siimsek/PDU/simulation/bootstrap-detail.png

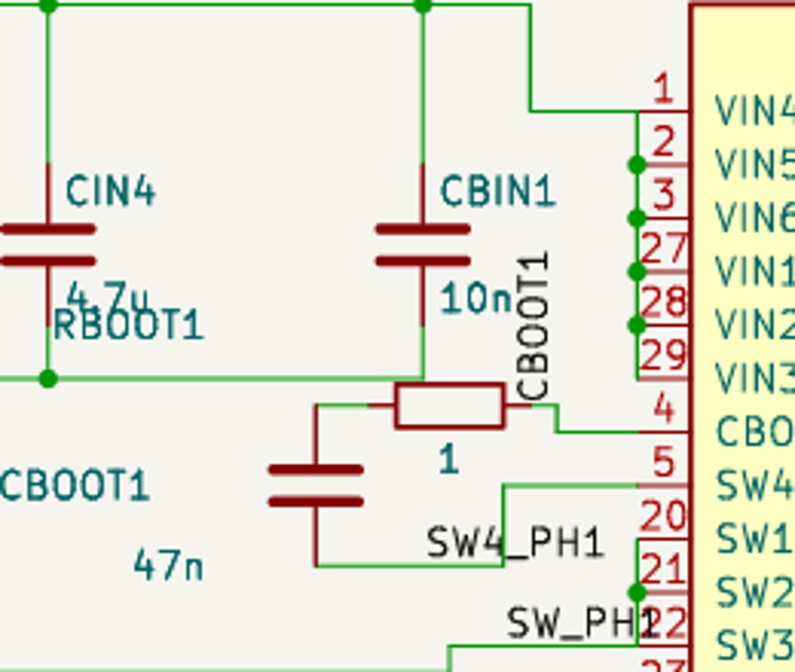
simulation/bootstrap-detail.png
