siimsek/PDU/reports/g2/KICAD-CHANGE-LIST-FINAL.md

# G2 — KiCad'e aktarılacak nihai değişiklik listesi

Bu G2 dalında `*.kicad_*` dosyası **değiştirilmedi**. Liste, mevcut şemaya (`simulation/pdu-current.net` export'u, 73 satırlık `hardware/pdu-current-bom.csv`) göre eklenen/değişen her referansı verir. Makine okunur özet: [`design/pdu_v2_spec.yaml`](../../design/pdu_v2_spec.yaml); BOM: [`design/bom-v2.csv`](../../design/bom-v2.csv). Ağ adları export'taki gibidir; `/VOUT` = ham buck barası (raporlarda VRAW). Yeni ağlar (G3 denetimiyle düzeltilmiş): `/VSAFE`, `/P5V_PROT`, `/OVP_SENSE`, `/OVP_REF`, `/REF_NR`, `/OVP_TRIP_N`, `/OVP_Q`, `/ISO_OV`, `/ISO_EN`, `/ISO_GATE`, `/ISO_VCAP`, `/CLR_N`, `/LDO_DELAY`, `/FB_INJ`, `/FB_TRIM`, `/OVP_BUS_N`, `/OC_SENSE1/2`, `/OC_TRIP1_N/2_N`, `/OC_REF`.

G1 [`KICAD-CHANGE-LIST.md`](../g1/KICAD-CHANGE-LIST.md) satırlarının yerini bu liste alır (G1 satırları geçmiş kaydı olarak orada kalır).

## G4 değişiklikleri (2026-11-07; bu bölüm aşağıdaki tablolarla çelişirse geçerlidir)

| Ref | Değişiklik | Ağlar / footprint | Gerekçe |
|---|---|---|---|
| U3, U4 | **TPS259824LNRGER** (aktif sınırlayıcı) | aynı RGE0024M | [AUDIT2](../g4/AUDIT2.md) §3, TPS25982 p.4/p.50 |
| U1, U2 | BIAS → AGND | pin 6 → /GND | LM70880 p.13 |
| U11, U12 (yeni) | INA296A2QDGKRQ1 | 8 IN+=/ISNS1|2, 1 IN−=/VOUT, 2/3/4/7=/GND, 5 OUT=/OC_SENSE1|2, 6 VS=/P5V_PROT; `Package_SO:VSSOP-8_3x3mm_P0.65mm` | N1 çözümü ([N1-DECISION](../g4/N1-DECISION.md)) |
| U13, U14 (yeni) | TLV3601DCKR | 1 OUT=/OC_TRIP1_N|2_N, 3 IN+=/OC_REF, 4 IN−=/OC_SENSE1|2, 5=/P5V_PROT; SC70-5 | OC eşiği 12.97–13.60 A |
| U15 (yeni) | SN74LVC1G11DBVR | A=/OVP_BUS_N (U7 çıkışı), B=/OC_TRIP1_N, C=/OC_TRIP2_N, Y=/OVP_TRIP_N (U9 PRE); SOT-23-6 | 3 tetik → tek mandal |
| R_OCT / R_OCB (yeni) | 255 Ω / 1.00 kΩ TNPW0603 0.1 % 15 ppm | /OVP_REF → /OC_REF → GND | OC eşik referansı |
| C_INA1/2, C_OCC1/2, C_AND (yeni) | 100 nF C1608X7R1H104K080AA | /P5V_PROT–GND | dekuplaj |
| U7 OUT | ağ adı `/OVP_TRIP_N` → `/OVP_BUS_N` | U15-A | AND girişi |
| RFB2 | 10.2k ERA3AEB1022V → **9.76k TNPW06039K76BXEA** | /FB → /FB_TRIM | B4 trim |
| R_TRIM (yeni) | 442 Ω TNPW0603442RBXEA (kart başı 280–604 Ω) | /FB_TRIM → GND | B4 trim |
| RCOMP | 33.2k CRCW060333K2FKEA | — | B4 |
| COUT17–COUT32 (yeni) | 16× C5750X7S2A226M280KB | /VOUT–GND | B4 |
| D1 | **SMCJ33A-E3/57T** (Vishay doc 88394) | D_SMC | datasheet doğrulandı (VC 53.3 V) |
| J2 | 430450200 → **460150206** Molex Mini-Fit Plus HCS, 2 devre çift sıra dikey, 4,20 mm (G5 D-003; G4'teki 430450400 SUPERSEDED) | 1=/O1_11V; 2=/GND; `Connector_Molex:Molex_Mini-Fit_Jr_5566-02A_2x01_P4.20mm_Vertical` (Molex 460150206_sd.pdf ile pad/delik karşılaştırması T-005b) | Tek kontak/kutup, 18 AWG sistem değeri 10,5 A ≥ ILIM_O1 maks 9,07 A (PS-45750-001 s.8–9); paralel kontak paylaşımı kredilenmez (R-001 bulgu 2) |
| J1, J3 | 430450200 | aynı | Molex sayfası 8.5 A |
| CEFOUT1/2 | 0805 → **1206 C3216X7R1E106K160AB** | `Capacitor_SMD:C_1206_3216Metric` | 25 V'ta %48 kullanım (≤%50) |
| MLCC'ler | TDK MPN'leri (bom-v2.csv) | footprint-map.csv | TDK sayfaları "Production" |
| SW1 | B3U-1000P | `Button_Switch_SMD:SW_SPST_B3U-1000P` | ARATAS sayfası |
| F1 | **şemadan ve PCB'den kaldırılır** (G5 T-004 / D-001): sigorta kart dışında, batarya + kablosunda — Eaton PV-10A10F (10×38 mm, 10 A, 1000 VDC, 50 kA) + CHPV1U DIN-ray yuvası (33 kA DC). G2/G4'teki `/VBAT`–`/ANODE` F1 satırı SUPERSEDED | J1 pin 1: `/VBAT` → **`/ANODE`**; `/VBAT` ağı karttan kalkar | DC kesme değeri doğrulanan tek set; sigorta bataryaya en yakın noktada kabloyu da korur |

U5 (LM74700-Q1) pin haritası düzeltmesi (G5 T-006): 1 VCAP, 2 GND, 3 EN, 4 CATHODE (/VIN), 5 GATE, 6 ANODE (TI Tablo 5-1); G2 spec'teki kayık harita SUPERSEDED, mevcut şema doğru. D1 katot ağı D-007 kararına bağlı.

G5 T-007 spec düzeltmeleri (şema zaten doğru): U2 FB → /GND (FPWM çift faz, LM70880 p.19); RBOOT CBOOT ile **seri** (CBOOT pini → RBOOT → /CBOOT_Rk → CBOOT → /SW4_PHk, p.4); SW4 ayrı ağ /SW4_PHk (p.3). R_INJ ve R_TRIM şemaya eklendi (scripts/sch_edit_b2.py).

G5 T-008: COUT9–COUT32 şemaya eklendi (scripts/sch_edit_b3.py; VOUT/GND etiketleri, sayfa üst ortası 3 × 8 ızgara).

G5 T-010/T-009: B5 (30 parça) ve B4 (12 parça) şemaya eklendi (scripts/sch_edit_b5.py, sch_edit_b4.py; etiket-pin yerleşimi). **Q2 footprint VSONP-8-1EP → `PDU:TI_CSD19531Q5A_Q5A`** (stok VSONP pad numaraları 1/2/3 = S/G/D sembolle uyumsuz; TDSON-8-1 pad 1–4 TI bandı dışında — R-009; özel footprint TI SLPS406B §7.2 p.10'dan, check_footprints PASS).

G5 T-011: B6 — U3/U4 IN ve CEFIN1/2, REN1 → /VSAFE; D_REV1/2 eklendi; RILIM 182/300 Ω; CEFOUT 1206; D2/D3 SMC; J2 46015-0206; PWR_FLAG /VSAFE (scripts/sch_edit_b6.py). Bu noktada şemadaki 142 PCB parçasının tamamı spec ile birebir (check_consistency --schematic B1–B6).

G5 T-012: B7 — D-008 test padleri (36), J_OVP_INJ_BUS, JP_EN_BUCK (in_bom no), notlar ve antet (scripts/sch_edit_b7.py). Şema 180 ref ile spec'e birebir.

G5 T-013: PCB kurulumu (iz/via/döküm yok; kanıt [`reports/g5/PCB-SETUP.md`](../g5/PCB-SETUP.md)): 120 × 85 mm, 4 katman; netlistten 180 ayak izi (parite 0); netclass adları O1_POWER → O1_PORT, S2E_POWER → S2E_PORT ve genişlikler `routing-g2.json` ile aynı; yerleşim grupları, sıcak döngü ve HV boşluğu [`PCB-HANDOFF.md`](PCB-HANDOFF.md) §3–§5'e göre.

Test noktası ekleri: TP_OC_SENSE1, TP_OC_SENSE2, TP_OC_REF, TP_OVP_BUS_N; faz şöntü akım enjeksiyonu için RS1/RS2 Kelvin padleri (BENCH T5g).

## 1. Değişen referanslar (G2)

| Ref | Eski → yeni | Ağ değişikliği | Gerekçe / hesap |
|---|---|---|---|
| U3, U4 | TPS259824ONRGET → **TPS259824LNRGER** (O = circuit breaker → L = aktif akım sınırlayıcı, 16.9 V OVLO; TPS25982 p.4; G3 denetim E1) | **IN: `/VOUT` → `/VSAFE`** | R01; U3/U4 IN 40.709 V FAIL (G1) → SİM F1 VSAFE ≤11.91 V; ILIM tablosu (p.9) L varyantının 'current limit' eşiği |
| U1, U2 (LM70880) pin 6 BIAS | aynı parça | **BIAS: `/VOUT` → AGND (`/GND`)** (G4; G3'teki `/VSAFE` SUPERSEDED) | BIAS abs 32 V (p.5) hata anında `/VOUT` 35.8 V'a çıkar; `/VSAFE` beslemesi p.13 "VIN her koşulda harici BIAS'tan büyük" koşulunu giriş çöküşünde bozar → p.13 "kullanılmıyorsa AGND" |
| CEFIN1, CEFIN2 | 100n aynı | `/VOUT` → `/VSAFE` | eFuse IN dekuplajı ayırıcı sonrası |
| REN1 | 64.9k aynı | üst uç `/VOUT` → `/VSAFE` | R19: ayırıcı açıkken eFuse'lar da kapanır |
| RILIM1 | 301 Ω → **182 Ω** (TNPW0603182RBXEA) | — | TPS25982 p.9 garantili nokta 7.23–9.07 A; [`POWER-STAGE.md` §5](POWER-STAGE.md) |
| RILIM2 | 604 Ω → **300 Ω** (TNPW0603300RBXEA) | — | garantili 4.36–5.66 A; toplam min 11.59 A ≥7.5 A |
| RUV1 | 180k → **174k** (TNPW0603174KBEEA, 0.1 %) | — | 20 V restart: 17.365–19.623 V ([`power-results.json`](power-results.json)) |
| RUV2 | 10.0k → 10.0k TNPW 0.1 % (TNPW060310K0BEEA) | — | tolerans 1 % → 0.1 % |
| RCOMP | 9.53k → **33.2k** (G4; G2'deki 16.9k SUPERSEDED) | — | 32× COUT ile PM min 63.1°, GM 11.5 dB ([`b4-results.json`](../g4/b4-results.json), `loop-results.json`) |
| CCOMP | 4.7n → **10n** | — | aynı |
| CHF | 47p → **22p** (C0G) | — | aynı |
| RFB1 | 130k ERA3AEB134V aynı | üst uç `/VOUT` → `/FB_INJ` | FRA enjeksiyonu için R_INJ düşük empedanslı `/VOUT` tarafında (G3 denetim E12) |
| D2, D3 | SS34 generic SMA → **SS34-E3/57T, SMC** | — | Vishay SS34 SMC paketlidir (doc 88751); **footprint D_SMA → D_SMC** |
| U5 | "LM74700" → **LM74700QDBVRQ1** | — | TI addendum orderable |
| RS1, RS2 | 7.5m → WSL25127L500FEA | — | 0.134 W / 1 W |
| L1, L2 | 6.8 µH → IHLP4040DZER6R8M01 | — | Vishay doc 34509 |
| COUT1–8 | aynı (C5750X7S2A226M280KB) | — | — |

## 2. Eklenen referanslar

| Ref | Değer / MPN | Ağlar (pin) | Gerekçe |
|---|---|---|---|
| COUT9–COUT32 | 24× C5750X7S2A226M280KB (G4: 16 → 32), PDU:TDK_C5750_2220_Recommended | `/VOUT`–`/GND` | Yığılmış tolerans köşeleri (yük adımı düşüşü ≈0.10 V gerekli, [`B2-B6.md`](../g4/B2-B6.md) §B4) + O1 bütçesi |
| RRAWBL | 10k CRCW1206 | `/VOUT`–`/GND` | ham bara boşaltma |
| Q2 | CSD19531Q5A (SON 5×6) | S(1–3)=`/VSAFE`, G(4)=`/ISO_GATE`, D(5–8)=`/VOUT` | ortak bara seri ayırıcı |
| U6 | LM74502HDDFR | 1 EN=`/ISO_EN`, 2 GND, 3 NC, 4 VCAP=`/ISO_VCAP`, 5 VS=`/VOUT`, 6 GATE=`/ISO_GATE`, 7 OV=`/ISO_OV`, 8 SRC=`/VSAFE` | sürücü (tOVP_OFF ≤1 µs koşullu) |
| C_ISO_VCAP, C_ISO_VS | 100n / 100n | VCAP–VS, VS–GND | LM74502H p.3–4 |
| R_GS | 100k | `/ISO_GATE`–`/VSAFE` | R13 |
| R_OVT, R_OVB | 8.25k / 2.32k TNPW1206 0.1 % 15 ppm (TNPW12068K25BXEA / TNPW12062K32BXEA) | `/VOUT`→`/OVP_SENSE`→GND | hassas eşik 11.259–11.537 V |
| U7 | TLV3601DCKR | 1 OUT=`/OVP_TRIP_N`, 2 VEE=GND, 3 IN+=`/OVP_REF`, 4 IN−=`/OVP_SENSE`, 5 VCC=`/P5V_PROT` | karşılaştırıcı |
| U8 | REF5025AQDRQ1 | 2 VIN=`/P5V_PROT`, 4 GND, 5 TRIM/NR=`/REF_NR`, 6 VOUT=`/OVP_REF`; 1/8 DNC, 3/7 NC | referans |
| U9 | SN74LVC1G74DCUR | 1 CLK=GND, 2 D=`/P5V_PROT`, 3 Q̄ NC, 4 GND, 5 Q=`/OVP_Q`, 6 CLR=`/CLR_N`, 7 PRE=`/OVP_TRIP_N`, 8 VCC=`/P5V_PROT` | mandal (set-dominant Q) |
| R_Q | 10k | `/OVP_Q`→`/ISO_OV` | mandal → OV pini |
| R_OV2T, R_OV2B | **60.4k / 19.6k** (CRCW060360K4FKEA / CRCW060319K6FKEA) | `/VOUT`→`/ISO_OV`→GND | kaba OV 11.58–13.74 V (bağımsız yol, hassas trip_max + ≥30 mV) |
| R_EN1, R_EN2 | 15k / 10k | `/P5V_PROT`→`/ISO_EN`→GND | 5 V ray geçerli değilse kapı kapalı (R08) |
| U10 | TPS7A1650QDGNRQ1 | 8 IN=`/VIN`, 5 EN=`/VIN`, 1 OUT=`/P5V_PROT`, 3 PG=`/CLR_N`, 4 GND, 7 DELAY=`/LDO_DELAY` | +5V_PROT (R21: VIN'den) |
| C_LDO_IN / C_LDO_OUT / C_LDO_DELAY (DNP) | 1u / 2.2u / 10n | — | TPS7A16 p.3 |
| C_CMP, C_LAT, C_REF_IN, C_REF_OUT, C_REF_NR (DNP) | 100n, 100n, 1u, 1u, 1u | — | dekuplaj |
| R_CLR, C_CLR | 100k / 1u | `/P5V_PROT`→`/CLR_N`→GND | POR ~120 ms |
| SW1 | reset butonu (MPN AÇIK) | `/CLR_N`–GND | R11 |
| R_BL5 | 1k CRCW1206 | `/P5V_PROT`–GND | R07 |
| R_BLS | 4.7k CRCW1206 | `/VSAFE`–GND | R16 |
| D_REV1, D_REV2 | SS34-E3/57T (SMC) | A=`/O1_11V`/`/S2E_11V`, K=`/VSAFE` | R16 OUT ≤ IN+0.3 V |
| R_INJ | 0 Ω CRCW06030000Z0EA (FRA'da 49.9 Ω) | `/VOUT`–`/FB_INJ` | tezgâh FRA (düşük Z tarafı) |

Silinen referans: **F1** (kart dışına taşındı, BOM'da kablo tarafı satırı F1/XF1). MPN'siz satır yok ([`BOM-OPEN.md`](BOM-OPEN.md)).

## 3. Test noktaları ve enjeksiyon padleri (BOM dışı, footprint)

| TP | Ağ | Kullanım |
|---|---|---|
| TP_VBAT, TP_ANODE, TP_VIN | girişler | UVLO / hot-plug |
| TP_VOUT (VRAW), TP_VSAFE, TP_O1, TP_S2E | baralar | F1/T5 enjeksiyon ölçümü |
| TP_ISO_GATE, TP_ISO_OV, TP_OVP_TRIP_N, TP_OVP_Q, TP_CLR_N, TP_OVP_SENSE, TP_OVP_REF, TP_P5V | koruma zinciri | gecikme ve eşik ölçümü |
| TP_FB_INJ_A (`/VOUT`), TP_FB_INJ_B (`/FB_INJ`) | FRA | R_INJ 49.9 Ω takılı iken |
| TP_COMP, TP_EN_BUCK, TP_SW1, TP_SW2, TP_ISNS1±, TP_ISNS2± (Kelvin) | buck | döngü/akım |
| TP_PG_O1, TP_PG_S2E, TP_IMON_O1, TP_IMON_S2E | eFuse | |
| TP_GND ×4 (prob dönüşü, her grup yanında) | GND | |
| **J_OVP_INJ_BUS** (2 pad + GND) | `/VOUT` | harici akım sınırlı OV enjeksiyon fixture'ı; buck devre dışı (EN_BUCK GND jumper) iken |
| JP_EN_BUCK (2 pin jumper, DNP) | `/EN_BUCK`–GND | enjeksiyon sırasında buck'ı kapatma |
| R_OVT DNP opsiyonu yok — artık risk testi için R_OVT sökülerek kaba yol denenir | | |

DNP/ayar seçenekleri: C_REF_NR, C_LDO_DELAY, JP_EN_BUCK; R_INJ (0 Ω ↔ 49.9 Ω); **R_TRIM** (kart başı 280–604 Ω tablosu); RCOMP 22–47k / CCOMP / CHF tezgâh aralıkları.
