siimsek/PDU/reports/g1/BENCH-ACCEPTANCE.md

> **SUPERSEDED (G3, 2026-11-07) → reports/g2/BENCH-ACCEPTANCE.md.** Bu belge geçmiş kaydıdır; içerik değiştirilmedi.

# Fiziksel test kabul kriterleri (T0–T6)

Bu kriterler ölçümle kapanır; SİM sonucu kabul yerine geçmez. O1 anlık tepe her aşamada ≤12.0 V; kararlı bara ≤11.1605 V şartları gevşetilmez.

| Test | Düzeneği ve ölçüm | Geçme kriteri | Model/hesap beklentisi (ayrı; fiziksel kanıt değildir) |
|---|---|---|---|
| T0 Görsel/soğuk | Mikroskop, DMM, 4-wire düşük-ohm ölçer; J1 girişinde akım sınırlı kaynak kapalı. | Yanlış polarite/short yok; F1, TVS, Q1, L1/L2, COUT, RS ve connector MPN/footprint/polarite kayıtları eşleşir. GND-VIN direnç kısa devre değildir; değer kart şemasıyla tutarlı kaydedilir. | SİM yok. BOM 57 boş MPN ile kart kabul edilemez. |
| T1 Açılış ve statik regülasyon | 0–30 V/≥10 A kaynak; T0 sonrası 20/22.2/26 V; önce 0.75 A sonra gerçek port split ile 7 A. 100 MHz scope, 10× kısa ground spring/diff probe. | 20 V'ta yeniden kalkış; settle sonrası bus 10.78–11.1605 V; O1 peak ≤12.0 V. 7.5 A kapasite testi ayrı, 7.5 A yük iki eFuse nominal limitlerini aşmadan dağıtılabilirse yapılır. | Mevcut behavioral baseline 20 V startup bus≈10.996 V; fiziksel davranış tahmini değildir. |
| T2 7 A sürekli/termal | 7 A toplam yük, 20/26 V giriş, en az 30 dakika veya sıcaklık dengesi; termokupl/IR kamera ve akım probları. | Bus 10.78–11.1605 V; bobin, IC, FET, eFuse, konektör sıcaklığı kendi datasheet limitinin ≥20°C altında; güç kaybı ve sıcaklık kaydı. 7.5 A ayrı kapasite testi yalnızca RILIM guaranteed-min range actual port split'i karşılayıp marj verirse; mevcut nominal ILIM sum 7.4877 A **FAIL**. | HESAP 80/90/95% verim için 20.63/9.17/4.34 W toplam kayıp hassasiyeti; kart termali bilinmiyor. |
| T3 Yük adımı | Elektronik yük iki portta; toplam 0.75→7.00→0.75 A, rise/fall ≤1 A/µs. O1 connector ve baraya eşzamanlı prob. FRA: 10 Hz–200 kHz, injection transformer/resistor. | O1 her an ≤12.0 V; bara transient 10.78–11.22 V içinde, ≤1 ms içinde settle edip 10.78–11.1605 V'a döner; ölçülen faz marjı ≥45°, gain marjı ≥6 dB. | Mevcut 0.45→4.5 A behavioral adım 10.804–10.996 V; 7 A / kompanzasyon köşesi için ölçüm beklentisi yok. |
| T4 O1 OVP fault injection | Kart O1 yükünden ayrık; ayarlı pulse kaynağı/seri güç direnci ve akım probu, dışarıdan 11.4→16.9 V pulse. Önce 1 A sınırlı, sonra 5 A ve en son 10 A fixture limiti; fiziksel kaynak/fixture sınırı doğrulanmadan yükseltme yok. | Uygulanan her pulse'da O1 konektör tepe ≤12.0 V; latch reset davranışı belirlenmiş; güç katı/port zarar görmez; 5 tekrar x3 köşe. Aşılırsa derhal durdur ve FAIL kaydet. | Aday ideal model 11.96 V @10 A/0.5µs varsayımı; gerçek comparator/gate/parazit yok. Mevcut eFuse yalnız 16.9 V nominal olduğundan başarısız beklenti. |
| T5 UVLO/batarya ramp | 0–26 V programlanabilir kaynak, 0.1 V/s ve 1 V/s ramp, 0.75 A yük; batarya simülatörü veya 6S hücre emülatörü. | 20.00 V'a yükselirken her seferde kalkış; kararlı bara aralıkta. Falling cutoff/histerezis yalnız pack üretici cutoff politikası belirlendikten sonra pass/fail olur; test öncesi batarya güvenlik cutoff'u bağımsızdır. Hıçkırık/tekrarlı aç-kapa yok. | 174k/10k hesap üst rising corner19.69 V (EN leakage/TCR hariç). |
| T6 eFuse kısa devre/hot-plug | O1 ve S2E ayrı test; kısa devre MOSFET/röle fixture, akım probu, 100 MHz scope; 10 µF+port kablosu, port hot-plug fixture. | O-variant data-sheet short test koşulunda (>3×ILIM) akım kesme ≤400 ns; normal operating current/short re-try ve latch davranışı ayrıca kaydedilir. Hot-plug bus/O1 ≤11.22 transient, O1 ≤12.0 mutlak; port akımı/tepe/termal hasar yok. | behavioral short model nominal 0.5 µs latch varsayımı ile TI≤400ns değerini kanıtlamaz. dV/dt data-sheet pin akımı 2–6.33 V/ms sensitivity; gerçek çıktı yükü ölçülmeli. |

## Ekipman ve güvenlik kapıları

- Osiloskop ≥100 MHz, ≥1 GS/s, iki eşzamanlı kanal; düşük endüktanslı ground spring veya ≥100 MHz diferansiyel prob; port tepe için prob ucu doğrudan konektörde. Akım probu ≥20 MHz. Ripple için bandwidth limit ayrıca raporlanır.
- Elektronik yük ≥10 A / ≥120 W, edge kontrolü 1 A/µs; iki bağımsız kanal ya da dağıtım fixture'ı. DC kaynağı 0–30 V, ≥10 A, programlanabilir current limit. FRA 10 Hz–200 kHz ve loop injection aksesuarı.
- T4/T6 ilk enerjilemede kaynak limiti ≤1 A, sigortalı fixture ve koruyucu gözlük; test yükü/gerçek bağlı cihaz OVP geçmeden bağlanmaz. Güçlü akım adımı ve short için uzaktan tetik/kapalı kutu kullan.
- Anında durdur: O1 >12.0 V, bara >11.22 V transient zarfı, giriş pininde 80 V'a yaklaşma, Q1 VDS 80 V, herhangi IC/inductor datasheet sıcaklık sınırı, akım >fixture/fuse rating, duman/koku, kontrolsüz osilasyon. Hasarlı/FAIL numuneyi tekrar enerjileme.
- T4 hata akımı artışı ancak batarya/kablo/fuse ve TVS/SOA koordinasyonu ayrıca kabul edilince; 10 A test fixture sınırıdır, donanımın akım garantisi değildir.
