siimsek/PDU/reports/g1/USER-DECISIONS.md

> **SUPERSEDED (G3, 2026-11-07) → reports/g3/USER-DECISIONS.md.** Bu belge geçmiş kaydıdır; içerik değiştirilmedi.

# G1 kapanışı — kullanıcıdan gereken kararlar ve girdiler

G1 yapay zekâ analizi bu dosyayla kapanır. Aşağıdaki girdiler gelmeden O1 OVP, eFuse akım sınırı ve ortak bara ayırıcı kabul edilemez. Geçerli mimari kararı [`OVP-UVLO-DECISION.md`](OVP-UVLO-DECISION.md) dosyasının "G1 kapanış kararı" bölümündedir; şematik değişiklikleri [`KICAD-CHANGE-LIST.md`](KICAD-CHANGE-LIST.md) dosyasındadır.

| # | Karar / girdi | Neden gerekli | Gelmezse ne olur |
|---|---|---|---|
| 1 | **O1 cihazının gerçek mutlak maksimum giriş gerilimi.** T3 Gemstone O1 üretici datasheet'i (PDF): abs-max, önerilen çalışma aralığı, geçici gerilim (süre/enerji) dayanımı, giriş kapasitansı ve kalkış akımı. | 12.0 V sınırı şu an kullanıcı şartıdır; datasheet sınırı bilinmiyor. Eşik penceresi (11.1605–12.0 V) ve ayırıcı hızı bu sayıya göre seçilir. Datasheet repo'da yok; okunamadı, değer **doğrulanamadı**. | 12.0 V varsayımı korunur. Eşik penceresi 0.84 V'ta kalır, eski 11.46 V hedefi 163.2 mV aşılmış durumda kalır. |
| 2 | **12.0 V şartı ölçüm payıyla birlikte kesin bir sınır mı?** Örneğin "osiloskopta okunan tepe + prob/bant genişliği belirsizliği ≤12.0 V" mi, yoksa "okunan tepe ≤12.0 V" mi? Bant genişliği ve prob tipini de belirtin. | Ölçüm belirsizliği düşülürse model tepesi 11.5606 V ile gerçek pay daralır; T-kabul testinin geçme kriteri buna bağlı. | Tezgâh kabulü tutucu yorumla yapılır: okunan tepe + belirsizlik ≤12.0 V. |
| 3 | **O1 hatasında S2E'nin de kapanması kabul edilir mi?** Önerilen ortak bara ayırıcı (a) ortak bara hatasında iki portu birlikte keser. | Kabul edilmezse yedek mimariye geçilir: her eFuse önüne ayrı ayırıcı (kontrol zinciri ×2, FET ×4). | Öneri (a) uygulanır; S2E fail-off davranışı tasarımın parçası olur. |
| 4 | **Arıza sonrası davranış:** latch-off + manuel reset mi, güç çevrimiyle reset mi, otomatik yeniden deneme mi? Reset kim/nasıl verir (buton, MCU pini, konektör)? | Latch/CLR/ARM devresi ve fail-safe güç kaybı davranışı bu karara göre çizilir; şu an AÇIK. | Latch-off + güç çevrimiyle reset varsayılır. Otomatik yeniden deneme yapılmaz. |
| 5 | **Ölçülmüş yük akımları:** O1 ve S2E sürekli/kalkış/tepe akım dalga şekilleri ve aynı anda çalışma profili. | ILIM toplamı 7.4877 A < 7.5 A (12.3 mA FAIL), ortak dal model tepesi 9.91 A, Ceff ekranı (6.48 / 8.56 µF) ve FET SOA bu akımlara bağlı. | RILIM değerleri ve VOUT_PROT Ceff seçilemez; mevcut nominal değerler AÇIK kalır. |
| 6 | **Batarya/kaynak verisi ve batarya kesim politikası:** pack iç direnci veya kısa devre akımı, kablo uzunluğu/kesiti, hücre üreticisinin düşük gerilim kesimi. | F1 (I²t, DC kesme), Q1 SOA ve RUV1=174 kΩ UVLO'nun batarya korumasıyla ilişkisi bunlara bağlı. | F1 "10 A" yer tutucu kalır; UVLO yalnız 20 V yeniden kalkış için kullanılır, batarya koruması sayılmaz. |

Sıra önceliği: 1 ve 2 OVP eşiğini, 3 ve 4 şematik topolojiyi, 5 ve 6 bileşen değerlerini kilitler.
