siimsek/PDU/reports/g4/B2-B6.md

# G4 B2–B6 — eFuse varyantı, BIAS, tolerans köşeleri, açık varsayımlar, tutarlılık

## B2 — eFuse TPS259824L (DOĞRULANDI)

| Konu | Bulgu (TI TPS25982 SLVSEI3D) | Etki |
|---|---|---|
| Varyant | p.4: L = Active Current Limiter, O = Circuit Breaker; "4" = 16.9 V OVLO (p.8: 16.32/16.9/17.31 V yükselen) | Model (aktif sınırlayıcı) L ile tutarlı; O varsayımlı ifadeler SUPERSEDED |
| ILIM | p.9 tablosu varyanttan bağımsız: 182 Ω 7.23–9.07 A, 300 Ω 4.36–5.66 A | Garantili-min toplam **11.59 A ≥7.5 A** değişmedi |
| Davranış | L: ILIM'de sınırlar, termal kapanmaya kadar sürer, sonra mandallanır (RETRY_DLY/NRETRY GND → yeniden deneme yok, p.30/p.32) | Kısa devrede kayıp ≤ (VSAFE−VOUT)·ILIM ≈ 11.9 V × 9.07 A (termal sınırla süre kısıtlı); temizleme EN veya güç döngüsü |
| Ortak ayırıcıyla etkileşim | VSAFE ≤11.37 V (SİM F1) < OVLO 16.32 V → eFuse OVLO hiç devreye girmez; S2E izolasyonu SİM F4: O1 kısa devresinde S2E ≥10.84 V | Uyumlu |
| Paket / MPN | RGE0024M aynı (p.55–57); **TPS259824LNRGER** Active/Production (p.50), 3000'lik makara | KICAD listesi güncel; footprint değişmez |

## B3 — LM70880 BIAS (DÜZELTİLDİ: AGND)

BIAS abs 32 V / önerilen ≤30 V (DATASHEET p.5); harici besleme 10–30 V izinli (p.3) ama **VIN her koşulda harici BIAS'tan büyük olmalı (p.13)**. VSAFE'ten besleme giriş çöküşünde bu koşulu bozabilir; VOUT'tan besleme ise hata anında ham bara 35.8 V'a çıktığı için abs-max'ı aşar. **Seçim: BIAS → AGND** (p.13: kullanılmıyorsa AGND); VCC iç LDO'dan VIN ile beslenir. Ek parça yok. Bedel: IC başına ek kayıp ≈ IVCC·(VIN−VCC) ≈ 10 mA × 17 V = 0.17 W (VARSAYIM; IVCC datasheet'te tablo değeri olarak okunmadı). VSAFE'in kendisi ayırıcı çıkışıdır (Q2 kaynağı); hata anında tepe ≤11.37 V (SİM), ayırıcı açıkken eFuse EN bölücüsü ve R_BLS ile boşalır, ters yol Q2 gövde diyodu (VSAFE→VOUT).

Fail-safe tablosu eki (PROTECTION-DECISION §4): "BIAS = AGND: VSAFE kaybı LM70880 beslemesini etkilemez"; "eFuse L: aktif sınırda termal kapanma → mandallı, EN/güç döngüsüyle temizlenir".

## B4 — Yığılmış statik tolerans + yük adımı (ÇÖZÜLDÜ: 32× COUT + RCOMP 33.2 kΩ + kart başı trim)

Tek tablo: [`b4-results.json`](b4-results.json) (üretici: `analysis/g2/b4.py`).

| Pencere | Statik | Adım min (SİM) | Bırakma maks (SİM) | 10.78 V | 11.22 V bant / trip_min 11.259 | 11.1605 V kararlı |
|---|---|---|---|---|---|---|
| Trimsiz (VFB ±0.75 %, R 0.1 %/25 ppm, IFB) | 10.833–11.160 V | 10.73 V | 11.26 V | **FAIL** | **FAIL** | geçer |
| **Kart başı trim** (DMM 0.05 % + ½ adım 0.125 % + VFB'nin sıcaklık payı (VARSAYIM yarısı) + R TCR) | **10.888–11.105 V** | **10.79 V** | **11.20 V** | geçer | geçer | geçer |
| Nominal (VIN 20/22.2/26, Ceff min/typ/max, gm min/max, L ±20 %) | 10.994 V | 10.89–10.93 V | 11.06–11.09 V | geçer | geçer | geçer |

- Döngü (32× COUT, RCOMP 33.2 kΩ / CCOMP 10 nF / CHF 22 pF): PM min 63.1° (−10° pay → 53.1°), GM 11.5 dB, fc 9.6–39.6 kHz; ngspice AC uyumu <0.001°.
- Trim tasarımı: RFB2 bacağı **9.76 kΩ + R_TRIM** (seri, TNPW 0.1 %); varsayılan 442 Ω → 10.994 V; tablo 280 Ω (+1.5 %) … 604 Ω (−1.5 %), 0.25 % adım, değer hatası ≤0.04 %. Paralel trim reddedildi (aşağı yönde 8–48 MΩ gerekirdi).
- Kabul: 25 °C, yüksüz, 6.5 haneli DMM ile VOUT ölç → tablodan R_TRIM seç → tekrar ölç (BENCH T1b).
- Bu varsayım değişirse: VFB toleransının tamamı sıcaklıktan gelirse trimli pencere 10.846–11.146 V olur → adım min ≈10.75 V (FAIL). Bu durumda daha fazla COUT veya daha yüksek RCOMP gerekir.

## B5 — Açık varsayımlar

| Konu | Sonuç | Durum |
|---|---|---|
| (i) eFuse sabitleri | `EF_UVLO_R_TYP`, `EF_UVLO_F_TYP`, `EF_OVLO_TYP`, `EF_RON_MAX_25C`, `EF_RON_HOT_FACTOR` `params.py`'de (DATASHEET p.4/8/9); sim_runner yalnız `v()` okur | ÇÖZÜLDÜ |
| (ii) EA gm maks | Yayımlanmamış. Tarama (tüm köşeler): PM ≥55° ve GM ≥6 dB **gm 0.5–1.8 mS** aralığında; 2.2 mS'de GM/PM düşer ([b5-results.json](b5-results.json)) | AÇIK → tezgâh FRA (typ 1.2 mS'nin +%50'sine kadar güvenli) |
| (iii) UVLO düşüş | VEN histerezisi yalnız tipik 0.1 V. 0.05–0.15 V taramasıyla düşüş **14.67–18.64 V** (2.44–3.11 V/hücre) | AÇIK → BENCH T2 ölçüm. 18 V (3.0 V/hücre) hücre kesimi bu UVLO ile garanti edilemez: batarya koruması BMS'te kalmalı (USER-DECISIONS) |
| (iv) R02 | OC tetiğiyle O1 ≤11.41 V HESAP (16 A üstü L tabanı %5'e kadar), SİM ≤11.37 V; koşul: INA296 gecikmesi tipik (4× tipikte 11.56 V) | **Sağlandı (tezgâh doğrulaması gerekli)** |
| (iv) R08 | 2.1 V POR yalnız tipik; EN kapama 2.57–3.16 V > 1.65 V mandal minimumu (garanti kısmı yeterli) | Sağlandı (POR kredi edilmeden) |
| (iv) R14 | LM74502H 4.7 nF test yükü eşdeğerliği (oran 0.97) değişmedi | Koşullu → BENCH T5b |
| (iv) R18 | Konnektör: Molex sayfaları (Active, 8.5 A/kontak); J2 4 devreli (2 kontak/kutup), J1/J3 2 devreli; 18 AWG terminal 430300038 | **Sağlandı** |

## B6 — Tutarlılık

G3'teki "Family 2 kapandı / Family 4 nominal köşede kapandı" ifadeleri G4 sonuçlarıyla yeniden yazıldı: Family 2 (üst anahtar kısası) **gerilim + faz aşırı akım tetiğiyle** kapandı (SİM F1/F5, HESAP N1); Family 4 (yük adımı) **nominal ve trimli köşelerde** kapandı, trimsiz yığılmış köşeler görünür FAIL olarak kalır. PCB-READY-v2 ve START-HERE bu ifadeleri kullanır.
