siimsek/PDU/docs/POWER-PCB-ENGINEERING-STANDARD.md

<!-- Bu başlık T-026 ile eklendi. Aşağıdaki "KAYNAK METİN" işaretinden sonrası kaynakla bayt bayt aynıdır. -->
# Güç PCB'si Mühendislik Standardı — kalıcı kopya

- **Kaynak:** [`decisions/R-020-engineering-standard-source.md`](../decisions/R-020-engineering-standard-source.md), SHA-256 `5c03f55e43b985e87191ea46efc52dc3321ad9b196f42ecd7bb8056901c9fcfe`, 32155 bayt.
- **Geçerli sürüm:** Standart 1.0 (2026-11-08). Değişiklik yalnız yeni kaynak, D-kararı ve ayrı kartla yapılır; bu kopya elle düzeltilmez.
- **Zorunluluk:** Bu andan sonraki bütün şematik ve PCB aşamaları bu standarda uyar. Kaynak metnin "İlk uygulama" ve §5 bölümleri R-020 anına ait anlık görüntüdür; açılışta repo durumuyla doğrulanır.
- **Çelişki kuralı:** Standart ile mevcut sert kriterler ayrışırsa **daha kısıtlayıcı olan** uygulanır; eşik gevşetilmez, fark D-kararına taşınır.

## T-026 çelişki taraması

| Konu | Standart | Repo | Karar |
|---|---|---|---|
| İnceleme kararının adı | `ONAY / KOŞULLU / RET` (§5, "RED kullanılıyorsa şablon esas") | `RED` (`reviews/TEMPLATE.md`, `docs/WORKFLOW.md`) | `RED` kullanılır; standardın kendi kuralı |
| Sinyal/gate sınıf adları | `ANALOG` 0,25, `GATE` ≥0,4 (§1) | Netclass adları `CONTROL_SENSE` 0,25 ve `AUX_LOCAL` 0,5; `PCB-HANDOFF` §2 `GATE` 0,4 | Çelişki yok, ad farkı; ölçü olarak daha kısıtlayıcı olan geçerli, netclass değişmez |
| Sert elektrik sınırları (E-01…E-06) | O1 ≤12,0 V; bara ≤11,1605 V; bara min ≥10,78 V; U3/U4 IN <30 V; HV 0,6 mm; gate ≤10 mm; Kelvin ≤15 mm | `CLAUDE.md`, `AGENTS.md`, `PDU.kicad_dru`, `tasks/T-023.md` ile aynı | Çelişki yok |
| Dış katman min/seçili genişlik (§1 tablo) | 2,94/3,3; 4,92/5,5; 2,35/2,6; 4,76/5,3; 2,97/3,3 | `reports/g2/routing-g2.json`, `PDU.kicad_dru` | Çelişki yok; standart yine de işe başlarken yeniden okumayı ister |
| Ara adımda açık uçlar (§4 G5) | Ara kartlarda izinli, nihai kartta 0 | `T-022` ve `T-023` devir listeleri, `T-024` kabulü | Çelişki yok |
| `via_dangling` uyarıları (§4) | UUID/net/koordinat/gerekçe ile tek tek | T-022 raporu tür ve sayı verir; UUID düzeyi yok | **Eksik:** T-023 kapanışı ve T-024'te tamamlanır, kural gevşetilmez |

---- KAYNAK METİN ----

# PDU — AI Destekli Şematik, Güç PCB'si ve Doğrulama Mühendisliği Standardı

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

## 0. ÇALIŞTIRMA SÖZLEŞMESİ — HER İKİ AJAN İÇİN ZORUNLU

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

## 1. MİMARİ VE DEĞİŞMEZ PROJE KISITLARI

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

### Sert elektriksel sınırlar

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

### Mevcut PCB tasarım kuralları — iş başında yeniden oku

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

## 2. ŞEMATİK: TÜM PARÇALARA UYGULANACAK TAM KAPSAMLI DENETİM

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

### 2.1 Eksiksizlik ve izlenebilirlik

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

### 2.2 Her parça için elektriksel kontroller

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

### 2.3 Topolojiye özgü ayrıntılı şematik kontrol listesi

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

### 2.4 Şematik onay kapısı (ayrı T-kartı)

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

## 3. PCB YERLEŞİM / YÖNLENDİRME KURALLARI — ELEKTRİKSEL RİSK ÖNCELİKLİ

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

### Mesafe kuralı: 'yakın' ne demek?

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

## 4. BÜTÜNSEL TEST / GEÇİŞ KAPILARI

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

### Bağımsız test disiplini

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

## 5. İLK ÇALIŞMA: R-020 / PR #70 (CLAUDE'DAN GELEN GÖREVİ KORU)

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

**T-023 adım 2 için ayrı ayrı karar ver:**

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

## 6. TESLİMAT VE OTOMATİK DEVİR ŞARTLARI

### Codex THINKER çıktısı

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

### Claude Code BUILDER çıktısı

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

## 7. BİRİNCİL TEKNİK KAYNAKLAR (BAĞLANTI + UYGULAMA)

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

## 8. BAŞARI ÖLÇÜTÜ VE SON RAPOR ŞABLONU

**Kesin başarı iddiası yalnız kanıtla:**

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
