siimsek/PDU/reviews/R-020.md

# R-020 — T-023 adım 2 bağımsız inceleme

- **Karar:** RED
- **Engelleyici:** 2
- **İncelenen:** PR #70, wp/T-023, cf9e820901847afe110998f4580340d1bfcf2113
- **Adım 3:** Engelleyiciler giderilip yeniden doğrulanana kadar başlamamalı.
- **Tur:** 1 / 2

## Başlangıç kanıtı

Ayrı ana klonda `git rev-parse HEAD`:
```
684357ccef4903c9726261f85f860102939c8d6f
```

`gh pr view 70 --json number,state,isDraft,baseRefName,baseRefOid,headRefName,headRefOid,url`:
```json
{"baseRefName":"main","baseRefOid":"684357ccef4903c9726261f85f860102939c8d6f","headRefName":"wp/T-023","headRefOid":"cf9e820901847afe110998f4580340d1bfcf2113","isDraft":true,"number":70,"state":"OPEN","url":"https://github.com/siimsek/PDU/pull/70"}
```
PR kartı ayrı çalışma ağacında bu başta incelendi. Ana depo ve GUI ile kayıt kullanılmadı.

## Bağımsız komutlar ve olgular

- `kicad-cli version`: `10.0.7`.
- PR kartında `kicad-cli pcb drc --format json --severity-all --refill-zones --schematic-parity`: çıkış 0; JSON'da 0 hata, 6 `via_dangling` uyarısı, 116 `unconnected_items`, 0 şematik parite ihlali. Çıkış 0, bağlantıların tamamlandığı anlamına gelmez.
- `python scripts/pcb_rules.py --check`: çıkış 0, `{"pass":true,"errors":[]}`.
- Altı uyarının koordinatları ve ağı, bağımsız DRC JSON'undan: /VOUT (119,0; 56,7), (107,0; 95,0); /O1_11V (136,645; 90,095), (138,045; 91,695), (142,0; 65,4); /VSAFE (126,0; 76,7) mm. Her birinin üretim etkisi ayrı ayrı doğrulanmadı.
- pcbnew ile kart yüklenip bölgeler doldurulduktan sonra bağlantı sorgusu: RS1.1–U11.8, RS1.2–U11.1, RS2.1–U12.8 ve RS2.2–U12.1 aynı ağda bağlı. Bu sorgu tek başına Kelvin dalının güç akımından yalıtılmış olduğunu kanıtlamaz; /VOUT bağlantı kümesinde başka güç padleri de vardır.
- `tasks/T-023.md:33` Kelvin çiftleri için paralellik ve en çok 15 mm ister; `reports/g2/PCB-HANDOFF.md:37` Q2, U6 ve R_GS'nin bitişik yerleşimini ister. Kriterler gevşetilmedi.

### HESAP — uzunluk ve geometri yöntemi

Karttaki `T023_KELVIN_0..3` bakır bölge çokgenleri ile `scripts/pcb_route_signals.py:343-350` ve `scripts/pcb_route_power.py:46-70` tarifinden yeniden kurulan şerit köşeleri karşılaştırıldı: en büyük köşe farkı 0,000001 mm. Merkez çizgisi, kart üzerindeki bu şeritlerin kontrol noktaları ve katman geçişine giden kısa koldan bağımsız toplandı. Sonuçlar sırasıyla RS1 IN+ F.Cu **4,113**, RS1 IN− B.Cu/F.Cu **13,384**, RS2 IN+ F.Cu **12,357**, RS2 IN− B.Cu/F.Cu **14,147 mm**. Nominal yol tanımında her biri 15 mm altında; en dar pay 0,853 mm. Via fıçısı ve pad içi uç noktaları dahil tekil fiziksel akım yolu, dolgu bölgesi ve /VOUT güç bakırı nedeniyle bu merkez çizgilerinden kesin olarak çıkarılamaz. Gerçek akım dağılımı ve bağımsız Kelvin dallanması **doğrulanamadı**. Bu nedenle bu sayılar tek başına nihai gerçek elektriksel yol uzunluğu kabulü değildir.

Kontrol çizgilerinin XY izdüşümleri faz 1 için (31,798; 64,966), faz 2 için (41,000; 23,700) mm'de kesişir; farklı katmanlarda olmaları elektriksel kısa devre demek değildir. Çizgilerin azami karşılıklı uzaklık ölçüsü sırasıyla 5,630 ve 5,287 mm'dir. Paralel eşleşme kanıtlanmamış, incelenen güzergâhlarda açıkça sağlanmamıştır. Kaynak: kart çokgenleri ve yukarıdaki kontrol noktaları; hesap: doğru parçalarının kesişimi ve Hausdorff uzaklığı.

Q2 gate pad merkezi (95,900; 51,4525), R_GS.1 (91,200; 36,645) mm: merkez arası 15,536 mm, pad sınırlayıcı kutuları arası 14,511 mm. Q2 source pad merkezi (92,090; 51,4525), R_GS.2 (92,850; 36,645): merkez arası 14,827 mm, kutu aralığı 13,958 mm. Bunlar pcbnew pad koordinatı ve kutularından Öklid hesabıdır; kutu aralığı pad geometrisine bağlı kesin kenar mesafesi değildir. `pcb_route_signals.py` içindeki gate bağlantı noktasından R_GS tarafına kontrol noktaları toplamı 16,015 mm'dir; bu, Q2 padinden başlayan eksiksiz rota uzunluğu değildir.

## Engelleyici bulgular

| No | Kanıt ve etki | Gerekli düzeltme |
|---|---|---|
| 1 | Kartta doğrulanan Kelvin şeritlerinin izdüşümleri kesişiyor ve paralel değil; T-023 paralellik kriteri sağlanmıyor. Doldurulmuş güç bakırı ve merkez çizgisi farkı yüzünden bağımsız Kelvin alma noktası ve gerçek rota uzunluğu da kesin kanıtlanmadı. | Her iki çift için şöntün doğru padinden ayrı alınan, mümkün olduğunca eşlenmiş paralel rota tasarla; karttan pad, segment, via ve bölge bazında uzunluk ve bağlantıyı kanıtla, her yolu ≤15 mm tut. Yerleşim değişikliği gerekiyorsa ölçüp açıkla; mevcut boşluk ve DRC kurallarını koru. |
| 2 | R_GS ile Q2 gate pad merkezleri 15,536 mm, pad kutuları arası 14,511 mm; 16,015 mm'lik dal da kartın bitişik yerleşim beklentisini karşılamıyor. | R_GS'yi Q2 gate/source yakınına taşı ve iki ucunu yeniden yönlendir; U6–Q2 gate ≤10 mm ve mevcut HV açıklığını yeniden doğrula. |

## Altı ayrı karar

1. **IN+ F.Cu / IN− B.Cu:** RED. Nominal dört çizgi uzunluğu sınır içinde olsa da paralellik ve gerçek ayrı Kelvin yolu kanıtı yeterli değil. Farklı katman kullanımı tek başına yasak sayılmadı; sorun kanıtlanan geometri ve kriterdir.
2. **R_GS:** RED. Yukarıdaki ölçüm bitişik yerleşimi desteklemiyor. BUILDER'ın `reports/g5/T-023/step2-report.md` içindeki yaklaşık 11 mm ifadesinin ölçüm uçları belirtilmediğinden bizim farklı uçlarla yaptığımız ölçümle eşdeğerliği doğrulanamadı.
3. **TP_ISO_GATE:** KOŞULLU. Karttaki merkez (97,4; 44,6) mm; gate dalındaki (96,2; 44,6) noktasına merkezler arası 1,2 mm. DRC hatası yok. F.Cu diğer ağ pad kutularına en yakın iki mesafe 1,506 ve 1,525 mm; bu tüm bakır ve prob erişimi kontrolü değildir. R_GS düzeltmesinden sonra prob, komşu bakır ve gate yüklemesi yeniden doğrulanmalı.
4. **Dört TP_ISNS:** Yeniden yerleştirilmeli; kartta mevcut merkezler TP_ISNS1P (3,8133; 14,2261), 1N (19,4333; 18,1686), 2P (17,9613; 14,2261), 2N (10,8873; 14,2261) mm. İlgili INA giriş padlerine doğrusal merkez mesafeleri sırasıyla 55,502, 45,306, 26,747 ve 29,386 mm. Bunlar rota uzunluğu değildir ve uzun test kolu tasarımı için gerekçe oluşturmaz. Başlangıç arama noktaları, sırasıyla (31,6; 65,4), (25,1; 64,0), (40,0; 20,5), (39,5; 26,2) mm: yalnız pad kutusu taraması yapıldı; iz, dolgu, avlu ve prob erişimi **doğrulanmadı**. Bunlar onaylanmış yerleşim değildir; Kelvin yeniden tasarımından sonra kısa dallar ve DRC ile test edilmeli.
5. **U12.7–U14.2 ortak GND via:** KOŞULLU. pcbnew bağlantı sorgusu iki padin bağlı olduğunu gösteriyor; `step2-gnd-applied.json` ortak via merkezini (43,77; 24,2) mm olarak veriyor. Ayrı önerilen (41,22; 24,13) via için mevcut 0,8 mm B.Cu /VOUT şeridi ile hesaplanan izdüşüm bindirmesi 0,240 mm; bu yalnız o alternatifin sığmadığını gösterir. INA referans ve karşılaştırıcı dönüşünde ortak empedans etkisi doğrulanmadı; son dönüş yolu incelenmeli.
6. **Adım 3 ve B.Cu koridoru:** HAYIR. İki engelleyici kapanana kadar geçilmemeli. 116 açık çift ara aşamada kayıtlıdır, bitmiş bağlantı kabulü değildir. Tüm B.Cu sinyal koridoru ve dönüş düzlemi sürekliliği ölçülmedi; adım 3 öncesi yerel güzergâh ve DRC ile kanıtlanmalı.

## Karşılaştırma ve açıklar

Bağımsız merkez çizgisi değerleri `reports/g5/T-023/step2-report.md` değerleriyle üç ondalıkta aynıdır; bu karşılaştırma akım yolu yalıtımını kanıtlamaz. Bağımsız DRC açık çift sayısı 116 ile PR raporuyla aynı; ağ bazında artış görülmemesi her açık çiftin kimliğinin değişmediği anlamına gelmez. Ölçülemeyen prob erişimi, gerçek akım dağılımı ve ortak GND dinamik etkisi AÇIK'tır. İkinci turda engelleyici kalırsa BLOCKED-ON-USER önerilir.

## Kalıcı standart

Kullanıcı kaynağı eksiksiz olarak `decisions/R-020-engineering-standard-source.md` altında taşınmıştır: 32155 bayt, SHA-256 `5c03f55e43b985e87191ea46efc52dc3321ad9b196f42ecd7bb8056901c9fcfe`. T-026, yetkili BUILDER tarafından kalıcı belge ve ajan bağlantılarını oluşturma görevidir; bu PR'ın açılması standardın o belgelere **entegre edildiği** anlamına gelmez. T-027–T-031 kapsam ve kapanış işlerini böler; T-024'ün mevcut analizi yeniden oluşturulmaz.
## İş akışı denetimi

Bu dalda `python scripts/check_workflow.py` çıkış 1: yalnız R-020 ve T-026–T-031 kartlarının queue.md'de bulunmamasına ilişkin 7 hata, 0 uyarı. Kullanıcı talimatı uyarınca queue.md değiştirilmedi; BUILDER bütünleştirme sırasında kuyruk eşitlemesini yapmalıdır.

`git diff --cached --check` kaynak standart kopyasındaki Markdown satır sonu boşluklarını bildirir; bunlar kaynak baytlarını değiştirmemek için korunmuştur. Diğer eklenen dosyalarda bu kontrol temizdir.

# R-020 — Tur 2 (son tur)

- **T-023 adım 2 kararı: RED; 1 engelleyici. Adım 3: HAYIR.**
- **T-026 / PR #73 kararı: KOŞULLU; birleştirmeden önce aşağıdaki denetim açığı kapatılmalı.**

## Açılış: komut çıktısı

Ayrı inceleme klonunda `git rev-parse HEAD`: `f395756ffc65580fefa55feba0691d51cac8ff2c` (R-020 ilk turu; ana dal değil). `git status -sb`: `## wp/R-020`, temiz. `gh pr view 70 --json number,state,isDraft,baseRefName,baseRefOid,headRefName,headRefOid,url`:

```json
{"baseRefName":"main","baseRefOid":"684357ccef4903c9726261f85f860102939c8d6f","headRefName":"wp/T-023","headRefOid":"50d7902acce78fb01c8664bdcbf9bf6843e51a96","isDraft":true,"number":70,"state":"OPEN","url":"https://github.com/siimsek/PDU/pull/70"}
```

`gh pr view 73 --json number,state,isDraft,baseRefName,baseRefOid,headRefName,headRefOid,url`:

```json
{"baseRefName":"main","baseRefOid":"684357ccef4903c9726261f85f860102939c8d6f","headRefName":"wp/T-026","headRefOid":"db57f4a1c472f1828a095c8b8f774641dc0fd843","isDraft":true,"number":73,"state":"OPEN","url":"https://github.com/siimsek/PDU/pull/73"}
```

`gh pr view 72 --json number,state,isDraft,headRefName,headRefOid,url`: `{"headRefName":"wp/R-020","headRefOid":"f395756ffc65580fefa55feba0691d51cac8ff2c","isDraft":true,"number":72,"state":"OPEN","url":"https://github.com/siimsek/PDU/pull/72"}`. İki girdi ayrı, sabit commit çalışma ağaçlarında incelendi; ana çalışma dizinine ve GUI'ye yazılmadı.

## Bağımsız olgular ve hesaplar

**OLGU — DRC.** `kicad-cli version` → 10.0.7. PR #70 kartında `kicad-cli pcb drc --format json --severity-all --refill-zones --schematic-parity --output <geçici-json> PDU.kicad_pcb` → çıkış 0; JSON: 0 hata, 6 `warning:via_dangling`, 112 açık çift, 0 parite. Aynı komut refill olmadan: 0 hata, 6 uyarı, 112 çift, 0 parite; sayısal fark 0. `python scripts/pcb_rules.py --check` → `{"pass":true,"errors":[]}`, çıkış 0. Sayı eşitliği açık çiftlerin kimliklerinin aynı olduğunu kanıtlamaz.

**OLGU — uyarılar.** DRC JSON F.Cu–B.Cu via: /VOUT `063c76ab-7b3b-4463-8fa1-fdf9fad55afe` (119; 56,7), `3652879d-2df1-4246-8f94-e35bf7f93fd3` (107; 95); /O1_11V `4649bd0a-712d-4a83-83e9-91a58ef8afc6` (136,645; 90,095), `8c056235-4049-4644-ab35-a513c2cefb5f` (138,045; 91,695), `f58fd724-b9db-46fc-a630-ec90256bd953` (142; 65,4); /VSAFE `728e9596-fa0e-466c-8b92-8118029a2455` (126; 76,7) mm. Bunlar DRC'nin kart koordinatlarıdır; her uyarının tüm katmanlarda bağlı bakırı ve elektriksel/üretim etkisi bağımsız doğrulanmadı. Bu altı UUID Tur 1'deki uyarılarla aynıdır; nihai T-024 disposition hâlâ gerekli.

**OLGU — bağlantılar.** KiCad pcbnew 10.0.7 ile kart yüklendi, zone fill ve `BuildConnectivity()` çalıştırıldı; RS1.1–U11.8, RS1.2–U11.1, RS2.1–U12.8, RS2.2–U12.1 bağlantı sorguları True. Dört TP_ISNS kendi şönt ağına; TP_ISO_GATE Q2.4'e; R_GS.1 Q2.4'e, R_GS.2 U6.8'e ve U6.8 Q2 source'a bağlı. Aynı ağda bağlı olmak tek başına Kelvin tapinin güç akımından bağımsızlığını veya dinamik dönüş akımını ispatlamaz.

**HESAP — dört kol.** `PDU.kicad_pcb` içindeki `T023_KELVIN_*` F.Cu/B.Cu bölge poligonları, padler, via ve neck geometrisi; `scripts/pcb_route_signals.py:350-358` waypoint'leriyle karşılaştırıldı. PCB koordinatları ile D-006 koordinatlarının dönüşümü x_D = x_PCB − 30, y_D = 115 − y_PCB mm; aşağıdaki yol hesabı D-006 kullanır. Komşu merkez noktaları arasındaki Öklid uzunlukları toplamı:

| Kol | Katman / yol | Hesaplanan çizgi (mm) |
|---|---|---:|
| RS1.1–U11.8 | F.Cu | 4,016191 |
| RS1.2–U11.1 | F.Cu + B.Cu + F.Cu neck; iki via | 14,006422 |
| RS2.1–U12.8 | F.Cu | 10,017290 |
| RS2.2–U12.1 | F.Cu | 10,522264 |

Her çizgi `tasks/T-023.md:33` 15 mm sınırının altında. Yol tanımı via fıçısı ve pad içindeki akım yolunu içermez; bunlar track yerine kısmen dolgu şeritleridir. Tam akım dağılımı, şönt padinde gerçek akımın sense alma noktasına etkisi ve özgün bir fiziksel elektriksel uzunluk **doğrulanamadı**. Bu sınır nominal çizgi ölçümünü geçersiz kılmaz ama akım çözümü diye sunulamaz.

**HESAP — paralellik.** Faz 1'de yakın eşlenmiş ana parça uzunlukları 1,985 ve 2,126 mm, toplam kol uzunlukları farkı 9,990 mm. B.Cu'daki 6,4 mm parça ve uzun F.Cu yaklaşımı boyunca IN+ eşlenik bir kol değildir. Faz 2'de U12 kart yönü 180°; (44,0; 18,4)→(38,8; 22,4) ile (48,8; 18,4)→(43,6; 22,4) ana parçaları aynı vektör (−5,2; 4,0), uzunlukları 6,560488 mm; doğrular arası dik uzaklık |4,8 × 4,0| / 6,560488 = **2,927 mm**. Ana bölümler paralel, fakat padlere yaklaşımın bütünü eşlenik değildir; ortak mod toplama ve L2 referans bütünlüğü bu geometriyle nicel doğrulanmadı.

**HESAP — gate ve TP.** Q2.4 (95,9; 51,4525) ve R_GS.1 (96,675; 49,3) D-006 mm: merkez uzaklığı 2,288 mm. Q2.4'ten F.Cu üzerinden R_GS.1'e kontrol çizgisi 2,9275 mm; U6.6–Q2.4 F.Cu parçalarının toplamı 5,469 mm. R_GS.2 (98,325; 49,3) via ile B.Cu /VSAFE barasına ve Q2 source vialarına bağlanıyor; aynı ağ bağlantısı kanıtlandı, dönüşün RF akım dağılımı veya endüktansı kanıtlanmadı. Kaynak: pcbnew pad, `PCB_TRACK`/via ve zone sorgusu; F.Cu gate parçaları (93,7325;47,49)–(94,2;47,49)–(94,8;47,49)–(95,9;48,65)–(95,9;51,4525).

D-006 test pad merkezleri karttan: TP_ISNS1P (29,4;65,6), 1N (24,7;65,1), 2P (38,8;20,0), 2N (45,6;19,6), TP_ISO_GATE (97,4;44,6) mm. Test bağlantıları PCB zone poligonları ve pcbnew bağlantı sorgusuyla görüldü. ISO_GATE reference nesnesi F.Silkscreen katmanında `IsVisible=False`; diğer dört TP refdes görünür. Gate test dalı kontrol çizgisi (94,8;47,49)–(96,2;46,5)–(96,2;44,6)–(97,4;44,6), toplam 4,815 mm; son 1,2 mm toplam dal uzunluğu değildir. Fiziksel prob yaklaşımı, gate probunun kapasitansı/yüklenmesi ve test noktalarının gerçek montaj görünürlüğü AÇIK.

## Kararlar ve engelleyici

| No | Bulgular / karar | Gerekli işlem |
|---|---|---|
| 1 | **Faz 1 RED.** `tasks/T-023.md:33` ve standart §3, §4 iki kolun paralelliğini ister; yalnız yaklaşık 2 mm yakın parça, 14,006 mm IN− yolunun kalanını eşlemez. Eşitlik tek başına kriter değildir; burada sorun eşlenmemiş uzun güzergahtır. | Önce RS1/U11 konumu sabitken alternatif çift, katman ve waypoint için gerçek açıklık, referans ve iki rota uzunluğu ile aday üretip DRC çalıştır. Kanıtlı çözüm yoksa RS1/U11 yerleşimini ve etkilenen T-022 güç yolunu birlikte yeniden tasarla, eski güç kriterlerini ve ≤15 mm sınırını koru. Ölçülmemiş alternatifin sığdığını veya yer değişikliğinin matematiksel zorunluluk olduğunu iddia etmiyorum. |

**Faz 2:** KOŞULLU. U12 dönüşü ve ana hatların 2,927 mm paralel aralığı geometrik olarak doğrulandı; bu sayıyı otomatik EMI/SI garantisi sayma. Ayrı Kelvin alma ve L2 referansının nihai rotada korunması, fiziksel prob ve SI açıkları T-023/T-024 kapsamında kapanmalı.

**R_GS:** İlk tur engelleyicisi kapandı. Q2 gate yakınlığı ve kısa F.Cu dal ölçüldü; source tarafı B.Cu /VSAFE üzerinden bağlı. B.Cu güç barası üzerinden ortak empedans ve hızlı gate discharge davranışı hesap/ölçümle doğrulanmadığından nihai elektriksel performans AÇIK; mevcut verilerle ikinci bir geometrik engelleyici ilan edilmiyor.

**TP'ler:** Yeni ISNS konumları ve ağ bağlantıları ara aşama için KOŞULLU; revize Kelvin güzergâhında kısa kollar ve açıklık tekrar kontrol edilmeli. ISO_GATE'in gizli silk etiketi için montaj/test dokümanında erişilebilir ve tekil eşleme doğrulanmalı; henüz kanıt yok. Prob erişimi ve kapasitif yük tezgâhta/uygun modelle doğrulanmalı.

**Adım 3:** HAYIR. Faz 1 engelleyicisi kapanmadan FB/COMP/OVP/OC yönlendirmesine geçme. B.Cu koridorunun tamamı ve kritik dönüşlerin sürekliliği bağımsız ölçülmedi; bir sonraki adayda DRC, 0 yeni açık, parite ve L2 referansını yeniden değerlendir. 112 açık çift ara aşama sayısıdır, final kabulü değildir. İkinci tur sonunda engelleyici kaldığından iş akışı gereği **BLOCKED-ON-USER maddesi önerilir**; kullanıcıya teknik karar sorulmaz, yukarıdaki ölçülü teknik yol önerilir.

### BUILDER karşılaştırması — bağımsız hesaptan sonra

`reports/g5/T-023/step2-report.md` ve `step2-audit.json` çizgi değerleri 4,016 / 14,006 / 10,017 / 10,522 mm; bağımsız değerlerle üç ondalıkta aynı (fark her biri %0,005'ten küçük, yuvarlama). 112/6/0 parite sayıları bağımsız DRC ile aynı. Faz 2 2,927 mm aynı; faz 1'in kısmen paralel oluşu raporda da açık. R_GS pad merkez değeri 2,288 mm aynı. Bu karşılaştırma fiziksel SI/akım çözümü veya test probu erişimi kanıtı değildir.

## PR #73 — kalıcı standardın ayrı incelemesi

**OLGU.** Kaynak `decisions/R-020-engineering-standard-source.md` yerel ekle bayt eşit: 32155 bayt, SHA-256 `5c03f55e43b985e87191ea46efc52dc3321ad9b196f42ecd7bb8056901c9fcfe`. `docs/POWER-PCB-ENGINEERING-STANDARD.md` sonu kaynak baytlarını aynen içerir; önüne 2312 bayt açıklama/çelişki taraması eklenmiş. `AGENTS.md:37`, `CLAUDE.md:23`, `docs/WORKFLOW.md:52` bağlantıları mevcut dosyaya gider; roller korunur. Standart belgenin 13–18. satırları kriter, netclass adları, ara açık uçlar ve via uyarılarını karşılaştırır; bu taramada sert kriter gevşetme saptanmadı. Bu, tüm elektronik tasarımın bağımsız onayı değildir.

**Komutlar:** PR #73'te `python -m pytest -q -p no:cacheprovider scripts/test_workflow.py` → 21 passed; `python scripts/check_workflow.py` → 0 hata, 1 uyarı (altı BUILDER yetkili yol THINKER matrisi dışında); `python scripts/pre_merge.py` → PASS, pytest 143 passed, consistency 0 hata. Sayılar bu oturumdaki komut çıktılarıdır.

**KOŞULLU / birleştirme öncesi düzeltme:** `scripts/check_workflow.py:202-203` kaynak ve standart dosyalarının *ikisi de yoksa* `[]` döndürür. Bağımsız geçici dizin deneyinde, üç yönergede standart adı yazılı olsa bile her iki dosya yokken `check_standard(root) -> []`. Böylece gerçek repoda iki dosyanın birlikte silinmesi standart denetimini sessizce atlatır. BUILDER tam repo ile minimal test fixture'ını ayırsın; gerçek repo için iki dosyanın birlikte yokluğunu FAIL yapan ve normal repo PASS sonucunu koruyan test eklesin. İlaveten denetim `scripts/check_workflow.py:211-213` yalnız ad metnini arar; bugün üç mevcut link doğru olsa da bozuk hedef/yalın metin otomatik yakalanmaz. Link hedefini de sınayan test önerilir. Düzeltme ve `check_workflow`/`pre_merge` geçmeden #73 birleştirilmesin.

**Queue yetkisi:** `tasks/done/T-026.md` açıkça queue yazımını yasaklıyor; #73 diff'i T-026–T-031 satırlarını ekliyor. Bu, kartın lafzına aykırı olmasına rağmen R-020'nin BUILDER'a verdiği eşitleme notunun uygulanmasından kaynaklanıyor; içerik doğru ve kullanıcı bu uyuşmazlığın değerlendirilmesini istediğinden tek seferlik bütünleştirme düzeltmesi olarak **kabul**. Bu karar THINKER'ın queue yasağını veya sonraki kartların açık yasaklarını genel olarak kaldırmaz.

**Birleşme planı:** #72 ve #73'teki T-027–T-031 dosyaları `git show` bayt karşılaştırmasında beşi de aynı; ortak standart kaynak da aynı. #72 önce alınacaksa BUILDER inceleme kartı ve taslakları için queue eşitlemesini yetkili bütünleştirme işleminde yapıp kontrolleri çalıştırır; sonra #73'e güncel main merge edilir (rebase/force yok). #72'de `tasks/T-026.md`, #73'te `tasks/done/T-026.md` bulunduğundan merge sonrası iki kopyayı bırakma: `tasks/done/T-026.md` Done kalır, aktif `tasks/T-026.md` kaldırılır; T-027–T-031 tek kopya Draft, R-020 ve T-026 dahil queue durumları kartlara eşitlenir. #73'ün gerekli denetim düzeltmesi ardından tüm testler yeniden koşulur. Ters birleşme sırasında da aynı çift T-026 yolu ve queue uzlaştırması zorunludur. Bu THINKER dalında queue değiştirilmedi.

**İş sırası:** T-026 entegrasyonu → T-027 tüm referans/pin envanteri → T-028 üretici/pin/footprint grupları ve T-029 çalışma koşulu grupları; T-030 giriş/koruma sistem incelemesi T-026/T-027 sonrası paralel olabilir; T-031 kapsam matrisi ancak tüm takip gruplarını hesaba katar. İlk T-028/T-029 grubu tamamlandı diye tüm referanslar tamamlandı sayılmaz. `tasks/T-030.md` ve `T-031.md`, `tasks/T-024.md` son ERC/DRC, sıcak döngü akım çözümü ve CEFOUT çalışmasını tekrar etmeyip referanslamayı açıkça ister; kapsam tekrarı saptanmadı.
