siimsek/PDU/tasks/T-027.md

# T-027 — Şematik referans ve pin kapsam envanteri

- **ID:** T-027
- **Rol:** BUILDER
- **Boyut:** M
- **Model önerisi:** Sonnet
- **Durum:** Draft
- **Dal adı:** wp/T-027
- **Bağımlılık:** T-026

## Hedef
Kalıcı mühendislik standardının uygulanabilir ve izlenebilir bir bölümünü tamamla.

## Girdiler
- `decisions/R-020-engineering-standard-source.md`, `reviews/R-020.md`, ilgili bağımlılık çıktıları ve mevcut proje yönergeleri.

## İzinli yazma yolları
- Görev açıklamasında belirtilen yollar ve bu kartın durumu.

## Kabul kriterleri
- Hiyerarşik şemadan tüm gerçek sembolleri UUID, referans, değer, MPN, footprint, tüm pin numarası/işlevi/ağı ile çıkar; BOM, kart padleri ve ilgili simülasyon modelini eşle. DNP, mekanik ve kasıtlı NC durumlarını açık sınıflandır.
- İzinli: `scripts/` içinde envanter aracı ve testleri, `reports/g5/T-027/` içinde kanıt. Tasarım dosyalarını değiştirme.
- Kabul: tekrar üretilebilir komut, toplam gerçek referans ve pin sayıları, UUID düzeyinde kapsama defteri, eksik/uyuşmayan her eşleşme için neden veya doğrulanamadı durumu; kayıtsız referans/pin sayısı 0. Çıktı sayılarının kaynak dosya ve yöntemini göster.
- Çözümsüz değerleri başarı sayma; yanlışlıkla çok birimli sembolleri çift sayma.

## Yasak
- `tasks/queue.md` dosyasına yazma. KiCad tasarım dosyalarını değiştirme; sert kriterleri gevşetme. Kullanılamayan veriyi uydurma.

## Durdurma koşulu
- Aynı hata iki denemede çözülmezse dur ve Blocked kaydet; belirsizliği kaynakla açıkla.

## Çıktı dosyaları
- Yukarıda belirtilen rapor, belge veya araçlar ve bu kartın durum güncellemesi.
