siimsek/PDU/tasks/T-028.md

# T-028 — Referans başına üretici pin ve footprint denetimi

- **ID:** T-028
- **Rol:** BUILDER
- **Boyut:** M
- **Model önerisi:** Sonnet
- **Durum:** Draft
- **Dal adı:** wp/T-028
- **Bağımlılık:** T-027

## Hedef
Kalıcı mühendislik standardının uygulanabilir ve izlenebilir bir bölümünü tamamla.

## Girdiler
- `decisions/R-020-engineering-standard-source.md`, `reviews/R-020.md`, ilgili bağımlılık çıktıları ve mevcut proje yönergeleri.

## İzinli yazma yolları
- Görev açıklamasında belirtilen yollar ve bu kartın durumu.

## Kabul kriterleri
- T-027 defterindeki bütün gerçek referansları kapsayan, tur başına en çok 20 referanslık ayrık gruplar planla; bu kart yalnız ilk grubu uygular. Kalan grupları kapsama defterinde açık bırak ve küçük takip kartları öner.
- Her referansta resmi üretici MPN, belge sürümü/sayfa/URL, bütün pin işlevleri ve footprint pad eşleşmesi, paket ve land pattern kontrolünü kaydet. Eşdeğer parçalarda kanıtı paylaş ama her referans ve pini ayrı işaretle.
- İzinli: `reports/g5/T-028/`; tasarımı değiştirme.
- Kabul: seçilen grupta gerçek referans ve pinlerin %100'ü PASS/FAIL/AÇIK durumlu, hiçbir kayıtsız pin yok; eksik belge AÇIK, başarı değil. Kalan grupların sayısı envanterden hesaplanır, varsayılmaz.

## Yasak
- `tasks/queue.md` dosyasına yazma. KiCad tasarım dosyalarını değiştirme; sert kriterleri gevşetme. Kullanılamayan veriyi uydurma.

## Durdurma koşulu
- Aynı hata iki denemede çözülmezse dur ve Blocked kaydet; belirsizliği kaynakla açıkla.

## Çıktı dosyaları
- Yukarıda belirtilen rapor, belge veya araçlar ve bu kartın durum güncellemesi.
