siimsek/PDU/reviews/R-019.md

# R-019 — T-023 adım 1 GND envanteri ve via adayları

- **Kart:** tasks/R-019.md
- **Tur:** 1
- **İncelenen commit:** 7945b15a13c2313302a56444aada3791cdebd76c
- **İnceleyen:** Codex (THINKER)
- **Karar:** KOŞULLU

## Başlangıç komutları

git status -sb → ## main...origin/main.
git rev-parse HEAD → 0d89697d25666ed024d36ae8f645761d0096a388.
gh pr view 70 --json number,url,state,isDraft,baseRefName,headRefName,headRefOid,baseRefOid →
{"baseRefName":"main","baseRefOid":"0d89697d25666ed024d36ae8f645761d0096a388","headRefName":"wp/T-023","headRefOid":"7945b15a13c2313302a56444aada3791cdebd76c","isDraft":true,"number":70,"state":"OPEN","url":"https://github.com/siimsek/PDU/pull/70"}.

## Engelleyici bulgular

| No | Bulgu | Kanıt | Kriter | Öneri |
|---|---|---|---|---|
| — | Adım 1 kapsamına ait kanıtlı engelleyici yok. | Aşağıdaki tekrar koşusu ve hesaplar. | D-012 adım 1. | Adım 2 koşullarını uygula. |

## Bağımsız komut ve hesap özeti

KiCad CLI version → 10.0.7. PR kartında pcb drc --format json --severity-all --refill-zones --schematic-parity → exit 0; JSON: **0 hata, 0 parite, 199 açık çift, 6 via_dangling uyarısı**. PDU.kicad_pcb, PDU.kicad_pro ve PDU.kicad_dru için main...PR diff boş; kaynak 7945b15.

KiCad bundled Python ile scripts/pcb_route_signals.py step1 yordamı, çıktı yolu geçici dizine yönlendirilerek tekrar çalıştırıldı → exit 0. Yordam adayları geçici board kopyasına uygular, refill ve CLI DRC yapar (scripts/pcb_route_signals.py:231-333). Yeniden koşulan aday listesi BUILDER JSON’uyla birebir aynıydı: **72 yeni via**, yer bulunamayan grup 0; /GND açık çift **77→0**, toplam açık çift **199→122**, hata 0, parite 0. L2 öncesi/sonrası **1/1** ada ve **9287,11/9287,11 mm²**. Bu, aynı aday üretim kodunun tekrar koşusudur; farklı bir yerleştirme algoritmasıyla bağımsız optimizasyon değildir.

Deneme çıktısında **6 via_dangling ve 38 lib_footprint_issues uyarısı** vardı. Geçici kopyadaki kütüphane ortamı BUILDER raporunda neden olarak belirtilmiş; her uyarının nedeni bu incelemede ayrı doğrulanmadı. Parite 0 ve GND açık çiftinin 0 olması, Kelvin/gate rotasının da tamamlandığı anlamına gelmez.

### 78 / 79 pad farkı

Bağımsız DRC JSON’un /GND uç UUID’leri step1-inventory.json GND pad UUID listesiyle eşleştirildi: **79 farklı pad UUID’si**. D-012’nin 78 sayımı, açıklamada yalnız “ayak” veya “Pad” arayan metin filtresiydi; **J1.2** “Delik İçi Kaplamalı Geçit pedi” olarak yazıldığından filtreye girmedi. Böylece fark **1 pad** olup D-012’nin eksik sayımıdır.

Açık çift uçlarında 83 farklı açıklama var: 79 pad açıklaması ve 4 farklı pad dışı açıklama. Aynı açıklama birden çok via UUID’sini temsil edebildiği için pad dışı fiziksel UUID sayısı **12**, tüm farklı uç UUID’si **91**’dir; 83 açıklamayı 83 fiziksel öğe sayma. 77 çift, 79 pad veya 72 via farklı ölçülerdir. Kaynak: bu turun DRC JSON’u ve tekrar üretilen inventory UUID eşleştirmesi.

### Paylaşılan gruplar ve kollar

Tekrar üretilen adaylar: U11.2/3/4 için bir via (27,42; 62,33), U12.2/3/4 için bir via (39,62; 24,13), U2.16/17 için bir via (36,82; 5,60), koordinatlar D-006 mm. Üç grubun düz bağlantıları gerçek KiCad denemesinde hata vermedi. U11/U12 için GND, REF2 ve reserved pinlerinin aynı GND netindeki yerel bağlantısı, şema amacına ve üretici pin işlevlerine uygundur: TI INA296 Rev D §5 s.2–3, https://www.ti.com/lit/ds/symlink/ina296a.pdf . U2 FB–AGND yerel bağlantısı sekonder FPWM yapılandırmasıyla tutarlıdır: TI LM70880 §6.3.15 s.20, https://www.ti.com/lit/ds/symlink/lm70880.pdf . Ortak net adı tek başına gürültüsüz dönüş garantisi değildir.

En büyük raporlanan **2,66 mm**, U6.2 pad merkezi–via mesafesidir; aday JSON start→via gerçek segmenti koordinatlardan **2,578 mm**. U7.2 merkez–via 2,41 mm, gerçek start→via 2,335 mm; TP_GND_OC.1 sırasıyla 2,30 ve 2,215 mm. Yordam pad merkezinden 0,08 mm iç anchor kullanır ve stub_mm’yi merkezden ölçer (scripts/pcb_route_signals.py:200-217); BUILDER’ın “kol” değerini gerçek çizilmiş iz uzunluğuyla eşitleme. Bu sayılar güç dönüş/EMI performansını tek başına kanıtlamaz.

### Analog ve dijital GND kararı

L2 tek sürekli GND olarak kalmalı; ayrı analog/dijital net veya düzlem yarığı önermiyorum. INA296 referans ve bypass dönüşlerini yerel, kısa tut; anahtarlamalı güç dönüşüyle aynı dar boyundan geçirme ve yerel yıldızlaşmayı gerektiği yerde bakır/via konumuyla sağla. U11/U12’nin aynı cihaz içindeki GND ve REF padlerinin ortak via’sı, yüksek akımlı PGND yolunu bu küçük kola bindirmemek koşuluyla kabul. GND akım yoğunluğu/SI ve fab via onayı **doğrulanamadı**.

### Kelvin ve adım 2

IPC-2581 export, KiCad 10.0.7 → exit 0; RS2.2 merkez (49,4625; 16,6000), U12.1 merkez (38,3125; 24,7800) mm D-006. Öklid mesafesi **13,82877 mm**, 15 mm’ye aritmetik fark **1,17123 mm**. D-012’nin 13,83 mm değeriyle yuvarlama farkı yaklaşık %0,0089. Pad iç kenarı ile gerçek iz merkezi farklıdır; bu bir rota PASS sonucu değildir.

İlk aday F.Cu üzerinde RS2.2 iç kenarından U12.1’e Kelvin kolu; merkezlerden varsayımsal 45°+yatay waypoint (41,2825; 24,7800) ile uzunluk **14,53827 mm**, sınıra **0,46173 mm** kalır. Bu yalnız geometri alt denemesidir: yakın U12.7 GND via adayı (41,22; 24,13) ile ilk segment merkez uzaklığı **0,5038 mm**. Varsayımsal 0,25 mm iz ve 0,6 mm land için kenar aralığı **0,0788 mm**, aday üreticinin kullandığı 0,2 mm GND açıklığından küçüktür (scripts/pcb_route_signals.py:32-34). Ayrıca /VOUT BUS_POWER genişlik/neck kuralları PDU.kicad_dru:7-9,24-26 bu ince varsayımsal çizgiyi avlu dışında otomatik olarak izinli kılmaz. Bu waypoint’i uygulanmış veya DRC temiz yol olarak kabul etme.

Öneri: önce F.Cu üzerinde iki Kelvin kolunu RS pad iç kenarlarından ayrı ve yakın paralel çıkar; U12.7 via adayını veya yolu yeniden seçerek SW bakırından ve diğer netlerden kaçın. F.Cu sığmazsa B.Cu alternatifini mevcut güç baraları ve 0,6 mm HV kuralıyla ölç. Her iki fazın IN+ ve IN− gerçek izlerini ayrı ayrı ≤15 mm olarak kanıtla. Sığma bulunamazsa RS2/U12 yerleşim düzeltmesi gerekir; sınır veya netclass gevşetilmez. Q2/U6 mevcut gate çizgisini koru, R_GS/TP uçlarını ve dönüş çevrimini ayrıca tamamla.

**Adım 2 başlayabilir.** 72 via adayının geçici GND/DRC sonucu kabul edilir; mevcut hali Kelvin sığması bakımından dondurulamaz. Özellikle U12.7 dahil yerel via koordinatları kritik çiftlerle birlikte tekrar optimize edilmeli, gerçek board üzerinde refill/DRC/parite ve L2 bağlantısı yeniden kontrol edilmelidir. Aday betiğinde apply_candidates işlevi var, ancak komut satırında yalnız --step1 geçici denemesi tanımlıdır (scripts/pcb_route_signals.py:231,271,337-340); karta kalıcı uygulama için BUILDER kontrollü uygulama adımı eklemelidir.

## Karşılaştırma

BUILDER reports/g5/T-023/step1-report.md, step1-baseline.json ve gnd-via-candidates.json ile yeniden koşum: taban 199/6/0/0; deneme 72 via, GND 77→0, toplam 122, L2 1 ada, en büyük merkez–via 2,66 mm. Sayısal fark 0; sıfır paydalı yüzde tanımsızdır. Adayların koordinat listesi tekrar koşusunda birebir eşleşti.

## Olgu, hesap, varsayım ve doğrulanamayanlar

**OLGU:** DRC sayıları ve 79 pad UUID’si komut çıktısıdır; repo board adım 1’de değişmedi.
**HESAP:** 13,82877 mm, 14,53827 mm, 0,0788 mm ve gerçek 2,578 mm kol yukarıda belirtilen merkez/start koordinatlarından hesaplandı.
**VARSAYIM:** 0,6/0,3 mm via ve üretici stackup/filled-capped via-in-pad kabulü (PCB-HANDOFF §7).
**AÇIK:** Kelvin gerçek centerline/paralellik/clearance, dönüş akımı ve SI, gerçek üretici via onayı, 38 kütüphane uyarısının tek tek nedeni. Adım 1 tek başına tamamlanmış T-023 veya üretime hazır kart değildir.
