siimsek/PDU/reviews/R-018.md

# R-018 — T-022 güç yolları

- **Kart:** tasks/R-018.md
- **Tur:** 1
- **İncelenen commit:** 62f114c3a3a08559e7ce2b55fdb9cce041a9abf9
- **İnceleyen:** Codex (THINKER)
- **Karar:** KOŞULLU (Tur 2; Tur 1: RET)

## Başlangıç komutları ve kapsam

git rev-parse HEAD → edc7d5a7f8068dc6c3696e919e2800239dcb35b1.

gh pr view 66 --json number,url,state,isDraft,baseRefName,headRefName,headRefOid,baseRefOid →

{"baseRefName":"main","baseRefOid":"edc7d5a7f8068dc6c3696e919e2800239dcb35b1","headRefName":"wp/T-022","headRefOid":"62f114c3a3a08559e7ce2b55fdb9cce041a9abf9","isDraft":true,"number":66,"state":"OPEN","url":"https://github.com/siimsek/PDU/pull/66"}

## Engelleyici bulgular

| No | Bulgu | Kanıt | Etkilenen kriter | Öneri |
|---|---|---|---|---|
| 1 | TP_SW1 ve TP_SW2 açık. | Bağımsız KiCad DRC: L1.1–TP_SW1 ve U2.22–TP_SW2 unconnected; tasks/T-022.md:13,37,42. | Faz yolları ve açık uçların kapanması. | Her TP’yi ilgili SW padine yakın, erişilebilir bir konuma taşı; kısa, DRC uyumlu bağlantıyı gerçek kartta doğrula. 40 mm SW izi çekme. |
| 2 | ISNS açıkları tümüyle Kelvin uçları değil: güç yolu da açık. | Bağımsız DRC: U1.11–L1.2 ve U2.11–ISNS2 iz segmenti unconnected. Kaynak: geçici DRC JSON unconnected_items. | tasks/T-022.md:37-38 güç kaynağından hedefe izlenebilir yol. | Her iki fazın güç bağlantısını T-022’de kapat, net bazında uçtan uca KiCad bağlantı kanıtı ver. Yalnız gerçekten yüksek empedanslı Kelvin uçları T-023’e devredilebilir. |
| 3 | CEFIN2’nin via üzerinden IN–GND döngüsünün yeterliliği kanıtlanmadı. | reports/g5/T-022/route-review.md:83; scripts/pcb_route_power.py:281-287,344-346; TI TPS25982 Rev C §11.1 s.44. | tasks/T-022.md:38 kısa eFuse hata dönüş döngüsü. | Mevcut via yolunun katman/iz/via ve GND dönüş geometrisini ölç, CEFIN1 ile karşılaştır; kısa yerel bağlantı için konumu yeniden düzenle ve DRC ile göster. Yalnız elektriksel bağlılık yeterli döngü kanıtı değildir. |

## Bağımsız hesap özeti

KiCad CLI version → 10.0.7. Ayrı PR çalışma ağacında pcb drc --format json --severity-all --refill-zones --schematic-parity çalıştırıldı; çıkış 0. JSON: 0 error, 6 warning:via_dangling, 205 unconnected_items, 0 schematic_parity. Komut, geçici JSON çıktısı ve PDU.kicad_pcb @ 62f114c kaynaklıdır. Açık öğeler arasında /VOUT 8, /ISNS1 3, /ISNS2 3, /SW_PH1 1, /SW_PH2 1, /ISO_GATE 2 vardır; sayılar DRC JSON öğeleri sayılarak elde edildi. Bu sayılar net başına bağlantısız çift sayısıdır, bağımsız pad sayısı değildir.

## Karşılaştırma (hesaptan sonra)

| Büyüklük | Bağımsız | BUILDER | Fark |
|---|---:|---:|---:|
| DRC error | 0 | 0 | 0 |
| via_dangling warning | 6 | 6 | 0% |
| unconnected_items | 205 | 205 | 0% |
| schematic parity | 0 | 0 | 0 |

BUILDER kaynakları: reports/g5/T-022/drc.json ve route-review.md:3-7,80-85. Sıfıra bölünen yüzde tanımsızdır; sıfır fark sayım farkıdır. Boş kart için BUILDER drc-empty.json 0 hata gösteriyor; bağımsız boş kart DRC **doğrulanamadı**.

## Kararlar ve sınırlar

- **TP_SW:** Yer değiştirme ve kısa yerel bağlantı seçildi. Yeni koordinat ve üretim erişimi bu turda ölçülmedi; BUILDER aday yerleşim ve DRC kanıtı üretmeli.
- **CEFIN2:** Via kullanımı tek başına yasak değil; mevcut bağlantının döngü endüktansı/alanı doğrulanmadığından koşulsuz kabul edilmez. TI TPS25982 Rev C §11.1, basılı s.44, giriş bypass kapasitörünün IN/GND yakınında olmasını ve döngü alanının küçültülmesini ister: https://www.ti.com/lit/ds/symlink/tps25982.pdf?ts=1729436346408 . Via yöntemi ve yerleşim ölçülerek karşılaştırılmalı; yeterince kısa çözüm bulunamazsa CEFIN2/U4 yerleşimi değiştirilmelidir.
- **U3.16/U4.16 neck:** Bu DRC koşusunda clearance hatası yok; mevcut kural için koşullu kabul. Gerçek minimum açıklık ve fab toleransı bağımsız ölçülmedi; 0,6 mm HV kuralı veya netclass gevşetilmez. Kaynak: PDU.kicad_dru:41-44, scripts/pcb_route_power.py:281-282.
- **Zone tap:** tasks/T-022.md:40 zone tap’i önceliklendirir; exceptions.md:3-30 ağ ve katman listesini verir. Dar zone bakırının track_width tarafından kontrol edilmemesi, tek başına kural muafiyeti kanıtı değildir. TP/bölücü ve yüksek empedanslı kontrol uçları için kabul; D_REV/CEFOUT dahil kapasitif veya geçici akım taşıyan kollar için gerçek akım yolu ve dar kesit ayrıca doğrulanmalı. Genel DRC/netclass muafiyeti önerilmez.
- **T-022 Done:** Yukarıdaki güç yolları, SW TP’ler ve CEFIN2 yerel döngüsü kapanmalı; zone tap kapsamı, DRC/parite ve net başına bağlantılar kanıtlanmalı. tasks/T-022.md:13 “bağlantısız uç bırakılırsa” tamamlanmaz der. Kelvin/FB uçlarının T-023’e devri teknik olarak uygundur, fakat kart metni açık devri ve kontrol edilen uç listesini belirtmeden mevcut tamamlama şartıyla çelişir. Güç yolu açıkları devredilemez.
- **VIN–CIN–PGND:** D-010 gerçek akım merkez çizgisi/solver ister; izler ve via geometrisi ile geometrik yaklaşık alan T-022’de ayrı raporlanabilir, gerçek akım dağılımı ve doğrulanmış alan T-024’te açık görev ve kabul kriteriyle çözülebilir. Kart değişikliği yapılmadan T-022 kriterini sessizce devretme.

## Olgu, hesap ve varsayım

**Olgu:** Yukarıdaki DRC sayıları yerel komut çıktısıdır. İki ISNS açık çifti güç yoluna ait uçları içerir.

**HESAP:** 205 ile 205 arasındaki fark 0 (%0). Sıfır olan sayılar için yüzdelik fark tanımsızdır.

**VARSAYIM:** Üretici via-in-pad dolgu/kaplamayı ve bakır stackup’ını kabul edecektir; bu varsayım DRC’den çıkmaz.

## Doğrulanamayanlar

- Bağımsız boş kart DRC; yalnız BUILDER raporu okundu.
- U3/U4 neck gerçek minimum kenar açıklığı ve üretim toleransı.
- CEFIN2’nin gerçek akım dönüşü, endüktansı ve T-021 geometrisine göre nicel farkı.
- Zone tap’lerin kapasitif uçlardaki geçici akım kapasitesi ve T-024’te solver kullanılabilirliği.
- Fiziksel kart, üretici via-in-pad onayı ve nihai termal performans.

## Tur 2 — f0de0ab

- **Karar:** KOŞULLU; Tur 1’deki üç engelleyiciye ilişkin düzeltmeler kabul edildi. T-022’nin birleşme koşulları aşağıdadır.
- **Başlangıç git rev-parse HEAD:** 122bf296391895ec939c38137574b8a8910cb66c (wp/R-018).
- **Başlangıç gh pr view 66 --json number,url,state,isDraft,baseRefName,headRefName,headRefOid,baseRefOid:**
  {"baseRefName":"main","baseRefOid":"edc7d5a7f8068dc6c3696e919e2800239dcb35b1","headRefName":"wp/T-022","headRefOid":"f0de0ab9083f20513488d9ba36d329cb1cae0aca","isDraft":true,"number":66,"state":"OPEN","url":"https://github.com/siimsek/PDU/pull/66"}.
- İnceleme girdisi f0de0ab; ana taban edc7d5a. İstenen iki kimlik komut çıktısıyla doğrulandı.

### Bağımsız komutlar ve karşılaştırma

KiCad CLI version → 10.0.7. Ayrı checkout’ta pcb drc --format json --severity-all --refill-zones --schematic-parity → exit 0; JSON’da 0 error, 6 via_dangling warning, 199 unconnected_items, 0 schematic_parity. Tur 1’de aynı yöntem 205 açık çift üretmişti; fark 199−205 = −6 çift (%−2,93). Açık uçlar tekil pad sayısı değil KiCad bağlantısız çift sayısıdır.

Bundled KiCad python.exe ile izole geçici klonda scripts/pcb_route_power.py --audit --empty-board <dosya> → exit 0. Oluşturulan boş kart, PDU.kicad_pro ve PDU.kicad_dru ile aynı dizinde kicad-cli pcb drc --format json --severity-all --refill-zones ile ayrıca incelendi → exit 0, 0 ihlal ve 0 açık çift. Kart ve boş kart komutlarının çıktıları BUILDER reports/g5/T-022/drc.json ve drc-empty.json ile sayısal olarak eşleşti. Sıfır değerler için yüzde fark tanımsızdır; 199 ve 6 sayılarında fark %0’dır.

Bağımsız kart DRC’de /SW_PH1 ve /SW_PH2 açık çifti yok. /ISNS1 ve /ISNS2 için ikişer açık çift ve /VOUT için altı açık çift kaldı; listelenen uçlar tasks/T-022.md:19’daki Kelvin/FB devriyle tutarlıdır. /ISO_GATE için iki açık çift R_GS ve TP_ISO_GATE devridir. Diğer sinyal ağlarının tamamı bu turda tek tek denetlenmedi.

### Bağımsız geometri ve Tur 1 bulguları

**HESAP — KiCad IPC-2581 export:** PDU.kicad_pcb @ f0de0ab dışa aktarımı exit 0. TP_SW1 komponent merkezi D-006 (45,4; 71,6), TP_SW2 (38,1; 12,4) mm. scripts/pcb_route_power.py:177-178 ve 381-384 aynı yerleşim ve kısa F.Cu zone kollarını gösterir. DRC’de iki TP açık değil. Kolun doğrudan probla erişimi yalnız üst yüzey yerleşiminden kesinleşmez; bobin yüksekliği ve prob ucu ile fiziksel erişim doğrulanamadı. Tur 1 bulgusu 1 kapandı.

U1.11/U2.11 ve U1.12/U2.12 için yeni ayrı bağlantılar scripts/pcb_route_power.py:429-442’de; bağımsız DRC’de Tur 1’in U1.11–L1.2 ve U2.11–ISNS2 güç yolu açık çiftleri artık yok. Kalan INA/TP çiftleri T-023 devir listesinde. Tur 1 bulgusu 2 kapandı.

U4 komponent merkezi IPC exportunda ana tabana göre (+1,15; 0) mm; CEFIN2 merkezi yeni (104,99; 41,20) mm D-006, eski (110,60; 40,67) mm. U4 IN 1–3 ortalaması, CEFIN2.1, CEFIN2.2 ve U4 GND 4–5 ortalamasından kapalı poligonun shoelace alanı **2,0755 mm²**, yuvarlanınca 2,08 mm². U3/CEFIN1 için aynı yöntem 2,0755 mm². IN–C ve C–GND merkez uzaklıkları yaklaşık 1,513 ve 1,483 mm. BUILDER reports/g5/T-022/route-review.md R-018 yanıtında sırasıyla 2,08, 1,51 ve 1,48 verir; alan farkı yuvarlamadan yaklaşık %0,22’dir. scripts/pcb_route_power.py:300-304 ve 358-368 F.Cu IN dolgusu ve GND kolunu gösterir; bu bir akım çözümlü alan veya endüktans değildir. DRC hata/parite sonucu yerleşim değişikliğinde geçerli; fiziksel tolerans ve termal performans doğrulanamadı. Tur 1 bulgusu 3 geometrik yerel dönüş bakımından kapandı.

### Neck, zone tap ve açık varsayımlar

**HESAP:** U3 neck/stub uçları (103,225; 41,120) ve (103,770; 41,775), U4 için (110,015; 41,120) ve (110,560; 41,775) mm D-006; her iki iz 0,25 mm (scripts/pcb_route_power.py:303-304,329,348). Her çift için uç merkez mesafesi √(0,545²+0,655²), iki yarım genişlik toplamı 0,25 çıkarılınca **0,60209 mm**; BUILDER 0,602 mm, yuvarlama farkı %0,014. PDU.kicad_dru:41-44 HV sınırı 0,6 mm; hesaplanan pay yaklaşık 0,00209 mm. Mevcut kural/DRC açısından kabul; üretici toleransı doğrulanamadı. Kural gevşetilmez.

D_REV/CEFOUT kolları için scripts/pcb_route_power.py:28,332-335,349-350 nominal 1,5 mm zone tap genişliğini kurar; BUILDER kesiti 1,52 mm (route-review.md). Geçerli DRC’de hata yok, zone tap yaklaşımı kartın ölçüm ucu kriteriyle uyumludur. D_REV için 3 A ve 40 mm ile 1 oz dış bakır varsayımındaki tarama bir hesap örneğidir; CEFOUT’un geçici tepe akımı doğrulanmadı. CEFOUT kollarının geçici akım/yol kapasitesini üretim öncesi izlenebilir takip maddesi olarak tut; 1,5 mm değeri dinamik akım kanıtı sayılmaz.

### Devir ve T-024 için önerilen kart metni

tasks/T-022.md:19, güç ağlarında açık kalan Kelvin, FB ve gate uçlarını isimleriyle T-023’e devreder ve güç yolu açık uçlarının devredilemeyeceğini belirtir. Bu liste, yukarıdaki bağımsız güç ağı açık çiftleri için yeterlidir. Ancak önceki D-011 kapsam ekindeki “bir bağlantısız uç bırakılırsa rota tamamlandı sayılmaz” cümlesiyle açık çelişki vardır. Birleşmeden önce BUILDER, o cümleye yalnız R-018’de tek tek listelenen T-023 uçları ve diğer T-023 sinyal ağları için açık istisna eklemeli; yeni açık güç ucu istisnası eklememelidir.

tasks/backlog.md:25 için T-024 kartına öneri:
“U1/CIN1–4 ve U2/CIN5–8 VIN–CIN–PGND sıcak döngülerinin rota ve katman geçişlerini son karttan çıkar. F.Cu gidiş ve L2 dönüş akım yoğunluğunu çözen belgelenmiş yöntemle her döngünün akım merkez çizgisini ve izdüşüm alanını mm² raporla; pad-merkez shoelace yaklaşıklarını ayrı karşılaştır. Solver/girdi yoksa doğrulanamadı ve nedenini yaz. Bu hesap ve CEFOUT geçici akım/yol kapasitesi değerlendirmesi, üretim öncesi kapıda sonuçlandırılır.”

### Olgu, hesap, varsayım ve karar sınırı

**OLGU:** Yerel kart DRC: 0 hata, 6 uyarı, 199 açık çift, parite 0; boş kart DRC: 0 ihlal. **HESAP:** 2,0755 mm² CEFIN geometrik alanı ve 0,60209 mm neck kenar açıklığı yukarıdaki koordinatlardan türetildi. **VARSAYIM:** 1 oz bakır ve dolgulu/capped via-in-pad fab tarafından onaylanır.

**KOŞULLU:** PR #66, T-022 kapsam eki içindeki açık uç çelişkisi düzeltilip T-024 devir metni ve CEFOUT geçici akım takibi kayda geçirildikten sonra birleşebilir. 199 açık bağlantı ve 6 via uyarısı korunarak raporlanmalıdır; T-023 bu devredilen sinyal uçlarını kapatır. T-022 route kararı üretim/termal onay değildir. Doğrulanamayanlar: fiziksel prob erişimi; üretici neck toleransı ve via-in-pad kabulü; CEFOUT geçici tepe akımı; akım çözümlü VIN–CIN–PGND alanı. Son turda kanıtlı kapanmamış üç Tur 1 engelleyicisi yoktur.
