siimsek/PDU/tasks/T-023.md

# T-023 — Koruma, kontrol ve analog sinyal yönlendirmesi

- **ID:** T-023
- **Rol:** BUILDER
- **Boyut:** M
- **Model önerisi:** Sonnet
- **Durum:** Ready
- **Dal adı:** wp/T-023
- **Bağımlılık:** T-022

## Hedef
OC/OVP, gate, feedback, compensation, UVLO ve enable sinyallerini güç dönüşlerinden ayırarak yönlendir.
RS-Kelvin/INA296 hassas çiftlerini ve gate loop uzunluklarını ölçüp kanıtla.

## Girdiler
- `reports/g2/PCB-HANDOFF.md` §3–§5
- `reports/g2/routing-g2.json`, `design/pdu_v2_spec.yaml`
- `decisions/D-009-routing-tool.md`, `PDU.kicad_pcb`, `PDU.kicad_dru`
- `reports/g5/T-022/power-route-audit.json`, `exceptions.md`

## İzinli yazma yolları
- `PDU.kicad_pcb`
- `scripts/pcb_route_signals.py`
- `reports/g5/T-023/`
- `HANDOFF.md`, `tasks/queue.md`, bu kartın Durum'u

## Yasak
- Şema ağı/net adını/değer/MPN veya DRC HV-clearance sınırını değiştirme.
- /ANODE, /VIN, /VOUT, /VSAFE ile mantık/analog arasında 0.6 mm açıklığı azaltma.
- KiCad GUI'den kaydetme veya izometriyi kanıtsız PASS diye yazma.

## Kabul kriterleri
- U11/U12 INA296 IN± Kelvin izleri RS1/RS2 pad iç kenarından, paralel ve SW bakırının altından geçmeden çıkar; RS-to-INA296 route centerline uzunluğu her fazda ≤15 mm.
- U6–Q2 gate izi route centerline uzunluğu ≤10 mm; gate dönüşü ve seri elemanlar PCB-HANDOFF §3 topolojisine göre raporlanır.
- U13/U14/U15 OC, OVP bölücüler/REF/latch, COMP/FB/RT/EN/UVLO sinyalleri belirtilen ağlara gider; SW ve güç switch düğümlerinden uzak, L2 GND referanslıdır.
- Diğer sinyaller için routing-g2/PCB-HANDOFF'ın netclass ve üretici minimumları korunur; via/net listesi ve kritik loop uzunlukları JSON raporda.
- KiCad 10.0.7 DRC'de yeni short, unconnected endpoint veya izinsiz clearance ihlali yok; tüm uçlar ERC/netlist pin haritasıyla tutarlı.

## Durdurma koşulu
Route kısıtları çakışıyorsa hassas/clearance sınırlarını gevşetme; alternatif layer/path ve ölçümleri kaydet.

## Çıktı dosyaları
- `PDU.kicad_pcb`
- `scripts/pcb_route_signals.py`
- `reports/g5/T-023/signal-route-audit.json`, `critical-lengths.json`, DRC kanıtı
