siimsek/PDU/tasks/T-024.md

# T-024 — Yönlendirilmiş PCB DRC/parite kapanış kapısı

- **ID:** T-024
- **Rol:** BUILDER
- **Boyut:** M
- **Model önerisi:** Sonnet
- **Durum:** Draft
- **Dal adı:** wp/T-024
- **Bağımlılık:** T-023

## Hedef
Tam yönlendirilmiş kart için üretim öncesi tasarım doğrulama kapısını çalıştır ve kanıtları raporla.
Elektriksel kuralları gevşetmeden net bağlantısı, şema paritesi, zone fill ve DRC'yi kapat.

## Girdiler
- `PDU.kicad_pcb`, `PDU.kicad_pro`, `PDU.kicad_dru`
- `reports/g2/PCB-HANDOFF.md` §1–§8, `reports/g2/routing-g2.json`
- `reports/g5/KICAD-READY.md`, `reports/g5/T-020/`–`T-023/`
- `design/pdu_v2_spec.yaml`, `design/footprint-map.csv`
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
