siimsek/PDU/hardware/PDU_blocks_placed.png

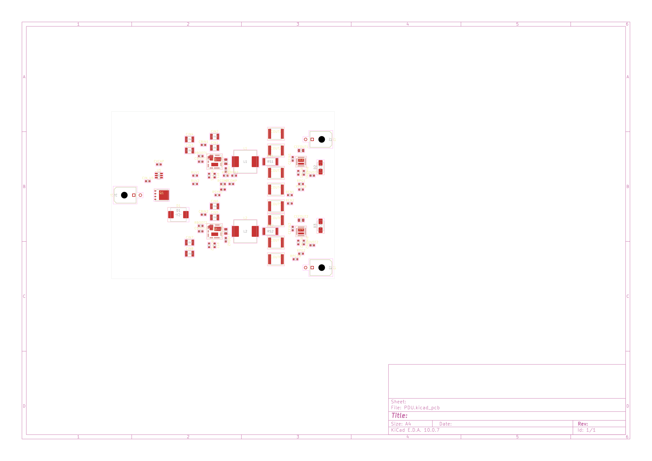
hardware/PDU_blocks_placed.png
