siimsek/PDU/hardware/PDU_initial_transfer-staging.png

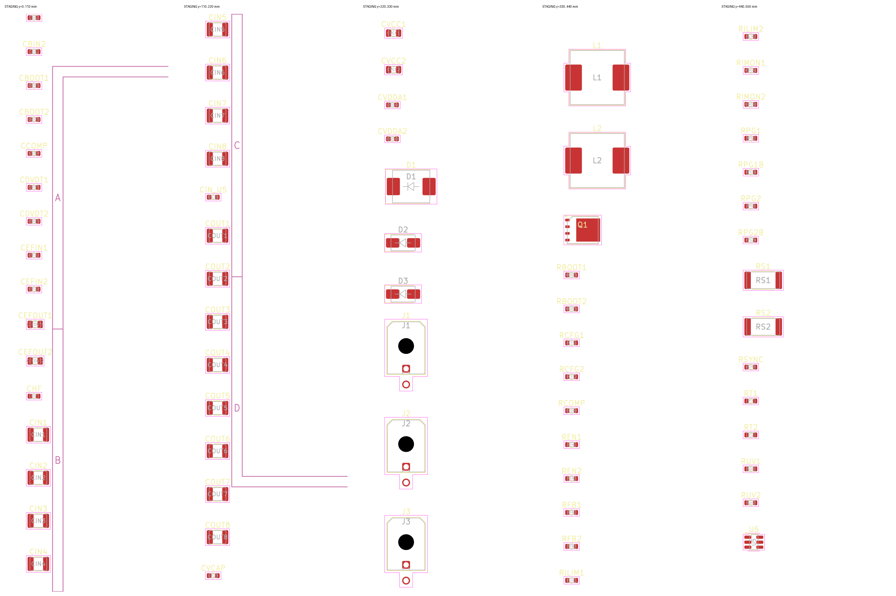
hardware/PDU_initial_transfer-staging.png
