siimsek/PDU/hardware/schematic-before-finish.png

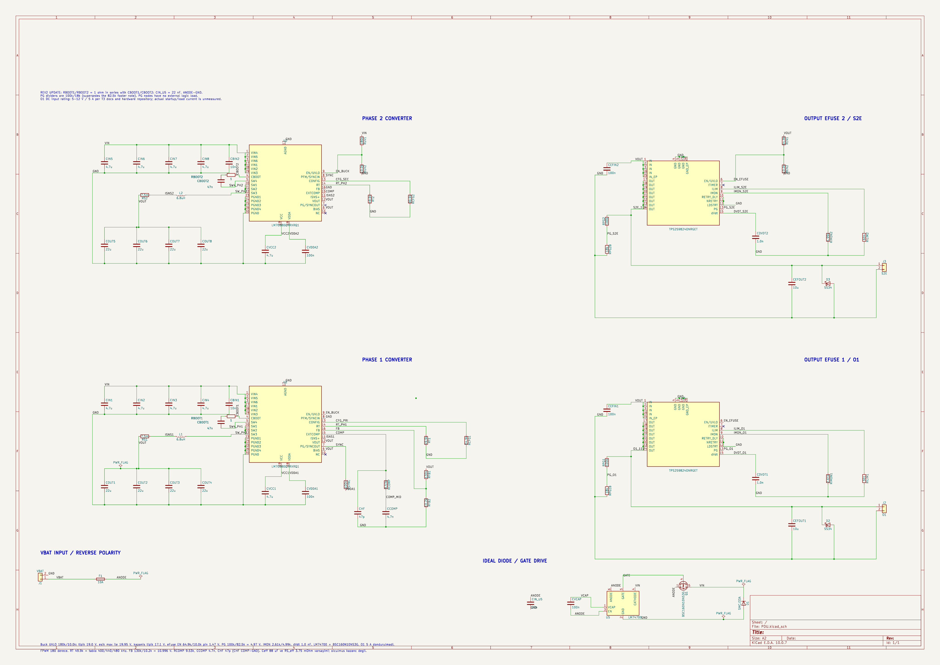
hardware/schematic-before-finish.png
