siimsek/PDU/hardware/schematic-control-crop-after.png

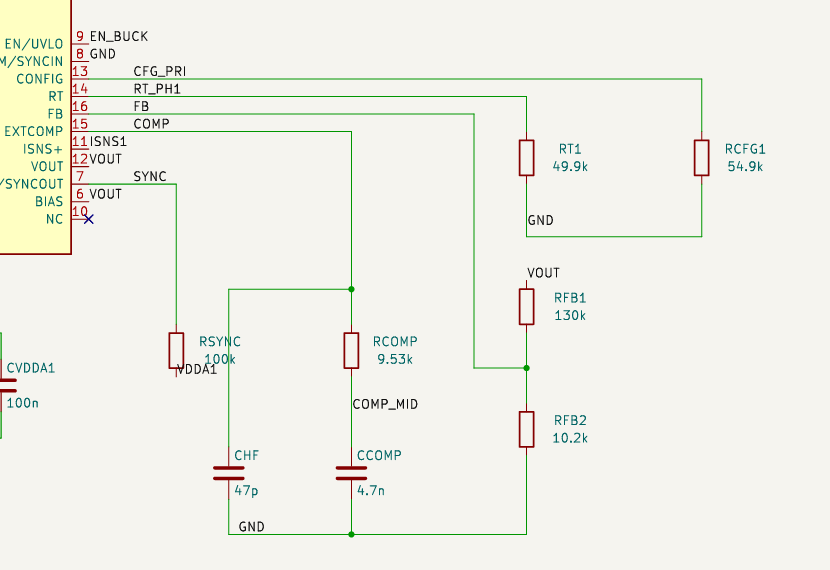
hardware/schematic-control-crop-after.png
