siimsek/PDU/hardware/schematic-control-crop-before.png

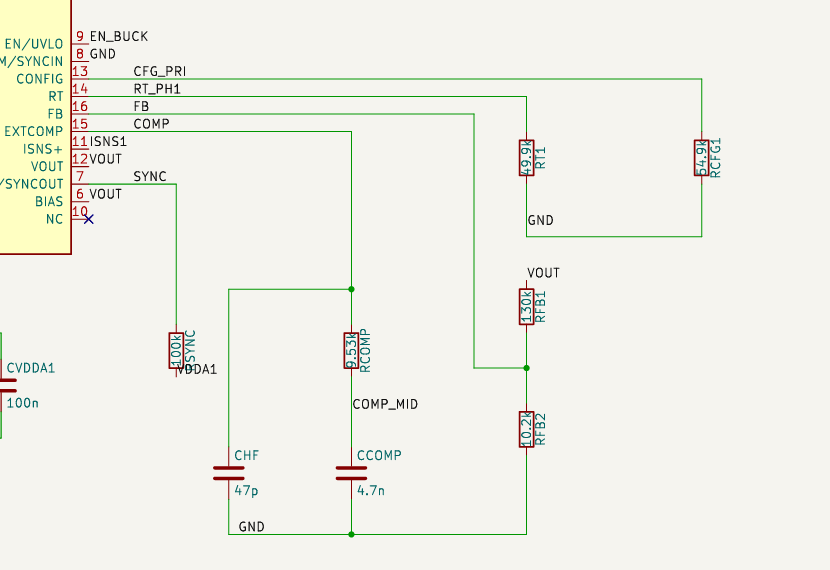
hardware/schematic-control-crop-before.png
