siimsek/PDU/hardware/schematic-input-crop-after.png

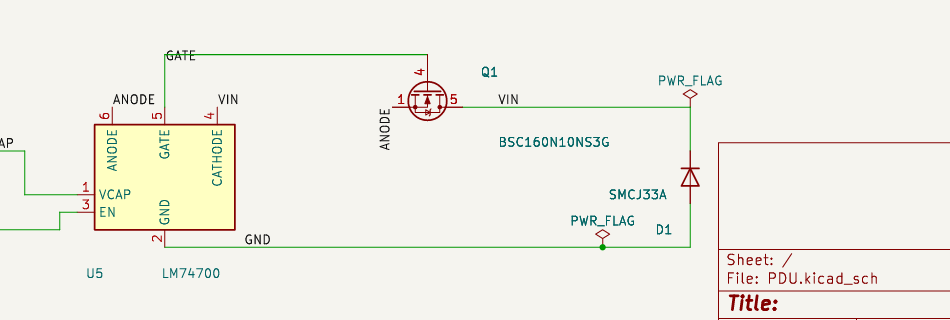
hardware/schematic-input-crop-after.png
