siimsek/PDU/hardware/schematic-input-crop-before.png

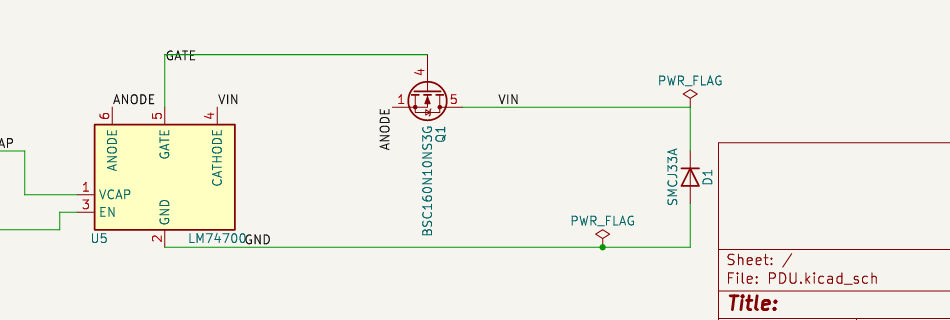
hardware/schematic-input-crop-before.png
