siimsek/PDU/PDU_schematic_finished.png

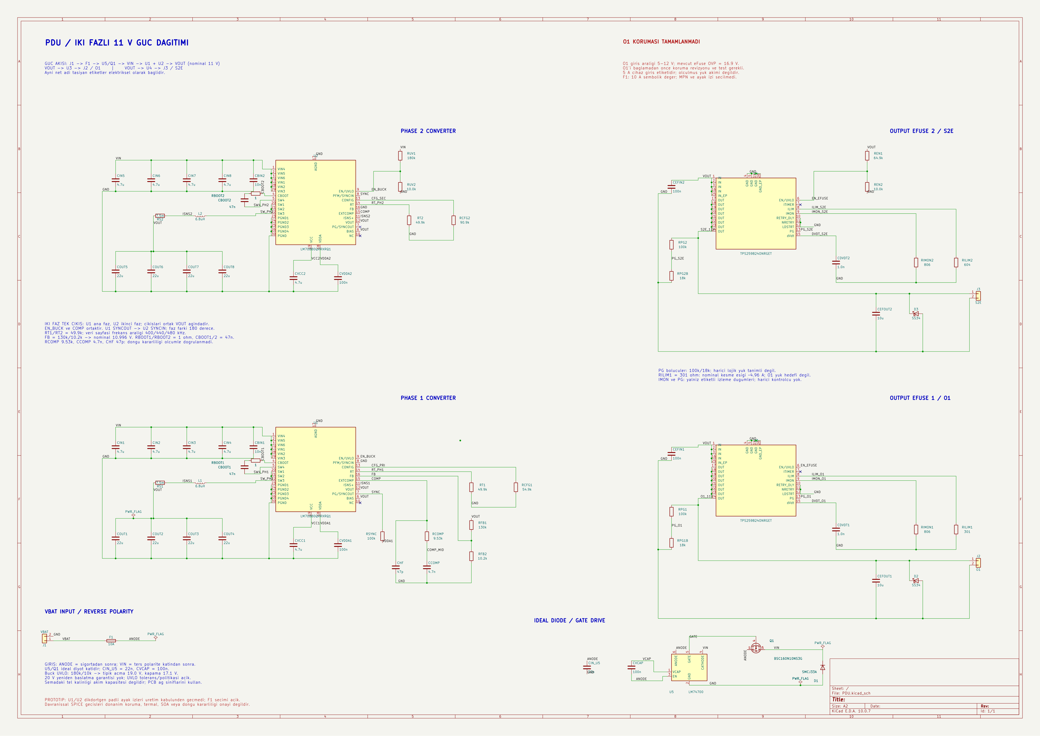
PDU_schematic_finished.png
