siimsek/PDU/reports/g5/T-020/placement.png

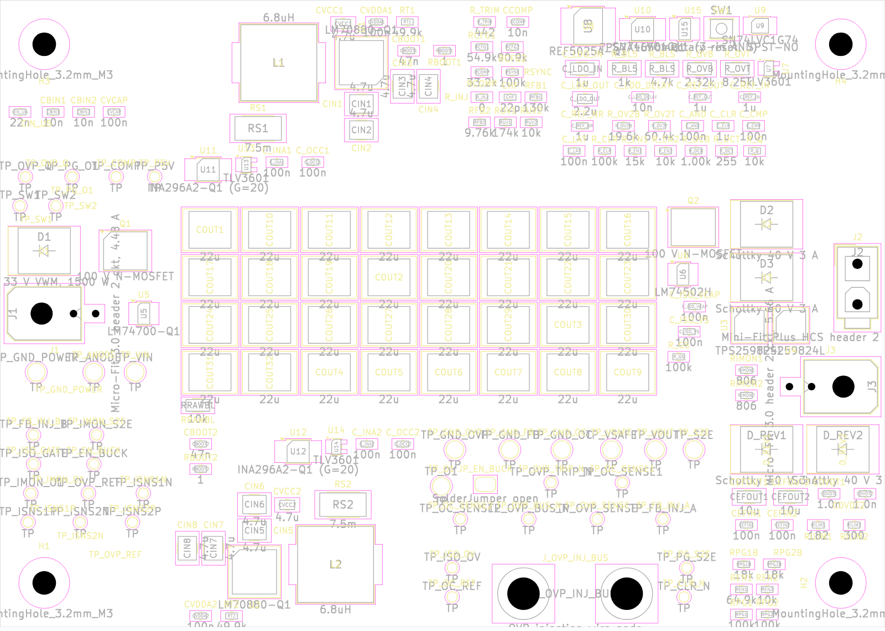
reports/g5/T-020/placement.png
