siimsek/PDU/reports/g5/T-021/L3.png

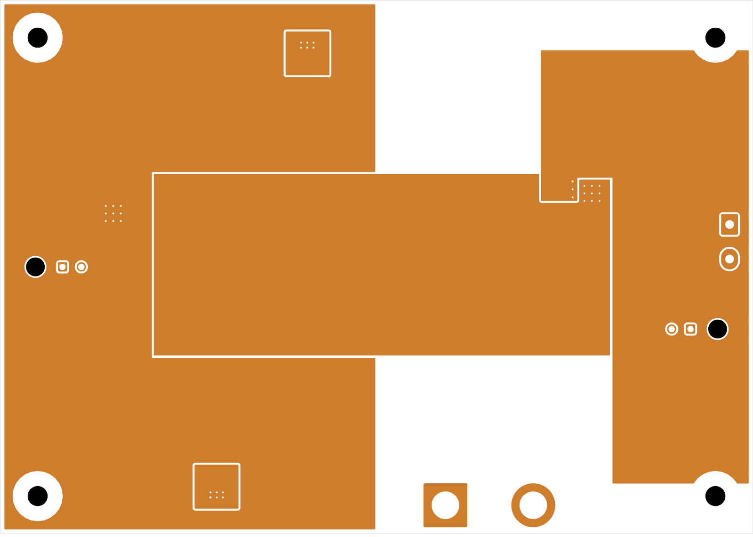
reports/g5/T-021/L3.png
