siimsek/PDU/design/bom-v2.csv

ref | kind | value | mpn | manufacturer | datasheet | tolerance | tcr | package | footprint | footprint_source | custom_footprint | v_applied | v_rating | p_applied_W | p_rating_W | derating | derating_ok | lifecycle | dnp | note
D1 | D | TVS 33 V VWM, 1500 W | SMCJ33A-E3/57T | Vishay General Semiconductor | Vishay SMCJ5.0A thru SMCJ188CA doc 88394 Rev 09-Jan-2024 p.2 (table), p.3 (ordering pattern -E3/57T) |  |  | SMC | Diode_SMD:D_SMC | KiCad standard library footprint (IPC-7351 nominal) | False | 26 | 33 |  |  | 0.7879 | 79% of abs max | doğrulanamadı | False | VBR 36.7-40.6 V, VC 53.3 V @ IPPM 28.1 A (doc 88394 p.2); VWM 33 V > VIN max 26 V; G5 D-007: cathode on /VIN (after Q1) so reverse battery does not forward-bias the TVS
U5 | U | LM74700-Q1 | LM74700QDBVRQ1 | Texas Instruments | TI LM74700-Q1 datasheet p.5; addendum LM74700QDBVRQ1 Active/Production |  |  | SOT-23-6 (DBV) | Package_TO_SOT_SMD:SOT-23-6 | KiCad standard library footprint (IPC-7351 nominal) | False | 53.3 | 65 |  |  | 0.82 | 82% of abs max | ACTIVE/Production (TI datasheet package addendum) | False | pin map per TI LM74700-Q1 Table 5-1 (DBV): 1 VCAP, 2 GND, 3 EN, 4 CATHODE, 5 GATE, 6 ANODE (G5 T-006 fix; G2 map had 4/5/6 shifted)
Q1 | Q | 100 V N-MOSFET | BSC160N10NS3G | Infineon | Infineon BSC160N10NS3 G datasheet (repo hardware/_datasheets/bsc160n10ns3g.pdf) p.1 |  |  | PG-TDSON-8 | PDU:TDSON-8-1_Konnect | repo custom land (G1: adapted, final land/paste acceptance open) | True | 53.3 | 100 |  |  | 0.533 | 53% of abs max | doğrulanamadı | False
CIN_U5 | C | 22n | C1608X7R2A223K080AA | TDK | TDK Product Center part page (official), status Production, checked 2026-11-07 (G4) |  | X7R | 0603 | Capacitor_SMD:C_0603_1608Metric | KiCad standard library footprint (IPC-7351 nominal) | False | 26 | 100 |  |  | 0.26 | yes | Production (TDK page, 2026-11-07) | False | rating >=53.3 V required
CIN1 | C | 4.7u | C3225X7S2A475K200AB | TDK | TDK Product Center part page (official), status Production, checked 2026-11-07 (G4) |  | X7S | 1210 | Capacitor_SMD:C_1210_3225Metric | KiCad standard library footprint (IPC-7351 nominal) | False | 26 | 100 |  |  | 0.26 | yes | Production (TDK page, 2026-11-07) | False | 100 V X7R/X7S 1210; DC-bias Ceff >=50 % at 26 V required (power.py assumption)
CIN2 | C | 4.7u | C3225X7S2A475K200AB | TDK | TDK Product Center part page (official), status Production, checked 2026-11-07 (G4) |  | X7S | 1210 | Capacitor_SMD:C_1210_3225Metric | KiCad standard library footprint (IPC-7351 nominal) | False | 26 | 100 |  |  | 0.26 | yes | Production (TDK page, 2026-11-07) | False | 100 V X7R/X7S 1210; DC-bias Ceff >=50 % at 26 V required (power.py assumption)
CIN3 | C | 4.7u | C3225X7S2A475K200AB | TDK | TDK Product Center part page (official), status Production, checked 2026-11-07 (G4) |  | X7S | 1210 | Capacitor_SMD:C_1210_3225Metric | KiCad standard library footprint (IPC-7351 nominal) | False | 26 | 100 |  |  | 0.26 | yes | Production (TDK page, 2026-11-07) | False | 100 V X7R/X7S 1210; DC-bias Ceff >=50 % at 26 V required (power.py assumption)
CIN4 | C | 4.7u | C3225X7S2A475K200AB | TDK | TDK Product Center part page (official), status Production, checked 2026-11-07 (G4) |  | X7S | 1210 | Capacitor_SMD:C_1210_3225Metric | KiCad standard library footprint (IPC-7351 nominal) | False | 26 | 100 |  |  | 0.26 | yes | Production (TDK page, 2026-11-07) | False | 100 V X7R/X7S 1210; DC-bias Ceff >=50 % at 26 V required (power.py assumption)
CIN5 | C | 4.7u | C3225X7S2A475K200AB | TDK | TDK Product Center part page (official), status Production, checked 2026-11-07 (G4) |  | X7S | 1210 | Capacitor_SMD:C_1210_3225Metric | KiCad standard library footprint (IPC-7351 nominal) | False | 26 | 100 |  |  | 0.26 | yes | Production (TDK page, 2026-11-07) | False | 100 V X7R/X7S 1210; DC-bias Ceff >=50 % at 26 V required (power.py assumption)
CIN6 | C | 4.7u | C3225X7S2A475K200AB | TDK | TDK Product Center part page (official), status Production, checked 2026-11-07 (G4) |  | X7S | 1210 | Capacitor_SMD:C_1210_3225Metric | KiCad standard library footprint (IPC-7351 nominal) | False | 26 | 100 |  |  | 0.26 | yes | Production (TDK page, 2026-11-07) | False | 100 V X7R/X7S 1210; DC-bias Ceff >=50 % at 26 V required (power.py assumption)
CIN7 | C | 4.7u | C3225X7S2A475K200AB | TDK | TDK Product Center part page (official), status Production, checked 2026-11-07 (G4) |  | X7S | 1210 | Capacitor_SMD:C_1210_3225Metric | KiCad standard library footprint (IPC-7351 nominal) | False | 26 | 100 |  |  | 0.26 | yes | Production (TDK page, 2026-11-07) | False | 100 V X7R/X7S 1210; DC-bias Ceff >=50 % at 26 V required (power.py assumption)
CIN8 | C | 4.7u | C3225X7S2A475K200AB | TDK | TDK Product Center part page (official), status Production, checked 2026-11-07 (G4) |  | X7S | 1210 | Capacitor_SMD:C_1210_3225Metric | KiCad standard library footprint (IPC-7351 nominal) | False | 26 | 100 |  |  | 0.26 | yes | Production (TDK page, 2026-11-07) | False | 100 V X7R/X7S 1210; DC-bias Ceff >=50 % at 26 V required (power.py assumption)
CBIN1 | C | 10n | C1608X7R2A103K080AA | TDK | TDK Product Center part page (official), status Production, checked 2026-11-07 (G4) |  | X7R | 0603 | Capacitor_SMD:C_0603_1608Metric | KiCad standard library footprint (IPC-7351 nominal) | False | 26 | 100 |  |  | 0.26 | yes | Production (TDK page, 2026-11-07) | False
CBIN2 | C | 10n | C1608X7R2A103K080AA | TDK | TDK Product Center part page (official), status Production, checked 2026-11-07 (G4) |  | X7R | 0603 | Capacitor_SMD:C_0603_1608Metric | KiCad standard library footprint (IPC-7351 nominal) | False | 26 | 100 |  |  | 0.26 | yes | Production (TDK page, 2026-11-07) | False
CVCAP | C | 100n | C1608X7R1H104K080AA | TDK | TDK Product Center part page (official), status Production, checked 2026-11-07 (G4) |  | X7R | 0603 | Capacitor_SMD:C_0603_1608Metric | KiCad standard library footprint (IPC-7351 nominal) | False | 15 | 50 |  |  | 0.3 | yes | Production (TDK page, 2026-11-07) | False
U1 | U | LM70880-Q1 | LM70880QRRXRQ1 | Texas Instruments | TI LM70880-Q1 SNVSBX7A p.1,4,6-8,16; addendum ACTIVE |  |  | VQFN-29 (RRX) | PDU:LM70880_RRX0029B_RectLands | repo custom land (G1: copper approach/paste acceptance open) | True | 53.3 | 87.5 |  |  | 0.6091 | 61% of abs max | ACTIVE/Production (TI datasheet package addendum) | False
L1 | L | 6.8uH | IHLP4040DZER6R8M01 | Vishay Dale | Vishay doc 34509 p.1 (IHLP4040DZER6R8M01) + doc 34207 | 20% |  | IHLP-4040DZ | Inductor_SMD:L_Vishay_IHLP-4040 | KiCad lib vs Vishay doc 34207 typical pad layout p.1 (compare; G1 open) | False | 26 | 75 | 0.47 |  | 0.3467 | yes | doğrulanamadı | False | Irms 4.21 A vs Iheat 8 A typ; Ilim peak 8.97 A vs Isat 13.5 A typ
RS1 | R | 7.5m | WSL25127L500FEA | Vishay | Vishay WSL doc 30100 p.1-2 (part numbering, 2512 1 W, TCR) | 1% | 75ppm/K | 2512 | Resistor_SMD:R_2512_6332Metric | KiCad standard library footprint (IPC-7351 nominal); Kelvin escape per LM70880 p.16 | False |  |  | 0.134 | 1 | 0.134 | yes | doğrulanamadı (Vishay/Panasonic web stok sorgusu yapılmadı) | False
CBOOT1 | C | 47n | C1608X7R1H473K080AA | TDK | TDK Product Center part page (official), status Production, checked 2026-11-07 (G4) |  | X7R | 0603 | Capacitor_SMD:C_0603_1608Metric | KiCad standard library footprint (IPC-7351 nominal) | False | 8.5 | 50 |  |  | 0.17 | yes | Production (TDK page, 2026-11-07) | False | LM70880 p.4 recommends 47 nF
RBOOT1 | R | 1 | CRCW06031R00FKEA | Vishay | Vishay CRCW e3 doc 20035 p.1-2 (1 % F, 100 ppm K; E24/E96) | 1% | 100ppm/K | 0603 | Resistor_SMD:R_0603_1608Metric | KiCad standard library footprint (IPC-7351 nominal) | False |  |  | 0.01 | 0.08235 | 0.1214 | yes | doğrulanamadı (Vishay/Panasonic web stok sorgusu yapılmadı) | False | 1 ohm in SERIES with CBOOT (LM70880 p.4): CBOOT pin -> RBOOT -> /CBOOT_Rk -> CBOOT cap -> SW4 (G5 T-007 fix; G2 spec had them in parallel)
RT1 | R | 49.9k | CRCW060349K9FKEA | Vishay | Vishay CRCW e3 doc 20035 p.1-2 (1 % F, 100 ppm K; E24/E96) | 1% | 100ppm/K | 0603 | Resistor_SMD:R_0603_1608Metric | KiCad standard library footprint (IPC-7351 nominal) | False |  |  | 0.0001 | 0.08235 | 0.001214 | yes | doğrulanamadı (Vishay/Panasonic web stok sorgusu yapılmadı) | False
CVCC1 | C | 4.7u | C2012X7R1E475K125AB | TDK | TDK Product Center part page (official), status Production, checked 2026-11-07 (G4) |  | X7R | 0805 | Capacitor_SMD:C_0805_2012Metric | KiCad standard library footprint (IPC-7351 nominal) | False | 8.5 | 25 |  |  | 0.34 | yes | Production (TDK page, 2026-11-07) | False
CVDDA1 | C | 100n | C1608X7R1H104K080AA | TDK | TDK Product Center part page (official), status Production, checked 2026-11-07 (G4) |  | X7R | 0603 | Capacitor_SMD:C_0603_1608Metric | KiCad standard library footprint (IPC-7351 nominal) | False | 5.25 | 50 |  |  | 0.105 | yes | Production (TDK page, 2026-11-07) | False
U2 | U | LM70880-Q1 | LM70880QRRXRQ1 | Texas Instruments | TI LM70880-Q1 SNVSBX7A p.1,4,6-8,16; addendum ACTIVE |  |  | VQFN-29 (RRX) | PDU:LM70880_RRX0029B_RectLands | repo custom land (G1: copper approach/paste acceptance open) | True | 53.3 | 87.5 |  |  | 0.6091 | 61% of abs max | ACTIVE/Production (TI datasheet package addendum) | False
L2 | L | 6.8uH | IHLP4040DZER6R8M01 | Vishay Dale | Vishay doc 34509 p.1 (IHLP4040DZER6R8M01) + doc 34207 | 20% |  | IHLP-4040DZ | Inductor_SMD:L_Vishay_IHLP-4040 | KiCad lib vs Vishay doc 34207 typical pad layout p.1 (compare; G1 open) | False | 26 | 75 | 0.47 |  | 0.3467 | yes | doğrulanamadı | False | Irms 4.21 A vs Iheat 8 A typ; Ilim peak 8.97 A vs Isat 13.5 A typ
RS2 | R | 7.5m | WSL25127L500FEA | Vishay | Vishay WSL doc 30100 p.1-2 (part numbering, 2512 1 W, TCR) | 1% | 75ppm/K | 2512 | Resistor_SMD:R_2512_6332Metric | KiCad standard library footprint (IPC-7351 nominal); Kelvin escape per LM70880 p.16 | False |  |  | 0.134 | 1 | 0.134 | yes | doğrulanamadı (Vishay/Panasonic web stok sorgusu yapılmadı) | False
CBOOT2 | C | 47n | C1608X7R1H473K080AA | TDK | TDK Product Center part page (official), status Production, checked 2026-11-07 (G4) |  | X7R | 0603 | Capacitor_SMD:C_0603_1608Metric | KiCad standard library footprint (IPC-7351 nominal) | False | 8.5 | 50 |  |  | 0.17 | yes | Production (TDK page, 2026-11-07) | False | LM70880 p.4 recommends 47 nF
RBOOT2 | R | 1 | CRCW06031R00FKEA | Vishay | Vishay CRCW e3 doc 20035 p.1-2 (1 % F, 100 ppm K; E24/E96) | 1% | 100ppm/K | 0603 | Resistor_SMD:R_0603_1608Metric | KiCad standard library footprint (IPC-7351 nominal) | False |  |  | 0.01 | 0.08235 | 0.1214 | yes | doğrulanamadı (Vishay/Panasonic web stok sorgusu yapılmadı) | False | 1 ohm in SERIES with CBOOT (LM70880 p.4): CBOOT pin -> RBOOT -> /CBOOT_Rk -> CBOOT cap -> SW4 (G5 T-007 fix; G2 spec had them in parallel)
RT2 | R | 49.9k | CRCW060349K9FKEA | Vishay | Vishay CRCW e3 doc 20035 p.1-2 (1 % F, 100 ppm K; E24/E96) | 1% | 100ppm/K | 0603 | Resistor_SMD:R_0603_1608Metric | KiCad standard library footprint (IPC-7351 nominal) | False |  |  | 0.0001 | 0.08235 | 0.001214 | yes | doğrulanamadı (Vishay/Panasonic web stok sorgusu yapılmadı) | False
CVCC2 | C | 4.7u | C2012X7R1E475K125AB | TDK | TDK Product Center part page (official), status Production, checked 2026-11-07 (G4) |  | X7R | 0805 | Capacitor_SMD:C_0805_2012Metric | KiCad standard library footprint (IPC-7351 nominal) | False | 8.5 | 25 |  |  | 0.34 | yes | Production (TDK page, 2026-11-07) | False
CVDDA2 | C | 100n | C1608X7R1H104K080AA | TDK | TDK Product Center part page (official), status Production, checked 2026-11-07 (G4) |  | X7R | 0603 | Capacitor_SMD:C_0603_1608Metric | KiCad standard library footprint (IPC-7351 nominal) | False | 5.25 | 50 |  |  | 0.105 | yes | Production (TDK page, 2026-11-07) | False
RCFG1 | R | 54.9k | CRCW060354K9FKEA | Vishay | Vishay CRCW e3 doc 20035 p.1-2 (1 % F, 100 ppm K; E24/E96) | 1% | 100ppm/K | 0603 | Resistor_SMD:R_0603_1608Metric | KiCad standard library footprint (IPC-7351 nominal) | False |  |  | 0.0001 | 0.08235 | 0.001214 | yes | doğrulanamadı (Vishay/Panasonic web stok sorgusu yapılmadı) | False
RCFG2 | R | 90.9k | CRCW060390K9FKEA | Vishay | Vishay CRCW e3 doc 20035 p.1-2 (1 % F, 100 ppm K; E24/E96) | 1% | 100ppm/K | 0603 | Resistor_SMD:R_0603_1608Metric | KiCad standard library footprint (IPC-7351 nominal) | False |  |  | 0.0001 | 0.08235 | 0.001214 | yes | doğrulanamadı (Vishay/Panasonic web stok sorgusu yapılmadı) | False
RSYNC | R | 100k | CRCW0603100KFKEA | Vishay | Vishay CRCW e3 doc 20035 p.1-2 (1 % F, 100 ppm K; E24/E96) | 1% | 100ppm/K | 0603 | Resistor_SMD:R_0603_1608Metric | KiCad standard library footprint (IPC-7351 nominal) | False |  |  | 0.0001 | 0.08235 | 0.001214 | yes | doğrulanamadı (Vishay/Panasonic web stok sorgusu yapılmadı) | False
RFB1 | R | 130k | ERA3AEB134V | Panasonic | Panasonic ERA-3AEB (repo BOM 'manufacturer verified'; not re-read in G2) | 0.1% | 25ppm/K | 0603 | Resistor_SMD:R_0603_1608Metric | KiCad standard library footprint (IPC-7351 nominal) | False |  |  | 0.001 | 0.1 | 0.01 | yes | doğrulanamadı (Vishay/Panasonic web stok sorgusu yapılmadı) | False
R_INJ | R | 0 | CRCW06030000Z0EA | Vishay | Vishay CRCW e3 doc 20035 p.1-2 (1 % F, 100 ppm K; E24/E96) | jumper |  | 0603 | Resistor_SMD:R_0603_1608Metric | KiCad standard library footprint (IPC-7351 nominal) | False |  |  | 0 | 0.08235 | 0 | yes | doğrulanamadı (Vishay/Panasonic web stok sorgusu yapılmadı) | False | jumper (0 ohm) per CRCW doc 20035 p.2 example; replace with 49.9 ohm for FRA
RFB2 | R | 9.76k | TNPW06039K76BXEA | Vishay | Vishay TNPW e3 doc 28758 p.1-4 (0.1 % B, 15 ppm X / 25 ppm E; E96) | 0.1% | 15ppm/K | 0603 | Resistor_SMD:R_0603_1608Metric | KiCad standard library footprint (IPC-7351 nominal) | False |  |  | 0.0001 | 0.08235 | 0.001214 | yes | doğrulanamadı (Vishay/Panasonic web stok sorgusu yapılmadı) | False | G4 B4: RFB2 leg = 9.76k + R_TRIM
R_TRIM | R | 442 | TNPW0603442RBXEA | Vishay | Vishay TNPW e3 doc 28758 p.1-4 (0.1 % B, 15 ppm X / 25 ppm E; E96) | 0.1% | 15ppm/K | 0603 | Resistor_SMD:R_0603_1608Metric | KiCad standard library footprint (IPC-7351 nominal) | False |  |  | 1e-05 | 0.08235 | 0.0001214 | yes | doğrulanamadı (Vishay/Panasonic web stok sorgusu yapılmadı) | False | per-board trim, default 442 ohm (10.994 V); table 280-604 ohm in reports/g4/b4-results.json
RCOMP | R | 33.2k | CRCW060333K2FKEA | Vishay | Vishay CRCW e3 doc 20035 p.1-2 (1 % F, 100 ppm K; E24/E96) | 1% | 100ppm/K | 0603 | Resistor_SMD:R_0603_1608Metric | KiCad standard library footprint (IPC-7351 nominal) | False |  |  | 1e-05 | 0.08235 | 0.0001214 | yes | doğrulanamadı (Vishay/Panasonic web stok sorgusu yapılmadı) | False | G4 B4 (32x COUT); bench range 22-47k
CCOMP | C | 10n | C1608C0G1H103J080AA | TDK | TDK Product Center part page (official), status Production, checked 2026-11-07 (G4) |  | C0G | 0603 | Capacitor_SMD:C_0603_1608Metric | KiCad standard library footprint (IPC-7351 nominal) | False | 2.1 | 50 |  |  | 0.042 | yes | Production (TDK page, 2026-11-07) | False | G2 Stage 4; C0G/X7R; bench 2.2-10 nF
CHF | C | 22p | C1608C0G1H220J080AA | TDK | TDK Product Center part page (official), status Production, checked 2026-11-07 (G4) |  | C0G | 0603 | Capacitor_SMD:C_0603_1608Metric | KiCad standard library footprint (IPC-7351 nominal) | False | 2.1 | 50 |  |  | 0.042 | yes | Production (TDK page, 2026-11-07) | False | G2 Stage 4; bench 22-100 pF
RUV1 | R | 174k | TNPW0603174KBEEA | Vishay | Vishay TNPW e3 doc 28758 p.1-4 (0.1 % B, 15 ppm X / 25 ppm E; E96) | 0.1% | 25ppm/K | 0603 | Resistor_SMD:R_0603_1608Metric | KiCad standard library footprint (IPC-7351 nominal) | False |  |  | 0.003674 | 0.08235 | 0.04461 | yes | doğrulanamadı (Vishay/Panasonic web stok sorgusu yapılmadı) | False | 20 V restart: 17.365-19.623 V (power.py)
RUV2 | R | 10k | TNPW060310K0BEEA | Vishay | Vishay TNPW e3 doc 28758 p.1-4 (0.1 % B, 15 ppm X / 25 ppm E; E96) | 0.1% | 25ppm/K | 0603 | Resistor_SMD:R_0603_1608Metric | KiCad standard library footprint (IPC-7351 nominal) | False |  |  | 0.0002 | 0.08235 | 0.002429 | yes | doğrulanamadı (Vishay/Panasonic web stok sorgusu yapılmadı) | False
COUT1 | C | 22u | C5750X7S2A226M280KB | TDK | TDK C5750X7S2A226M280KB characterization sheet (repo) + G1 Ceff model |  | X7S | 2220 | PDU:TDK_C5750_2220_Recommended | repo custom land (TDK recommended; prototype-accepted per docs/design.md) | True | 11.16 | 100 |  |  | 0.1116 | yes | doğrulanamadı (stok sorgusu yok) | False | existing
COUT2 | C | 22u | C5750X7S2A226M280KB | TDK | TDK C5750X7S2A226M280KB characterization sheet (repo) + G1 Ceff model |  | X7S | 2220 | PDU:TDK_C5750_2220_Recommended | repo custom land (TDK recommended; prototype-accepted per docs/design.md) | True | 11.16 | 100 |  |  | 0.1116 | yes | doğrulanamadı (stok sorgusu yok) | False | existing
COUT3 | C | 22u | C5750X7S2A226M280KB | TDK | TDK C5750X7S2A226M280KB characterization sheet (repo) + G1 Ceff model |  | X7S | 2220 | PDU:TDK_C5750_2220_Recommended | repo custom land (TDK recommended; prototype-accepted per docs/design.md) | True | 11.16 | 100 |  |  | 0.1116 | yes | doğrulanamadı (stok sorgusu yok) | False | existing
COUT4 | C | 22u | C5750X7S2A226M280KB | TDK | TDK C5750X7S2A226M280KB characterization sheet (repo) + G1 Ceff model |  | X7S | 2220 | PDU:TDK_C5750_2220_Recommended | repo custom land (TDK recommended; prototype-accepted per docs/design.md) | True | 11.16 | 100 |  |  | 0.1116 | yes | doğrulanamadı (stok sorgusu yok) | False | existing
COUT5 | C | 22u | C5750X7S2A226M280KB | TDK | TDK C5750X7S2A226M280KB characterization sheet (repo) + G1 Ceff model |  | X7S | 2220 | PDU:TDK_C5750_2220_Recommended | repo custom land (TDK recommended; prototype-accepted per docs/design.md) | True | 11.16 | 100 |  |  | 0.1116 | yes | doğrulanamadı (stok sorgusu yok) | False | existing
COUT6 | C | 22u | C5750X7S2A226M280KB | TDK | TDK C5750X7S2A226M280KB characterization sheet (repo) + G1 Ceff model |  | X7S | 2220 | PDU:TDK_C5750_2220_Recommended | repo custom land (TDK recommended; prototype-accepted per docs/design.md) | True | 11.16 | 100 |  |  | 0.1116 | yes | doğrulanamadı (stok sorgusu yok) | False | existing
COUT7 | C | 22u | C5750X7S2A226M280KB | TDK | TDK C5750X7S2A226M280KB characterization sheet (repo) + G1 Ceff model |  | X7S | 2220 | PDU:TDK_C5750_2220_Recommended | repo custom land (TDK recommended; prototype-accepted per docs/design.md) | True | 11.16 | 100 |  |  | 0.1116 | yes | doğrulanamadı (stok sorgusu yok) | False | existing
COUT8 | C | 22u | C5750X7S2A226M280KB | TDK | TDK C5750X7S2A226M280KB characterization sheet (repo) + G1 Ceff model |  | X7S | 2220 | PDU:TDK_C5750_2220_Recommended | repo custom land (TDK recommended; prototype-accepted per docs/design.md) | True | 11.16 | 100 |  |  | 0.1116 | yes | doğrulanamadı (stok sorgusu yok) | False | existing
COUT9 | C | 22u | C5750X7S2A226M280KB | TDK | TDK C5750X7S2A226M280KB characterization sheet (repo) + G1 Ceff model |  | X7S | 2220 | PDU:TDK_C5750_2220_Recommended | repo custom land (TDK recommended; prototype-accepted per docs/design.md) | True | 11.16 | 100 |  |  | 0.1116 | yes | doğrulanamadı (stok sorgusu yok) | False | new (G2: COUT9-16, G4: COUT17-32)
COUT10 | C | 22u | C5750X7S2A226M280KB | TDK | TDK C5750X7S2A226M280KB characterization sheet (repo) + G1 Ceff model |  | X7S | 2220 | PDU:TDK_C5750_2220_Recommended | repo custom land (TDK recommended; prototype-accepted per docs/design.md) | True | 11.16 | 100 |  |  | 0.1116 | yes | doğrulanamadı (stok sorgusu yok) | False | new (G2: COUT9-16, G4: COUT17-32)
COUT11 | C | 22u | C5750X7S2A226M280KB | TDK | TDK C5750X7S2A226M280KB characterization sheet (repo) + G1 Ceff model |  | X7S | 2220 | PDU:TDK_C5750_2220_Recommended | repo custom land (TDK recommended; prototype-accepted per docs/design.md) | True | 11.16 | 100 |  |  | 0.1116 | yes | doğrulanamadı (stok sorgusu yok) | False | new (G2: COUT9-16, G4: COUT17-32)
COUT12 | C | 22u | C5750X7S2A226M280KB | TDK | TDK C5750X7S2A226M280KB characterization sheet (repo) + G1 Ceff model |  | X7S | 2220 | PDU:TDK_C5750_2220_Recommended | repo custom land (TDK recommended; prototype-accepted per docs/design.md) | True | 11.16 | 100 |  |  | 0.1116 | yes | doğrulanamadı (stok sorgusu yok) | False | new (G2: COUT9-16, G4: COUT17-32)
COUT13 | C | 22u | C5750X7S2A226M280KB | TDK | TDK C5750X7S2A226M280KB characterization sheet (repo) + G1 Ceff model |  | X7S | 2220 | PDU:TDK_C5750_2220_Recommended | repo custom land (TDK recommended; prototype-accepted per docs/design.md) | True | 11.16 | 100 |  |  | 0.1116 | yes | doğrulanamadı (stok sorgusu yok) | False | new (G2: COUT9-16, G4: COUT17-32)
COUT14 | C | 22u | C5750X7S2A226M280KB | TDK | TDK C5750X7S2A226M280KB characterization sheet (repo) + G1 Ceff model |  | X7S | 2220 | PDU:TDK_C5750_2220_Recommended | repo custom land (TDK recommended; prototype-accepted per docs/design.md) | True | 11.16 | 100 |  |  | 0.1116 | yes | doğrulanamadı (stok sorgusu yok) | False | new (G2: COUT9-16, G4: COUT17-32)
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
COUT27 | C | 22u | C5750X7S2A226M280KB | TDK | TDK C5750X7S2A226M280KB characterization sheet (repo) + G1 Ceff model |  | X7S | 2220 | PDU:TDK_C5750_2220_Recommended | repo custom land (TDK recommended; prototype-accepted per docs/design.md) | True | 11.16 | 100 |  |  | 0.1116 | yes | doğrulanamadı (stok sorgusu yok) | False | new (G2: COUT9-16, G4: COUT17-32)
COUT28 | C | 22u | C5750X7S2A226M280KB | TDK | TDK C5750X7S2A226M280KB characterization sheet (repo) + G1 Ceff model |  | X7S | 2220 | PDU:TDK_C5750_2220_Recommended | repo custom land (TDK recommended; prototype-accepted per docs/design.md) | True | 11.16 | 100 |  |  | 0.1116 | yes | doğrulanamadı (stok sorgusu yok) | False | new (G2: COUT9-16, G4: COUT17-32)
COUT29 | C | 22u | C5750X7S2A226M280KB | TDK | TDK C5750X7S2A226M280KB characterization sheet (repo) + G1 Ceff model |  | X7S | 2220 | PDU:TDK_C5750_2220_Recommended | repo custom land (TDK recommended; prototype-accepted per docs/design.md) | True | 11.16 | 100 |  |  | 0.1116 | yes | doğrulanamadı (stok sorgusu yok) | False | new (G2: COUT9-16, G4: COUT17-32)
COUT30 | C | 22u | C5750X7S2A226M280KB | TDK | TDK C5750X7S2A226M280KB characterization sheet (repo) + G1 Ceff model |  | X7S | 2220 | PDU:TDK_C5750_2220_Recommended | repo custom land (TDK recommended; prototype-accepted per docs/design.md) | True | 11.16 | 100 |  |  | 0.1116 | yes | doğrulanamadı (stok sorgusu yok) | False | new (G2: COUT9-16, G4: COUT17-32)
COUT31 | C | 22u | C5750X7S2A226M280KB | TDK | TDK C5750X7S2A226M280KB characterization sheet (repo) + G1 Ceff model |  | X7S | 2220 | PDU:TDK_C5750_2220_Recommended | repo custom land (TDK recommended; prototype-accepted per docs/design.md) | True | 11.16 | 100 |  |  | 0.1116 | yes | doğrulanamadı (stok sorgusu yok) | False | new (G2: COUT9-16, G4: COUT17-32)
COUT32 | C | 22u | C5750X7S2A226M280KB | TDK | TDK C5750X7S2A226M280KB characterization sheet (repo) + G1 Ceff model |  | X7S | 2220 | PDU:TDK_C5750_2220_Recommended | repo custom land (TDK recommended; prototype-accepted per docs/design.md) | True | 11.16 | 100 |  |  | 0.1116 | yes | doğrulanamadı (stok sorgusu yok) | False | new (G2: COUT9-16, G4: COUT17-32)
RRAWBL | R | 10k | CRCW120610K0FKEA | Vishay | Vishay CRCW e3 doc 20035 p.1-2 (1 % F, 100 ppm K; E24/E96) | 1% | 100ppm/K | 1206 | Resistor_SMD:R_1206_3216Metric | KiCad standard library footprint (IPC-7351 nominal) | False |  |  | 0.0676 | 0.25 | 0.2704 | yes | doğrulanamadı (Vishay/Panasonic web stok sorgusu yapılmadı) | False | raw bus bleeder; 26 V fault 68 mW -> 27 %
U6 | U | LM74502H | LM74502HDDFR | Texas Instruments | TI LM74502/H SNOSDE5A p.3-6; addendum LM74502HDDFR Active/Production |  |  | SOT-23-THIN-8 (DDF) | Package_TO_SOT_SMD:TSOT-23-8 | KiCad standard library footprint (IPC-7351 nominal) (DDF 2.9x1.6 thin; verify vs TI land) | False | 53.3 | 65 |  |  | 0.82 | 82% of abs max | ACTIVE/Production (TI datasheet package addendum) | False
Q2 | Q | 100 V N-MOSFET | CSD19531Q5A | Texas Instruments | TI CSD19531Q5A SLPS406B p.1,3 (orderable CSD19531Q5A / CSD19531Q5AT) |  |  | SON 5x6 (Q5A) | PDU:TI_CSD19531Q5A_Q5A | repo custom land from TI SLPS406B 7.2 p.10 (R-009; check_footprints TI F1..F11 bands) | False | 53.3 | 100 |  |  | 0.533 | 53% of abs max | ACTIVE/Production (TI datasheet package addendum) | False
R_GS | R | 100k | CRCW0603100KFKEA | Vishay | Vishay CRCW e3 doc 20035 p.1-2 (1 % F, 100 ppm K; E24/E96) | 1% | 100ppm/K | 0603 | Resistor_SMD:R_0603_1608Metric | KiCad standard library footprint (IPC-7351 nominal) | False |  |  | 0.002 | 0.08235 | 0.02429 | yes | doğrulanamadı (Vishay/Panasonic web stok sorgusu yapılmadı) | False
C_ISO_VCAP | C | 100n | C1608X7R1H104K080AA | TDK | TDK Product Center part page (official), status Production, checked 2026-11-07 (G4) |  | X7R | 0603 | Capacitor_SMD:C_0603_1608Metric | KiCad standard library footprint (IPC-7351 nominal) | False | 14 | 50 |  |  | 0.28 | yes | Production (TDK page, 2026-11-07) | False | LM74502H VCAP-VS >=0.1 uF (p.4)
C_ISO_VS | C | 100n | C1608X7S2A104K080AB | TDK | TDK Product Center part page (official), status Production, checked 2026-11-07 (G4) |  | X7S | 0603 | Capacitor_SMD:C_0603_1608Metric | KiCad standard library footprint (IPC-7351 nominal) | False | 11.16 | 100 |  |  | 0.1116 | yes | Production (TDK page, 2026-11-07) | False | LM74502H VS 100 nF (p.3); derating vs continuous bus, fault peak (SIM) < 100 V rating
R_OVT | R | 8.25k | TNPW12068K25BXEA | Vishay | Vishay TNPW e3 doc 28758 p.1-4 (0.1 % B, 15 ppm X / 25 ppm E; E96) | 0.1% | 15ppm/K | 1206 | Resistor_SMD:R_1206_3216Metric | KiCad standard library footprint (IPC-7351 nominal) | False |  |  | 0.05 | 0.2059 | 0.2429 | yes | doğrulanamadı (Vishay/Panasonic web stok sorgusu yapılmadı) | False | 26 V continuous 0.050 W; 53.3 V transient 0.21 W
R_OVB | R | 2.32k | TNPW12062K32BXEA | Vishay | Vishay TNPW e3 doc 28758 p.1-4 (0.1 % B, 15 ppm X / 25 ppm E; E96) | 0.1% | 15ppm/K | 1206 | Resistor_SMD:R_1206_3216Metric | KiCad standard library footprint (IPC-7351 nominal) | False |  |  | 0.014 | 0.2059 | 0.068 | yes | doğrulanamadı (Vishay/Panasonic web stok sorgusu yapılmadı) | False
U7 | U | TLV3601 | TLV3601DCKR | Texas Instruments | TI TLV360x SNOSDB1E p.3,5,7; addendum TLV3601DCKR Active/Production |  |  | SC70-5 (DCK) | Package_TO_SOT_SMD:SOT-353_SC-70-5 | KiCad standard library footprint (IPC-7351 nominal) | False |  |  |  |  |  |  | ACTIVE/Production (TI datasheet package addendum) | False
U11 | U | INA296A2-Q1 (G=20) | INA296A2QDGKRQ1 | Texas Instruments | TI INA296A-Q1/B-Q1 SBOSA32D p.2 (pins), p.4-6; addendum INA296A2QDGKRQ1 Active/Production |  |  | VSSOP-8 (DGK) | Package_SO:VSSOP-8_3x3mm_P0.65mm | KiCad standard library footprint (IPC-7351 nominal) | False | 51.5 | 110 |  |  | 0.4682 | yes | ACTIVE/Production (TI datasheet package addendum) | False | CM -5..110 V; settling 1 us TYPICAL (OC timing conditional)
U13 | U | TLV3601 | TLV3601DCKR | Texas Instruments | TI TLV360x SNOSDB1E p.3,5,7; addendum TLV3601DCKR Active/Production |  |  | SC70-5 (DCK) | Package_TO_SOT_SMD:SOT-353_SC-70-5 | KiCad standard library footprint (IPC-7351 nominal) | False |  |  |  |  |  |  | ACTIVE/Production (TI datasheet package addendum) | False
C_INA1 | C | 100n | C1608X7R1H104K080AA | TDK | TDK Product Center part page (official), status Production, checked 2026-11-07 (G4) |  | X7R | 0603 | Capacitor_SMD:C_0603_1608Metric | KiCad standard library footprint (IPC-7351 nominal) | False | 5.1 | 50 |  |  | 0.102 | yes | Production (TDK page, 2026-11-07) | False
C_OCC1 | C | 100n | C1608X7R1H104K080AA | TDK | TDK Product Center part page (official), status Production, checked 2026-11-07 (G4) |  | X7R | 0603 | Capacitor_SMD:C_0603_1608Metric | KiCad standard library footprint (IPC-7351 nominal) | False | 5.1 | 50 |  |  | 0.102 | yes | Production (TDK page, 2026-11-07) | False
U12 | U | INA296A2-Q1 (G=20) | INA296A2QDGKRQ1 | Texas Instruments | TI INA296A-Q1/B-Q1 SBOSA32D p.2 (pins), p.4-6; addendum INA296A2QDGKRQ1 Active/Production |  |  | VSSOP-8 (DGK) | Package_SO:VSSOP-8_3x3mm_P0.65mm | KiCad standard library footprint (IPC-7351 nominal) | False | 51.5 | 110 |  |  | 0.4682 | yes | ACTIVE/Production (TI datasheet package addendum) | False | CM -5..110 V; settling 1 us TYPICAL (OC timing conditional)
U14 | U | TLV3601 | TLV3601DCKR | Texas Instruments | TI TLV360x SNOSDB1E p.3,5,7; addendum TLV3601DCKR Active/Production |  |  | SC70-5 (DCK) | Package_TO_SOT_SMD:SOT-353_SC-70-5 | KiCad standard library footprint (IPC-7351 nominal) | False |  |  |  |  |  |  | ACTIVE/Production (TI datasheet package addendum) | False
C_INA2 | C | 100n | C1608X7R1H104K080AA | TDK | TDK Product Center part page (official), status Production, checked 2026-11-07 (G4) |  | X7R | 0603 | Capacitor_SMD:C_0603_1608Metric | KiCad standard library footprint (IPC-7351 nominal) | False | 5.1 | 50 |  |  | 0.102 | yes | Production (TDK page, 2026-11-07) | False
C_OCC2 | C | 100n | C1608X7R1H104K080AA | TDK | TDK Product Center part page (official), status Production, checked 2026-11-07 (G4) |  | X7R | 0603 | Capacitor_SMD:C_0603_1608Metric | KiCad standard library footprint (IPC-7351 nominal) | False | 5.1 | 50 |  |  | 0.102 | yes | Production (TDK page, 2026-11-07) | False
U15 | U | SN74LVC1G11 (3-in AND) | SN74LVC1G11DBVR | Texas Instruments | TI SN74LVC1G11 datasheet tpd table; addendum SN74LVC1G11DBVR Active/Production |  |  | SOT-23-6 (DBV) | Package_TO_SOT_SMD:SOT-23-6 | KiCad standard library footprint (IPC-7351 nominal) | False |  |  |  |  |  |  | ACTIVE/Production (TI datasheet package addendum) | False | pin map per TI DBV table: verify against symbol
C_AND | C | 100n | C1608X7R1H104K080AA | TDK | TDK Product Center part page (official), status Production, checked 2026-11-07 (G4) |  | X7R | 0603 | Capacitor_SMD:C_0603_1608Metric | KiCad standard library footprint (IPC-7351 nominal) | False | 5.1 | 50 |  |  | 0.102 | yes | Production (TDK page, 2026-11-07) | False
R_OCT | R | 255 | TNPW0603255RBXEA | Vishay | Vishay TNPW e3 doc 28758 p.1-4 (0.1 % B, 15 ppm X / 25 ppm E; E96) | 0.1% | 15ppm/K | 0603 | Resistor_SMD:R_0603_1608Metric | KiCad standard library footprint (IPC-7351 nominal) | False |  |  | 0.002 | 0.08235 | 0.02429 | yes | doğrulanamadı (Vishay/Panasonic web stok sorgusu yapılmadı) | False | OC threshold 12.97-13.60 A (n1-results.json)
R_OCB | R | 1.00k | TNPW06031K00BXEA | Vishay | Vishay TNPW e3 doc 28758 p.1-4 (0.1 % B, 15 ppm X / 25 ppm E; E96) | 0.1% | 15ppm/K | 0603 | Resistor_SMD:R_0603_1608Metric | KiCad standard library footprint (IPC-7351 nominal) | False |  |  | 0.004 | 0.08235 | 0.04857 | yes | doğrulanamadı (Vishay/Panasonic web stok sorgusu yapılmadı) | False
C_CMP | C | 100n | C1608X7R1H104K080AA | TDK | TDK Product Center part page (official), status Production, checked 2026-11-07 (G4) |  | X7R | 0603 | Capacitor_SMD:C_0603_1608Metric | KiCad standard library footprint (IPC-7351 nominal) | False | 5.1 | 50 |  |  | 0.102 | yes | Production (TDK page, 2026-11-07) | False
U8 | U | REF5025A-Q1 | REF5025AQDRQ1 | Texas Instruments | TI REF50xxA-Q1 SBOS456H p.5; addendum REF5025AQDRQ1 Active/Production |  |  | SOIC-8 (D) | Package_SO:SOIC-8_3.9x4.9mm_P1.27mm | KiCad standard library footprint (IPC-7351 nominal) | False |  |  |  |  |  |  | ACTIVE/Production (TI datasheet package addendum) | False
C_REF_IN | C | 1u | C1608X7R1E105K080AB | TDK | TDK Product Center part page (official), status Production, checked 2026-11-07 (G4) |  | X7R | 0603 | Capacitor_SMD:C_0603_1608Metric | KiCad standard library footprint (IPC-7351 nominal) | False | 5.1 | 25 |  |  | 0.204 | yes | Production (TDK page, 2026-11-07) | False
C_REF_OUT | C | 1u | C1608X7R1E105K080AB | TDK | TDK Product Center part page (official), status Production, checked 2026-11-07 (G4) |  | X7R | 0603 | Capacitor_SMD:C_0603_1608Metric | KiCad standard library footprint (IPC-7351 nominal) | False | 2.5 | 25 |  |  | 0.1 | yes | Production (TDK page, 2026-11-07) | False | datasheet test CL=1 uF (p.4)
C_REF_NR | C | 1u | C1608X7R1E105K080AB | TDK | TDK Product Center part page (official), status Production, checked 2026-11-07 (G4) |  | X7R | 0603 | Capacitor_SMD:C_0603_1608Metric | KiCad standard library footprint (IPC-7351 nominal) | False | 2.5 | 25 |  |  | 0.1 | yes | Production (TDK page, 2026-11-07) | True | TRIM/NR optional
U9 | U | SN74LVC1G74 | SN74LVC1G74DCUR | Texas Instruments | TI SN74LVC1G74 SCES794G p.4,7; addendum SN74LVC1G74DCUR Active/Production |  |  | VSSOP-8 (DCU) | Package_SO:VSSOP-8_2.3x2mm_P0.5mm | KiCad standard library footprint (IPC-7351 nominal) | False |  |  |  |  |  |  | ACTIVE/Production (TI datasheet package addendum) | False
C_LAT | C | 100n | C1608X7R1H104K080AA | TDK | TDK Product Center part page (official), status Production, checked 2026-11-07 (G4) |  | X7R | 0603 | Capacitor_SMD:C_0603_1608Metric | KiCad standard library footprint (IPC-7351 nominal) | False | 5.1 | 50 |  |  | 0.102 | yes | Production (TDK page, 2026-11-07) | False
R_CLR | R | 100k | CRCW0603100KFKEA | Vishay | Vishay CRCW e3 doc 20035 p.1-2 (1 % F, 100 ppm K; E24/E96) | 1% | 100ppm/K | 0603 | Resistor_SMD:R_0603_1608Metric | KiCad standard library footprint (IPC-7351 nominal) | False |  |  | 0.0003 | 0.08235 | 0.003643 | yes | doğrulanamadı (Vishay/Panasonic web stok sorgusu yapılmadı) | False
C_CLR | C | 1u | C1608X7R1E105K080AB | TDK | TDK Product Center part page (official), status Production, checked 2026-11-07 (G4) |  | X7R | 0603 | Capacitor_SMD:C_0603_1608Metric | KiCad standard library footprint (IPC-7351 nominal) | False | 5.1 | 25 |  |  | 0.204 | yes | Production (TDK page, 2026-11-07) | False | POR ~120 ms
SW1 | SW | momentary reset, SPST-NO | B3U-1000P | ARATAS (Omron Components) | ARATAS (formerly Omron Components) B3U official page: B3U-1000P 'In production', checked 2026-11-07 |  |  | B3U SMT | Button_Switch_SMD:SW_SPST_B3U-1000P | KiCad standard library footprint (IPC-7351 nominal) | False | 5 |  |  |  |  |  | doğrulanamadı | False | contact rating not in page text (doğrulanamadı); use 5 V / ~50 uA (CLR pull-up)
R_Q | R | 10k | CRCW060310K0FKEA | Vishay | Vishay CRCW e3 doc 20035 p.1-2 (1 % F, 100 ppm K; E24/E96) | 1% | 100ppm/K | 0603 | Resistor_SMD:R_0603_1608Metric | KiCad standard library footprint (IPC-7351 nominal) | False |  |  | 0.001 | 0.08235 | 0.01214 | yes | doğrulanamadı (Vishay/Panasonic web stok sorgusu yapılmadı) | False
R_OV2T | R | 60.4k | CRCW060360K4FKEA | Vishay | Vishay CRCW e3 doc 20035 p.1-2 (1 % F, 100 ppm K; E24/E96) | 1% | 100ppm/K | 0603 | Resistor_SMD:R_0603_1608Metric | KiCad standard library footprint (IPC-7351 nominal) | False |  |  | 0.009536 | 0.08235 | 0.1158 | yes | doğrulanamadı (Vishay/Panasonic web stok sorgusu yapılmadı) | False | coarse OV 11.58-13.74 V (>= precision trip_max + 30 mV)
R_OV2B | R | 19.6k | CRCW060319K6FKEA | Vishay | Vishay CRCW e3 doc 20035 p.1-2 (1 % F, 100 ppm K; E24/E96) | 1% | 100ppm/K | 0603 | Resistor_SMD:R_0603_1608Metric | KiCad standard library footprint (IPC-7351 nominal) | False |  |  | 0.0003 | 0.08235 | 0.003643 | yes | doğrulanamadı (Vishay/Panasonic web stok sorgusu yapılmadı) | False
R_EN1 | R | 15k | CRCW060315K0FKEA | Vishay | Vishay CRCW e3 doc 20035 p.1-2 (1 % F, 100 ppm K; E24/E96) | 1% | 100ppm/K | 0603 | Resistor_SMD:R_0603_1608Metric | KiCad standard library footprint (IPC-7351 nominal) | False |  |  | 0.001 | 0.08235 | 0.01214 | yes | doğrulanamadı (Vishay/Panasonic web stok sorgusu yapılmadı) | False
R_EN2 | R | 10k | CRCW060310K0FKEA | Vishay | Vishay CRCW e3 doc 20035 p.1-2 (1 % F, 100 ppm K; E24/E96) | 1% | 100ppm/K | 0603 | Resistor_SMD:R_0603_1608Metric | KiCad standard library footprint (IPC-7351 nominal) | False |  |  | 0.0004 | 0.08235 | 0.004857 | yes | doğrulanamadı (Vishay/Panasonic web stok sorgusu yapılmadı) | False
U10 | U | TPS7A1650-Q1 | TPS7A1650QDGNRQ1 | Texas Instruments | TI TPS7A16-Q1 SBVS188E p.3-6; addendum TPS7A1650QDGNRQ1 Active/Production |  |  | HVSSOP-8 (DGN) | Package_SO:HVSSOP-8-1EP_3x3mm_P0.65mm_EP1.57x1.89mm | KiCad standard library footprint (IPC-7351 nominal) (DGN) | False | 53.3 | 60 |  |  | 0.8883 | 89% of abs max | ACTIVE/Production (TI datasheet package addendum) | False
C_LDO_IN | C | 1u | C3216X7R2A105K160AA | TDK | TDK Product Center part page (official), status Production, checked 2026-11-07 (G4) |  | X7R | 1206 | Capacitor_SMD:C_1206_3216Metric | KiCad standard library footprint (IPC-7351 nominal) | False | 26 | 100 |  |  | 0.26 | yes | Production (TDK page, 2026-11-07) | False | TI recommends 10 uF at IN (p.3); 1 uF local + CIN bank
C_LDO_OUT | C | 2.2u | C2012X7R1E225K125AB | TDK | TDK Product Center part page (official), status Production, checked 2026-11-07 (G4) |  | X7R | 0805 | Capacitor_SMD:C_0805_2012Metric | KiCad standard library footprint (IPC-7351 nominal) | False | 5.1 | 25 |  |  | 0.204 | yes | Production (TDK page, 2026-11-07) | False | datasheet test COUT=2.2 uF
C_LDO_DELAY | C | 10n | C1608C0G1H103J080AA | TDK | TDK Product Center part page (official), status Production, checked 2026-11-07 (G4) |  | C0G | 0603 | Capacitor_SMD:C_0603_1608Metric | KiCad standard library footprint (IPC-7351 nominal) | False | 5 | 50 |  |  | 0.1 | yes | Production (TDK page, 2026-11-07) | True
R_BL5 | R | 1k | CRCW12061K00FKEA | Vishay | Vishay CRCW e3 doc 20035 p.1-2 (1 % F, 100 ppm K; E24/E96) | 1% | 100ppm/K | 1206 | Resistor_SMD:R_1206_3216Metric | KiCad standard library footprint (IPC-7351 nominal) | False |  |  | 0.02601 | 0.2059 | 0.1263 | yes | doğrulanamadı (Vishay/Panasonic web stok sorgusu yapılmadı) | False | bleeder for clamp back-power (R07)
R_BLS | R | 4.7k | CRCW12064K70FKEA | Vishay | Vishay CRCW e3 doc 20035 p.1-2 (1 % F, 100 ppm K; E24/E96) | 1% | 100ppm/K | 1206 | Resistor_SMD:R_1206_3216Metric | KiCad standard library footprint (IPC-7351 nominal) | False |  |  | 0.02863 | 0.2059 | 0.1391 | yes | doğrulanamadı (Vishay/Panasonic web stok sorgusu yapılmadı) | False | VSAFE bleeder (R16)
U3 | U | TPS259824L | TPS259824LNRGER | Texas Instruments | TI TPS25982 SLVSEI3D p.7-9,22; addendum ACTIVE |  |  | VQFN-24 (RGE) | PDU:TPS25982_RGE0024M | repo custom land | True | 11.6 | 30 |  |  | 0.3867 | yes | ACTIVE/Production (TI datasheet package addendum) | False | IN moved /VOUT->/VSAFE; variant O (circuit breaker) -> L (active current limiter, 16.9 V OVLO; TPS25982 p.4) per G3 audit
RILIM1 | R | 182 | TNPW0603182RBXEA | Vishay | Vishay TNPW e3 doc 28758 p.1-4 (0.1 % B, 15 ppm X / 25 ppm E; E96) | 0.1% | 15ppm/K | 0603 | Resistor_SMD:R_0603_1608Metric | KiCad standard library footprint (IPC-7351 nominal) | False |  |  | 0.0001 | 0.08235 | 0.001214 | yes | doğrulanamadı (Vishay/Panasonic web stok sorgusu yapılmadı) | False | TPS25982 p.9 guaranteed table point
RIMON1 | R | 806 | ERA3AEB8060V | Panasonic | Panasonic ERA-3AEB (repo BOM 'manufacturer verified'; not re-read in G2) | 0.1% | 25ppm/K | 0603 | Resistor_SMD:R_0603_1608Metric | KiCad standard library footprint (IPC-7351 nominal) | False |  |  | 0.001 | 0.1 | 0.01 | yes | doğrulanamadı (Vishay/Panasonic web stok sorgusu yapılmadı) | False
CDVDT1 | C | 1.0n | C1608C0G1H102J080AA | TDK | TDK Product Center part page (official), status Production, checked 2026-11-07 (G4) |  | C0G | 0603 | Capacitor_SMD:C_0603_1608Metric | KiCad standard library footprint (IPC-7351 nominal) | False | 15.6 | 50 |  |  | 0.312 | yes | Production (TDK page, 2026-11-07) | False | sees VIN+4 V (TPS25982 p.37 design example)
CEFIN1 | C | 100n | C1608X7R1H104K080AA | TDK | TDK Product Center part page (official), status Production, checked 2026-11-07 (G4) |  | X7R | 0603 | Capacitor_SMD:C_0603_1608Metric | KiCad standard library footprint (IPC-7351 nominal) | False | 11.6 | 50 |  |  | 0.232 | yes | Production (TDK page, 2026-11-07) | False
CEFOUT1 | C | 10u | C3216X7R1E106K160AB | TDK | TDK Product Center part page (official), status Production, checked 2026-11-07 (G4) |  | X7R | 1206 | Capacitor_SMD:C_1206_3216Metric | KiCad standard library footprint (IPC-7351 nominal) | False | 11.94 | 25 |  |  | 0.4776 | yes | Production (TDK page, 2026-11-07) | False | 25 V 0805: 46 % of rating; Ceff assumed 40 % (DC-bias datasheet not available)
RPG1 | R | 100k | CRCW0603100KFKEA | Vishay | Vishay CRCW e3 doc 20035 p.1-2 (1 % F, 100 ppm K; E24/E96) | 1% | 100ppm/K | 0603 | Resistor_SMD:R_0603_1608Metric | KiCad standard library footprint (IPC-7351 nominal) | False |  |  | 0.001 | 0.08235 | 0.01214 | yes | doğrulanamadı (Vishay/Panasonic web stok sorgusu yapılmadı) | False
RPG1B | R | 18k | CRCW060318K0FKEA | Vishay | Vishay CRCW e3 doc 20035 p.1-2 (1 % F, 100 ppm K; E24/E96) | 1% | 100ppm/K | 0603 | Resistor_SMD:R_0603_1608Metric | KiCad standard library footprint (IPC-7351 nominal) | False |  |  | 0.0002 | 0.08235 | 0.002429 | yes | doğrulanamadı (Vishay/Panasonic web stok sorgusu yapılmadı) | False
D_REV1 | D | Schottky 40 V 3 A | SS34-E3/57T | Vishay General Semiconductor | Vishay SS32-SS36 doc 88751 p.1-2 (SMC; ordering pattern SS3x-E3/57T) |  |  | SMC (DO-214AB) | Diode_SMD:D_SMC | KiCad standard library footprint (IPC-7351 nominal) | False | 11.94 | 40 |  |  | 0.2985 | yes | doğrulanamadı | False | OUT->IN clamp (R16); reverse-biased up to VSAFE when port shorted; Vf/leakage typical only (hot leakage back-feed AÇIK)
D2 | D | Schottky 40 V 3 A | SS34-E3/57T | Vishay General Semiconductor | Vishay SS32-SS36 doc 88751 p.1-2 (SMC; ordering pattern SS3x-E3/57T) |  |  | SMC (DO-214AB) | Diode_SMD:D_SMC | KiCad standard library footprint (IPC-7351 nominal) | False | 11.6 | 40 |  |  | 0.29 | yes | doğrulanamadı | False | footprint changes SMA -> SMC (Vishay SS34 is SMC)
U4 | U | TPS259824L | TPS259824LNRGER | Texas Instruments | TI TPS25982 SLVSEI3D p.7-9,22; addendum ACTIVE |  |  | VQFN-24 (RGE) | PDU:TPS25982_RGE0024M | repo custom land | True | 11.6 | 30 |  |  | 0.3867 | yes | ACTIVE/Production (TI datasheet package addendum) | False | IN moved /VOUT->/VSAFE; variant O (circuit breaker) -> L (active current limiter, 16.9 V OVLO; TPS25982 p.4) per G3 audit
RILIM2 | R | 300 | TNPW0603300RBXEA | Vishay | Vishay TNPW e3 doc 28758 p.1-4 (0.1 % B, 15 ppm X / 25 ppm E; E96) | 0.1% | 15ppm/K | 0603 | Resistor_SMD:R_0603_1608Metric | KiCad standard library footprint (IPC-7351 nominal) | False |  |  | 0.0001 | 0.08235 | 0.001214 | yes | doğrulanamadı (Vishay/Panasonic web stok sorgusu yapılmadı) | False | TPS25982 p.9 guaranteed table point
RIMON2 | R | 806 | ERA3AEB8060V | Panasonic | Panasonic ERA-3AEB (repo BOM 'manufacturer verified'; not re-read in G2) | 0.1% | 25ppm/K | 0603 | Resistor_SMD:R_0603_1608Metric | KiCad standard library footprint (IPC-7351 nominal) | False |  |  | 0.001 | 0.1 | 0.01 | yes | doğrulanamadı (Vishay/Panasonic web stok sorgusu yapılmadı) | False
CDVDT2 | C | 1.0n | C1608C0G1H102J080AA | TDK | TDK Product Center part page (official), status Production, checked 2026-11-07 (G4) |  | C0G | 0603 | Capacitor_SMD:C_0603_1608Metric | KiCad standard library footprint (IPC-7351 nominal) | False | 15.6 | 50 |  |  | 0.312 | yes | Production (TDK page, 2026-11-07) | False | sees VIN+4 V (TPS25982 p.37 design example)
CEFIN2 | C | 100n | C1608X7R1H104K080AA | TDK | TDK Product Center part page (official), status Production, checked 2026-11-07 (G4) |  | X7R | 0603 | Capacitor_SMD:C_0603_1608Metric | KiCad standard library footprint (IPC-7351 nominal) | False | 11.6 | 50 |  |  | 0.232 | yes | Production (TDK page, 2026-11-07) | False
CEFOUT2 | C | 10u | C3216X7R1E106K160AB | TDK | TDK Product Center part page (official), status Production, checked 2026-11-07 (G4) |  | X7R | 1206 | Capacitor_SMD:C_1206_3216Metric | KiCad standard library footprint (IPC-7351 nominal) | False | 11.94 | 25 |  |  | 0.4776 | yes | Production (TDK page, 2026-11-07) | False | 25 V 0805: 46 % of rating; Ceff assumed 40 % (DC-bias datasheet not available)
RPG2 | R | 100k | CRCW0603100KFKEA | Vishay | Vishay CRCW e3 doc 20035 p.1-2 (1 % F, 100 ppm K; E24/E96) | 1% | 100ppm/K | 0603 | Resistor_SMD:R_0603_1608Metric | KiCad standard library footprint (IPC-7351 nominal) | False |  |  | 0.001 | 0.08235 | 0.01214 | yes | doğrulanamadı (Vishay/Panasonic web stok sorgusu yapılmadı) | False
RPG2B | R | 18k | CRCW060318K0FKEA | Vishay | Vishay CRCW e3 doc 20035 p.1-2 (1 % F, 100 ppm K; E24/E96) | 1% | 100ppm/K | 0603 | Resistor_SMD:R_0603_1608Metric | KiCad standard library footprint (IPC-7351 nominal) | False |  |  | 0.0002 | 0.08235 | 0.002429 | yes | doğrulanamadı (Vishay/Panasonic web stok sorgusu yapılmadı) | False
D_REV2 | D | Schottky 40 V 3 A | SS34-E3/57T | Vishay General Semiconductor | Vishay SS32-SS36 doc 88751 p.1-2 (SMC; ordering pattern SS3x-E3/57T) |  |  | SMC (DO-214AB) | Diode_SMD:D_SMC | KiCad standard library footprint (IPC-7351 nominal) | False | 11.94 | 40 |  |  | 0.2985 | yes | doğrulanamadı | False | OUT->IN clamp (R16); reverse-biased up to VSAFE when port shorted; Vf/leakage typical only (hot leakage back-feed AÇIK)
D3 | D | Schottky 40 V 3 A | SS34-E3/57T | Vishay General Semiconductor | Vishay SS32-SS36 doc 88751 p.1-2 (SMC; ordering pattern SS3x-E3/57T) |  |  | SMC (DO-214AB) | Diode_SMD:D_SMC | KiCad standard library footprint (IPC-7351 nominal) | False | 11.6 | 40 |  |  | 0.29 | yes | doğrulanamadı | False | footprint changes SMA -> SMC (Vishay SS34 is SMC)
REN1 | R | 64.9k | CRCW060364K9FKEA | Vishay | Vishay CRCW e3 doc 20035 p.1-2 (1 % F, 100 ppm K; E24/E96) | 1% | 100ppm/K | 0603 | Resistor_SMD:R_0603_1608Metric | KiCad standard library footprint (IPC-7351 nominal) | False |  |  | 0.002 | 0.08235 | 0.02429 | yes | doğrulanamadı (Vishay/Panasonic web stok sorgusu yapılmadı) | False
REN2 | R | 10k | CRCW060310K0FKEA | Vishay | Vishay CRCW e3 doc 20035 p.1-2 (1 % F, 100 ppm K; E24/E96) | 1% | 100ppm/K | 0603 | Resistor_SMD:R_0603_1608Metric | KiCad standard library footprint (IPC-7351 nominal) | False |  |  | 0.0003 | 0.08235 | 0.003643 | yes | doğrulanamadı (Vishay/Panasonic web stok sorgusu yapılmadı) | False
J1 | J | Micro-Fit 3.0 header 2 ckt, 4.48 A | 430450200 | Molex | Molex official part page (status Active, current/contact), checked 2026-11-07 (G4); 8.5 A max per contact, 600 V |  |  |  | Connector_Molex:Molex_Micro-Fit_3.0_43045-0200_2x01_P3.00mm_Horizontal | KiCad standard library footprint (IPC-7351 nominal) | False | 26 | 600 | 4.48 | 8.5 | 0.5271 | 53% of abs max | Active (Molex page) | False | 18 AWG terminals 430300038
J3 | J | Micro-Fit 3.0 header 2 ckt, 5.66 A | 430450200 | Molex | Molex official part page (status Active, current/contact), checked 2026-11-07 (G4); 8.5 A max per contact, 600 V |  |  |  | Connector_Molex:Molex_Micro-Fit_3.0_43045-0200_2x01_P3.00mm_Horizontal | KiCad standard library footprint (IPC-7351 nominal) | False | 11.6 | 600 | 5.66 | 8.5 | 0.6659 | 67% of abs max | Active (Molex page) | False | 18 AWG terminals 430300038
J2 | J | Mini-Fit Plus HCS header 2 ckt vertical, 9.07 A | 460150206 | Molex | Molex part pages 460150206 / 39012020 / 457501111 (Active, checked 2026-11-07) + PS-45750-001 p.8-9 (18 AWG 2 ckt 10.5 A, 30 C rise) |  |  |  | Connector_Molex:Molex_Mini-Fit_Jr_5566-02A_2x01_P4.20mm_Vertical | KiCad standard library (Mini-Fit Jr 5566-02A); verified vs Molex SD-46015-001 (row 5.50 mm, hole 1.40 mm, no peg) R-003 tour 2 | False | 11.6 | 600 | 9.07 | 10.5 | 0.8638 | 86% of abs max | Active (Molex page) | False | D-003: 18 AWG system rating 10.5 A (PS-45750-001); one contact per pole
P1 | CABLE | Micro-Fit 3.0 receptacle 2 ckt (J1 mate) | 430250200 | Molex | Molex official part page (status Active, current/contact), checked 2026-11-07 (G4) |  |  |  |  | kablo tarafı (PCB dışı) | False |  |  |  |  |  |  | Active (Molex page) | False | cable side; 18 AWG 0.5-1.5 m (VARSAYIM)
P2 | CABLE | Mini-Fit Jr receptacle housing 2 ckt dual row, 5557-02R (J2 mate) | 39012020 | Molex | Molex official part page (status Active, current/contact), checked 2026-11-07 (G4) |  |  |  |  | kablo tarafı (PCB dışı) | False |  |  |  |  |  |  | Active (Molex page) | False | cable side; 18 AWG 0.5-1.5 m (VARSAYIM)
P3 | CABLE | Micro-Fit 3.0 receptacle 2 ckt (J3 mate) | 430250200 | Molex | Molex official part page (status Active, current/contact), checked 2026-11-07 (G4) |  |  |  |  | kablo tarafı (PCB dışı) | False |  |  |  |  |  |  | Active (Molex page) | False | cable side; 18 AWG 0.5-1.5 m (VARSAYIM)
CT1 | CABLE | Micro-Fit 3.0 crimp terminal 18 AWG, 8.5 A (qty 4: P1, P3) | 430300038 | Molex | Molex official part page (status Active, current/contact), checked 2026-11-07 (G4) |  |  |  |  | kablo tarafı (PCB dışı) | False |  |  |  |  |  |  | Active (Molex page) | False | cable side; 18 AWG 0.5-1.5 m (VARSAYIM)
CT2 | CABLE | Mini-Fit Plus HCS female crimp terminal 20-18 AWG (qty 2: P2) | 457501111 | Molex | Molex official part page (status Active, current/contact), checked 2026-11-07 (G4) |  |  |  |  | kablo tarafı (PCB dışı) | False |  |  |  |  |  |  | Active (Molex page) | False | cable side; 18 AWG 0.5-1.5 m (VARSAYIM)
F1 | CABLE | Fuse 10x38 mm gPV 10 A, 1000 VDC, 50 kA DC breaking (battery cable, off-board; D-001) | PV-10A10F | Eaton (Bussmann) | Eaton 720110 Rev. Jan 2026 p.1 (PV-10A10F 10 A, 1000 VDC, 50 kA, I2t 7/70 A2s @1000 VDC) + 720147 Rev. Aug 2025 p.1-2 (CHPV1U 1000 VDC/30 A, 33 kA DC); D-001 |  |  |  |  | kablo tarafı (PCB dışı) | False |  |  |  |  |  |  | Active (Molex page) | False | off-board in battery + lead, nearest the battery; 18 AWG; D-001 (DIN rail mounting)
XF1 | CABLE | Fuse holder 10x38 mm DIN-rail 1P, 1000 VDC / 30 A, 33 kA DC (F1; D-001) | CHPV1U | Eaton (Bussmann) | Eaton 720110 Rev. Jan 2026 p.1 (PV-10A10F 10 A, 1000 VDC, 50 kA, I2t 7/70 A2s @1000 VDC) + 720147 Rev. Aug 2025 p.1-2 (CHPV1U 1000 VDC/30 A, 33 kA DC); D-001 |  |  |  |  | kablo tarafı (PCB dışı) | False |  |  |  |  |  |  | Active (Molex page) | False | off-board in battery + lead, nearest the battery; 18 AWG; D-001 (DIN rail mounting)
TP_ANODE | TP | TP |  |  |  |  |  |  | TestPoint:TestPoint_Pad_D2.0mm | KiCad standard library footprint (IPC-7351 nominal) (D-008 test pad) | False |  |  |  |  |  |  | PCB-only (D-008, not purchased) | False | bare test pad; BENCH-ACCEPTANCE / PCB-HANDOFF
TP_VIN | TP | TP |  |  |  |  |  |  | TestPoint:TestPoint_Pad_D2.0mm | KiCad standard library footprint (IPC-7351 nominal) (D-008 test pad) | False |  |  |  |  |  |  | PCB-only (D-008, not purchased) | False | bare test pad; BENCH-ACCEPTANCE / PCB-HANDOFF
TP_VOUT | TP | TP |  |  |  |  |  |  | TestPoint:TestPoint_Pad_D2.0mm | KiCad standard library footprint (IPC-7351 nominal) (D-008 test pad) | False |  |  |  |  |  |  | PCB-only (D-008, not purchased) | False | bare test pad; BENCH-ACCEPTANCE / PCB-HANDOFF
TP_VSAFE | TP | TP |  |  |  |  |  |  | TestPoint:TestPoint_Pad_D2.0mm | KiCad standard library footprint (IPC-7351 nominal) (D-008 test pad) | False |  |  |  |  |  |  | PCB-only (D-008, not purchased) | False | bare test pad; BENCH-ACCEPTANCE / PCB-HANDOFF
TP_O1 | TP | TP |  |  |  |  |  |  | TestPoint:TestPoint_Pad_D2.0mm | KiCad standard library footprint (IPC-7351 nominal) (D-008 test pad) | False |  |  |  |  |  |  | PCB-only (D-008, not purchased) | False | bare test pad; BENCH-ACCEPTANCE / PCB-HANDOFF
TP_S2E | TP | TP |  |  |  |  |  |  | TestPoint:TestPoint_Pad_D2.0mm | KiCad standard library footprint (IPC-7351 nominal) (D-008 test pad) | False |  |  |  |  |  |  | PCB-only (D-008, not purchased) | False | bare test pad; BENCH-ACCEPTANCE / PCB-HANDOFF
TP_ISO_GATE | TP | TP |  |  |  |  |  |  | TestPoint:TestPoint_Pad_D1.0mm | KiCad standard library footprint (IPC-7351 nominal) (D-008 test pad) | False |  |  |  |  |  |  | PCB-only (D-008, not purchased) | False | bare test pad; BENCH-ACCEPTANCE / PCB-HANDOFF
TP_ISO_OV | TP | TP |  |  |  |  |  |  | TestPoint:TestPoint_Pad_D1.0mm | KiCad standard library footprint (IPC-7351 nominal) (D-008 test pad) | False |  |  |  |  |  |  | PCB-only (D-008, not purchased) | False | bare test pad; BENCH-ACCEPTANCE / PCB-HANDOFF
TP_OVP_TRIP_N | TP | TP |  |  |  |  |  |  | TestPoint:TestPoint_Pad_D1.0mm | KiCad standard library footprint (IPC-7351 nominal) (D-008 test pad) | False |  |  |  |  |  |  | PCB-only (D-008, not purchased) | False | bare test pad; BENCH-ACCEPTANCE / PCB-HANDOFF
TP_OVP_Q | TP | TP |  |  |  |  |  |  | TestPoint:TestPoint_Pad_D1.0mm | KiCad standard library footprint (IPC-7351 nominal) (D-008 test pad) | False |  |  |  |  |  |  | PCB-only (D-008, not purchased) | False | bare test pad; BENCH-ACCEPTANCE / PCB-HANDOFF
TP_CLR_N | TP | TP |  |  |  |  |  |  | TestPoint:TestPoint_Pad_D1.0mm | KiCad standard library footprint (IPC-7351 nominal) (D-008 test pad) | False |  |  |  |  |  |  | PCB-only (D-008, not purchased) | False | bare test pad; BENCH-ACCEPTANCE / PCB-HANDOFF
TP_OVP_SENSE | TP | TP |  |  |  |  |  |  | TestPoint:TestPoint_Pad_D1.0mm | KiCad standard library footprint (IPC-7351 nominal) (D-008 test pad) | False |  |  |  |  |  |  | PCB-only (D-008, not purchased) | False | bare test pad; BENCH-ACCEPTANCE / PCB-HANDOFF
TP_OVP_REF | TP | TP |  |  |  |  |  |  | TestPoint:TestPoint_Pad_D1.0mm | KiCad standard library footprint (IPC-7351 nominal) (D-008 test pad) | False |  |  |  |  |  |  | PCB-only (D-008, not purchased) | False | bare test pad; BENCH-ACCEPTANCE / PCB-HANDOFF
TP_OVP_BUS_N | TP | TP |  |  |  |  |  |  | TestPoint:TestPoint_Pad_D1.0mm | KiCad standard library footprint (IPC-7351 nominal) (D-008 test pad) | False |  |  |  |  |  |  | PCB-only (D-008, not purchased) | False | bare test pad; BENCH-ACCEPTANCE / PCB-HANDOFF
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
TP_IMON_O1 | TP | TP |  |  |  |  |  |  | TestPoint:TestPoint_Pad_D1.0mm | KiCad standard library footprint (IPC-7351 nominal) (D-008 test pad) | False |  |  |  |  |  |  | PCB-only (D-008, not purchased) | False | bare test pad; BENCH-ACCEPTANCE / PCB-HANDOFF
TP_IMON_S2E | TP | TP |  |  |  |  |  |  | TestPoint:TestPoint_Pad_D1.0mm | KiCad standard library footprint (IPC-7351 nominal) (D-008 test pad) | False |  |  |  |  |  |  | PCB-only (D-008, not purchased) | False | bare test pad; BENCH-ACCEPTANCE / PCB-HANDOFF
TP_GND_FB | TP | TP |  |  |  |  |  |  | TestPoint:TestPoint_Pad_D2.0mm | KiCad standard library footprint (IPC-7351 nominal) (D-008 test pad) | False |  |  |  |  |  |  | PCB-only (D-008, not purchased) | False | bare test pad; BENCH-ACCEPTANCE / PCB-HANDOFF
TP_GND_OC | TP | TP |  |  |  |  |  |  | TestPoint:TestPoint_Pad_D2.0mm | KiCad standard library footprint (IPC-7351 nominal) (D-008 test pad) | False |  |  |  |  |  |  | PCB-only (D-008, not purchased) | False | bare test pad; BENCH-ACCEPTANCE / PCB-HANDOFF
TP_GND_OVP | TP | TP |  |  |  |  |  |  | TestPoint:TestPoint_Pad_D2.0mm | KiCad standard library footprint (IPC-7351 nominal) (D-008 test pad) | False |  |  |  |  |  |  | PCB-only (D-008, not purchased) | False | bare test pad; BENCH-ACCEPTANCE / PCB-HANDOFF
TP_GND_POWER | TP | TP |  |  |  |  |  |  | TestPoint:TestPoint_Pad_D2.0mm | KiCad standard library footprint (IPC-7351 nominal) (D-008 test pad) | False |  |  |  |  |  |  | PCB-only (D-008, not purchased) | False | bare test pad; BENCH-ACCEPTANCE / PCB-HANDOFF
J_OVP_INJ_BUS | FIX | OVP injection wire pads |  |  |  |  |  |  | Connector_Wire:SolderWire-6sqmm_1x02_P14mm_D3.5mm_OD7mm | KiCad standard library footprint (IPC-7351 nominal) (D-008 6 mm2 pads; Relief2x variant rejected: its courtyard includes the 90 mm cable relief; no current rating claimed) | False |  |  |  |  |  |  | PCB-only (D-008, not purchased) | False | BENCH T5 fixture cable soldered here
JP_EN_BUCK | JP | SolderJumper open |  |  |  |  |  |  | Jumper:SolderJumper-2_P1.3mm_Open_RoundedPad1.0x1.5mm | KiCad standard library footprint (IPC-7351 nominal) (D-008) | False |  |  |  |  |  |  | PCB-only (D-008, not purchased) | False | normally open; solder-bridge to disable the buck for T5 injection
