siimsek/PDU/hardware/bom.csv

Ref | Qty | Candidate MPN | Description / minimum rating | Status | Price snapshot 2026-10-17 | Source
U1,U2 | 2 | LM70880QRRXRQ1 | Each: 4.5-80 V / 8 A synchronous buck; 29-pin RRX VQFN | Two-device 180-degree interleaved candidate; TI supports up to 16 A; thermal/layout validation open | Mouser global showed 29,390 available to ship; Turkish landed cost/lead time not verified | https://www.mouser.com/en/ProductDetail/Texas-Instruments/LM70880QRRXRQ1
L1,L2 | 2 | IHLP4040DZER6R8M01 | 6.8 uH; 8 A at 40 C rise; typical 13.5 A Isat; 23.3 mOhm max DCR; check hot curves | Primary 7.5 A total dual-phase candidate; 80% of Isat is 10.8 A vs ~8.56 A worst OCP/delay peak; verify thermals | Farnell Türkiye catalogue lists EUR 1.10 each; exact local stock and delivery not verified | https://tr.farnell.com/c/passive-components/inductors/power-inductors/smd-power-inductors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; https://www.vishay.com/docs/34193/ihlp-4040dz-01.pdf
U3,U4 | 2 | TPS259824ONRGET | 2.7–24 V, 15 A, 2.7 mΩ smart eFuse; RGE package has separate EP pads 25=IN and 26=GND | Two-EP prototype footprint assigned; O1OVP16.9V mismatch unresolved; validate SOA/thermal/timer. | Mouser Türkiye snapshot: 24 in stock; €4.18 each at 1 pc, €3.16 each at 10 pc; recheck before order | https://www.mouser.com.tr/tr/ProductDetail/Texas-Instruments/TPS259824ONRGET
D1 | 1 | SMCJ33A | TVS, 33 V standoff; 53.3 V max clamp at specified 28.2 A test | On protected VIN, after the ideal diode. Surge coordination open | Mouser TR page showed EUR 0.662 at 1 pc; duties/shipping excluded | https://www.mouser.com.tr/ProductDetail/Littelfuse/SMCJ33A
D2,D3 | 2 | SS34 | 40 V, 3 A Schottky, cathode on the port output, anode GND | Parallel clamp only. Not in the load path. No cable-energy calculation, so it was not upsized. It cannot carry 5 A continuously | Quote required | https://www.vishay.com/docs/88712/ss32.pdf
F1 | 1 | TBD | 10 A-class DC fuse; choose time-current curve and breaking capacity | Open; coordinate battery/wire fault | Quote required | https://www.littelfuse.com/products/fuses
Q1 | 1 | BSC160N10NS3G | 100 V, 16.0 mOhm max, 42 A, OptiMOS, PG-TDSON-8; driven by U5 | High-side ideal-diode MOSFET. 20 V / 90% / 82.5 W input is about 4.58 A and 0.34 W at max Rds. Surge energy still open | Quote required | https://www.infineon.com/dgdl/Infineon-BSC160N10NS3-DS-v02_04-en.pdf
U5 | 1 | LM74700 | Ideal-diode controller, SOT-23-6. ANODE to FET source, CATHODE to protected VIN, EN tied to ANODE, 100 nF VCAP to ANODE | ANODE absolute maximum 65 V; SMCJ33A clamp maximum is 53.3 V. Not a measured surge test | Quote required | https://www.ti.com/lit/gpn/LM74700-Q1
CBIN | 2 | 10 nF, 100 V, X7R, 0603 | High di/dt VIN-PGND capacitor, one per LM70880-Q1 | Datasheet 8.2.1.2.6 value | Quote required | https://www.ti.com/lit/ds/symlink/lm70880-q1.pdf
CVCAP | 1 | 100 nF, 16 V or higher | LM74700 charge-pump capacitor, VCAP to ANODE | Above 0.1 uF and above 10 x Qg/Vgs for BSC160 Qg typical 19 nC | Quote required | https://www.ti.com/lit/gpn/LM74700-Q1
CIN | 8+ | GCM32DC72A475KE02L / equivalent | 4 x 4.7 uF per converter, 100 V, X7S; check DC-bias and pulse current | Two local banks for the two hot power loops; add source bulk after impedance/transient analysis | Quote required | https://www.ti.com/lit/ds/symlink/lm70840-q1.pdf
COUT | 8 | C5750X7S2A226M280KB | 22uF100V X7S2220;8parts;vendor typical bank164.98uF at11V25C;1.9204mOhm/part400kHz | Assigned schematic/PCB after disposableMCPpadvalidation;100V exceeds assumed53.3V envelope; real surge/loop/thermal acceptance open | Quote required | https://product.tdk.com/en/search/capacitor/ceramic/mlcc/info?part_no=C5750X7S2A226M280KB
RFB1 | 1 | ERA3AEB134V | 130kOhm 0603 0.1%25ppm/K 0.1W | Manufacturer verified and assigned through Konnect; nominal unchanged; procurement verification required | Quote required | https://industrial.panasonic.com/ww/products/pt/high-precision-chip-resistors/models/ERA3AEB134V
RFB2 | 1 | ERA3AEB1022V | 10.2kOhm 0603 0.1%25ppm/K 0.1W | Manufacturer verified and assigned through Konnect; nominal unchanged; procurement verification required | Quote required | https://industrial.panasonic.com/ww/products/pt/high-precision-chip-resistors/models/ERA3AEB1022V
RS1,RS2 | 2 | 7.5 mOhm, 1 W, 1%, Kelvin, low-inductance | Per-phase current sense; verify pulse and thermal rating | Calculated start for 7.5 A total, 6.8 uH -20%, 400 kHz and 50 mV minimum threshold; finalize with TI calculator | Quote required | https://www.ti.com/lit/ds/symlink/lm70880-q1.pdf
RT1,RT2 | 2 | 49.9 kOhm, 1% | Primary oscillator and secondary slope-compensation resistor; both same value | TI table nominal 440 kHz (400-480 kHz); ripple calculation uses 400 kHz min | Quote required | https://www.ti.com/lit/ds/symlink/lm70880-q1.pdf
RILIM_O1,RILIM_S2E | 2 | 301 Ohm / 604 Ohm, 1% | TPS25982 current-limit set resistors; nominal approx 4.96 A / 2.53 A | Existing301/604Ohm unchanged; not measured load targets. Official O1 DC rating5-12V/5A is confirmed; actual current/startup measurement and OVP correction remain open. | Quote required | https://www.ti.com/lit/ds/symlink/tps25982.pdf
CBOOT1,CBOOT2 | 2 | 47 nF, X7R | Bootstrap capacitors | One per LM70880-Q1; package/voltage rating TBD | Quote required | https://www.ti.com/lit/ds/symlink/lm70880-q1.pdf
CVCC1,CVCC2 | 2 | 4.7 uF, X7R | VCC bypass capacitors | One per LM70880-Q1; package/voltage rating TBD | Quote required | https://www.ti.com/lit/ds/symlink/lm70880-q1.pdf
CVDDA1,CVDDA2 | 2 | 100 nF, X7R | VDDA bypass capacitors | One per LM70880-Q1; package/voltage rating TBD | Quote required | https://www.ti.com/lit/ds/symlink/lm70880-q1.pdf
RCOMP | 1 | 9.53 kOhm, 1% | Primary compensation resistor, COMP to COMP_MID | Equation 42 with Ceff 88 uF assumption and RS/2; exact 9503 ohm. Not a measured loop gain | Quote required | https://www.ti.com/lit/ds/symlink/lm70880-q1.pdf
CCOMP | 1 | 4.7 nF, X7R | Compensation capacitor, COMP_MID to GND | Places the zero at 3553 Hz, above the 1233 Hz load pole at 7.5 A | Quote required | https://www.ti.com/lit/ds/symlink/lm70880-q1.pdf
CHF | 1 | 47 pF, C0G | HF compensation capacitor, COMP to GND | Formula goes negative for the assumed ESR zero; pole is about 355 kHz | Quote required | https://www.ti.com/lit/ds/symlink/lm70880-q1.pdf
RUV1,RUV2 | 2 | 180 kOhm / 10.0 kOhm, 1% | Shared LM70880 EN/UVLO divider from protected VIN | Nominal startup19V; with1% divider and1.05V maxEN threshold startup may need20.3318V before ENloading.20Vrestart not guaranteed. | Quote required | https://www.ti.com/lit/ds/symlink/lm70880-q1.pdf
REN1,REN2 | 2 | 64.9 kOhm / 10.0 kOhm, 1% | Shared TPS25982 EN divider from VOUT | 11 V puts the pin at 1.47 V. Direct 11 V exceeds the 7 V absolute maximum | Quote required | https://www.ti.com/lit/ds/symlink/tps25982.pdf
RPG1,RPG2 | 2 | 100 kOhm, 1% | PG pull-up to the port output | 100k top /18k bottom. Replaces former82.5k pulldown; external logic is not connected. | Quote required | https://www.ti.com/lit/ds/symlink/tps25982.pdf
RPG1B,RPG2B | 2 | 18 kOhm, 1% | PG pulldown to GND | PG unloaded monitor: 1.678V nominal at11V; <=4.654V at30V with adverse1% resistor tolerances. Future logic VIH unverified. | Quote required | https://www.ti.com/lit/ds/symlink/tps25982.pdf
RIMON1,RIMON2 | 2 | ERA3AEB8060V | 806Ohm each 0603 0.1%25ppm/K 0.1W | Applied schematic/PCB; nominal0.198276V/A;3.07165V at15A screened only within published gain domain; ILIM unchanged | Quote required | https://industrial.panasonic.com/ww/products/pt/high-precision-chip-resistors/models/ERA3AEB8060V
CDVDT1,CDVDT2 | 2 | 1.0 nF, X7R | dVdt capacitors to GND | 4.6 V/ms, about 2.39 ms to 11 V, 4.6 mA per uF of port capacitance | Quote required | https://www.ti.com/lit/ds/symlink/tps25982.pdf
J1,J2,J3 | 3 | 43045-0200 | Molex Micro-Fit 3.0 2-position right-angle board header; board pin 1 is the labeled rail, pin 2 GND | Board-side connector candidate only; O1 jack/S2E harness mating and polarity remain unverified | Farnell Türkiye snapshot: 9,917 stock; €0.807 each at 10 pc; 14-week standard lead time | https://tr.farnell.com/molex/43045-0200/conn-r-a-pcb-hdr-2pos-2row-3mm/dp/1012251
J1-H,J2-H,J3-H | 3 | 43025-0200 | Molex Micro-Fit 3.0 2-position wire housing; mating housing for 43045-0200 | Harness components; assemble only after rail labels and device-side harness are verified | Mouser Türkiye snapshot: 327,388 stock; €0.284 each at 1 pc | https://www.mouser.com.tr/tr/ProductDetail/Molex/43025-0200
J1-C1,J1-C2,J2-C1,J2-C2,J3-C1,J3-C2 | 6 | 43030-0007 | Molex Micro-Fit female crimp contact, 24-20 AWG; distributor lists 7 A/contact | Harness components; keep conservative connection design rating at 5 A pending wire/housing conditions | Farnell Türkiye snapshot: 497,630 stock; €0.174 each at 10 pc; Mouser Türkiye also lists stock | https://tr.farnell.com/molex/43030-0007/contact-socket-24-20awg-crimp/dp/2101869
PCB | 1 | TBD | 2-layer,35um nominal outer copper baseline; routing calculated at31.5um.2oz optional upgrade, not assumed | 72 prototype footprints placed; routing/fabrication acceptance open. See docs/SON-TESLIM.md | Quote required | https://jlcpcb.com/capabilities/Capabilities%2C/
RBOOT1,RBOOT2 | 2 | 1 Ohm, 1%, 0603 | Series bootstrap resistor, one in each47nF CBOOT path | Added per LM70880 Table5-1, VCC8V mode |  | https://www.ti.com/lit/ds/symlink/lm70880-q1.pdf
CIN_U5 | 1 | 22 nF, 100V, X7R, 0603 | LM74700 input bypass from ANODE toGND | Added; confirm selected capacitor effective capacitance/rating before procurement |  | https://www.ti.com/lit/ds/symlink/lm74700-q1.pdf
