siimsek/PDU/reports/g5/T-027/ledger-pins.csv

ref | uuid | pin | name | type | net | nc | pcb_pads | state | why | alt_pcb
CBIN1 | d719223a-c3c9-4e81-b758-bc0e2d3e4354 | 1 |  | passive | /VIN |  | /VIN | EŞLEŞTİ |  | aynı
CBIN1 | d719223a-c3c9-4e81-b758-bc0e2d3e4354 | 2 |  | passive | /GND |  | /GND | EŞLEŞTİ |  | aynı
CBIN2 | 70ccb136-cc7d-4547-830f-7ef080d6fff1 | 1 |  | passive | /VIN |  | /VIN | EŞLEŞTİ |  | aynı
CBIN2 | 70ccb136-cc7d-4547-830f-7ef080d6fff1 | 2 |  | passive | /GND |  | /GND | EŞLEŞTİ |  | aynı
CBOOT1 | 7a7d4ed2-5c78-409e-aab8-f61c47165e9a | 1 |  | passive | /CBOOT_R1 |  | /CBOOT_R1 | EŞLEŞTİ |  | aynı
CBOOT1 | 7a7d4ed2-5c78-409e-aab8-f61c47165e9a | 2 |  | passive | /SW4_PH1 |  | /SW4_PH1 | EŞLEŞTİ |  | aynı
CBOOT2 | 5554464a-d935-42f9-afbd-cd6ba18f93ba | 1 |  | passive | /CBOOT_R2 |  | /CBOOT_R2 | EŞLEŞTİ |  | aynı
CBOOT2 | 5554464a-d935-42f9-afbd-cd6ba18f93ba | 2 |  | passive | /SW4_PH2 |  | /SW4_PH2 | EŞLEŞTİ |  | aynı
CCOMP | 5a7a6228-741c-482b-a582-52449e80e9c9 | 1 |  | passive | /COMP_MID |  | /COMP_MID | EŞLEŞTİ |  | aynı
CCOMP | 5a7a6228-741c-482b-a582-52449e80e9c9 | 2 |  | passive | /GND |  | /GND | EŞLEŞTİ |  | aynı
CDVDT1 | 5fd03d48-db1d-448e-92c0-141605084775 | 1 |  | passive | /DVDT_O1 |  | /DVDT_O1 | EŞLEŞTİ |  | aynı
CDVDT1 | 5fd03d48-db1d-448e-92c0-141605084775 | 2 |  | passive | /GND |  | /GND | EŞLEŞTİ |  | aynı
CDVDT2 | eb3fba04-6867-4242-b21d-31e71f237f4c | 1 |  | passive | /DVDT_S2E |  | /DVDT_S2E | EŞLEŞTİ |  | aynı
CDVDT2 | eb3fba04-6867-4242-b21d-31e71f237f4c | 2 |  | passive | /GND |  | /GND | EŞLEŞTİ |  | aynı
CEFIN1 | c629e1a0-7afc-45c2-aaf8-25547e2a23db | 1 |  | passive | /VSAFE |  | /VSAFE | EŞLEŞTİ |  | aynı
CEFIN1 | c629e1a0-7afc-45c2-aaf8-25547e2a23db | 2 |  | passive | /GND |  | /GND | EŞLEŞTİ |  | aynı
CEFIN2 | fc1eae95-30bf-42e7-b8b5-a410c475d1dc | 1 |  | passive | /VSAFE |  | /VSAFE | EŞLEŞTİ |  | aynı
CEFIN2 | fc1eae95-30bf-42e7-b8b5-a410c475d1dc | 2 |  | passive | /GND |  | /GND | EŞLEŞTİ |  | aynı
CEFOUT1 | afe4f537-89e5-4878-8ab7-397f30c79c02 | 1 |  | passive | /O1_11V |  | /O1_11V | EŞLEŞTİ |  | aynı
CEFOUT1 | afe4f537-89e5-4878-8ab7-397f30c79c02 | 2 |  | passive | /GND |  | /GND | EŞLEŞTİ |  | aynı
CEFOUT2 | 1b14cc0d-9c04-4ce5-927c-252634d42e1a | 1 |  | passive | /S2E_11V |  | /S2E_11V | EŞLEŞTİ |  | aynı
CEFOUT2 | 1b14cc0d-9c04-4ce5-927c-252634d42e1a | 2 |  | passive | /GND |  | /GND | EŞLEŞTİ |  | aynı
CHF | 8664a1b9-3764-4cf2-847b-88a6e3a3519f | 1 |  | passive | /COMP |  | /COMP | EŞLEŞTİ |  | aynı
CHF | 8664a1b9-3764-4cf2-847b-88a6e3a3519f | 2 |  | passive | /GND |  | /GND | EŞLEŞTİ |  | aynı
CIN1 | d6ac9ce4-cae5-46f5-bcb9-5f08d8db89c6 | 1 |  | passive | /VIN |  | /VIN | EŞLEŞTİ |  | aynı
CIN1 | d6ac9ce4-cae5-46f5-bcb9-5f08d8db89c6 | 2 |  | passive | /GND |  | /GND | EŞLEŞTİ |  | aynı
CIN2 | 8be701dd-14ae-4d08-9137-c3dcc62f885a | 1 |  | passive | /VIN |  | /VIN | EŞLEŞTİ |  | aynı
CIN2 | 8be701dd-14ae-4d08-9137-c3dcc62f885a | 2 |  | passive | /GND |  | /GND | EŞLEŞTİ |  | aynı
CIN3 | f87129d4-102c-43da-8ca1-8e296dae7cf9 | 1 |  | passive | /VIN |  | /VIN | EŞLEŞTİ |  | aynı
CIN3 | f87129d4-102c-43da-8ca1-8e296dae7cf9 | 2 |  | passive | /GND |  | /GND | EŞLEŞTİ |  | aynı
CIN4 | 850818d9-5a21-4c77-8e7c-fa46dcb6f671 | 1 |  | passive | /VIN |  | /VIN | EŞLEŞTİ |  | aynı
CIN4 | 850818d9-5a21-4c77-8e7c-fa46dcb6f671 | 2 |  | passive | /GND |  | /GND | EŞLEŞTİ |  | aynı
CIN5 | 9405eaea-9ef3-4a50-96a3-29ab11a9bfe8 | 1 |  | passive | /VIN |  | /VIN | EŞLEŞTİ |  | aynı
CIN5 | 9405eaea-9ef3-4a50-96a3-29ab11a9bfe8 | 2 |  | passive | /GND |  | /GND | EŞLEŞTİ |  | aynı
CIN6 | 48850ab3-d358-42c4-9e8e-860eecbe5239 | 1 |  | passive | /VIN |  | /VIN | EŞLEŞTİ |  | aynı
CIN6 | 48850ab3-d358-42c4-9e8e-860eecbe5239 | 2 |  | passive | /GND |  | /GND | EŞLEŞTİ |  | aynı
CIN7 | a8231083-a74c-4d2d-95f2-b334b9c8f9e4 | 1 |  | passive | /VIN |  | /VIN | EŞLEŞTİ |  | aynı
CIN7 | a8231083-a74c-4d2d-95f2-b334b9c8f9e4 | 2 |  | passive | /GND |  | /GND | EŞLEŞTİ |  | aynı
CIN8 | 044f98ac-7cc5-477f-9404-8ad603aaf2e5 | 1 |  | passive | /VIN |  | /VIN | EŞLEŞTİ |  | aynı
CIN8 | 044f98ac-7cc5-477f-9404-8ad603aaf2e5 | 2 |  | passive | /GND |  | /GND | EŞLEŞTİ |  | aynı
CIN_U5 | 222c2bed-dc73-4e0f-aead-d9682b3a972e | 1 |  | passive | /ANODE |  | /ANODE | EŞLEŞTİ |  | aynı
CIN_U5 | 222c2bed-dc73-4e0f-aead-d9682b3a972e | 2 |  | passive | /GND |  | /GND | EŞLEŞTİ |  | aynı
COUT1 | ab7ef1f9-ae87-49d3-a1ac-30db70612974 | 1 |  | passive | /VOUT |  | /VOUT | EŞLEŞTİ |  | aynı
COUT1 | ab7ef1f9-ae87-49d3-a1ac-30db70612974 | 2 |  | passive | /GND |  | /GND | EŞLEŞTİ |  | aynı
COUT10 | 17e7f8ec-1fcc-57a3-b4d5-84653af00c40 | 1 |  | passive | /VOUT |  | /VOUT | EŞLEŞTİ |  | aynı
COUT10 | 17e7f8ec-1fcc-57a3-b4d5-84653af00c40 | 2 |  | passive | /GND |  | /GND | EŞLEŞTİ |  | aynı
COUT11 | bee0f7bd-0ea4-51c7-a823-112409fdc731 | 1 |  | passive | /VOUT |  | /VOUT | EŞLEŞTİ |  | aynı
COUT11 | bee0f7bd-0ea4-51c7-a823-112409fdc731 | 2 |  | passive | /GND |  | /GND | EŞLEŞTİ |  | aynı
COUT12 | b0d1edfa-901a-534a-b223-1446f5371314 | 1 |  | passive | /VOUT |  | /VOUT | EŞLEŞTİ |  | aynı
COUT12 | b0d1edfa-901a-534a-b223-1446f5371314 | 2 |  | passive | /GND |  | /GND | EŞLEŞTİ |  | aynı
COUT13 | 62eb9ed6-beb1-574f-9a52-117280a8476c | 1 |  | passive | /VOUT |  | /VOUT | EŞLEŞTİ |  | aynı
COUT13 | 62eb9ed6-beb1-574f-9a52-117280a8476c | 2 |  | passive | /GND |  | /GND | EŞLEŞTİ |  | aynı
COUT14 | e0a7b09b-4533-50b4-a632-1df93e5420ab | 1 |  | passive | /VOUT |  | /VOUT | EŞLEŞTİ |  | aynı
COUT14 | e0a7b09b-4533-50b4-a632-1df93e5420ab | 2 |  | passive | /GND |  | /GND | EŞLEŞTİ |  | aynı
COUT15 | 004f09e7-4c5d-5bec-918f-092db374d3be | 1 |  | passive | /VOUT |  | /VOUT | EŞLEŞTİ |  | aynı
COUT15 | 004f09e7-4c5d-5bec-918f-092db374d3be | 2 |  | passive | /GND |  | /GND | EŞLEŞTİ |  | aynı
COUT16 | e1c58ec5-9cee-505b-92d2-944c1def31e1 | 1 |  | passive | /VOUT |  | /VOUT | EŞLEŞTİ |  | aynı
COUT16 | e1c58ec5-9cee-505b-92d2-944c1def31e1 | 2 |  | passive | /GND |  | /GND | EŞLEŞTİ |  | aynı
COUT17 | 7fe5c74f-9da7-55c5-81b7-d48130c4e293 | 1 |  | passive | /VOUT |  | /VOUT | EŞLEŞTİ |  | aynı
COUT17 | 7fe5c74f-9da7-55c5-81b7-d48130c4e293 | 2 |  | passive | /GND |  | /GND | EŞLEŞTİ |  | aynı
COUT18 | 5091639b-aa82-59c1-bb7a-ac251f2faea7 | 1 |  | passive | /VOUT |  | /VOUT | EŞLEŞTİ |  | aynı
COUT18 | 5091639b-aa82-59c1-bb7a-ac251f2faea7 | 2 |  | passive | /GND |  | /GND | EŞLEŞTİ |  | aynı
COUT19 | 3cec971b-2a08-5fda-93c8-7a5661aaa192 | 1 |  | passive | /VOUT |  | /VOUT | EŞLEŞTİ |  | aynı
COUT19 | 3cec971b-2a08-5fda-93c8-7a5661aaa192 | 2 |  | passive | /GND |  | /GND | EŞLEŞTİ |  | aynı
COUT2 | 1a17f504-032e-43d7-b13b-985b8787bd06 | 1 |  | passive | /VOUT |  | /VOUT | EŞLEŞTİ |  | aynı
COUT2 | 1a17f504-032e-43d7-b13b-985b8787bd06 | 2 |  | passive | /GND |  | /GND | EŞLEŞTİ |  | aynı
COUT20 | e8731ba9-c4c8-53b9-b7c2-c3665a249d74 | 1 |  | passive | /VOUT |  | /VOUT | EŞLEŞTİ |  | aynı
COUT20 | e8731ba9-c4c8-53b9-b7c2-c3665a249d74 | 2 |  | passive | /GND |  | /GND | EŞLEŞTİ |  | aynı
COUT21 | ccf8ae34-dc20-5f54-aae5-5448fbf15c7f | 1 |  | passive | /VOUT |  | /VOUT | EŞLEŞTİ |  | aynı
COUT21 | ccf8ae34-dc20-5f54-aae5-5448fbf15c7f | 2 |  | passive | /GND |  | /GND | EŞLEŞTİ |  | aynı
COUT22 | ea901460-26e4-5a93-ab47-453fc6a4daaf | 1 |  | passive | /VOUT |  | /VOUT | EŞLEŞTİ |  | aynı
COUT22 | ea901460-26e4-5a93-ab47-453fc6a4daaf | 2 |  | passive | /GND |  | /GND | EŞLEŞTİ |  | aynı
COUT23 | bd7ded00-c962-5f19-9e15-3d90c19bc2b1 | 1 |  | passive | /VOUT |  | /VOUT | EŞLEŞTİ |  | aynı
COUT23 | bd7ded00-c962-5f19-9e15-3d90c19bc2b1 | 2 |  | passive | /GND |  | /GND | EŞLEŞTİ |  | aynı
COUT24 | f2cce2d4-e40c-58e5-987b-37f2ed02ab97 | 1 |  | passive | /VOUT |  | /VOUT | EŞLEŞTİ |  | aynı
COUT24 | f2cce2d4-e40c-58e5-987b-37f2ed02ab97 | 2 |  | passive | /GND |  | /GND | EŞLEŞTİ |  | aynı
COUT25 | 57380e16-a6f3-5bbc-bb10-dde9b6e6ffd1 | 1 |  | passive | /VOUT |  | /VOUT | EŞLEŞTİ |  | aynı
COUT25 | 57380e16-a6f3-5bbc-bb10-dde9b6e6ffd1 | 2 |  | passive | /GND |  | /GND | EŞLEŞTİ |  | aynı
COUT26 | 9b0088d6-de10-59b3-b619-c302c9a77e3d | 1 |  | passive | /VOUT |  | /VOUT | EŞLEŞTİ |  | aynı
COUT26 | 9b0088d6-de10-59b3-b619-c302c9a77e3d | 2 |  | passive | /GND |  | /GND | EŞLEŞTİ |  | aynı
COUT27 | c146af81-3f2b-52f0-b5f4-a836167963b8 | 1 |  | passive | /VOUT |  | /VOUT | EŞLEŞTİ |  | aynı
COUT27 | c146af81-3f2b-52f0-b5f4-a836167963b8 | 2 |  | passive | /GND |  | /GND | EŞLEŞTİ |  | aynı
COUT28 | 4350e23c-9503-5fe9-9f40-b4b180616cf7 | 1 |  | passive | /VOUT |  | /VOUT | EŞLEŞTİ |  | aynı
COUT28 | 4350e23c-9503-5fe9-9f40-b4b180616cf7 | 2 |  | passive | /GND |  | /GND | EŞLEŞTİ |  | aynı
COUT29 | e4ccbec2-22e3-5602-ae10-8d58ccf82c1e | 1 |  | passive | /VOUT |  | /VOUT | EŞLEŞTİ |  | aynı
COUT29 | e4ccbec2-22e3-5602-ae10-8d58ccf82c1e | 2 |  | passive | /GND |  | /GND | EŞLEŞTİ |  | aynı
COUT3 | 67a59ce1-0193-48f4-83f0-04e9b0ded655 | 1 |  | passive | /VOUT |  | /VOUT | EŞLEŞTİ |  | aynı
COUT3 | 67a59ce1-0193-48f4-83f0-04e9b0ded655 | 2 |  | passive | /GND |  | /GND | EŞLEŞTİ |  | aynı
COUT30 | 252555ba-c9c8-5193-b350-5ddf0b4ee88d | 1 |  | passive | /VOUT |  | /VOUT | EŞLEŞTİ |  | aynı
COUT30 | 252555ba-c9c8-5193-b350-5ddf0b4ee88d | 2 |  | passive | /GND |  | /GND | EŞLEŞTİ |  | aynı
COUT31 | 33ffa4f6-adcf-55c8-b135-1164d5995d7b | 1 |  | passive | /VOUT |  | /VOUT | EŞLEŞTİ |  | aynı
COUT31 | 33ffa4f6-adcf-55c8-b135-1164d5995d7b | 2 |  | passive | /GND |  | /GND | EŞLEŞTİ |  | aynı
COUT32 | fe326936-8f39-518c-9cdb-846a28b9c09c | 1 |  | passive | /VOUT |  | /VOUT | EŞLEŞTİ |  | aynı
COUT32 | fe326936-8f39-518c-9cdb-846a28b9c09c | 2 |  | passive | /GND |  | /GND | EŞLEŞTİ |  | aynı
COUT4 | afbd1ca4-fcd0-4732-9a6a-602220a79b7f | 1 |  | passive | /VOUT |  | /VOUT | EŞLEŞTİ |  | aynı
COUT4 | afbd1ca4-fcd0-4732-9a6a-602220a79b7f | 2 |  | passive | /GND |  | /GND | EŞLEŞTİ |  | aynı
COUT5 | e5e6d912-a4cd-461c-962a-0b4a129b03e2 | 1 |  | passive | /VOUT |  | /VOUT | EŞLEŞTİ |  | aynı
COUT5 | e5e6d912-a4cd-461c-962a-0b4a129b03e2 | 2 |  | passive | /GND |  | /GND | EŞLEŞTİ |  | aynı
COUT6 | 42ba3988-8ac2-4423-b3c5-29a442748000 | 1 |  | passive | /VOUT |  | /VOUT | EŞLEŞTİ |  | aynı
COUT6 | 42ba3988-8ac2-4423-b3c5-29a442748000 | 2 |  | passive | /GND |  | /GND | EŞLEŞTİ |  | aynı
COUT7 | d8521744-abc7-42a0-aec5-c64a7c7251b3 | 1 |  | passive | /VOUT |  | /VOUT | EŞLEŞTİ |  | aynı
COUT7 | d8521744-abc7-42a0-aec5-c64a7c7251b3 | 2 |  | passive | /GND |  | /GND | EŞLEŞTİ |  | aynı
COUT8 | 1754ead6-d4e3-48bc-8d4f-e1cc83ebafbd | 1 |  | passive | /VOUT |  | /VOUT | EŞLEŞTİ |  | aynı
COUT8 | 1754ead6-d4e3-48bc-8d4f-e1cc83ebafbd | 2 |  | passive | /GND |  | /GND | EŞLEŞTİ |  | aynı
COUT9 | 8e76eef0-b3ed-5cc8-90cb-8b7b2ebbe3bb | 1 |  | passive | /VOUT |  | /VOUT | EŞLEŞTİ |  | aynı
COUT9 | 8e76eef0-b3ed-5cc8-90cb-8b7b2ebbe3bb | 2 |  | passive | /GND |  | /GND | EŞLEŞTİ |  | aynı
CVCAP | 94572fa1-6f85-4646-83cb-bddd0f83f200 | 1 |  | passive | /VCAP |  | /VCAP | EŞLEŞTİ |  | aynı
CVCAP | 94572fa1-6f85-4646-83cb-bddd0f83f200 | 2 |  | passive | /ANODE |  | /ANODE | EŞLEŞTİ |  | aynı
CVCC1 | 6db75678-27de-4a6a-b7ea-1869f5f8f7d2 | 1 |  | passive | /VCC1 |  | /VCC1 | EŞLEŞTİ |  | aynı
CVCC1 | 6db75678-27de-4a6a-b7ea-1869f5f8f7d2 | 2 |  | passive | /GND |  | /GND | EŞLEŞTİ |  | aynı
CVCC2 | 85326ed1-c02b-43e1-b8cb-ad782541a156 | 1 |  | passive | /VCC2 |  | /VCC2 | EŞLEŞTİ |  | aynı
CVCC2 | 85326ed1-c02b-43e1-b8cb-ad782541a156 | 2 |  | passive | /GND |  | /GND | EŞLEŞTİ |  | aynı
CVDDA1 | dcce3706-a97a-46e8-b6bc-53df2d20cb94 | 1 |  | passive | /VDDA1 |  | /VDDA1 | EŞLEŞTİ |  | aynı
CVDDA1 | dcce3706-a97a-46e8-b6bc-53df2d20cb94 | 2 |  | passive | /GND |  | /GND | EŞLEŞTİ |  | aynı
CVDDA2 | 0911de64-d348-472b-bd62-b7bc89333c8b | 1 |  | passive | /VDDA2 |  | /VDDA2 | EŞLEŞTİ |  | aynı
CVDDA2 | 0911de64-d348-472b-bd62-b7bc89333c8b | 2 |  | passive | /GND |  | /GND | EŞLEŞTİ |  | aynı
C_AND | 0810c974-621f-517b-8ef0-c281b945030b | 1 |  | passive | /P5V_PROT |  | /P5V_PROT | EŞLEŞTİ |  | aynı
C_AND | 0810c974-621f-517b-8ef0-c281b945030b | 2 |  | passive | /GND |  | /GND | EŞLEŞTİ |  | aynı
C_CLR | 34b7983f-2a52-5238-844e-4aefaf7a6a4f | 1 |  | passive | /CLR_N |  | /CLR_N | EŞLEŞTİ |  | aynı
C_CLR | 34b7983f-2a52-5238-844e-4aefaf7a6a4f | 2 |  | passive | /GND |  | /GND | EŞLEŞTİ |  | aynı
C_CMP | 73757ad7-1cde-502f-94b9-b467685d242d | 1 |  | passive | /P5V_PROT |  | /P5V_PROT | EŞLEŞTİ |  | aynı
C_CMP | 73757ad7-1cde-502f-94b9-b467685d242d | 2 |  | passive | /GND |  | /GND | EŞLEŞTİ |  | aynı
C_INA1 | 96bfecf6-aa07-5261-8539-ec303899e231 | 1 |  | passive | /P5V_PROT |  | /P5V_PROT | EŞLEŞTİ |  | aynı
C_INA1 | 96bfecf6-aa07-5261-8539-ec303899e231 | 2 |  | passive | /GND |  | /GND | EŞLEŞTİ |  | aynı
C_INA2 | 6ca7d5b1-9ab4-5932-9249-7ae6f51194c9 | 1 |  | passive | /P5V_PROT |  | /P5V_PROT | EŞLEŞTİ |  | aynı
C_INA2 | 6ca7d5b1-9ab4-5932-9249-7ae6f51194c9 | 2 |  | passive | /GND |  | /GND | EŞLEŞTİ |  | aynı
C_ISO_VCAP | a992cecb-4c52-5826-bf5e-e038ceb5efa5 | 1 |  | passive | /ISO_VCAP |  | /ISO_VCAP | EŞLEŞTİ |  | aynı
C_ISO_VCAP | a992cecb-4c52-5826-bf5e-e038ceb5efa5 | 2 |  | passive | /VOUT |  | /VOUT | EŞLEŞTİ |  | aynı
C_ISO_VS | 8a5ab101-6654-5a6b-8776-f1fb1a423bf2 | 1 |  | passive | /VOUT |  | /VOUT | EŞLEŞTİ |  | aynı
C_ISO_VS | 8a5ab101-6654-5a6b-8776-f1fb1a423bf2 | 2 |  | passive | /GND |  | /GND | EŞLEŞTİ |  | aynı
C_LAT | da2a64fb-aff8-5f0d-810d-b9b8bcb66df1 | 1 |  | passive | /P5V_PROT |  | /P5V_PROT | EŞLEŞTİ |  | aynı
C_LAT | da2a64fb-aff8-5f0d-810d-b9b8bcb66df1 | 2 |  | passive | /GND |  | /GND | EŞLEŞTİ |  | aynı
C_LDO_DELAY | 80944538-37d0-565a-85f4-e041865ac2b7 | 1 |  | passive | /LDO_DELAY |  | /LDO_DELAY | EŞLEŞTİ |  | aynı
C_LDO_DELAY | 80944538-37d0-565a-85f4-e041865ac2b7 | 2 |  | passive | /GND |  | /GND | EŞLEŞTİ |  | aynı
C_LDO_IN | de7d2005-17a2-5c48-908b-3cc4557203de | 1 |  | passive | /VIN |  | /VIN | EŞLEŞTİ |  | aynı
C_LDO_IN | de7d2005-17a2-5c48-908b-3cc4557203de | 2 |  | passive | /GND |  | /GND | EŞLEŞTİ |  | aynı
C_LDO_OUT | d84f3960-b164-557b-9624-c68967df7333 | 1 |  | passive | /P5V_PROT |  | /P5V_PROT | EŞLEŞTİ |  | aynı
C_LDO_OUT | d84f3960-b164-557b-9624-c68967df7333 | 2 |  | passive | /GND |  | /GND | EŞLEŞTİ |  | aynı
C_OCC1 | c68b3a5e-94cd-5da7-ac0a-335890097353 | 1 |  | passive | /P5V_PROT |  | /P5V_PROT | EŞLEŞTİ |  | aynı
C_OCC1 | c68b3a5e-94cd-5da7-ac0a-335890097353 | 2 |  | passive | /GND |  | /GND | EŞLEŞTİ |  | aynı
C_OCC2 | c9d8e443-328b-54ad-8b7b-2aab6073ee90 | 1 |  | passive | /P5V_PROT |  | /P5V_PROT | EŞLEŞTİ |  | aynı
C_OCC2 | c9d8e443-328b-54ad-8b7b-2aab6073ee90 | 2 |  | passive | /GND |  | /GND | EŞLEŞTİ |  | aynı
C_REF_IN | f4d576f4-cf5d-5ac6-96ae-598ae34e9b05 | 1 |  | passive | /P5V_PROT |  | /P5V_PROT | EŞLEŞTİ |  | aynı
C_REF_IN | f4d576f4-cf5d-5ac6-96ae-598ae34e9b05 | 2 |  | passive | /GND |  | /GND | EŞLEŞTİ |  | aynı
C_REF_NR | 486c20a6-fd8b-5265-9deb-9848b8d95456 | 1 |  | passive | /REF_NR |  | /REF_NR | EŞLEŞTİ |  | aynı
C_REF_NR | 486c20a6-fd8b-5265-9deb-9848b8d95456 | 2 |  | passive | /GND |  | /GND | EŞLEŞTİ |  | aynı
C_REF_OUT | f23f42c0-2803-5f67-b7a9-5c5abdd96e33 | 1 |  | passive | /OVP_REF |  | /OVP_REF | EŞLEŞTİ |  | aynı
C_REF_OUT | f23f42c0-2803-5f67-b7a9-5c5abdd96e33 | 2 |  | passive | /GND |  | /GND | EŞLEŞTİ |  | aynı
D1 | 10916161-3186-4d96-bd46-7b07bca57dbc | 1 | K_1 | passive | /VIN |  | /VIN | EŞLEŞTİ |  | aynı
D1 | 10916161-3186-4d96-bd46-7b07bca57dbc | 2 | A_2 | passive | /GND |  | /GND | EŞLEŞTİ |  | aynı
D2 | 20029f54-cf88-4269-8257-26ffb89ea471 | 1 | K_1 | passive | /O1_11V |  | /O1_11V | EŞLEŞTİ |  | aynı
D2 | 20029f54-cf88-4269-8257-26ffb89ea471 | 2 | A_2 | passive | /GND |  | /GND | EŞLEŞTİ |  | aynı
D3 | 08c61090-e511-4a2b-aead-47ffab069ef4 | 1 | K_1 | passive | /S2E_11V |  | /S2E_11V | EŞLEŞTİ |  | aynı
D3 | 08c61090-e511-4a2b-aead-47ffab069ef4 | 2 | A_2 | passive | /GND |  | /GND | EŞLEŞTİ |  | aynı
D_REV1 | 3e97eb54-0b2c-5d95-955c-c98ae775d8d4 | 1 | K_1 | passive | /VSAFE |  | /VSAFE | EŞLEŞTİ |  | aynı
D_REV1 | 3e97eb54-0b2c-5d95-955c-c98ae775d8d4 | 2 | A_2 | passive | /O1_11V |  | /O1_11V | EŞLEŞTİ |  | aynı
D_REV2 | 29812f06-d76d-544a-b2e6-9c725254f13c | 1 | K_1 | passive | /VSAFE |  | /VSAFE | EŞLEŞTİ |  | aynı
D_REV2 | 29812f06-d76d-544a-b2e6-9c725254f13c | 2 | A_2 | passive | /S2E_11V |  | /S2E_11V | EŞLEŞTİ |  | aynı
J1 | 20e845ef-7d58-469e-a2ee-36828fd934bc | 1 | Pin_1_1 | passive | /ANODE |  | /ANODE | EŞLEŞTİ |  | aynı
J1 | 20e845ef-7d58-469e-a2ee-36828fd934bc | 2 | Pin_2_2 | passive | /GND |  | /GND | EŞLEŞTİ |  | aynı
J2 | 506c41c2-e3e4-4a24-b087-ef586ac4743b | 1 | Pin_1_1 | passive | /O1_11V |  | /O1_11V | EŞLEŞTİ |  | aynı
J2 | 506c41c2-e3e4-4a24-b087-ef586ac4743b | 2 | Pin_2_2 | passive | /GND |  | /GND | EŞLEŞTİ |  | aynı
J3 | 5f78bc69-0327-4195-93e7-06e0cef05607 | 1 | Pin_1_1 | passive | /S2E_11V |  | /S2E_11V | EŞLEŞTİ |  | aynı
J3 | 5f78bc69-0327-4195-93e7-06e0cef05607 | 2 | Pin_2_2 | passive | /GND |  | /GND | EŞLEŞTİ |  | aynı
JP_EN_BUCK | 7290e273-819f-536b-8b3d-c1e07c5c213c | 1 | A_1 | passive | /EN_BUCK |  | /EN_BUCK | EŞLEŞTİ |  | aynı
JP_EN_BUCK | 7290e273-819f-536b-8b3d-c1e07c5c213c | 2 | B_2 | passive | /GND |  | /GND | EŞLEŞTİ |  | aynı
J_OVP_INJ_BUS | 5df9443a-819f-58e2-8aab-1ff53a8cb9a2 | 1 | Pin_1_1 | passive | /VOUT |  | /VOUT | EŞLEŞTİ |  | aynı
J_OVP_INJ_BUS | 5df9443a-819f-58e2-8aab-1ff53a8cb9a2 | 2 | Pin_2_2 | passive | /GND |  | /GND | EŞLEŞTİ |  | aynı
L1 | c9b7d298-ea93-4a03-a4df-bc5902f51112 | 1 | 1_1 | passive | /SW_PH1 |  | /SW_PH1 | EŞLEŞTİ |  | aynı
L1 | c9b7d298-ea93-4a03-a4df-bc5902f51112 | 2 | 2_2 | passive | /ISNS1 |  | /ISNS1 | EŞLEŞTİ |  | aynı
L2 | 06a61ebd-c41d-4ac2-8899-fcec4e6db007 | 1 | 1_1 | passive | /SW_PH2 |  | /SW_PH2 | EŞLEŞTİ |  | aynı
L2 | 06a61ebd-c41d-4ac2-8899-fcec4e6db007 | 2 | 2_2 | passive | /ISNS2 |  | /ISNS2 | EŞLEŞTİ |  | aynı
Q1 | 0f0c970f-ff43-4dbd-80b0-fea6aabc4100 | 1 | S_1 | passive | /ANODE |  | /ANODE | EŞLEŞTİ |  | aynı
Q1 | 0f0c970f-ff43-4dbd-80b0-fea6aabc4100 | 2 | S_2 | passive | /ANODE |  | /ANODE | EŞLEŞTİ |  | aynı
Q1 | 0f0c970f-ff43-4dbd-80b0-fea6aabc4100 | 3 | S_3 | passive | /ANODE |  | /ANODE | EŞLEŞTİ |  | aynı
Q1 | 0f0c970f-ff43-4dbd-80b0-fea6aabc4100 | 4 | G_4 | input | /GATE |  | /GATE | EŞLEŞTİ |  | aynı
Q1 | 0f0c970f-ff43-4dbd-80b0-fea6aabc4100 | 5 | D_5 | passive | /VIN |  | /VIN | EŞLEŞTİ |  | aynı
Q2 | 55ba1f34-6573-5f85-8fbd-bcd309c21384 | 1 | S_1 | passive | /VSAFE |  | /VSAFE | EŞLEŞTİ |  | aynı
Q2 | 55ba1f34-6573-5f85-8fbd-bcd309c21384 | 2 | S_2 | passive | /VSAFE |  | /VSAFE | EŞLEŞTİ |  | aynı
Q2 | 55ba1f34-6573-5f85-8fbd-bcd309c21384 | 3 | S_3 | passive | /VSAFE |  | /VSAFE | EŞLEŞTİ |  | aynı
Q2 | 55ba1f34-6573-5f85-8fbd-bcd309c21384 | 4 | G_4 | input | /ISO_GATE |  | /ISO_GATE | EŞLEŞTİ |  | aynı
Q2 | 55ba1f34-6573-5f85-8fbd-bcd309c21384 | 5 | D_5 | passive | /VOUT |  | /VOUT | EŞLEŞTİ |  | aynı
RBOOT1 | 9bef5fd8-07fe-4d86-a608-95087865d03c | 1 |  | passive | /CBOOT_R1 |  | /CBOOT_R1 | EŞLEŞTİ |  | aynı
RBOOT1 | 9bef5fd8-07fe-4d86-a608-95087865d03c | 2 |  | passive | /CBOOT1 |  | /CBOOT1 | EŞLEŞTİ |  | aynı
RBOOT2 | 4dde3712-873e-410e-95d1-0ae20f919f0a | 1 |  | passive | /CBOOT_R2 |  | /CBOOT_R2 | EŞLEŞTİ |  | aynı
RBOOT2 | 4dde3712-873e-410e-95d1-0ae20f919f0a | 2 |  | passive | /CBOOT2 |  | /CBOOT2 | EŞLEŞTİ |  | aynı
RCFG1 | 14ebb545-9cab-4f74-a36f-1ea12ad14a0e | 1 |  | passive | /CFG_PRI |  | /CFG_PRI | EŞLEŞTİ |  | aynı
RCFG1 | 14ebb545-9cab-4f74-a36f-1ea12ad14a0e | 2 |  | passive | /GND |  | /GND | EŞLEŞTİ |  | aynı
RCFG2 | 017cc98e-4d09-4e6e-832c-be36964edbb7 | 1 |  | passive | /CFG_SEC |  | /CFG_SEC | EŞLEŞTİ |  | aynı
RCFG2 | 017cc98e-4d09-4e6e-832c-be36964edbb7 | 2 |  | passive | /GND |  | /GND | EŞLEŞTİ |  | aynı
RCOMP | cfd0f2c0-6625-48e3-aa48-37bc54169ba2 | 1 |  | passive | /COMP |  | /COMP | EŞLEŞTİ |  | aynı
RCOMP | cfd0f2c0-6625-48e3-aa48-37bc54169ba2 | 2 |  | passive | /COMP_MID |  | /COMP_MID | EŞLEŞTİ |  | aynı
REN1 | 279e4ae7-7e3e-4001-8e0c-32e6175ed71d | 1 |  | passive | /VSAFE |  | /VSAFE | EŞLEŞTİ |  | aynı
REN1 | 279e4ae7-7e3e-4001-8e0c-32e6175ed71d | 2 |  | passive | /EN_EFUSE |  | /EN_EFUSE | EŞLEŞTİ |  | aynı
REN2 | b230726e-f647-4bf5-85da-6da3f1ab3b29 | 1 |  | passive | /EN_EFUSE |  | /EN_EFUSE | EŞLEŞTİ |  | aynı
REN2 | b230726e-f647-4bf5-85da-6da3f1ab3b29 | 2 |  | passive | /GND |  | /GND | EŞLEŞTİ |  | aynı
RFB1 | 36ce6baa-4890-41d3-9e26-ec3b2cb04670 | 1 |  | passive | /FB_INJ |  | /FB_INJ | EŞLEŞTİ |  | aynı
RFB1 | 36ce6baa-4890-41d3-9e26-ec3b2cb04670 | 2 |  | passive | /FB |  | /FB | EŞLEŞTİ |  | aynı
RFB2 | 78657b23-2ca8-4bcb-b779-2c209b88d82e | 1 |  | passive | /FB |  | /FB | EŞLEŞTİ |  | aynı
RFB2 | 78657b23-2ca8-4bcb-b779-2c209b88d82e | 2 |  | passive | /FB_TRIM |  | /FB_TRIM | EŞLEŞTİ |  | aynı
RILIM1 | 71c13e6b-afc3-44a6-8298-a5d198a9de63 | 1 |  | passive | /ILIM_O1 |  | /ILIM_O1 | EŞLEŞTİ |  | aynı
RILIM1 | 71c13e6b-afc3-44a6-8298-a5d198a9de63 | 2 |  | passive | /GND |  | /GND | EŞLEŞTİ |  | aynı
RILIM2 | c148e03b-1ad6-4dda-be4c-5508bd7561b6 | 1 |  | passive | /ILIM_S2E |  | /ILIM_S2E | EŞLEŞTİ |  | aynı
RILIM2 | c148e03b-1ad6-4dda-be4c-5508bd7561b6 | 2 |  | passive | /GND |  | /GND | EŞLEŞTİ |  | aynı
RIMON1 | 993af393-eae1-4bcc-b253-b32a7f4ff4a2 | 1 |  | passive | /IMON_O1 |  | /IMON_O1 | EŞLEŞTİ |  | aynı
RIMON1 | 993af393-eae1-4bcc-b253-b32a7f4ff4a2 | 2 |  | passive | /GND |  | /GND | EŞLEŞTİ |  | aynı
RIMON2 | e14a5130-c472-41ae-bef6-c561514cd53f | 1 |  | passive | /IMON_S2E |  | /IMON_S2E | EŞLEŞTİ |  | aynı
RIMON2 | e14a5130-c472-41ae-bef6-c561514cd53f | 2 |  | passive | /GND |  | /GND | EŞLEŞTİ |  | aynı
RPG1 | 99fad3fa-83be-4dba-adbc-58ae0faeac2b | 1 |  | passive | /PG_O1 |  | /PG_O1 | EŞLEŞTİ |  | aynı
RPG1 | 99fad3fa-83be-4dba-adbc-58ae0faeac2b | 2 |  | passive | /O1_11V |  | /O1_11V | EŞLEŞTİ |  | aynı
RPG1B | 06c15327-f2c1-4550-adc0-5b5a31ebd438 | 1 |  | passive | /PG_O1 |  | /PG_O1 | EŞLEŞTİ |  | aynı
RPG1B | 06c15327-f2c1-4550-adc0-5b5a31ebd438 | 2 |  | passive | /GND |  | /GND | EŞLEŞTİ |  | aynı
RPG2 | 771a53e1-b7d3-4f4d-a030-18d05f038f42 | 1 |  | passive | /PG_S2E |  | /PG_S2E | EŞLEŞTİ |  | aynı
RPG2 | 771a53e1-b7d3-4f4d-a030-18d05f038f42 | 2 |  | passive | /S2E_11V |  | /S2E_11V | EŞLEŞTİ |  | aynı
RPG2B | 828471af-c7b8-4493-b643-cd1c89057a7b | 1 |  | passive | /PG_S2E |  | /PG_S2E | EŞLEŞTİ |  | aynı
RPG2B | 828471af-c7b8-4493-b643-cd1c89057a7b | 2 |  | passive | /GND |  | /GND | EŞLEŞTİ |  | aynı
RRAWBL | be59d81a-e403-5335-93b9-9f5f7f673b24 | 1 |  | passive | /VOUT |  | /VOUT | EŞLEŞTİ |  | aynı
RRAWBL | be59d81a-e403-5335-93b9-9f5f7f673b24 | 2 |  | passive | /GND |  | /GND | EŞLEŞTİ |  | aynı
RS1 | 6367fad5-cac2-4c9a-b1a5-9fd12778f612 | 1 |  | passive | /ISNS1 |  | /ISNS1 | EŞLEŞTİ |  | aynı
RS1 | 6367fad5-cac2-4c9a-b1a5-9fd12778f612 | 2 |  | passive | /VOUT |  | /VOUT | EŞLEŞTİ |  | aynı
RS2 | 62510d85-78c5-4f56-9007-26fcef05c8c1 | 1 |  | passive | /ISNS2 |  | /ISNS2 | EŞLEŞTİ |  | aynı
RS2 | 62510d85-78c5-4f56-9007-26fcef05c8c1 | 2 |  | passive | /VOUT |  | /VOUT | EŞLEŞTİ |  | aynı
RSYNC | 6d715b06-314b-44a8-941d-cc5ec3e62997 | 1 |  | passive | /SYNC |  | /SYNC | EŞLEŞTİ |  | aynı
RSYNC | 6d715b06-314b-44a8-941d-cc5ec3e62997 | 2 |  | passive | /VDDA1 |  | /VDDA1 | EŞLEŞTİ |  | aynı
RT1 | ba79bbc5-b925-4847-a040-2fa972a6ff81 | 1 |  | passive | /RT_PH1 |  | /RT_PH1 | EŞLEŞTİ |  | aynı
RT1 | ba79bbc5-b925-4847-a040-2fa972a6ff81 | 2 |  | passive | /GND |  | /GND | EŞLEŞTİ |  | aynı
RT2 | a08b472b-1aef-4a43-9a54-97f28b2ce8e5 | 1 |  | passive | /RT_PH2 |  | /RT_PH2 | EŞLEŞTİ |  | aynı
RT2 | a08b472b-1aef-4a43-9a54-97f28b2ce8e5 | 2 |  | passive | /GND |  | /GND | EŞLEŞTİ |  | aynı
RUV1 | d29799e1-2c22-4d3d-9d66-363ced450d9b | 1 |  | passive | /VIN |  | /VIN | EŞLEŞTİ |  | aynı
RUV1 | d29799e1-2c22-4d3d-9d66-363ced450d9b | 2 |  | passive | /EN_BUCK |  | /EN_BUCK | EŞLEŞTİ |  | aynı
RUV2 | 7a9db7f4-4dc9-4c9d-bd4f-12bc786e2dd1 | 1 |  | passive | /EN_BUCK |  | /EN_BUCK | EŞLEŞTİ |  | aynı
RUV2 | 7a9db7f4-4dc9-4c9d-bd4f-12bc786e2dd1 | 2 |  | passive | /GND |  | /GND | EŞLEŞTİ |  | aynı
R_BL5 | 1bd3d882-f8d8-56fc-9ec7-f46144cbbe07 | 1 |  | passive | /P5V_PROT |  | /P5V_PROT | EŞLEŞTİ |  | aynı
R_BL5 | 1bd3d882-f8d8-56fc-9ec7-f46144cbbe07 | 2 |  | passive | /GND |  | /GND | EŞLEŞTİ |  | aynı
R_BLS | 0f05b1cf-efbb-5182-b83a-a01f82f1d3d8 | 1 |  | passive | /VSAFE |  | /VSAFE | EŞLEŞTİ |  | aynı
R_BLS | 0f05b1cf-efbb-5182-b83a-a01f82f1d3d8 | 2 |  | passive | /GND |  | /GND | EŞLEŞTİ |  | aynı
R_CLR | 21720a98-c2f4-56eb-9328-dd66465a3ac8 | 1 |  | passive | /P5V_PROT |  | /P5V_PROT | EŞLEŞTİ |  | aynı
R_CLR | 21720a98-c2f4-56eb-9328-dd66465a3ac8 | 2 |  | passive | /CLR_N |  | /CLR_N | EŞLEŞTİ |  | aynı
R_EN1 | 1b1c0e56-1244-5be0-81fc-09263785321b | 1 |  | passive | /P5V_PROT |  | /P5V_PROT | EŞLEŞTİ |  | aynı
R_EN1 | 1b1c0e56-1244-5be0-81fc-09263785321b | 2 |  | passive | /ISO_EN |  | /ISO_EN | EŞLEŞTİ |  | aynı
R_EN2 | 13ebdc34-324d-58ad-b119-9f3938f325d2 | 1 |  | passive | /ISO_EN |  | /ISO_EN | EŞLEŞTİ |  | aynı
R_EN2 | 13ebdc34-324d-58ad-b119-9f3938f325d2 | 2 |  | passive | /GND |  | /GND | EŞLEŞTİ |  | aynı
R_GS | b711e5dd-e2b0-5674-a577-2a2066ee1201 | 1 |  | passive | /ISO_GATE |  | /ISO_GATE | EŞLEŞTİ |  | aynı
R_GS | b711e5dd-e2b0-5674-a577-2a2066ee1201 | 2 |  | passive | /VSAFE |  | /VSAFE | EŞLEŞTİ |  | aynı
R_INJ | 6d090199-0adb-5bd3-8a0b-c0d1e337a483 | 1 |  | passive | /VOUT |  | /VOUT | EŞLEŞTİ |  | aynı
R_INJ | 6d090199-0adb-5bd3-8a0b-c0d1e337a483 | 2 |  | passive | /FB_INJ |  | /FB_INJ | EŞLEŞTİ |  | aynı
R_OCB | 224d06c0-054e-57bb-aa92-cfc835e12e1c | 1 |  | passive | /OC_REF |  | /OC_REF | EŞLEŞTİ |  | aynı
R_OCB | 224d06c0-054e-57bb-aa92-cfc835e12e1c | 2 |  | passive | /GND |  | /GND | EŞLEŞTİ |  | aynı
R_OCT | c6281f55-6ba1-5fc0-9791-15a7fe07a4de | 1 |  | passive | /OVP_REF |  | /OVP_REF | EŞLEŞTİ |  | aynı
R_OCT | c6281f55-6ba1-5fc0-9791-15a7fe07a4de | 2 |  | passive | /OC_REF |  | /OC_REF | EŞLEŞTİ |  | aynı
R_OV2B | 4b384d53-78a5-548b-b26d-104f6eb666d8 | 1 |  | passive | /ISO_OV |  | /ISO_OV | EŞLEŞTİ |  | aynı
R_OV2B | 4b384d53-78a5-548b-b26d-104f6eb666d8 | 2 |  | passive | /GND |  | /GND | EŞLEŞTİ |  | aynı
R_OV2T | 62b32dc4-3179-5623-9440-d71315ba57b8 | 1 |  | passive | /VOUT |  | /VOUT | EŞLEŞTİ |  | aynı
R_OV2T | 62b32dc4-3179-5623-9440-d71315ba57b8 | 2 |  | passive | /ISO_OV |  | /ISO_OV | EŞLEŞTİ |  | aynı
R_OVB | d1a5cfd6-3af5-514f-bc17-03433c87dcce | 1 |  | passive | /OVP_SENSE |  | /OVP_SENSE | EŞLEŞTİ |  | aynı
R_OVB | d1a5cfd6-3af5-514f-bc17-03433c87dcce | 2 |  | passive | /GND |  | /GND | EŞLEŞTİ |  | aynı
R_OVT | d53edf63-73d4-5b9b-b412-f335de5e8c45 | 1 |  | passive | /VOUT |  | /VOUT | EŞLEŞTİ |  | aynı
R_OVT | d53edf63-73d4-5b9b-b412-f335de5e8c45 | 2 |  | passive | /OVP_SENSE |  | /OVP_SENSE | EŞLEŞTİ |  | aynı
R_Q | 02712b39-b84a-5a2f-88f2-43418b22579d | 1 |  | passive | /OVP_Q |  | /OVP_Q | EŞLEŞTİ |  | aynı
R_Q | 02712b39-b84a-5a2f-88f2-43418b22579d | 2 |  | passive | /ISO_OV |  | /ISO_OV | EŞLEŞTİ |  | aynı
R_TRIM | 6ceb940e-4fbe-5382-90fb-550609a00357 | 1 |  | passive | /FB_TRIM |  | /FB_TRIM | EŞLEŞTİ |  | aynı
R_TRIM | 6ceb940e-4fbe-5382-90fb-550609a00357 | 2 |  | passive | /GND |  | /GND | EŞLEŞTİ |  | aynı
SW1 | 5ad2815e-0181-5bb5-8c4c-d93379e97efe | 1 | 1_1 | passive | /CLR_N |  | /CLR_N | EŞLEŞTİ |  | aynı
SW1 | 5ad2815e-0181-5bb5-8c4c-d93379e97efe | 2 | 2_2 | passive | /GND |  | /GND | EŞLEŞTİ |  | aynı
TP_ANODE | e5758944-6cb0-50ac-be0c-9ee77decc0d6 | 1 | 1_1 | passive | /ANODE |  | /ANODE | EŞLEŞTİ |  | aynı
TP_CLR_N | b5d99968-c6ce-5119-b952-e95ef383fa39 | 1 | 1_1 | passive | /CLR_N |  | /CLR_N | EŞLEŞTİ |  | aynı
TP_COMP | 72b9debb-d90d-5c6c-ab28-274f9478da68 | 1 | 1_1 | passive | /COMP |  | /COMP | EŞLEŞTİ |  | aynı
TP_EN_BUCK | 2d0b80a9-19a6-57a7-af68-0a6f8fb6424e | 1 | 1_1 | passive | /EN_BUCK |  | /EN_BUCK | EŞLEŞTİ |  | aynı
TP_FB_INJ_A | 404536b7-cb98-5284-a334-84187c00cf75 | 1 | 1_1 | passive | /VOUT |  | /VOUT | EŞLEŞTİ |  | aynı
TP_FB_INJ_B | 41ee23d4-4191-5b55-bd63-77ac22b9e2c0 | 1 | 1_1 | passive | /FB_INJ |  | /FB_INJ | EŞLEŞTİ |  | aynı
TP_GND_FB | b3168321-0637-5e68-b2b3-b29706d9ef20 | 1 | 1_1 | passive | /GND |  | /GND | EŞLEŞTİ |  | aynı
TP_GND_OC | def50133-a200-52a1-82e5-bce347fe8ead | 1 | 1_1 | passive | /GND |  | /GND | EŞLEŞTİ |  | aynı
TP_GND_OVP | ae13e884-09e7-5886-9bf1-546c18ea0724 | 1 | 1_1 | passive | /GND |  | /GND | EŞLEŞTİ |  | aynı
TP_GND_POWER | f0ba02a4-4b68-5d4e-878b-3bf59669349f | 1 | 1_1 | passive | /GND |  | /GND | EŞLEŞTİ |  | aynı
TP_IMON_O1 | f7296ee2-2a49-52b5-a62d-693d64d3dbcc | 1 | 1_1 | passive | /IMON_O1 |  | /IMON_O1 | EŞLEŞTİ |  | aynı
TP_IMON_S2E | 9701655e-a7cd-5921-9a82-61fab1bf3ed8 | 1 | 1_1 | passive | /IMON_S2E |  | /IMON_S2E | EŞLEŞTİ |  | aynı
TP_ISNS1N | 05f1c07f-25fb-5d81-9272-f6b76c881a4a | 1 | 1_1 | passive | /VOUT |  | /VOUT | EŞLEŞTİ |  | aynı
TP_ISNS1P | 10877342-e72e-5f80-93b8-909ba7a55f93 | 1 | 1_1 | passive | /ISNS1 |  | /ISNS1 | EŞLEŞTİ |  | aynı
TP_ISNS2N | cf858b7a-d84d-5c81-ac62-3aa023e863b7 | 1 | 1_1 | passive | /VOUT |  | /VOUT | EŞLEŞTİ |  | aynı
TP_ISNS2P | f6d1bbef-1433-5dc2-a687-3b99fcf158ec | 1 | 1_1 | passive | /ISNS2 |  | /ISNS2 | EŞLEŞTİ |  | aynı
TP_ISO_GATE | 05c99a76-ee51-5bd4-9c2d-a33b8ea5e8e7 | 1 | 1_1 | passive | /ISO_GATE |  | /ISO_GATE | EŞLEŞTİ |  | aynı
TP_ISO_OV | b8ccfdfa-7619-5cca-8847-ff5891eab295 | 1 | 1_1 | passive | /ISO_OV |  | /ISO_OV | EŞLEŞTİ |  | aynı
TP_O1 | 2706f82a-b68e-5a96-b4fc-4121a27c4c21 | 1 | 1_1 | passive | /O1_11V |  | /O1_11V | EŞLEŞTİ |  | aynı
TP_OC_REF | 374e940f-26b6-55a0-96d6-5934661dc214 | 1 | 1_1 | passive | /OC_REF |  | /OC_REF | EŞLEŞTİ |  | aynı
TP_OC_SENSE1 | 2790c7d4-5ac2-5cce-ae6c-55f5b8269d8f | 1 | 1_1 | passive | /OC_SENSE1 |  | /OC_SENSE1 | EŞLEŞTİ |  | aynı
TP_OC_SENSE2 | 6264a018-3b45-5f51-9355-85d9cd5baf8f | 1 | 1_1 | passive | /OC_SENSE2 |  | /OC_SENSE2 | EŞLEŞTİ |  | aynı
TP_OVP_BUS_N | fedb15b7-8edb-5e40-87d9-c12134355361 | 1 | 1_1 | passive | /OVP_BUS_N |  | /OVP_BUS_N | EŞLEŞTİ |  | aynı
TP_OVP_Q | d2d3692a-0a65-58c4-aec3-033e9b2a8021 | 1 | 1_1 | passive | /OVP_Q |  | /OVP_Q | EŞLEŞTİ |  | aynı
TP_OVP_REF | d252490e-6ec5-5bd2-ba42-15a686e9b861 | 1 | 1_1 | passive | /OVP_REF |  | /OVP_REF | EŞLEŞTİ |  | aynı
TP_OVP_SENSE | 1f2ab6d7-5ffb-5f27-90e5-2246fec22987 | 1 | 1_1 | passive | /OVP_SENSE |  | /OVP_SENSE | EŞLEŞTİ |  | aynı
TP_OVP_TRIP_N | 33eadb52-ed06-5d70-bae9-450bca55b211 | 1 | 1_1 | passive | /OVP_TRIP_N |  | /OVP_TRIP_N | EŞLEŞTİ |  | aynı
TP_P5V | ce1ae3f8-91b8-5ff9-be8b-55af4edb02e1 | 1 | 1_1 | passive | /P5V_PROT |  | /P5V_PROT | EŞLEŞTİ |  | aynı
TP_PG_O1 | 5741d4a6-d320-58e9-9dca-b36f6e44b285 | 1 | 1_1 | passive | /PG_O1 |  | /PG_O1 | EŞLEŞTİ |  | aynı
TP_PG_S2E | e7da7e40-11b3-573d-a138-bdc8f323dc68 | 1 | 1_1 | passive | /PG_S2E |  | /PG_S2E | EŞLEŞTİ |  | aynı
TP_S2E | 61beb8bc-bf70-52a2-991c-70f6e3fda497 | 1 | 1_1 | passive | /S2E_11V |  | /S2E_11V | EŞLEŞTİ |  | aynı
TP_SW1 | 52e89f00-ead4-5da3-a8bc-ab0bc9140bab | 1 | 1_1 | passive | /SW_PH1 |  | /SW_PH1 | EŞLEŞTİ |  | aynı
TP_SW2 | 47e94605-1f39-5512-bed6-fdfdaa11007d | 1 | 1_1 | passive | /SW_PH2 |  | /SW_PH2 | EŞLEŞTİ |  | aynı
TP_VIN | 6c4714a4-4bcd-5ded-83ca-9989f5fcb0d0 | 1 | 1_1 | passive | /VIN |  | /VIN | EŞLEŞTİ |  | aynı
TP_VOUT | 6a49cd0c-df91-5780-980c-77b3639019e9 | 1 | 1_1 | passive | /VOUT |  | /VOUT | EŞLEŞTİ |  | aynı
TP_VSAFE | 6198e1b2-19bc-515b-9176-e829b17729e8 | 1 | 1_1 | passive | /VSAFE |  | /VSAFE | EŞLEŞTİ |  | aynı
U1 | 1a457d03-3f41-4328-a962-7ac81fa98011 | 1 | VIN4_1 | power_in | /VIN |  | /VIN | EŞLEŞTİ |  | aynı
U1 | 1a457d03-3f41-4328-a962-7ac81fa98011 | 2 | VIN5_2 | power_in | /VIN |  | /VIN | EŞLEŞTİ |  | aynı
U1 | 1a457d03-3f41-4328-a962-7ac81fa98011 | 3 | VIN6_3 | power_in | /VIN |  | /VIN | EŞLEŞTİ |  | aynı
U1 | 1a457d03-3f41-4328-a962-7ac81fa98011 | 4 | CBOOT_4 | passive | /CBOOT1 |  | /CBOOT1 | EŞLEŞTİ |  | aynı
U1 | 1a457d03-3f41-4328-a962-7ac81fa98011 | 5 | SW4_5 | passive | /SW4_PH1 |  | /SW4_PH1 | EŞLEŞTİ |  | aynı
U1 | 1a457d03-3f41-4328-a962-7ac81fa98011 | 6 | BIAS_6 | passive | /GND |  | /GND | EŞLEŞTİ |  | aynı
U1 | 1a457d03-3f41-4328-a962-7ac81fa98011 | 7 | PG/SYNCOUT_7 | open_collector | /SYNC |  | /SYNC | EŞLEŞTİ |  | aynı
U1 | 1a457d03-3f41-4328-a962-7ac81fa98011 | 8 | PFM/SYNCIN_8 | input | /GND |  | /GND | EŞLEŞTİ |  | aynı
U1 | 1a457d03-3f41-4328-a962-7ac81fa98011 | 9 | EN/UVLO_9 | input | /EN_BUCK |  | /EN_BUCK | EŞLEŞTİ |  | aynı
U1 | 1a457d03-3f41-4328-a962-7ac81fa98011 | 10 | NC_10 | no_connect | unconnected-(U1-NC-Pad10) | kasıtlı NC | unconnected-(U1-NC-Pad10) | EŞLEŞTİ |  | aynı
U1 | 1a457d03-3f41-4328-a962-7ac81fa98011 | 11 | ISNS+_11 | input | /ISNS1 |  | /ISNS1 | EŞLEŞTİ |  | aynı
U1 | 1a457d03-3f41-4328-a962-7ac81fa98011 | 12 | VOUT_12 | input | /VOUT |  | /VOUT | EŞLEŞTİ |  | aynı
U1 | 1a457d03-3f41-4328-a962-7ac81fa98011 | 13 | CONFIG_13 | input | /CFG_PRI |  | /CFG_PRI | EŞLEŞTİ |  | aynı
U1 | 1a457d03-3f41-4328-a962-7ac81fa98011 | 14 | RT_14 | input | /RT_PH1 |  | /RT_PH1 | EŞLEŞTİ |  | aynı
U1 | 1a457d03-3f41-4328-a962-7ac81fa98011 | 15 | EXTCOMP_15 | passive | /COMP |  | /COMP | EŞLEŞTİ |  | aynı
U1 | 1a457d03-3f41-4328-a962-7ac81fa98011 | 16 | FB_16 | input | /FB |  | /FB | EŞLEŞTİ |  | aynı
U1 | 1a457d03-3f41-4328-a962-7ac81fa98011 | 17 | AGND_17 | power_in | /GND |  | /GND | EŞLEŞTİ |  | aynı
U1 | 1a457d03-3f41-4328-a962-7ac81fa98011 | 18 | VDDA_18 | power_out | /VDDA1 |  | /VDDA1 | EŞLEŞTİ |  | aynı
U1 | 1a457d03-3f41-4328-a962-7ac81fa98011 | 19 | VCC_19 | power_out | /VCC1 |  | /VCC1 | EŞLEŞTİ |  | aynı
U1 | 1a457d03-3f41-4328-a962-7ac81fa98011 | 20 | SW1_20 | passive | /SW_PH1 |  | /SW_PH1 | EŞLEŞTİ |  | aynı
U1 | 1a457d03-3f41-4328-a962-7ac81fa98011 | 21 | SW2_21 | passive | /SW_PH1 |  | /SW_PH1 | EŞLEŞTİ |  | aynı
U1 | 1a457d03-3f41-4328-a962-7ac81fa98011 | 22 | SW3_22 | passive | /SW_PH1 |  | /SW_PH1 | EŞLEŞTİ |  | aynı
U1 | 1a457d03-3f41-4328-a962-7ac81fa98011 | 23 | PGND1_23 | power_in | /GND |  | /GND | EŞLEŞTİ |  | aynı
U1 | 1a457d03-3f41-4328-a962-7ac81fa98011 | 24 | PGND2_24 | power_in | /GND |  | /GND | EŞLEŞTİ |  | aynı
U1 | 1a457d03-3f41-4328-a962-7ac81fa98011 | 25 | PGND3_25 | power_in | /GND |  | /GND | EŞLEŞTİ |  | aynı
U1 | 1a457d03-3f41-4328-a962-7ac81fa98011 | 26 | PGND4_26 | power_in | /GND |  | /GND | EŞLEŞTİ |  | aynı
U1 | 1a457d03-3f41-4328-a962-7ac81fa98011 | 27 | VIN1_27 | power_in | /VIN |  | /VIN | EŞLEŞTİ |  | aynı
U1 | 1a457d03-3f41-4328-a962-7ac81fa98011 | 28 | VIN2_28 | power_in | /VIN |  | /VIN | EŞLEŞTİ |  | aynı
U1 | 1a457d03-3f41-4328-a962-7ac81fa98011 | 29 | VIN3_29 | power_in | /VIN |  | /VIN | EŞLEŞTİ |  | aynı
U1 | 1a457d03-3f41-4328-a962-7ac81fa98011 | 30 | PGND_30 | power_in | /GND |  | /GND | EŞLEŞTİ |  | aynı
U10 | 35e13ca6-6404-53d5-998b-61ee360a6d80 | 1 | OUT_1 | power_out | /P5V_PROT |  | /P5V_PROT | EŞLEŞTİ |  | aynı
U10 | 35e13ca6-6404-53d5-998b-61ee360a6d80 | 2 | FB/NC_2 | passive+no_connect | unconnected-(U10-FB{slash}NC-Pad2) | kasıtlı NC | unconnected-(U10-FB{slash}NC-Pad2) | EŞLEŞTİ |  | aynı
U10 | 35e13ca6-6404-53d5-998b-61ee360a6d80 | 3 | PG_3 | open_collector | /CLR_N |  | /CLR_N | EŞLEŞTİ |  | aynı
U10 | 35e13ca6-6404-53d5-998b-61ee360a6d80 | 4 | GND_4 | power_in | /GND |  | /GND | EŞLEŞTİ |  | aynı
U10 | 35e13ca6-6404-53d5-998b-61ee360a6d80 | 5 | EN_5 | input | /VIN |  | /VIN | EŞLEŞTİ |  | aynı
U10 | 35e13ca6-6404-53d5-998b-61ee360a6d80 | 6 | NC_6 | no_connect | unconnected-(U10-NC-Pad6) | kasıtlı NC | unconnected-(U10-NC-Pad6) | EŞLEŞTİ |  | aynı
U10 | 35e13ca6-6404-53d5-998b-61ee360a6d80 | 7 | DELAY_7 | passive | /LDO_DELAY |  | /LDO_DELAY | EŞLEŞTİ |  | aynı
U10 | 35e13ca6-6404-53d5-998b-61ee360a6d80 | 8 | IN_8 | power_in | /VIN |  | /VIN | EŞLEŞTİ |  | aynı
U10 | 35e13ca6-6404-53d5-998b-61ee360a6d80 | 9 | EP_9 | passive | /GND |  | /GND | EŞLEŞTİ |  | aynı
U11 | b854812a-b4c7-5f18-aa01-ca422b08fb2e | 1 | IN-_1 | input | /VOUT |  | /VOUT | EŞLEŞTİ |  | aynı
U11 | b854812a-b4c7-5f18-aa01-ca422b08fb2e | 2 | GND_2 | power_in | /GND |  | /GND | EŞLEŞTİ |  | aynı
U11 | b854812a-b4c7-5f18-aa01-ca422b08fb2e | 3 | REF2_3 | input | /GND |  | /GND | EŞLEŞTİ |  | aynı
U11 | b854812a-b4c7-5f18-aa01-ca422b08fb2e | 4 | NC_4 | passive | /GND |  | /GND | EŞLEŞTİ |  | aynı
U11 | b854812a-b4c7-5f18-aa01-ca422b08fb2e | 5 | OUT_5 | output | /OC_SENSE1 |  | /OC_SENSE1 | EŞLEŞTİ |  | aynı
U11 | b854812a-b4c7-5f18-aa01-ca422b08fb2e | 6 | VS_6 | power_in | /P5V_PROT |  | /P5V_PROT | EŞLEŞTİ |  | aynı
U11 | b854812a-b4c7-5f18-aa01-ca422b08fb2e | 7 | REF1_7 | input | /GND |  | /GND | EŞLEŞTİ |  | aynı
U11 | b854812a-b4c7-5f18-aa01-ca422b08fb2e | 8 | IN+_8 | input | /ISNS1 |  | /ISNS1 | EŞLEŞTİ |  | aynı
U12 | 3137343f-28ca-5373-834d-7cb4f5944312 | 1 | IN-_1 | input | /VOUT |  | /VOUT | EŞLEŞTİ |  | aynı
U12 | 3137343f-28ca-5373-834d-7cb4f5944312 | 2 | GND_2 | power_in | /GND |  | /GND | EŞLEŞTİ |  | aynı
U12 | 3137343f-28ca-5373-834d-7cb4f5944312 | 3 | REF2_3 | input | /GND |  | /GND | EŞLEŞTİ |  | aynı
U12 | 3137343f-28ca-5373-834d-7cb4f5944312 | 4 | NC_4 | passive | /GND |  | /GND | EŞLEŞTİ |  | aynı
U12 | 3137343f-28ca-5373-834d-7cb4f5944312 | 5 | OUT_5 | output | /OC_SENSE2 |  | /OC_SENSE2 | EŞLEŞTİ |  | aynı
U12 | 3137343f-28ca-5373-834d-7cb4f5944312 | 6 | VS_6 | power_in | /P5V_PROT |  | /P5V_PROT | EŞLEŞTİ |  | aynı
U12 | 3137343f-28ca-5373-834d-7cb4f5944312 | 7 | REF1_7 | input | /GND |  | /GND | EŞLEŞTİ |  | aynı
U12 | 3137343f-28ca-5373-834d-7cb4f5944312 | 8 | IN+_8 | input | /ISNS2 |  | /ISNS2 | EŞLEŞTİ |  | aynı
U13 | 5a97587e-e9bf-524e-ad4b-e19e00896722 | 1 | OUT_1 | output | /OC_TRIP1_N |  | /OC_TRIP1_N | EŞLEŞTİ |  | aynı
U13 | 5a97587e-e9bf-524e-ad4b-e19e00896722 | 2 | VEE_2 | power_in | /GND |  | /GND | EŞLEŞTİ |  | aynı
U13 | 5a97587e-e9bf-524e-ad4b-e19e00896722 | 3 | IN+_3 | input | /OC_REF |  | /OC_REF | EŞLEŞTİ |  | aynı
U13 | 5a97587e-e9bf-524e-ad4b-e19e00896722 | 4 | IN-_4 | input | /OC_SENSE1 |  | /OC_SENSE1 | EŞLEŞTİ |  | aynı
U13 | 5a97587e-e9bf-524e-ad4b-e19e00896722 | 5 | VCC_5 | power_in | /P5V_PROT |  | /P5V_PROT | EŞLEŞTİ |  | aynı
U14 | fd7fe41b-00fa-5f9b-acc5-fac2aab312cd | 1 | OUT_1 | output | /OC_TRIP2_N |  | /OC_TRIP2_N | EŞLEŞTİ |  | aynı
U14 | fd7fe41b-00fa-5f9b-acc5-fac2aab312cd | 2 | VEE_2 | power_in | /GND |  | /GND | EŞLEŞTİ |  | aynı
U14 | fd7fe41b-00fa-5f9b-acc5-fac2aab312cd | 3 | IN+_3 | input | /OC_REF |  | /OC_REF | EŞLEŞTİ |  | aynı
U14 | fd7fe41b-00fa-5f9b-acc5-fac2aab312cd | 4 | IN-_4 | input | /OC_SENSE2 |  | /OC_SENSE2 | EŞLEŞTİ |  | aynı
U14 | fd7fe41b-00fa-5f9b-acc5-fac2aab312cd | 5 | VCC_5 | power_in | /P5V_PROT |  | /P5V_PROT | EŞLEŞTİ |  | aynı
U15 | a3b0a25e-767f-5fde-8d8a-346b5659603e | 1 |  | input | /OVP_BUS_N |  | /OVP_BUS_N | EŞLEŞTİ |  | aynı
U15 | a3b0a25e-767f-5fde-8d8a-346b5659603e | 2 | GND_2 | power_in | /GND |  | /GND | EŞLEŞTİ |  | aynı
U15 | a3b0a25e-767f-5fde-8d8a-346b5659603e | 3 |  | input | /OC_TRIP1_N |  | /OC_TRIP1_N | EŞLEŞTİ |  | aynı
U15 | a3b0a25e-767f-5fde-8d8a-346b5659603e | 4 |  | output | /OVP_TRIP_N |  | /OVP_TRIP_N | EŞLEŞTİ |  | aynı
U15 | a3b0a25e-767f-5fde-8d8a-346b5659603e | 5 | VCC_5 | power_in | /P5V_PROT |  | /P5V_PROT | EŞLEŞTİ |  | aynı
U15 | a3b0a25e-767f-5fde-8d8a-346b5659603e | 6 |  | input | /OC_TRIP2_N |  | /OC_TRIP2_N | EŞLEŞTİ |  | aynı
U2 | ca813d47-bfeb-4bd5-ad3f-b858edd7f615 | 1 | VIN4_1 | power_in | /VIN |  | /VIN | EŞLEŞTİ |  | aynı
U2 | ca813d47-bfeb-4bd5-ad3f-b858edd7f615 | 2 | VIN5_2 | power_in | /VIN |  | /VIN | EŞLEŞTİ |  | aynı
U2 | ca813d47-bfeb-4bd5-ad3f-b858edd7f615 | 3 | VIN6_3 | power_in | /VIN |  | /VIN | EŞLEŞTİ |  | aynı
U2 | ca813d47-bfeb-4bd5-ad3f-b858edd7f615 | 4 | CBOOT_4 | passive | /CBOOT2 |  | /CBOOT2 | EŞLEŞTİ |  | aynı
U2 | ca813d47-bfeb-4bd5-ad3f-b858edd7f615 | 5 | SW4_5 | passive | /SW4_PH2 |  | /SW4_PH2 | EŞLEŞTİ |  | aynı
U2 | ca813d47-bfeb-4bd5-ad3f-b858edd7f615 | 6 | BIAS_6 | passive | /GND |  | /GND | EŞLEŞTİ |  | aynı
U2 | ca813d47-bfeb-4bd5-ad3f-b858edd7f615 | 7 | PG/SYNCOUT_7 | open_collector+no_connect | unconnected-(U2-PG{slash}SYNCOUT-Pad7) | kasıtlı NC | unconnected-(U2-PG{slash}SYNCOUT-Pad7) | EŞLEŞTİ |  | aynı
U2 | ca813d47-bfeb-4bd5-ad3f-b858edd7f615 | 8 | PFM/SYNCIN_8 | input | /SYNC |  | /SYNC | EŞLEŞTİ |  | aynı
U2 | ca813d47-bfeb-4bd5-ad3f-b858edd7f615 | 9 | EN/UVLO_9 | input | /EN_BUCK |  | /EN_BUCK | EŞLEŞTİ |  | aynı
U2 | ca813d47-bfeb-4bd5-ad3f-b858edd7f615 | 10 | NC_10 | no_connect | unconnected-(U2-NC-Pad10) | kasıtlı NC | unconnected-(U2-NC-Pad10) | EŞLEŞTİ |  | aynı
U2 | ca813d47-bfeb-4bd5-ad3f-b858edd7f615 | 11 | ISNS+_11 | input | /ISNS2 |  | /ISNS2 | EŞLEŞTİ |  | aynı
U2 | ca813d47-bfeb-4bd5-ad3f-b858edd7f615 | 12 | VOUT_12 | input | /VOUT |  | /VOUT | EŞLEŞTİ |  | aynı
U2 | ca813d47-bfeb-4bd5-ad3f-b858edd7f615 | 13 | CONFIG_13 | input | /CFG_SEC |  | /CFG_SEC | EŞLEŞTİ |  | aynı
U2 | ca813d47-bfeb-4bd5-ad3f-b858edd7f615 | 14 | RT_14 | input | /RT_PH2 |  | /RT_PH2 | EŞLEŞTİ |  | aynı
U2 | ca813d47-bfeb-4bd5-ad3f-b858edd7f615 | 15 | EXTCOMP_15 | passive | /COMP |  | /COMP | EŞLEŞTİ |  | aynı
U2 | ca813d47-bfeb-4bd5-ad3f-b858edd7f615 | 16 | FB_16 | input | /GND |  | /GND | EŞLEŞTİ |  | aynı
U2 | ca813d47-bfeb-4bd5-ad3f-b858edd7f615 | 17 | AGND_17 | power_in | /GND |  | /GND | EŞLEŞTİ |  | aynı
U2 | ca813d47-bfeb-4bd5-ad3f-b858edd7f615 | 18 | VDDA_18 | power_out | /VDDA2 |  | /VDDA2 | EŞLEŞTİ |  | aynı
U2 | ca813d47-bfeb-4bd5-ad3f-b858edd7f615 | 19 | VCC_19 | power_out | /VCC2 |  | /VCC2 | EŞLEŞTİ |  | aynı
U2 | ca813d47-bfeb-4bd5-ad3f-b858edd7f615 | 20 | SW1_20 | passive | /SW_PH2 |  | /SW_PH2 | EŞLEŞTİ |  | aynı
U2 | ca813d47-bfeb-4bd5-ad3f-b858edd7f615 | 21 | SW2_21 | passive | /SW_PH2 |  | /SW_PH2 | EŞLEŞTİ |  | aynı
U2 | ca813d47-bfeb-4bd5-ad3f-b858edd7f615 | 22 | SW3_22 | passive | /SW_PH2 |  | /SW_PH2 | EŞLEŞTİ |  | aynı
U2 | ca813d47-bfeb-4bd5-ad3f-b858edd7f615 | 23 | PGND1_23 | power_in | /GND |  | /GND | EŞLEŞTİ |  | aynı
U2 | ca813d47-bfeb-4bd5-ad3f-b858edd7f615 | 24 | PGND2_24 | power_in | /GND |  | /GND | EŞLEŞTİ |  | aynı
U2 | ca813d47-bfeb-4bd5-ad3f-b858edd7f615 | 25 | PGND3_25 | power_in | /GND |  | /GND | EŞLEŞTİ |  | aynı
U2 | ca813d47-bfeb-4bd5-ad3f-b858edd7f615 | 26 | PGND4_26 | power_in | /GND |  | /GND | EŞLEŞTİ |  | aynı
U2 | ca813d47-bfeb-4bd5-ad3f-b858edd7f615 | 27 | VIN1_27 | power_in | /VIN |  | /VIN | EŞLEŞTİ |  | aynı
U2 | ca813d47-bfeb-4bd5-ad3f-b858edd7f615 | 28 | VIN2_28 | power_in | /VIN |  | /VIN | EŞLEŞTİ |  | aynı
U2 | ca813d47-bfeb-4bd5-ad3f-b858edd7f615 | 29 | VIN3_29 | power_in | /VIN |  | /VIN | EŞLEŞTİ |  | aynı
U2 | ca813d47-bfeb-4bd5-ad3f-b858edd7f615 | 30 | PGND_30 | power_in | /GND |  | /GND | EŞLEŞTİ |  | aynı
U3 | 08681ecb-5905-456c-99b2-23c856224027 | 1 | IN_1 | power_in | /VSAFE |  | /VSAFE | EŞLEŞTİ |  | aynı
U3 | 08681ecb-5905-456c-99b2-23c856224027 | 2 | IN_2 | power_in | /VSAFE |  | /VSAFE | EŞLEŞTİ |  | aynı
U3 | 08681ecb-5905-456c-99b2-23c856224027 | 3 | IN_3 | power_in | /VSAFE |  | /VSAFE | EŞLEŞTİ |  | aynı
U3 | 08681ecb-5905-456c-99b2-23c856224027 | 4 | GND_4 | power_in | /GND |  | /GND | EŞLEŞTİ |  | aynı
U3 | 08681ecb-5905-456c-99b2-23c856224027 | 5 | GND_5 | power_in | /GND |  | /GND | EŞLEŞTİ |  | aynı
U3 | 08681ecb-5905-456c-99b2-23c856224027 | 6 | EN/UVLO_6 | input | /EN_EFUSE |  | /EN_EFUSE | EŞLEŞTİ |  | aynı
U3 | 08681ecb-5905-456c-99b2-23c856224027 | 7 | ITIMER_7 | passive+no_connect | unconnected-(U3-ITIMER-Pad7) | kasıtlı NC | unconnected-(U3-ITIMER-Pad7) | EŞLEŞTİ |  | aynı
U3 | 08681ecb-5905-456c-99b2-23c856224027 | 8 | ILIM_8 | passive | /ILIM_O1 |  | /ILIM_O1 | EŞLEŞTİ |  | aynı
U3 | 08681ecb-5905-456c-99b2-23c856224027 | 9 | IMON_9 | passive | /IMON_O1 |  | /IMON_O1 | EŞLEŞTİ |  | aynı
U3 | 08681ecb-5905-456c-99b2-23c856224027 | 10 | RETRY_DLY_10 | passive | /GND |  | /GND | EŞLEŞTİ |  | aynı
U3 | 08681ecb-5905-456c-99b2-23c856224027 | 11 | NRETRY_11 | passive | /GND |  | /GND | EŞLEŞTİ |  | aynı
U3 | 08681ecb-5905-456c-99b2-23c856224027 | 12 | LDSTRT_12 | input | /GND |  | /GND | EŞLEŞTİ |  | aynı
U3 | 08681ecb-5905-456c-99b2-23c856224027 | 13 | PG_13 | open_collector | /PG_O1 |  | /PG_O1 | EŞLEŞTİ |  | aynı
U3 | 08681ecb-5905-456c-99b2-23c856224027 | 14 | GND_14 | power_in | /GND |  | /GND | EŞLEŞTİ |  | aynı
U3 | 08681ecb-5905-456c-99b2-23c856224027 | 15 | dVdt_15 | passive | /DVDT_O1 |  | /DVDT_O1 | EŞLEŞTİ |  | aynı
U3 | 08681ecb-5905-456c-99b2-23c856224027 | 16 | IN_16 | power_in | /VSAFE |  | /VSAFE | EŞLEŞTİ |  | aynı
U3 | 08681ecb-5905-456c-99b2-23c856224027 | 17 | OUT_17 | power_out | /O1_11V |  | /O1_11V | EŞLEŞTİ |  | aynı
U3 | 08681ecb-5905-456c-99b2-23c856224027 | 18 | OUT_18 | passive | /O1_11V |  | /O1_11V | EŞLEŞTİ |  | aynı
U3 | 08681ecb-5905-456c-99b2-23c856224027 | 19 | OUT_19 | passive | /O1_11V |  | /O1_11V | EŞLEŞTİ |  | aynı
U3 | 08681ecb-5905-456c-99b2-23c856224027 | 20 | OUT_20 | passive | /O1_11V |  | /O1_11V | EŞLEŞTİ |  | aynı
U3 | 08681ecb-5905-456c-99b2-23c856224027 | 21 | OUT_21 | passive | /O1_11V |  | /O1_11V | EŞLEŞTİ |  | aynı
U3 | 08681ecb-5905-456c-99b2-23c856224027 | 22 | OUT_22 | passive | /O1_11V |  | /O1_11V | EŞLEŞTİ |  | aynı
U3 | 08681ecb-5905-456c-99b2-23c856224027 | 23 | OUT_23 | passive | /O1_11V |  | /O1_11V | EŞLEŞTİ |  | aynı
U3 | 08681ecb-5905-456c-99b2-23c856224027 | 24 | OUT_24 | passive | /O1_11V |  | /O1_11V | EŞLEŞTİ |  | aynı
U3 | 08681ecb-5905-456c-99b2-23c856224027 | 25 | IN_EP_25 | power_in | /VSAFE |  | /VSAFE | EŞLEŞTİ |  | aynı
U3 | 08681ecb-5905-456c-99b2-23c856224027 | 26 | GND_EP_26 | power_in | /GND |  | /GND | EŞLEŞTİ |  | aynı
U4 | 1633fe73-6bf3-442a-b9e2-aed7d55f5ec8 | 1 | IN_1 | power_in | /VSAFE |  | /VSAFE | EŞLEŞTİ |  | aynı
U4 | 1633fe73-6bf3-442a-b9e2-aed7d55f5ec8 | 2 | IN_2 | power_in | /VSAFE |  | /VSAFE | EŞLEŞTİ |  | aynı
U4 | 1633fe73-6bf3-442a-b9e2-aed7d55f5ec8 | 3 | IN_3 | power_in | /VSAFE |  | /VSAFE | EŞLEŞTİ |  | aynı
U4 | 1633fe73-6bf3-442a-b9e2-aed7d55f5ec8 | 4 | GND_4 | power_in | /GND |  | /GND | EŞLEŞTİ |  | aynı
U4 | 1633fe73-6bf3-442a-b9e2-aed7d55f5ec8 | 5 | GND_5 | power_in | /GND |  | /GND | EŞLEŞTİ |  | aynı
U4 | 1633fe73-6bf3-442a-b9e2-aed7d55f5ec8 | 6 | EN/UVLO_6 | input | /EN_EFUSE |  | /EN_EFUSE | EŞLEŞTİ |  | aynı
U4 | 1633fe73-6bf3-442a-b9e2-aed7d55f5ec8 | 7 | ITIMER_7 | passive+no_connect | unconnected-(U4-ITIMER-Pad7) | kasıtlı NC | unconnected-(U4-ITIMER-Pad7) | EŞLEŞTİ |  | aynı
U4 | 1633fe73-6bf3-442a-b9e2-aed7d55f5ec8 | 8 | ILIM_8 | passive | /ILIM_S2E |  | /ILIM_S2E | EŞLEŞTİ |  | aynı
U4 | 1633fe73-6bf3-442a-b9e2-aed7d55f5ec8 | 9 | IMON_9 | passive | /IMON_S2E |  | /IMON_S2E | EŞLEŞTİ |  | aynı
U4 | 1633fe73-6bf3-442a-b9e2-aed7d55f5ec8 | 10 | RETRY_DLY_10 | passive | /GND |  | /GND | EŞLEŞTİ |  | aynı
U4 | 1633fe73-6bf3-442a-b9e2-aed7d55f5ec8 | 11 | NRETRY_11 | passive | /GND |  | /GND | EŞLEŞTİ |  | aynı
U4 | 1633fe73-6bf3-442a-b9e2-aed7d55f5ec8 | 12 | LDSTRT_12 | input | /GND |  | /GND | EŞLEŞTİ |  | aynı
U4 | 1633fe73-6bf3-442a-b9e2-aed7d55f5ec8 | 13 | PG_13 | open_collector | /PG_S2E |  | /PG_S2E | EŞLEŞTİ |  | aynı
U4 | 1633fe73-6bf3-442a-b9e2-aed7d55f5ec8 | 14 | GND_14 | power_in | /GND |  | /GND | EŞLEŞTİ |  | aynı
U4 | 1633fe73-6bf3-442a-b9e2-aed7d55f5ec8 | 15 | dVdt_15 | passive | /DVDT_S2E |  | /DVDT_S2E | EŞLEŞTİ |  | aynı
U4 | 1633fe73-6bf3-442a-b9e2-aed7d55f5ec8 | 16 | IN_16 | power_in | /VSAFE |  | /VSAFE | EŞLEŞTİ |  | aynı
U4 | 1633fe73-6bf3-442a-b9e2-aed7d55f5ec8 | 17 | OUT_17 | power_out | /S2E_11V |  | /S2E_11V | EŞLEŞTİ |  | aynı
U4 | 1633fe73-6bf3-442a-b9e2-aed7d55f5ec8 | 18 | OUT_18 | passive | /S2E_11V |  | /S2E_11V | EŞLEŞTİ |  | aynı
U4 | 1633fe73-6bf3-442a-b9e2-aed7d55f5ec8 | 19 | OUT_19 | passive | /S2E_11V |  | /S2E_11V | EŞLEŞTİ |  | aynı
U4 | 1633fe73-6bf3-442a-b9e2-aed7d55f5ec8 | 20 | OUT_20 | passive | /S2E_11V |  | /S2E_11V | EŞLEŞTİ |  | aynı
U4 | 1633fe73-6bf3-442a-b9e2-aed7d55f5ec8 | 21 | OUT_21 | passive | /S2E_11V |  | /S2E_11V | EŞLEŞTİ |  | aynı
U4 | 1633fe73-6bf3-442a-b9e2-aed7d55f5ec8 | 22 | OUT_22 | passive | /S2E_11V |  | /S2E_11V | EŞLEŞTİ |  | aynı
U4 | 1633fe73-6bf3-442a-b9e2-aed7d55f5ec8 | 23 | OUT_23 | passive | /S2E_11V |  | /S2E_11V | EŞLEŞTİ |  | aynı
U4 | 1633fe73-6bf3-442a-b9e2-aed7d55f5ec8 | 24 | OUT_24 | passive | /S2E_11V |  | /S2E_11V | EŞLEŞTİ |  | aynı
U4 | 1633fe73-6bf3-442a-b9e2-aed7d55f5ec8 | 25 | IN_EP_25 | power_in | /VSAFE |  | /VSAFE | EŞLEŞTİ |  | aynı
U4 | 1633fe73-6bf3-442a-b9e2-aed7d55f5ec8 | 26 | GND_EP_26 | power_in | /GND |  | /GND | EŞLEŞTİ |  | aynı
U5 | 090a75e3-fe18-402a-bbb4-b44881c7886b | 1 | VCAP_1 | passive | /VCAP |  | /VCAP | EŞLEŞTİ |  | aynı
U5 | 090a75e3-fe18-402a-bbb4-b44881c7886b | 2 | GND_2 | power_in | /GND |  | /GND | EŞLEŞTİ |  | aynı
U5 | 090a75e3-fe18-402a-bbb4-b44881c7886b | 3 | EN_3 | input | /ANODE |  | /ANODE | EŞLEŞTİ |  | aynı
U5 | 090a75e3-fe18-402a-bbb4-b44881c7886b | 4 | CATHODE_4 | input | /VIN |  | /VIN | EŞLEŞTİ |  | aynı
U5 | 090a75e3-fe18-402a-bbb4-b44881c7886b | 5 | GATE_5 | output | /GATE |  | /GATE | EŞLEŞTİ |  | aynı
U5 | 090a75e3-fe18-402a-bbb4-b44881c7886b | 6 | ANODE_6 | power_in | /ANODE |  | /ANODE | EŞLEŞTİ |  | aynı
U6 | a8826e04-0e7a-5858-bdac-caab289b8678 | 1 | EN/UVLO_1 | input | /ISO_EN |  | /ISO_EN | EŞLEŞTİ |  | aynı
U6 | a8826e04-0e7a-5858-bdac-caab289b8678 | 2 | GND_2 | power_in | /GND |  | /GND | EŞLEŞTİ |  | aynı
U6 | a8826e04-0e7a-5858-bdac-caab289b8678 | 3 | NC_3 | no_connect | unconnected-(U6-NC-Pad3) | kasıtlı NC | unconnected-(U6-NC-Pad3) | EŞLEŞTİ |  | aynı
U6 | a8826e04-0e7a-5858-bdac-caab289b8678 | 4 | VCAP_4 | passive | /ISO_VCAP |  | /ISO_VCAP | EŞLEŞTİ |  | aynı
U6 | a8826e04-0e7a-5858-bdac-caab289b8678 | 5 | VS_5 | power_in | /VOUT |  | /VOUT | EŞLEŞTİ |  | aynı
U6 | a8826e04-0e7a-5858-bdac-caab289b8678 | 6 | GATE_6 | output | /ISO_GATE |  | /ISO_GATE | EŞLEŞTİ |  | aynı
U6 | a8826e04-0e7a-5858-bdac-caab289b8678 | 7 | OV_7 | input | /ISO_OV |  | /ISO_OV | EŞLEŞTİ |  | aynı
U6 | a8826e04-0e7a-5858-bdac-caab289b8678 | 8 | SRC_8 | input | /VSAFE |  | /VSAFE | EŞLEŞTİ |  | aynı
U7 | c27640a9-759f-50c7-a0a0-127d739dd21f | 1 | OUT_1 | output | /OVP_BUS_N |  | /OVP_BUS_N | EŞLEŞTİ |  | aynı
U7 | c27640a9-759f-50c7-a0a0-127d739dd21f | 2 | VEE_2 | power_in | /GND |  | /GND | EŞLEŞTİ |  | aynı
U7 | c27640a9-759f-50c7-a0a0-127d739dd21f | 3 | IN+_3 | input | /OVP_REF |  | /OVP_REF | EŞLEŞTİ |  | aynı
U7 | c27640a9-759f-50c7-a0a0-127d739dd21f | 4 | IN-_4 | input | /OVP_SENSE |  | /OVP_SENSE | EŞLEŞTİ |  | aynı
U7 | c27640a9-759f-50c7-a0a0-127d739dd21f | 5 | VCC_5 | power_in | /P5V_PROT |  | /P5V_PROT | EŞLEŞTİ |  | aynı
U8 | 420c622f-b551-5b5a-9eba-56cf338db5d1 | 1 | DNC_1 | no_connect | unconnected-(U8-DNC-Pad1) | kasıtlı NC | unconnected-(U8-DNC-Pad1) | EŞLEŞTİ |  | aynı
U8 | 420c622f-b551-5b5a-9eba-56cf338db5d1 | 2 | Vin_2 | power_in | /P5V_PROT |  | /P5V_PROT | EŞLEŞTİ |  | aynı
U8 | 420c622f-b551-5b5a-9eba-56cf338db5d1 | 3 | Temp_3 | passive+no_connect | unconnected-(U8-Temp-Pad3) | kasıtlı NC | unconnected-(U8-Temp-Pad3) | EŞLEŞTİ |  | aynı
U8 | 420c622f-b551-5b5a-9eba-56cf338db5d1 | 4 | GND_4 | power_in | /GND |  | /GND | EŞLEŞTİ |  | aynı
U8 | 420c622f-b551-5b5a-9eba-56cf338db5d1 | 5 | Trim/NR_5 | passive | /REF_NR |  | /REF_NR | EŞLEŞTİ |  | aynı
U8 | 420c622f-b551-5b5a-9eba-56cf338db5d1 | 6 | Vout_6 | power_out | /OVP_REF |  | /OVP_REF | EŞLEŞTİ |  | aynı
U8 | 420c622f-b551-5b5a-9eba-56cf338db5d1 | 7 | NC_7 | no_connect | unconnected-(U8-NC-Pad7) | kasıtlı NC | unconnected-(U8-NC-Pad7) | EŞLEŞTİ |  | aynı
U8 | 420c622f-b551-5b5a-9eba-56cf338db5d1 | 8 | DNC_8 | no_connect | unconnected-(U8-DNC-Pad8) | kasıtlı NC | unconnected-(U8-DNC-Pad8) | EŞLEŞTİ |  | aynı
U9 | a1058e17-4281-5f28-8998-151941befd72 | 1 | CLK_1 | input | /GND |  | /GND | EŞLEŞTİ |  | aynı
U9 | a1058e17-4281-5f28-8998-151941befd72 | 2 | D_2 | input | /P5V_PROT |  | /P5V_PROT | EŞLEŞTİ |  | aynı
U9 | a1058e17-4281-5f28-8998-151941befd72 | 3 | ~{Q}_3 | output+no_connect | unconnected-(U9-~{Q}-Pad3) | kasıtlı NC | unconnected-(U9-~{Q}-Pad3) | EŞLEŞTİ |  | aynı
U9 | a1058e17-4281-5f28-8998-151941befd72 | 4 | GND_4 | power_in | /GND |  | /GND | EŞLEŞTİ |  | aynı
U9 | a1058e17-4281-5f28-8998-151941befd72 | 5 | Q_5 | output | /OVP_Q |  | /OVP_Q | EŞLEŞTİ |  | aynı
U9 | a1058e17-4281-5f28-8998-151941befd72 | 6 | ~{CLR}_6 | input | /CLR_N |  | /CLR_N | EŞLEŞTİ |  | aynı
U9 | a1058e17-4281-5f28-8998-151941befd72 | 7 | ~{PRE}_7 | input | /OVP_TRIP_N |  | /OVP_TRIP_N | EŞLEŞTİ |  | aynı
U9 | a1058e17-4281-5f28-8998-151941befd72 | 8 | VCC_8 | power_in | /P5V_PROT |  | /P5V_PROT | EŞLEŞTİ |  | aynı
