siimsek/PDU/hardware/no-measurement-final-audit.md

> **SUPERSEDED (G4, 2026-11-07) → docs/START-HERE.md.** 2026-10-19 anlık görüntüsünün geçmiş kaydıdır; içerik değiştirilmedi.

# Independent final snapshot audit — 2026-10-19

**Readiness: NOT READY. Current full-suite verification: completed, with two confirmed O1overvoltage acceptance failures.** The independent schematic/connectivity checks below completed. No design or rule mutation was made by this reviewer. Manufacturing and hardware acceptance are not implied.

## Independently verified changes

- Fresh Konnect `find_shorted_nets`: **0**. Fresh ERC: **0errors/0warnings**. Main symbol inventory:77.
- Fresh export `.konnect/diagnostics/no-measurement-final-audit.net` matches the current simulator-export component values, footprints and pin/net map. The reviewer did not overwrite `simulation/pdu-current.net`.
- Against `.konnect/diagnostics/schematic-finished.net`: same73physical component references and all257pin/net assignments. Only electrical value changes are RIMON1:2.61k→806 ΩandRIMON2:4.99k→806 Ω. Only footprint changes are COUT1–8:1210→`PDU:TDK_C5750_2220_Recommended`. RILIM1/2remain301/604 Ω; no5 A O1load was assigned.
- Exact RFBmetadata checked: RFB1ERA3AEB134V, RFB2ERA3AEB1022V,0.1%,≤25 ppm/K; existing130k/10.2kvalues preserved. Both RIMONparts carry806 ΩERA3AEB8060Vwith0.1%/≤25 ppm/Kmetadata.
- COUT1–8carry22 µF,C5750X7S2A226M280KB,100 V,20%metadata and the accepted2220footprint. Vendor-model effective-capacitance note remains explicit; nominal22 µFis not claimed at11 Vbias.
- All eight COUTfootprints were independently read from **live IPC**: exactly two1.30×4.50 mmpads each; pad1`/VOUT`,pad2`/GND`;5.75 mmcenter spacing gives4.45 mminner gap. These agree with the manufacturer land interpretation. Evidence: `.konnect/diagnostics/no-measurement-final-pad-results.json` and `no-measurement-final-pad-summary.json`.

Fresh checks also returned through the existing stdio MCPdiagnostic client after the initial direct client calls were delayed; both paths ultimately completed. No failed check was interpreted as zero.

## PCB evidence reviewed

Latest `.konnect/diagnostics/cout-hv-main-drc.json` after the parent's library refresh contains **197unconnected errors/301warnings**. Other error categories are absent. Warnings comprise199silk-over-copper,72symbol/footprint field mismatches,21silk overlaps,5library mismatches,3silk-edge and1missing F1. The earlier309warning count preceded refresh of the eight COUTfootprints and is superseded.

This is an unrouted prototype board. Correct pad net assignments and zero copper-clearance findings do not turn an unrouted connection into a physical conductor. The parent's9netclasses/46netsreadback was reported separately; this reviewer did not rerun rule queries during the pending DRC/save queue.

## Simulation status, deliberately distinguished from a pass

The refreshed final run completed24cases/48engine runs with512passing checks and2failing checks. This reviewer independently checked `verification-results.json`: its recorded `pdu-current.net`SHA256matches the current file, **1f2f6085d3b162f287364cf570f3acdea2b81d6a4f8aa699f6c12a64431f7e9b**. Both failures are `efuse-ovp/O1_input_rating`, one per engine, with16.89 Vpeak against the12 Vmaximum. Engine execution and source matching completed; electrical acceptance did not. The previous120 sprocess deadline atS2Eshort was addressed by a300 sper-deck deadline without changing circuit stimuli or electrical criteria. The failedO1tests remain visible.

## Export-artifact defect: published BOM corrected

The raw exporter produced seven references with a trailingquestion mark:CCOMP?,CHF?,CVCAP?,RCOMP?,RPG1B?,RPG2B?,RSYNC?. The published `hardware/pdu-current-bom.csv` is now corrected using `simulation/canonical_bom.py` and exact unique reference/value/footprint joins to the Konnectnetlist. This reviewer independently verified73published rows and exact reference-set agreement with the current73physical netlist components. The original rawCSVwas retained as `hardware/pdu-current-bom.raw.csv`, and the seven aliases are recorded in `.konnect/diagnostics/canonical-bom-evidence.json`. The upstream exporter behavior remains unresolved; the delivered canonical artifact is fixed. No effective schematic reference changes were required.

After canonicalization57/73BOMMPNfields remain empty, includingQ1whose Valueis already an exact part number. Thus the purchasing BOMis not complete despite the newly specified12parts. Empty fields are observable remaining work, not physical-measurement limitations.

## Remaining work classified by what actually blocks it

### Software/design work still possible

1. **O1overvoltage path:** current TPS259824Ofixed16.9 VOVPdoes not meet the12 VO1maximum. The candidate stage is not installed/accepted. Selection, worst-case modeling, footprint acceptance and schematic integration remain design work; passing nominal simulations is insufficient.
2. **BOMcompletion:** populate verified exact MPNs, voltage/power/tolerance metadata for existing parts. The seven deliveredCSVreference aliases are corrected; retain the canonicalizer while the upstream exporter behavior remains. Q1MPNmetadata can use its already exactBSC160N10NS3GValueafter identity readback. U5has a concrete manufacturer-orderable candidate **LM74700QDBVRQ1**,DBV6SOT-23, matching the package family already used; verify the pin/package/footprint contract before acceptance. [Exact TIordering page](https://www.ti.com/product/LM74700-Q1/part-details/LM74700QDBVRQ1).
3. **Compensation model:** evaluate low/nominal/highCeffandESRcorners with transparent TIcontrol assumptions; the unchanged approximate500 V/Vinner loop is not silicon phase-margin evidence. Vendor capacitor qualification and isolatedACresults are documented in `hardware/COUT-qualification.md`.
4. **PCBcompletion:** routing,return paths,thermal vias/planes,hot-loop geometry and manufacturable silkscreen remain layout work. Footprint stencil/assembly acceptance and field/library mismatches must be resolved or explicitly documented before manufacture. Do not label these as problems requiring a physical board before any progress is possible.
5. **UVLOrequirement:**180k/10kdoes not guarantee cold restart at20 Vwith1%resistors; the earlier20.3318 Vcorner remains. A revised ratio/tolerance policy can be analyzed in software, but no unapproved battery-discharge policy should be silently invented.

### Missing design inputs, not inherently measurements

- F1exact selection requires the battery/cable fault-current and intended protection coordination envelope, DCbreaking capacity and time-current/I²tcriteria. Unknown source impedance is not permission to invent an MPN.
- Enclosure/interface/polarity/mating cable details and required ambient temperature must be specified. Manufacturer drawings and known hardware versions can resolve some of these without bench measurements.

### Eventual physical acceptance still required

- Actual O1/S2Estartup/current profile, fault/transient energy and load-end voltage.
- Converter sharing/loop behavior,layout parasitics,thermal,EMCand fuse/TVSfault coordination under the real source/cable/load combination.
- ICprototype footprint stencil/solder/thermal verification and manufactured-board bring-up.

## Bounded conclusion

The intended FBspecification, IMONheadroom change,100 Voutput-capacitor selection and their pad/net transfer are confirmed. No newly unintended pin/net change was found. The current source-matched simulation suite completed, with both O1overvoltage failures preserved; canonical purchasing references are corrected. The O1fault-protection blocker, incomplete routing and incomplete purchasing BOMstill prevent a completion or production-ready claim. None is hidden behind ERC0.
