siimsek/PDU/hardware/validation/power-ics/LM70880-pinmap-acceptance.md

# LM70880QRRXRQ1 / RRX0029B prototype acceptance

2026-10-19: physical pin map and disposable IPC placement accepted for prototype layout; production land/stencil and thermal validation remain open.

Manufacturer TI, exact MPN LM70880QRRXRQ1, RRX0029B 6x6 mm VQFN. Datasheet SNVSBX7A, revised June 2024, pins pp3-4, mechanical/land/stencil pp51-53, drawing 4228757/D 04/2024.
Source https://www.ti.com/lit/ds/symlink/lm70880-q1.pdf ; local hardware/_datasheets/lm70880-q1.pdf.
Symbol PDU:LM70880QRRXRQ1; footprint PDU:LM70880_RRX0029B_RectLands.

- Physical 1: VIN4 -> symbol 1 VIN4 (power_in) -> pad 1 contact (-2.9, -2.25) mm, 0.6 x 0.25 mm; component top view, counterclockwise from upper-left pin1.
- Physical 2: VIN5 -> symbol 2 VIN5 (power_in) -> pad 2 contact (-2.9, -1.75) mm, 0.6 x 0.25 mm; component top view, counterclockwise from upper-left pin1.
- Physical 3: VIN6 -> symbol 3 VIN6 (power_in) -> pad 3 contact (-2.9, -1.25) mm, 0.6 x 0.25 mm; component top view, counterclockwise from upper-left pin1.
- Physical 4: CBOOT -> symbol 4 CBOOT (passive) -> pad 4 contact (-2.9, -0.25) mm, 0.6 x 0.25 mm; component top view, counterclockwise from upper-left pin1.
- Physical 5: SW4 -> symbol 5 SW4 (passive) -> pad 5 contact (-2.9, 0.25) mm, 0.6 x 0.25 mm; component top view, counterclockwise from upper-left pin1.
- Physical 6: BIAS -> symbol 6 BIAS (passive) -> pad 6 contact (-2.9, 1.25) mm, 0.6 x 0.25 mm; component top view, counterclockwise from upper-left pin1.
- Physical 7: PG/SYNCOUT -> symbol 7 PG/SYNCOUT (open_collector) -> pad 7 contact (-2.9, 1.75) mm, 0.6 x 0.25 mm; component top view, counterclockwise from upper-left pin1.
- Physical 8: PFM/SYNCIN -> symbol 8 PFM/SYNCIN (input) -> pad 8 contact (-2.9, 2.25) mm, 0.6 x 0.25 mm; component top view, counterclockwise from upper-left pin1.
- Physical 9: EN/UVLO -> symbol 9 EN/UVLO (input) -> pad 9 contact (-2, 2.9) mm, 0.25 x 0.6 mm; component top view, counterclockwise from upper-left pin1.
- Physical 10: NC -> symbol 10 NC (no_connect) -> pad 10 contact (-1.5, 2.9) mm, 0.25 x 0.6 mm; component top view, counterclockwise from upper-left pin1.
- Physical 11: ISNS+ -> symbol 11 ISNS+ (input) -> pad 11 contact (-1, 2.9) mm, 0.25 x 0.6 mm; component top view, counterclockwise from upper-left pin1.
- Physical 12: VOUT -> symbol 12 VOUT (input) -> pad 12 contact (0, 2.9) mm, 0.25 x 0.6 mm; component top view, counterclockwise from upper-left pin1.
- Physical 13: CONFIG -> symbol 13 CONFIG (input) -> pad 13 contact (0.5, 2.9) mm, 0.25 x 0.6 mm; component top view, counterclockwise from upper-left pin1.
- Physical 14: RT -> symbol 14 RT (input) -> pad 14 contact (1, 2.9) mm, 0.25 x 0.6 mm; component top view, counterclockwise from upper-left pin1.
- Physical 15: EXTCOMP -> symbol 15 EXTCOMP (passive) -> pad 15 contact (1.5, 2.9) mm, 0.25 x 0.6 mm; component top view, counterclockwise from upper-left pin1.
- Physical 16: FB -> symbol 16 FB (input) -> pad 16 contact (2, 2.9) mm, 0.25 x 0.6 mm; component top view, counterclockwise from upper-left pin1.
- Physical 17: AGND -> symbol 17 AGND (power_in) -> pad 17 contact (2.9, 1.75) mm, 0.6 x 0.25 mm; component top view, counterclockwise from upper-left pin1.
- Physical 18: VDDA -> symbol 18 VDDA (power_out) -> pad 18 contact (2.9, 1.25) mm, 0.6 x 0.25 mm; component top view, counterclockwise from upper-left pin1.
- Physical 19: VCC -> symbol 19 VCC (power_out) -> pad 19 contact (2.9, 0.75) mm, 0.6 x 0.25 mm; component top view, counterclockwise from upper-left pin1.
- Physical 20: SW1 -> symbol 20 SW1 (passive) -> pad 20 contact (2.9, -0.75) mm, 0.6 x 0.25 mm; component top view, counterclockwise from upper-left pin1.
- Physical 21: SW2 -> symbol 21 SW2 (passive) -> pad 21 contact (2.9, -1.25) mm, 0.6 x 0.25 mm; component top view, counterclockwise from upper-left pin1.
- Physical 22: SW3 -> symbol 22 SW3 (passive) -> pad 22 contact (2.9, -1.75) mm, 0.6 x 0.25 mm; component top view, counterclockwise from upper-left pin1.
- Physical 23: PGND1 -> symbol 23 PGND1 (power_in) -> pad 23 contact (2, -2.9) mm, 0.25 x 0.6 mm; component top view, counterclockwise from upper-left pin1.
- Physical 24: PGND2 -> symbol 24 PGND2 (power_in) -> pad 24 contact (1.5, -2.9) mm, 0.25 x 0.6 mm; component top view, counterclockwise from upper-left pin1.
- Physical 25: PGND3 -> symbol 25 PGND3 (power_in) -> pad 25 contact (1, -2.9) mm, 0.25 x 0.6 mm; component top view, counterclockwise from upper-left pin1.
- Physical 26: PGND4 -> symbol 26 PGND4 (power_in) -> pad 26 contact (0.5, -2.9) mm, 0.25 x 0.6 mm; component top view, counterclockwise from upper-left pin1.
- Physical 27: VIN1 -> symbol 27 VIN1 (power_in) -> pad 27 contact (-1, -2.9) mm, 0.25 x 0.6 mm; component top view, counterclockwise from upper-left pin1.
- Physical 28: VIN2 -> symbol 28 VIN2 (power_in) -> pad 28 contact (-1.5, -2.9) mm, 0.25 x 0.6 mm; component top view, counterclockwise from upper-left pin1.
- Physical 29: VIN3 -> symbol 29 VIN3 (power_in) -> pad 29 contact (-2, -2.9) mm, 0.25 x 0.6 mm; component top view, counterclockwise from upper-left pin1.
- Physical 30: PGND -> symbol 30 PGND (power_in) -> pad 30 contact (0.037, 1.308) mm, 3.125 x 1.584 mm; component top view, counterclockwise from upper-left pin1.

The 29 perimeter leads plus controller PGND die-attach pad30 reconcile to 30 symbol pins and 30 logical copper numbers. The VIN die-attach copper is common with leads1,2,27,28,29 and is decomposed into 226 overlapping rectangles numbered29. SW die-attach copper is common with20,21,22 and uses135 overlapping rectangles numbered22. All physical contact numbers still exist. This intentionally has406 pad objects:361 decomposition pieces,30 contact/die-attach pads and15 unnumbered paste-only apertures. Perimeter contacts with integrated paste add21 additional stencil openings. No mechanical pads/drills or embedded thermal vias.

This representation exists because Konnect0.13 refuses native custom-shaped pads. Polygon boundaries were extracted from the manufacturer PDF vector drawing, calibrated using15:1 scale and documented -3.2 mm datum. Curved edges were sampled, endpoint gaps joined within0.01 PDF point, then decomposed into0.005-mm strips with0.002-mm overlaps. Copper shape Hausdorff deviation is below0.007 mm and area excess below0.35%; see rrx-geometry-evidence.json. This is an explicit approximation, not an exact manufacturer CAD footprint. The lower-left VIN paste aperture is conservatively narrower to stay inside the recommended chamfer; production stencil review is required. No production qualification is claimed.

Evidence: .konnect/diagnostics/rrx-create-results.json, buck-place-results.json, buck-read-results.json and source generator build_rrx_compatible_request.py. Live disposable U_BUCK_ACCEPT readback contains all30 logical numbers and406 pad objects. Different-function copper bounding-box unions have minimum0.25 mm separation. buck-accepted.svg/buck-accepted-detail.png and both-symbols-acceptance.png were inspected against buck-p3.png, buck-p52.png and buck-p53.png. Pin1 mark is upper left, numbering direction agrees, three power copper regions remain distinct, and NC pin10 is a separate land. Disposable reference text overlaps the center; that layout field issue is not accepted as final silkscreen.

This record does not qualify converter stability, protection behavior, assembly yield, thermal performance or complete PCB readiness. VIN and SW repeated pads must all receive their logical-number net on transfer.
