siimsek/PDU/hardware/validation/ltc4365/cout-hv-symbol.pdf

1 | 2 | 3 | 4 | 5 | 6 1 | 2 | 3 | 4 | 5 | 6 ABCD | ABCD Date:
Size: A4 | Rev:
KiCad E.D.A. 10.0.7 | Id: 1/1

## Title:

## File: Pinmap.kicad_sch

Sheet: / 1 4 | 5 | Q_FINAL CSD18534Q5A | C_TEST 330u

IN 1
IN 2
IN 3 | GND 4 | GND 5
EN/UVLO | | | 6
ITIMER | | | 7
ILIM | | | 8
IMON | 9 RETRY_DLY | 10 NRETRY | 11
LDSTRT | 12 PG | 13 GND 14
dVdt | 15
IN 16 | OUT 17 | OUT 18 | OUT 19 | OUT 20 | OUT 21 | OUT 22 | OUT 23 | OUT 24
IN_EP 25 | GND_EP 26U_EF_ACCEPT

TPS259824ONRGET

VIN4 1
VIN5 2
VIN6 3 | CBOOT 4
SW4 5 | BIAS | 6 PG/SYNCOUT | 7 PFM/SYNCIN | 8
EN/UVLO | 9 NC | 10
ISNS+ | 11
VOUT | 12 CONFIG | 13 RT | 14
EXTCOMP | 15 FB | 16 AGND 17 | VDDA 18 VCC 19

SW1 20
SW2 21
SW3 22 | PGND1 23 | PGND2 24 | PGND3 25 | PGND4 26

VIN1 27
VIN2 28
VIN3 29 | PGND 30 | U_BUCK_ACCEPT Vin | LM70880QRRXRQ1 1 | UV 2 | OV 3 | GND 4

SHDN 5

FAULT | 6
Vout | 7 GATE 8 U_TEST LTC4365HTS8-1#TRMPBF | 1 4 | 5 | Q_TEST BSC160N10NS3G
C_HV_ACCEPT 22u | U_EF_ACCEPT

TPS259824ONRGET

IN 1
IN 2
IN 3 | GND 4 | GND 5
EN/UVLO | | | 6
ITIMER | | | 7
ILIM | | | 8
IMON | 9 RETRY_DLY | 10 NRETRY | 11
LDSTRT | 12 PG | 13 GND 14
dVdt | 15
IN 16 | OUT 17 | OUT 18 | OUT 19 | OUT 20 | OUT 21 | OUT 22 | OUT 23 | OUT 24
IN_EP 25 | GND_EP 26 C_HV_ACCEPT 22u
