siimsek/PDU/hardware/validation/c5750/public-dc-bias-digitized.csv

voltage_V | delta_pct | pdf_drawing_index
-0.000578 | -0.108712 | 25
3.990261 | 2.826076 | 27
6.330280 | 1.413028 | 29
9.976501 | -2.065229 | 31
15.962742 | -9.347838 | 33
24.977083 | -21.956530 | 35
34.953568 | -36.630445 | 37
49.954150 | -54.347831 | 39
74.931216 | -70.978264 | 41
99.977087 | -79.673920 | 43
