siimsek/PDU/hardware/validation/c5750-characteristics.png

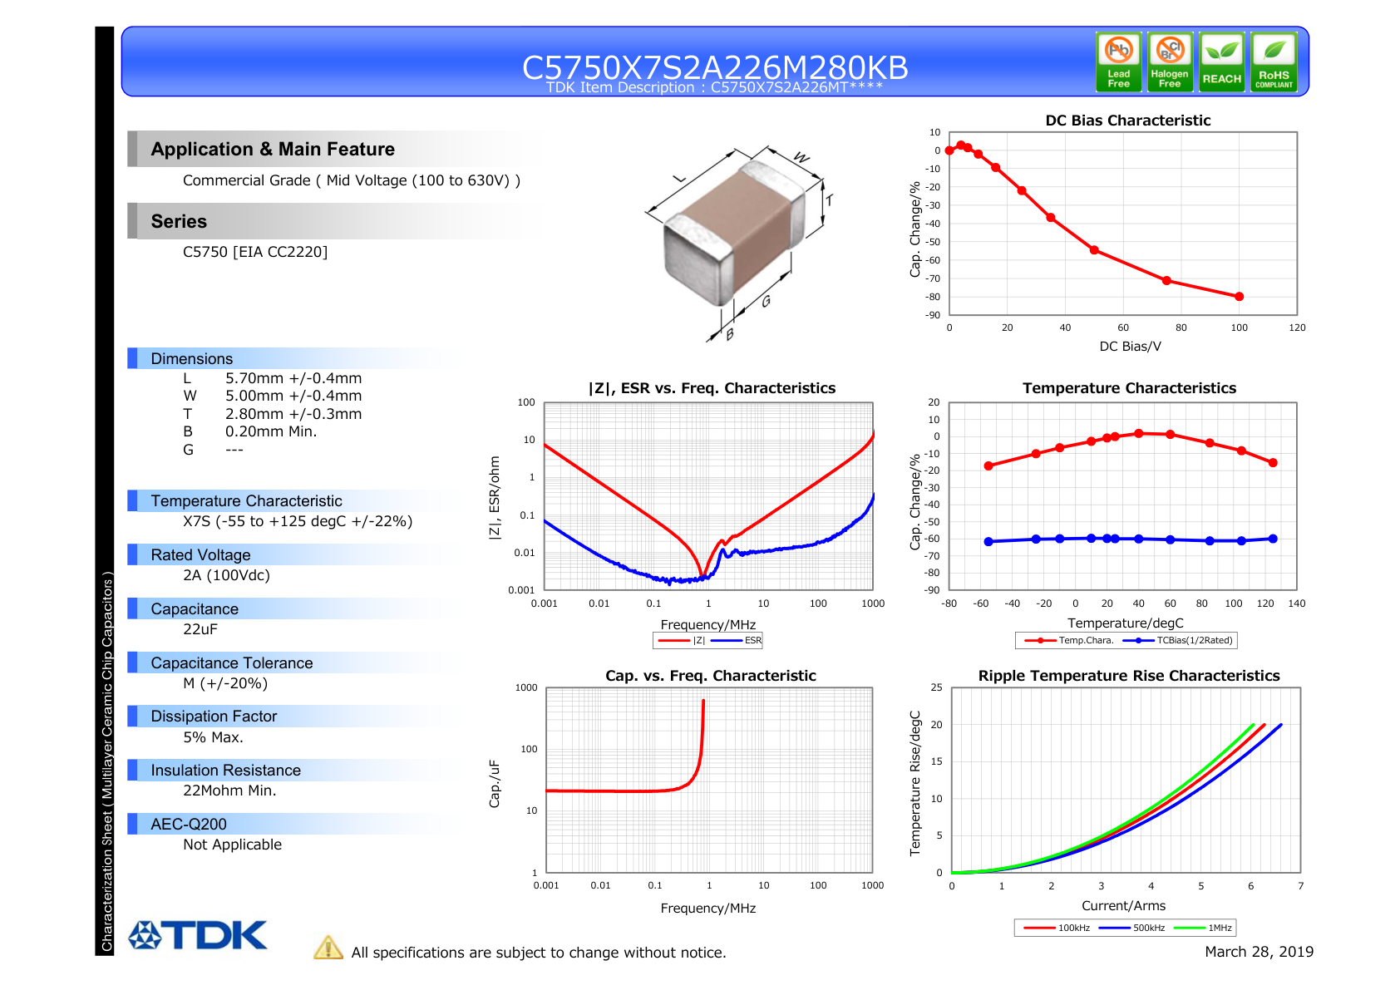
hardware/validation/c5750-characteristics.png
