siimsek/PDU/hardware/validation/c5750-land-definition.png

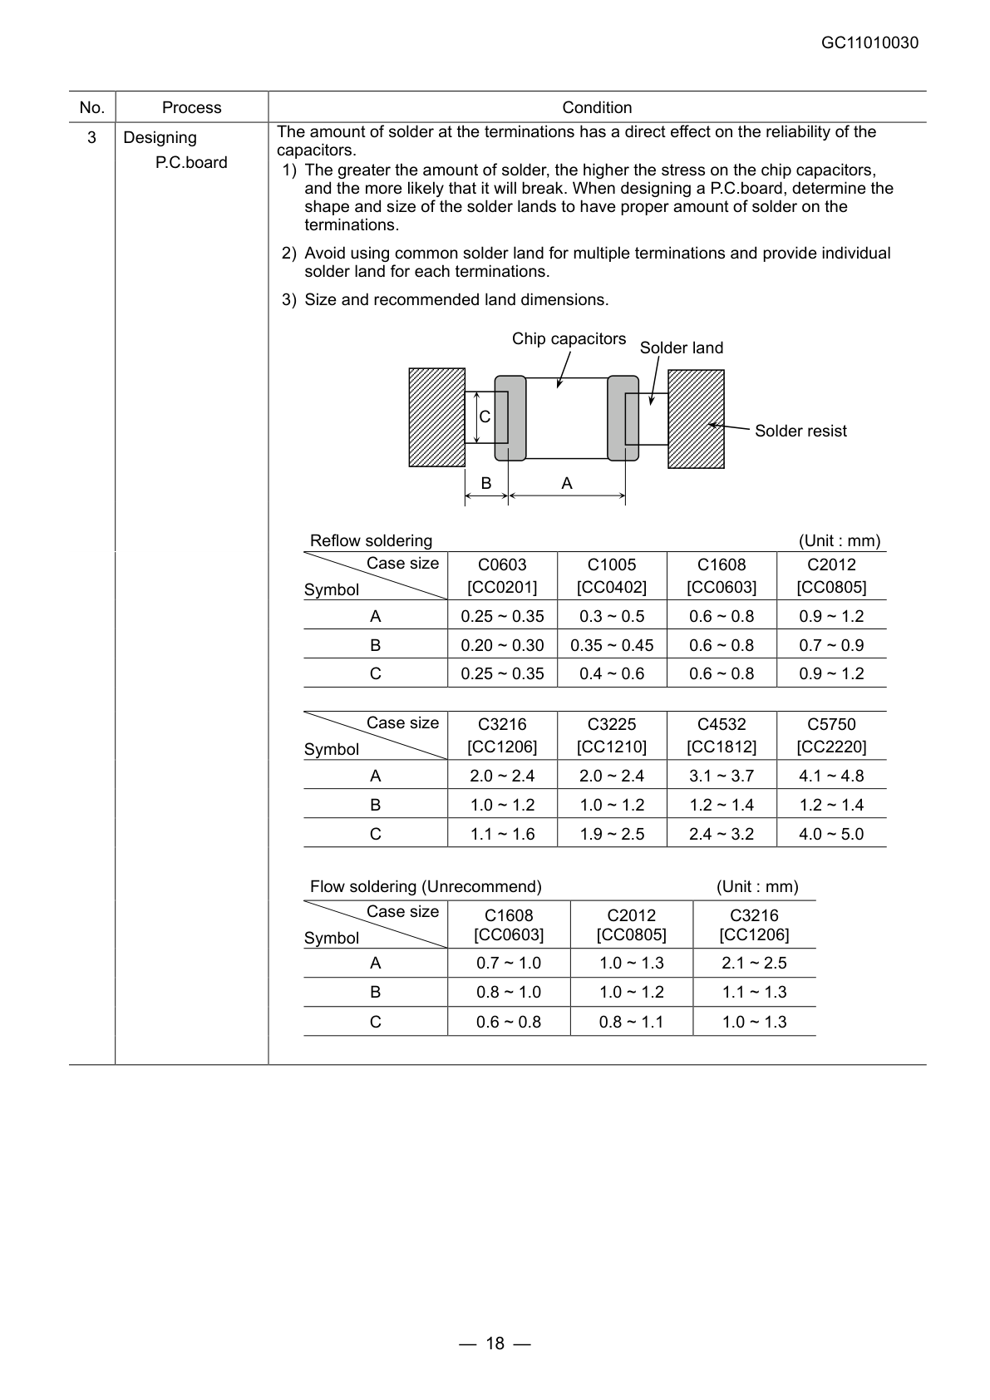
hardware/validation/c5750-land-definition.png
