siimsek/PDU/hardware/validation/ltc4365/bsc160-p1.png

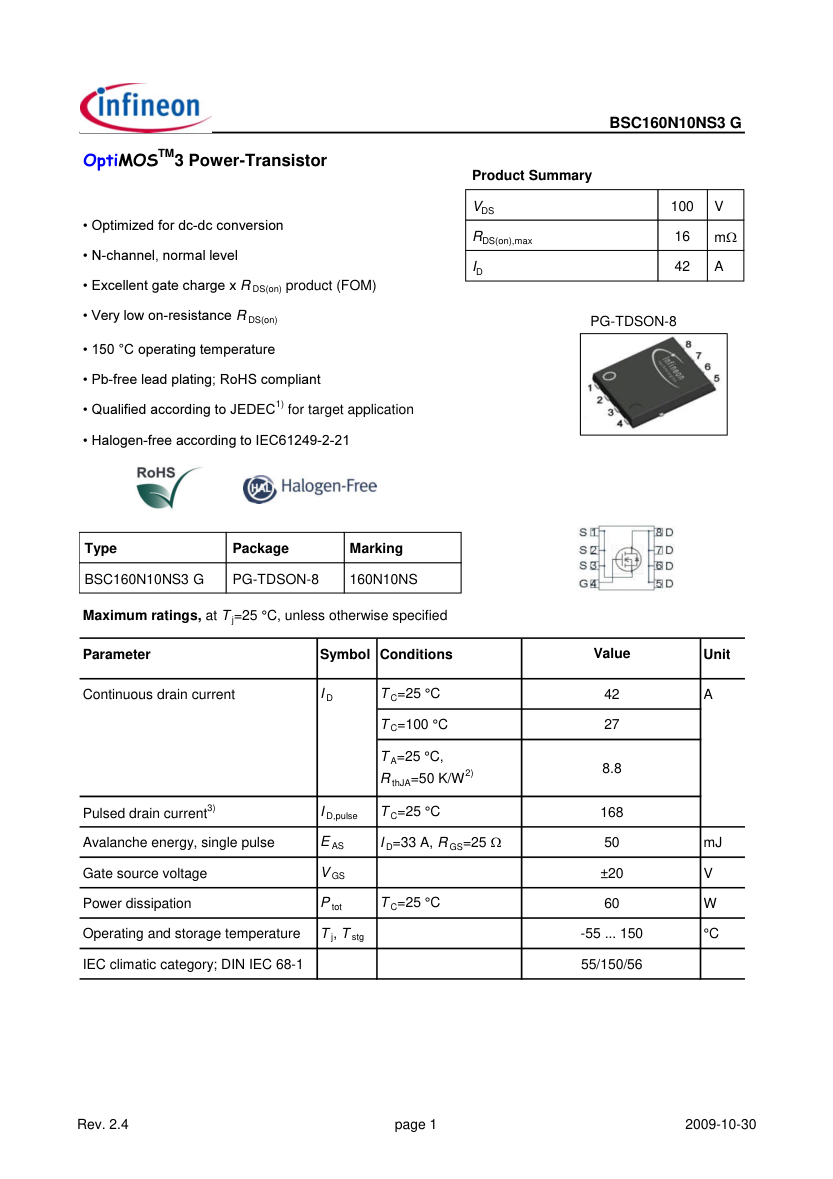
hardware/validation/ltc4365/bsc160-p1.png
