siimsek/PDU/hardware/validation/ltc4365/bsc160-p8.png

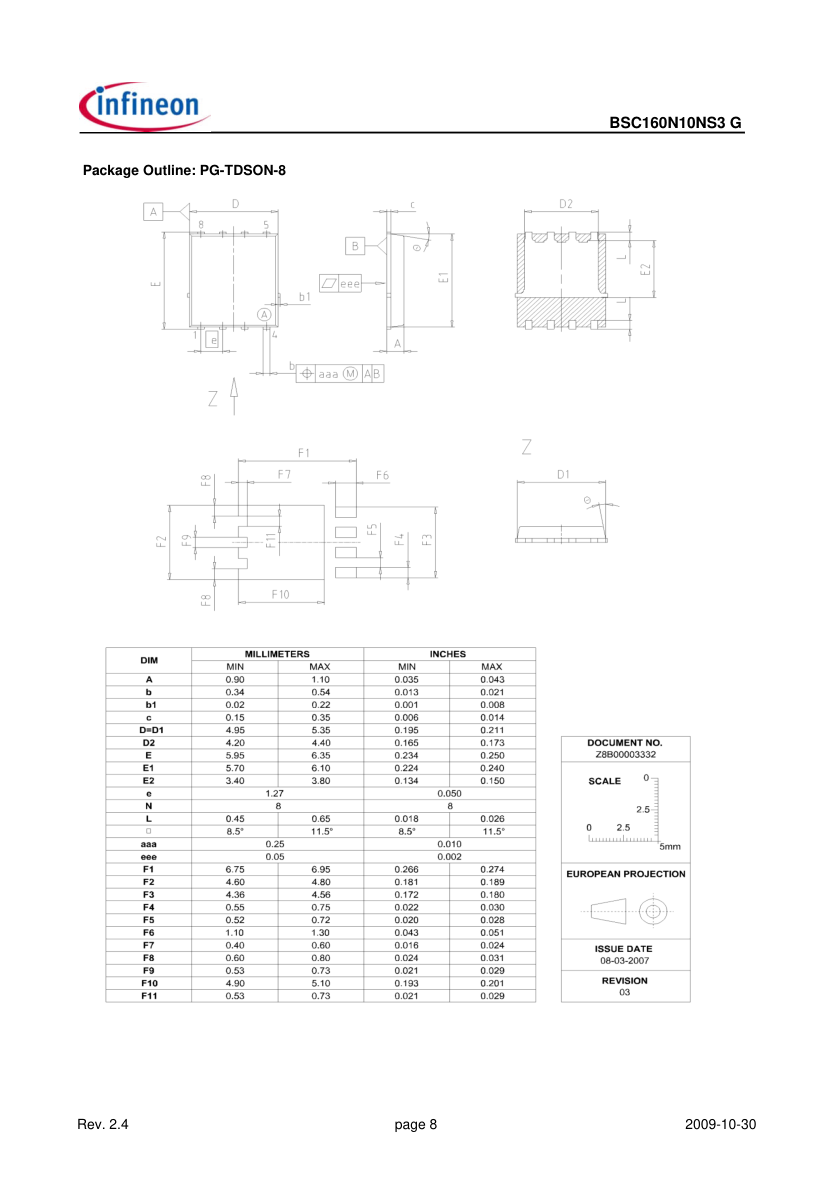
hardware/validation/ltc4365/bsc160-p8.png
