siimsek/PDU/hardware/validation/ltc4365/c-accepted.png

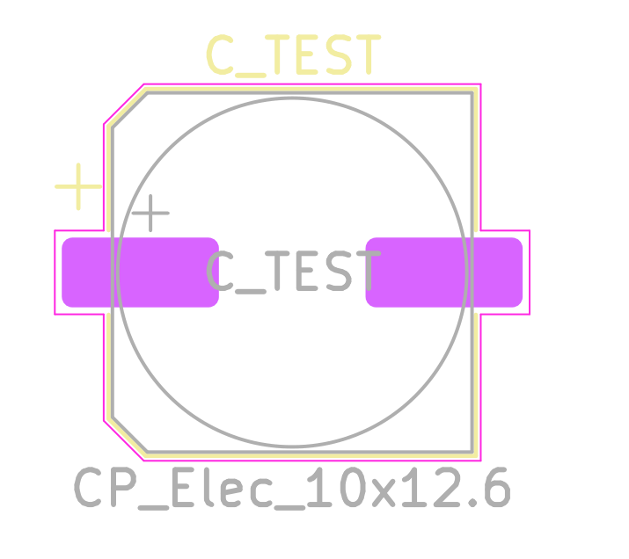
hardware/validation/ltc4365/c-accepted.png
