siimsek/PDU/hardware/validation/ltc4365/cout-hv-accepted.png

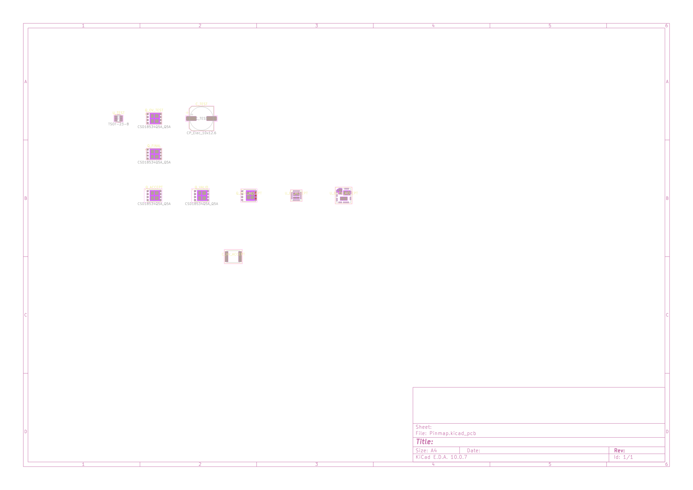
hardware/validation/ltc4365/cout-hv-accepted.png
