siimsek/PDU/hardware/validation/ltc4365/cout-hv-detail.png

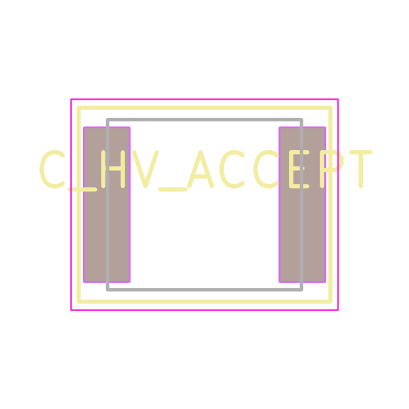
hardware/validation/ltc4365/cout-hv-detail.png
