siimsek/PDU/hardware/validation/ltc4365/cout-hv-symbol.png

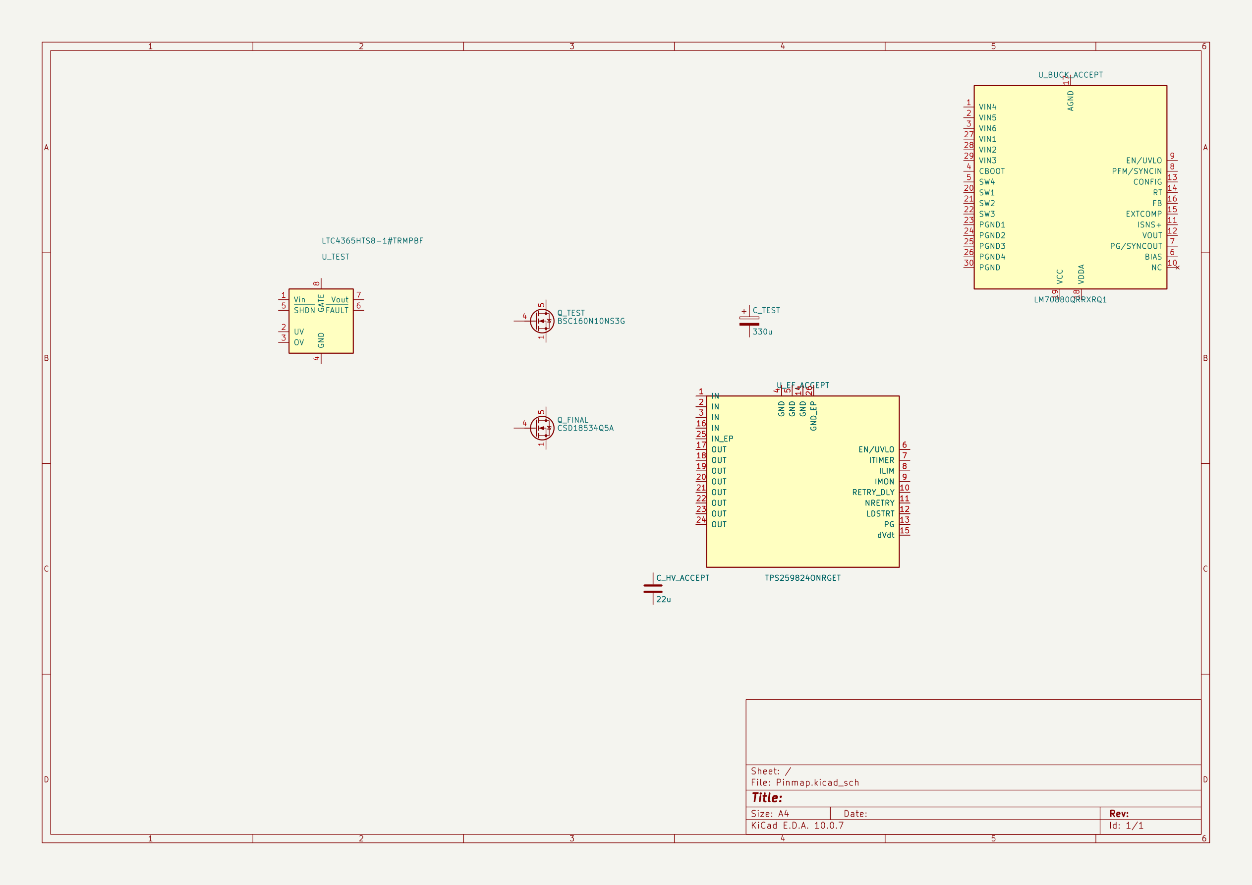
hardware/validation/ltc4365/cout-hv-symbol.png
