siimsek/PDU/hardware/validation/ltc4365/csd18534q5a-p1.png

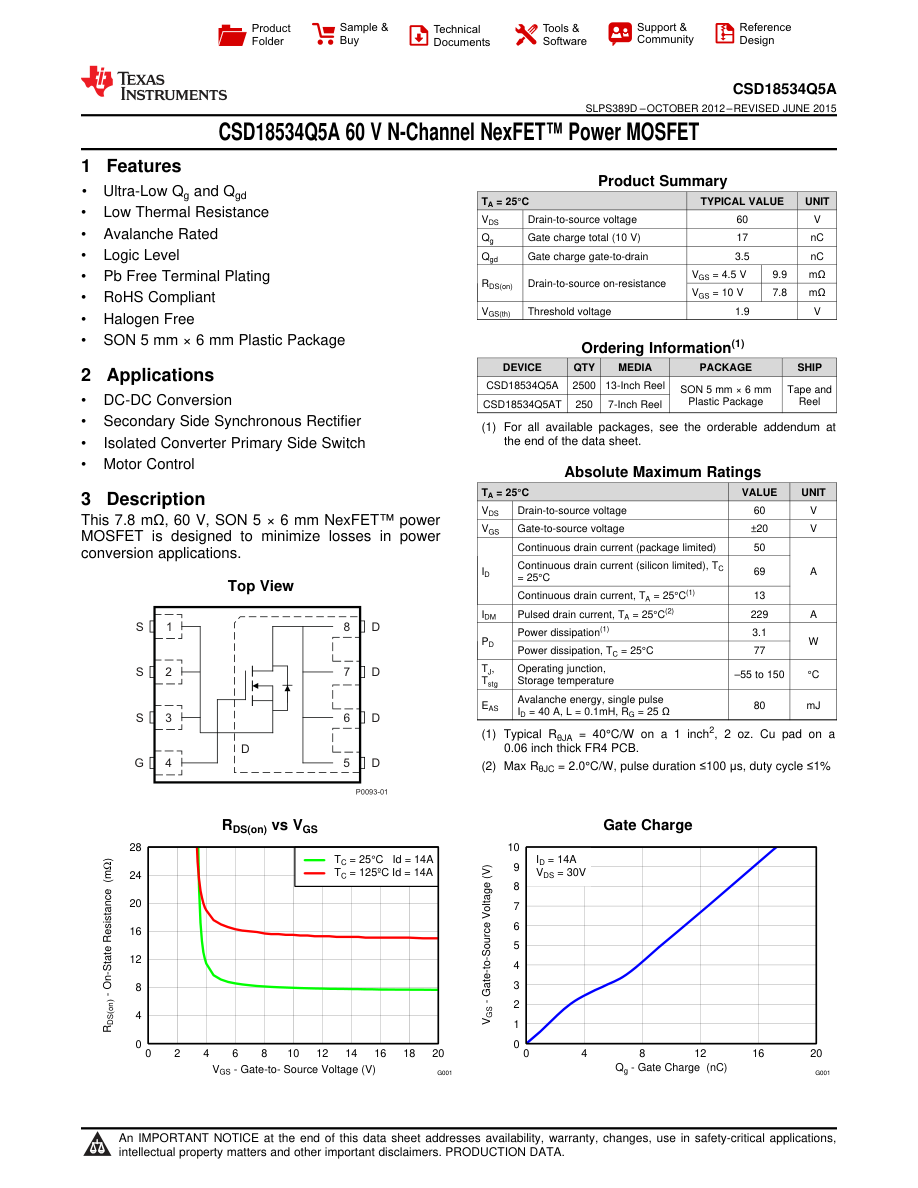
hardware/validation/ltc4365/csd18534q5a-p1.png
