siimsek/PDU/hardware/validation/ltc4365/csd18534q5a-p6.png

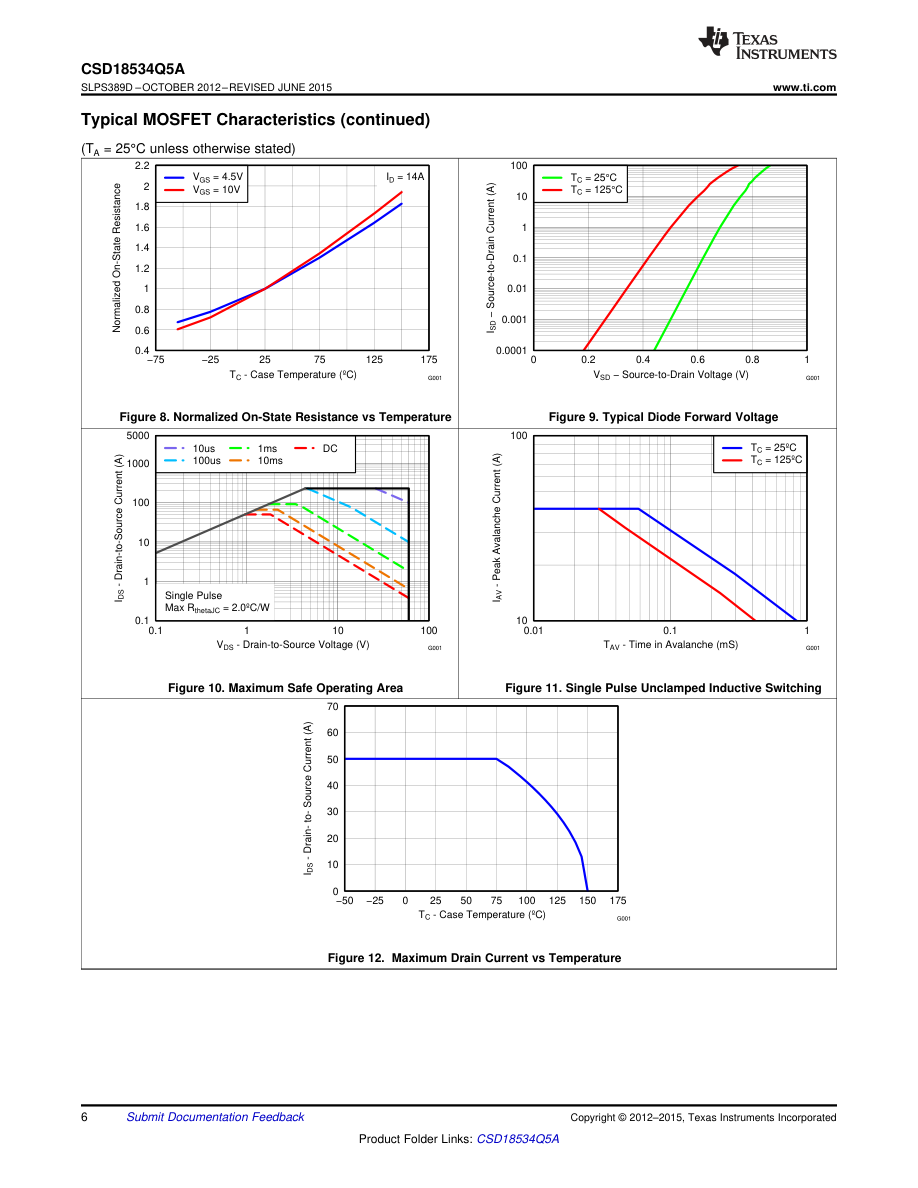
hardware/validation/ltc4365/csd18534q5a-p6.png
