siimsek/PDU/hardware/validation/ltc4365/pinmap-detail.png

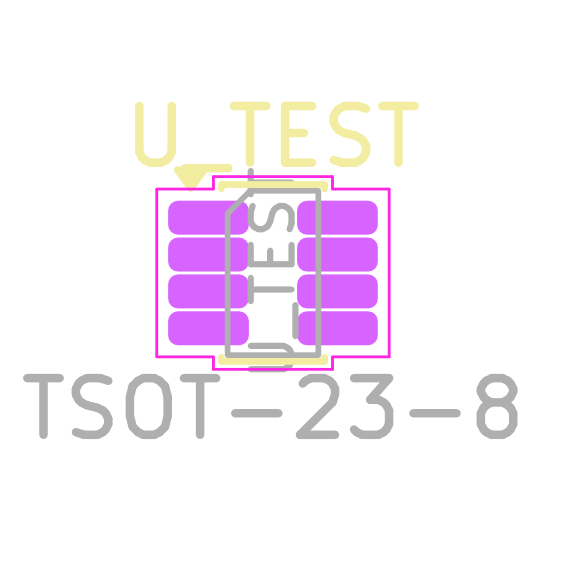
hardware/validation/ltc4365/pinmap-detail.png
