siimsek/PDU/hardware/validation/ltc4365/q1-accepted-detail.png

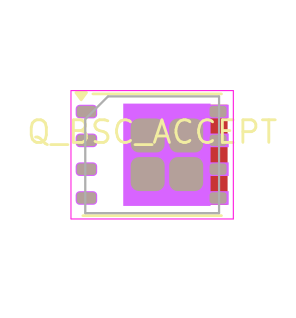
hardware/validation/ltc4365/q1-accepted-detail.png
