siimsek/PDU/hardware/validation/ltc4365/q1-symbols.png

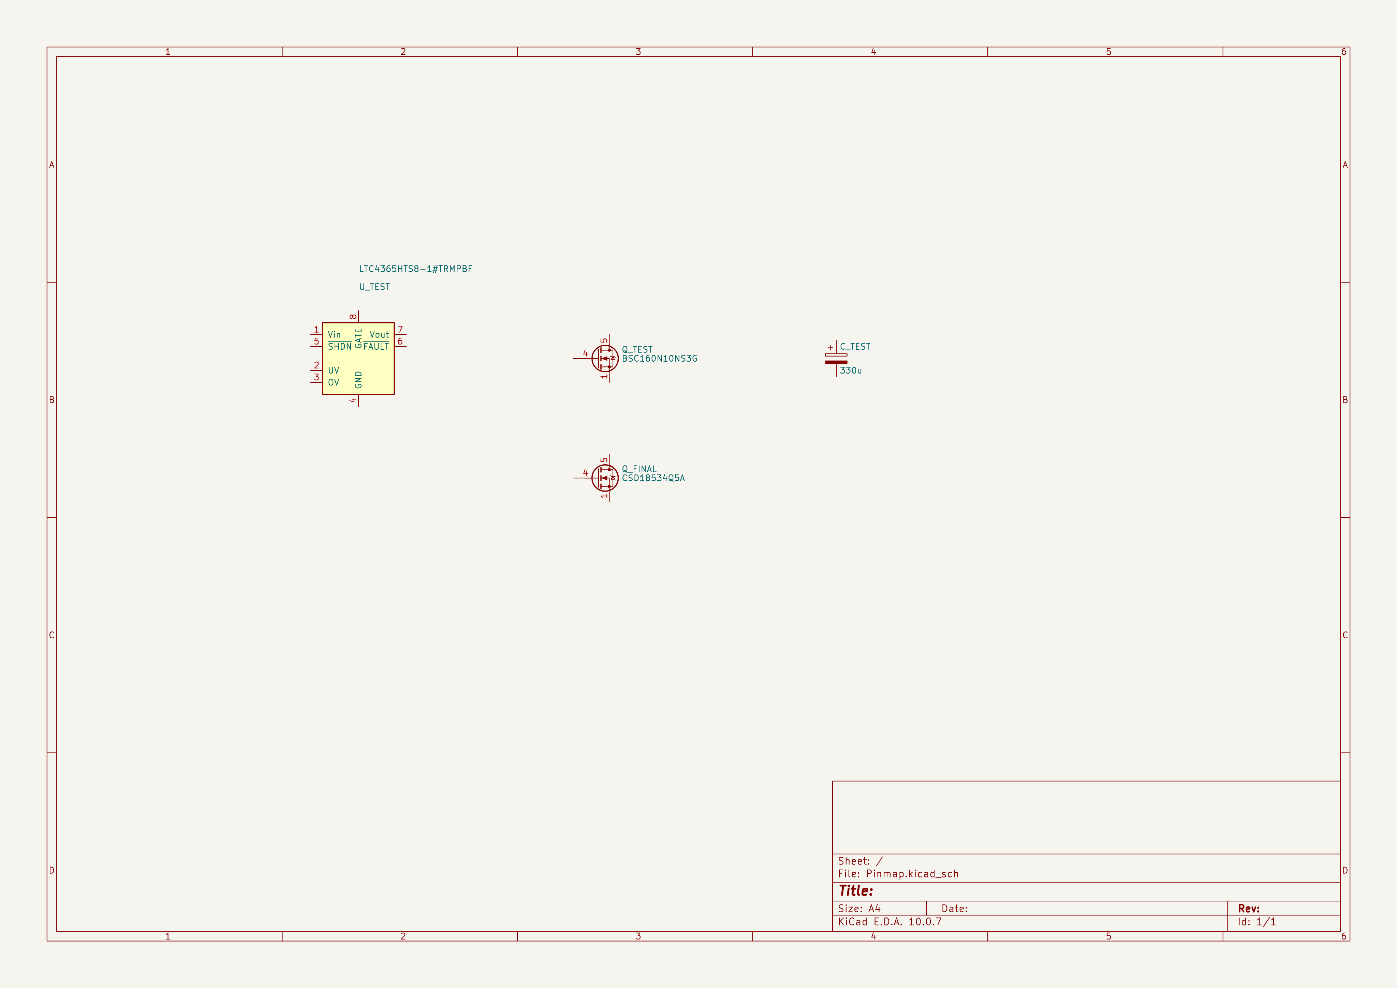
hardware/validation/ltc4365/q1-symbols.png
