siimsek/PDU/hardware/validation/ltc4365/q-accepted.png

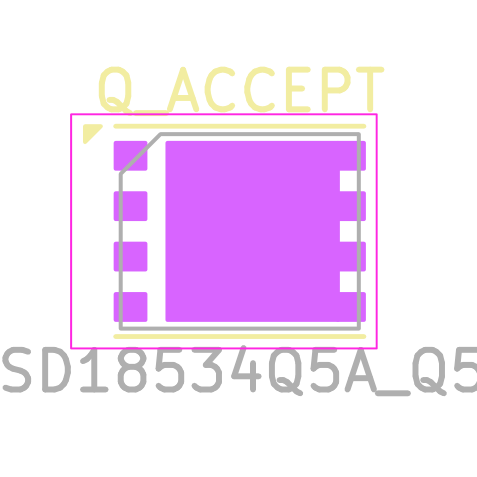
hardware/validation/ltc4365/q-accepted.png
