siimsek/PDU/hardware/validation/ltc4365/q-final-inspected.png

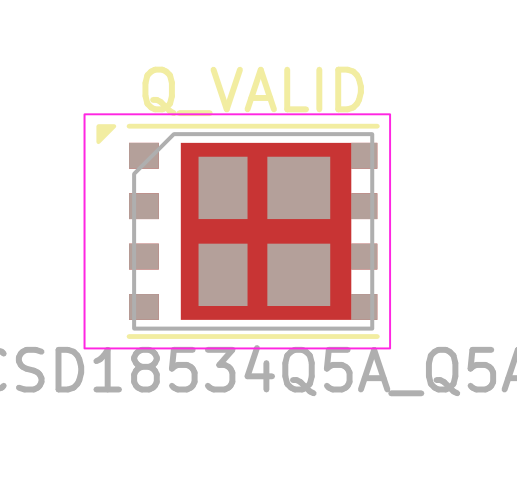
hardware/validation/ltc4365/q-final-inspected.png
