siimsek/PDU/hardware/validation/ltc4365/svpf-land-p1.png

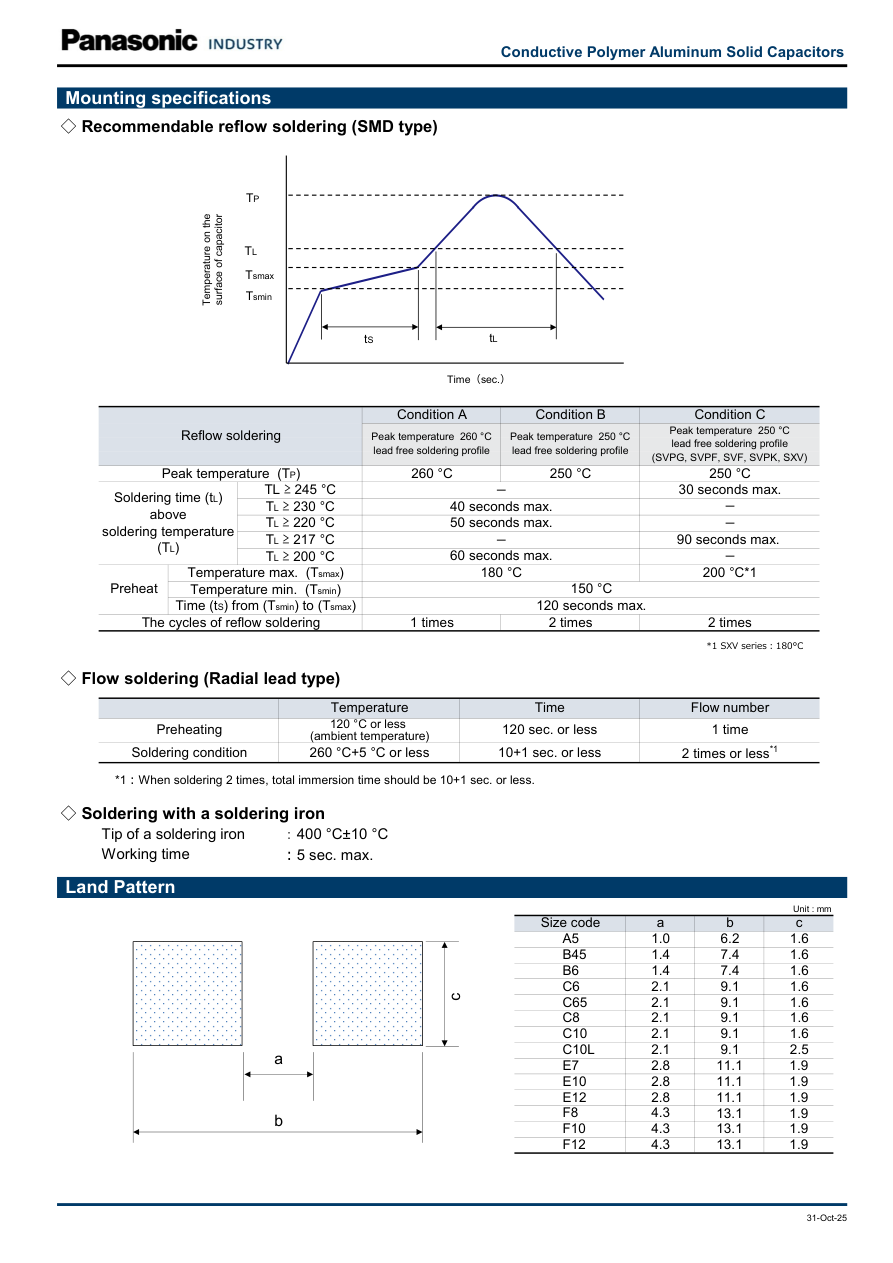
hardware/validation/ltc4365/svpf-land-p1.png
