siimsek/PDU/hardware/validation/ltc4365/svpf-p1.png

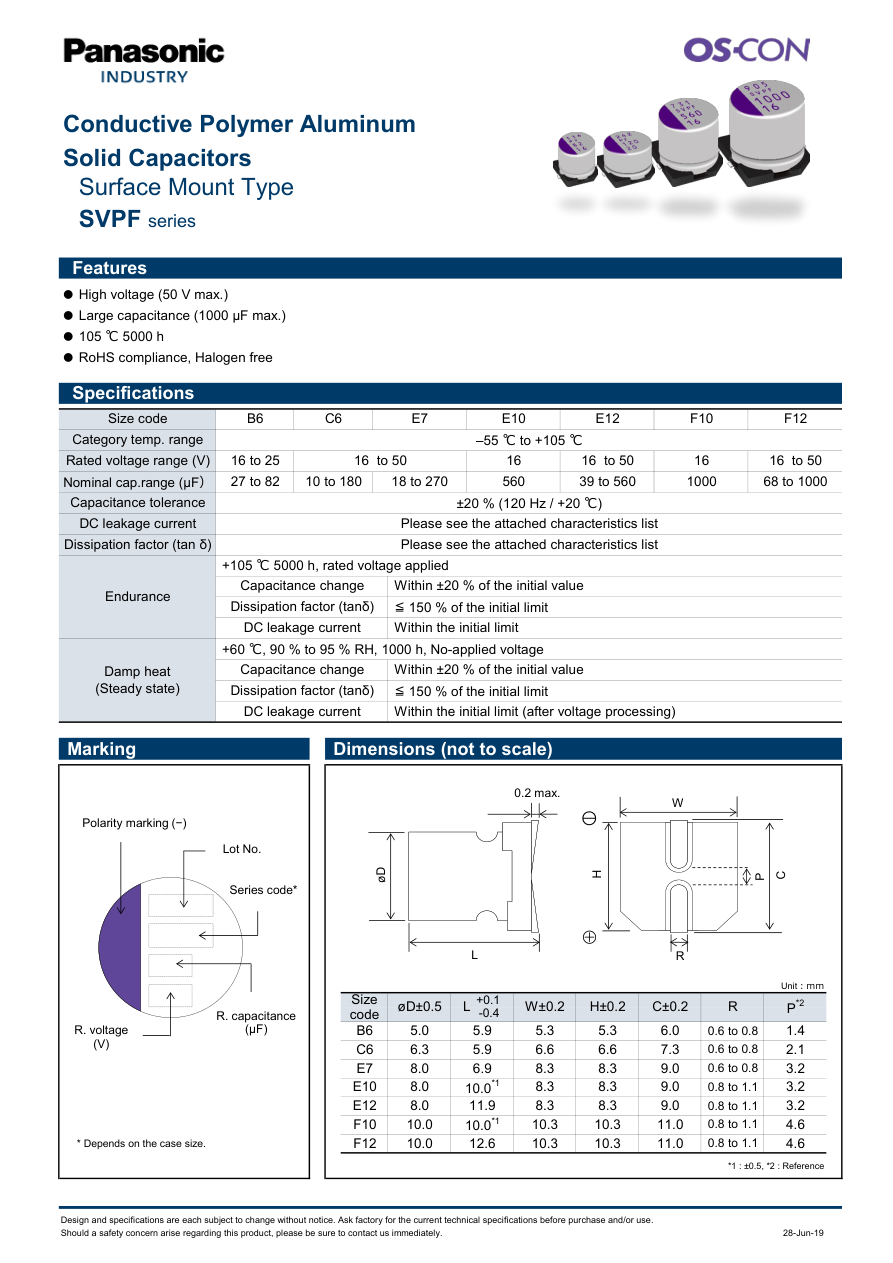
hardware/validation/ltc4365/svpf-p1.png
