siimsek/PDU/hardware/validation/ltc4365/symbol.png

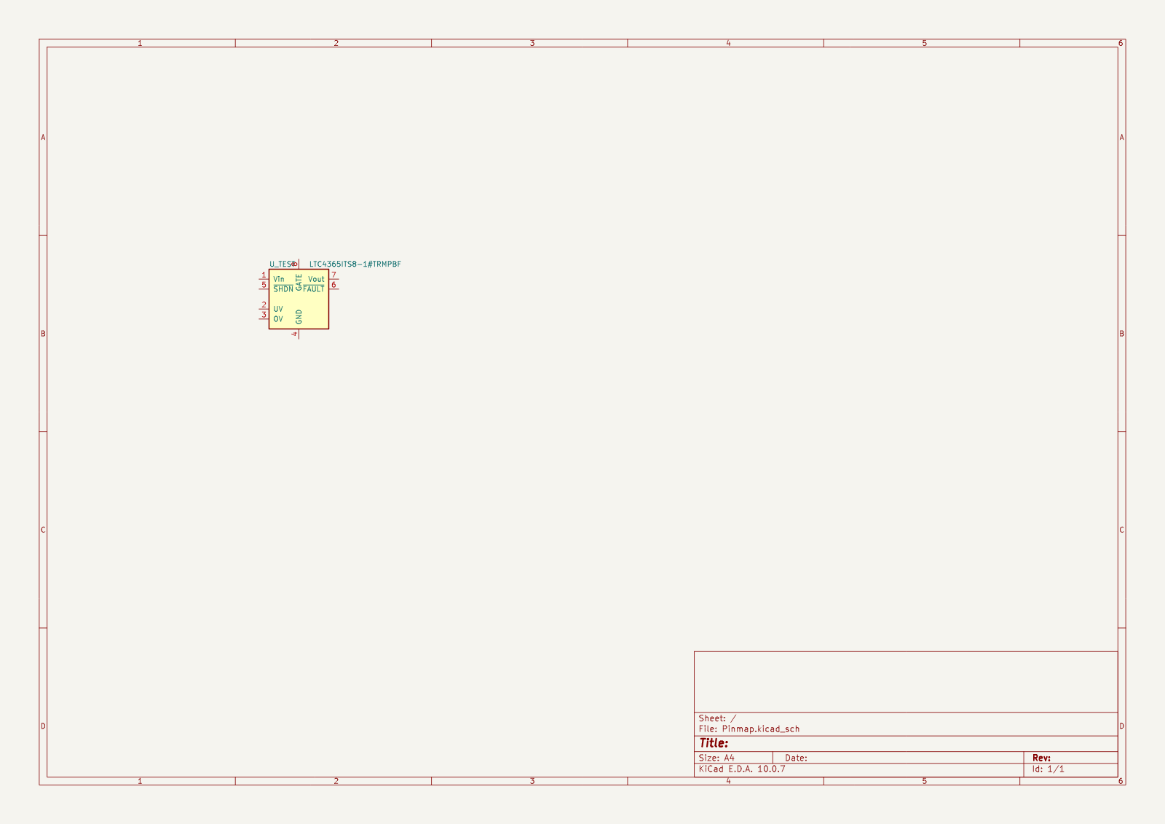
hardware/validation/ltc4365/symbol.png
