siimsek/PDU/hardware/validation/ltc4365/symbols-accepted.png

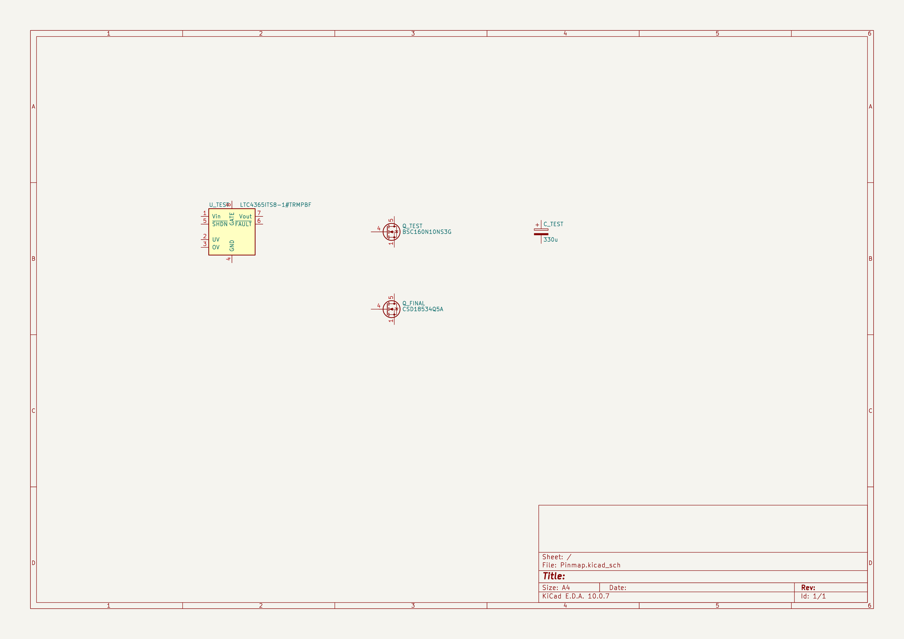
hardware/validation/ltc4365/symbols-accepted.png
