siimsek/PDU/hardware/validation/ltc4365/u-accepted.png

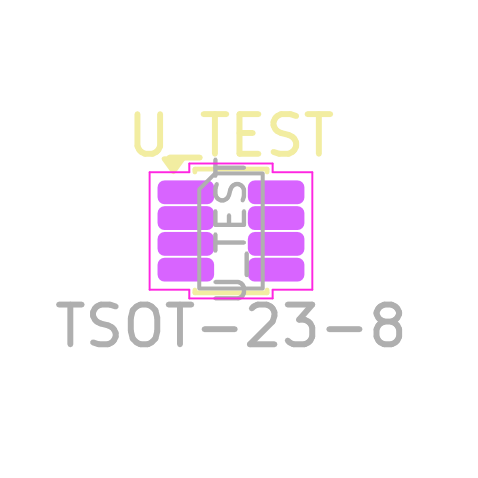
hardware/validation/ltc4365/u-accepted.png
