siimsek/PDU/hardware/validation/power-ics/both-symbols-acceptance.png

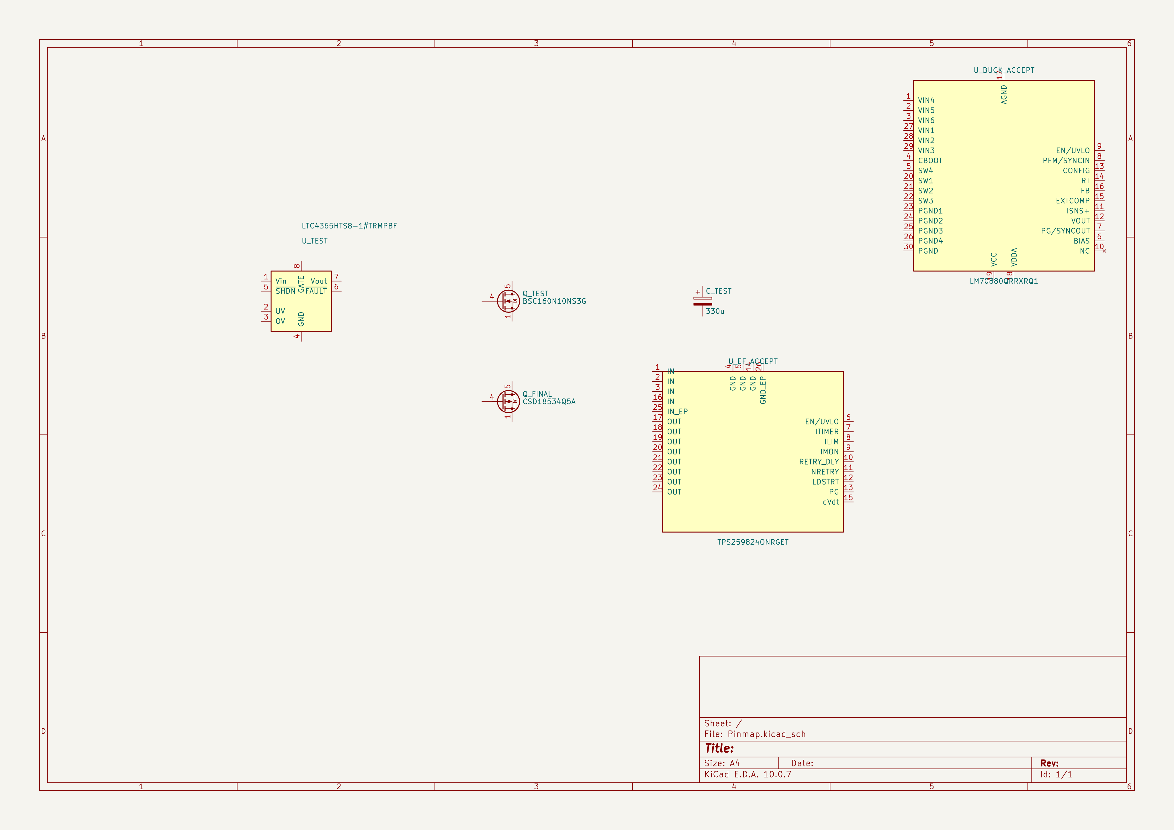
hardware/validation/power-ics/both-symbols-acceptance.png
