siimsek/PDU/hardware/validation/power-ics/buck-accepted-detail.png

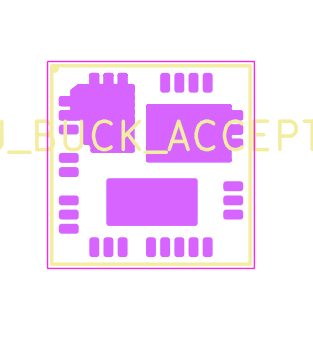
hardware/validation/power-ics/buck-accepted-detail.png
