siimsek/PDU/hardware/validation/power-ics/buck-p3.png

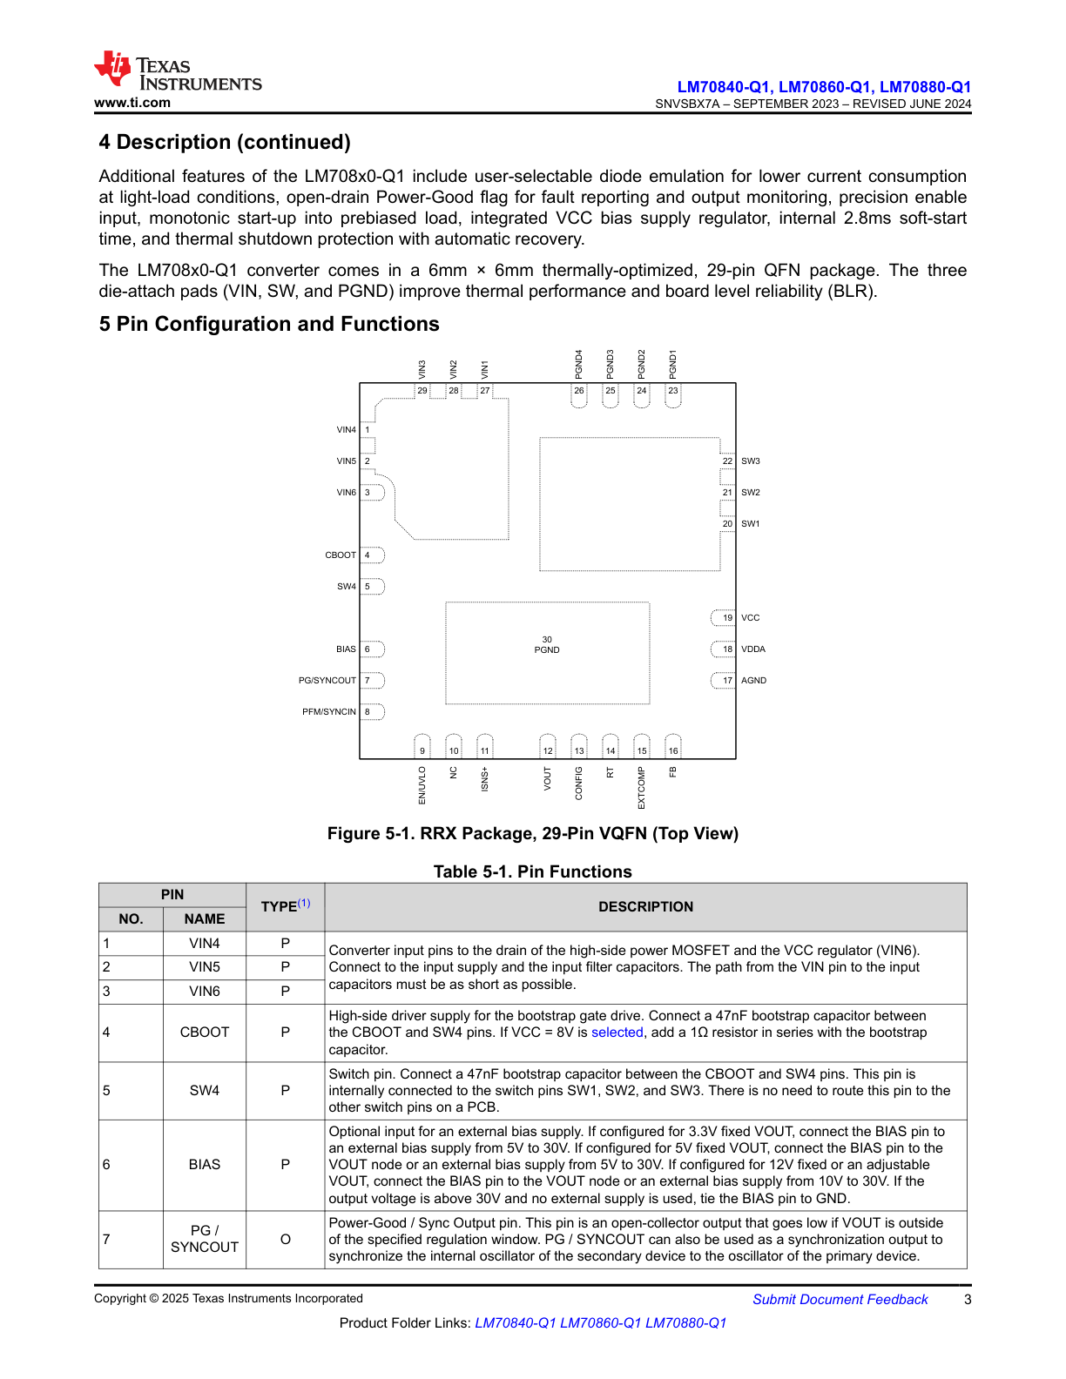
hardware/validation/power-ics/buck-p3.png
