siimsek/PDU/hardware/validation/power-ics/buck-vin-detail.png

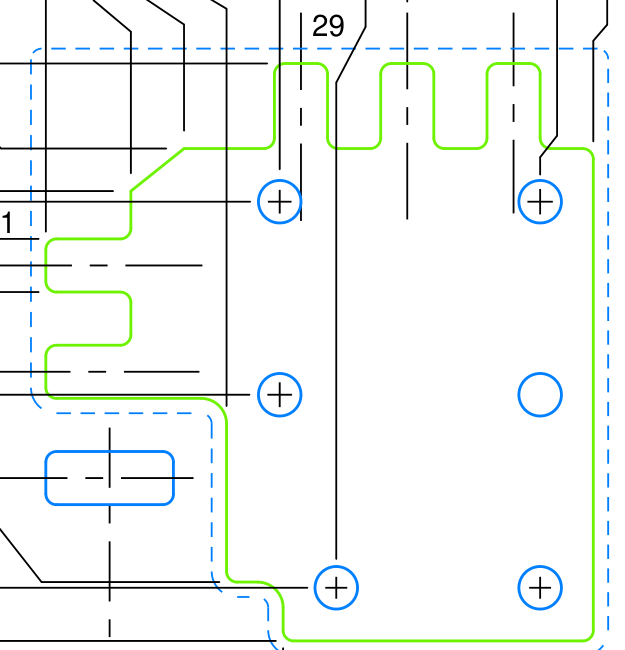
hardware/validation/power-ics/buck-vin-detail.png
