siimsek/PDU/hardware/validation/power-ics/efuse-accepted-detail.png

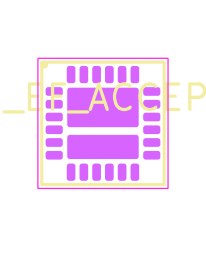
hardware/validation/power-ics/efuse-accepted-detail.png
