siimsek/PDU/hardware/validation/power-ics/efuse-p5.png

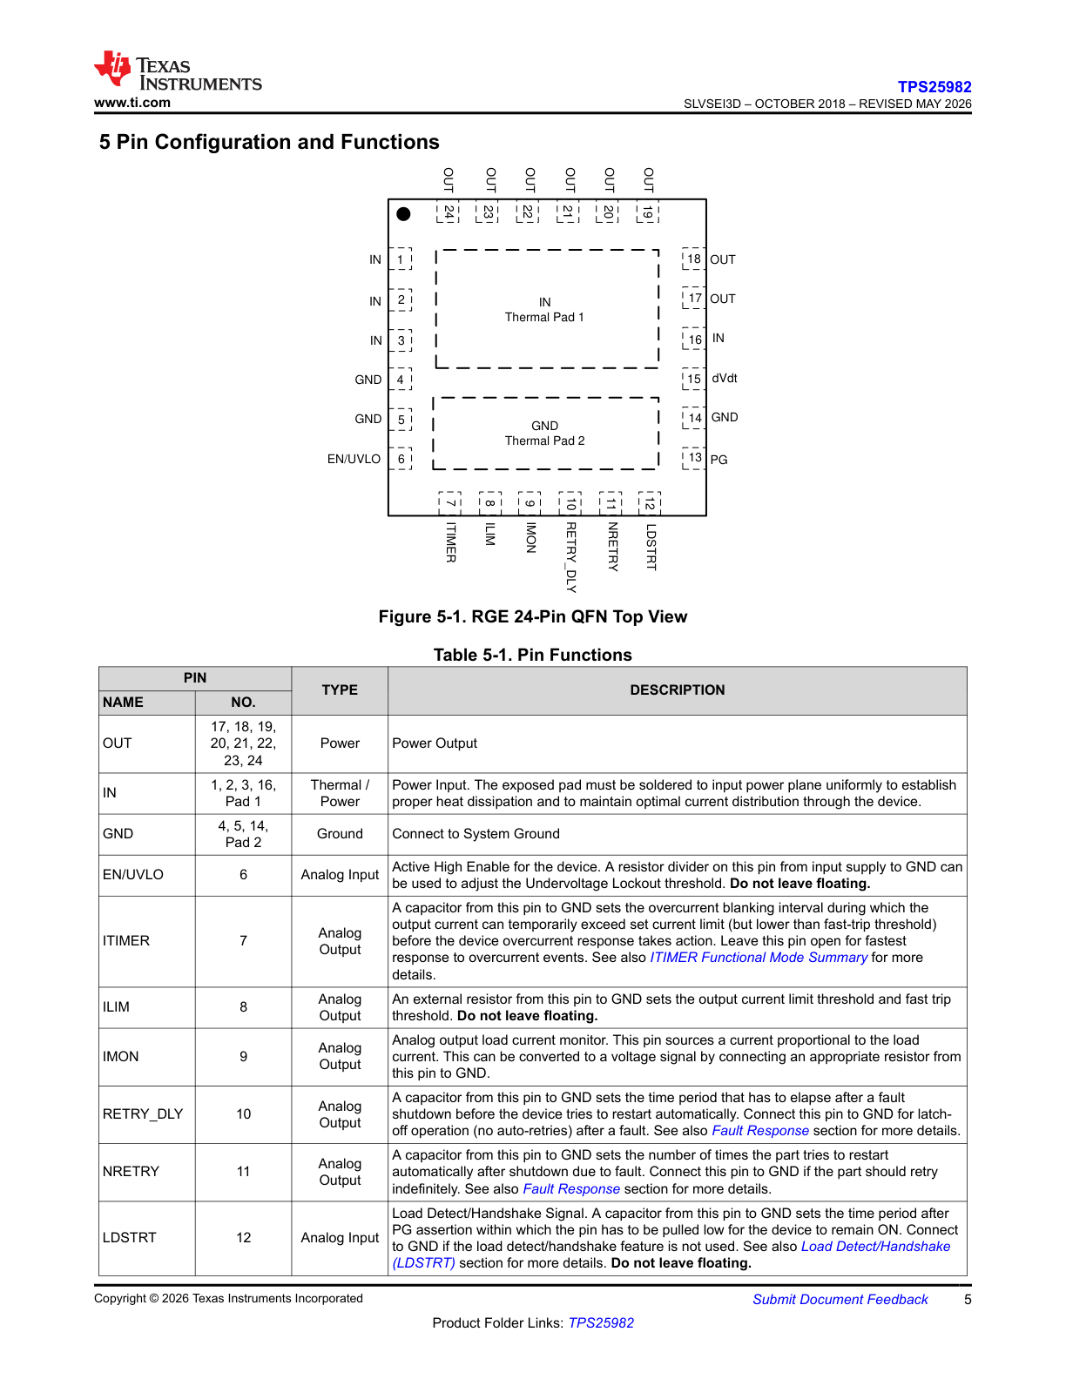
hardware/validation/power-ics/efuse-p5.png
