siimsek/PDU/hardware/validation/power-ics/efuse-p55.png

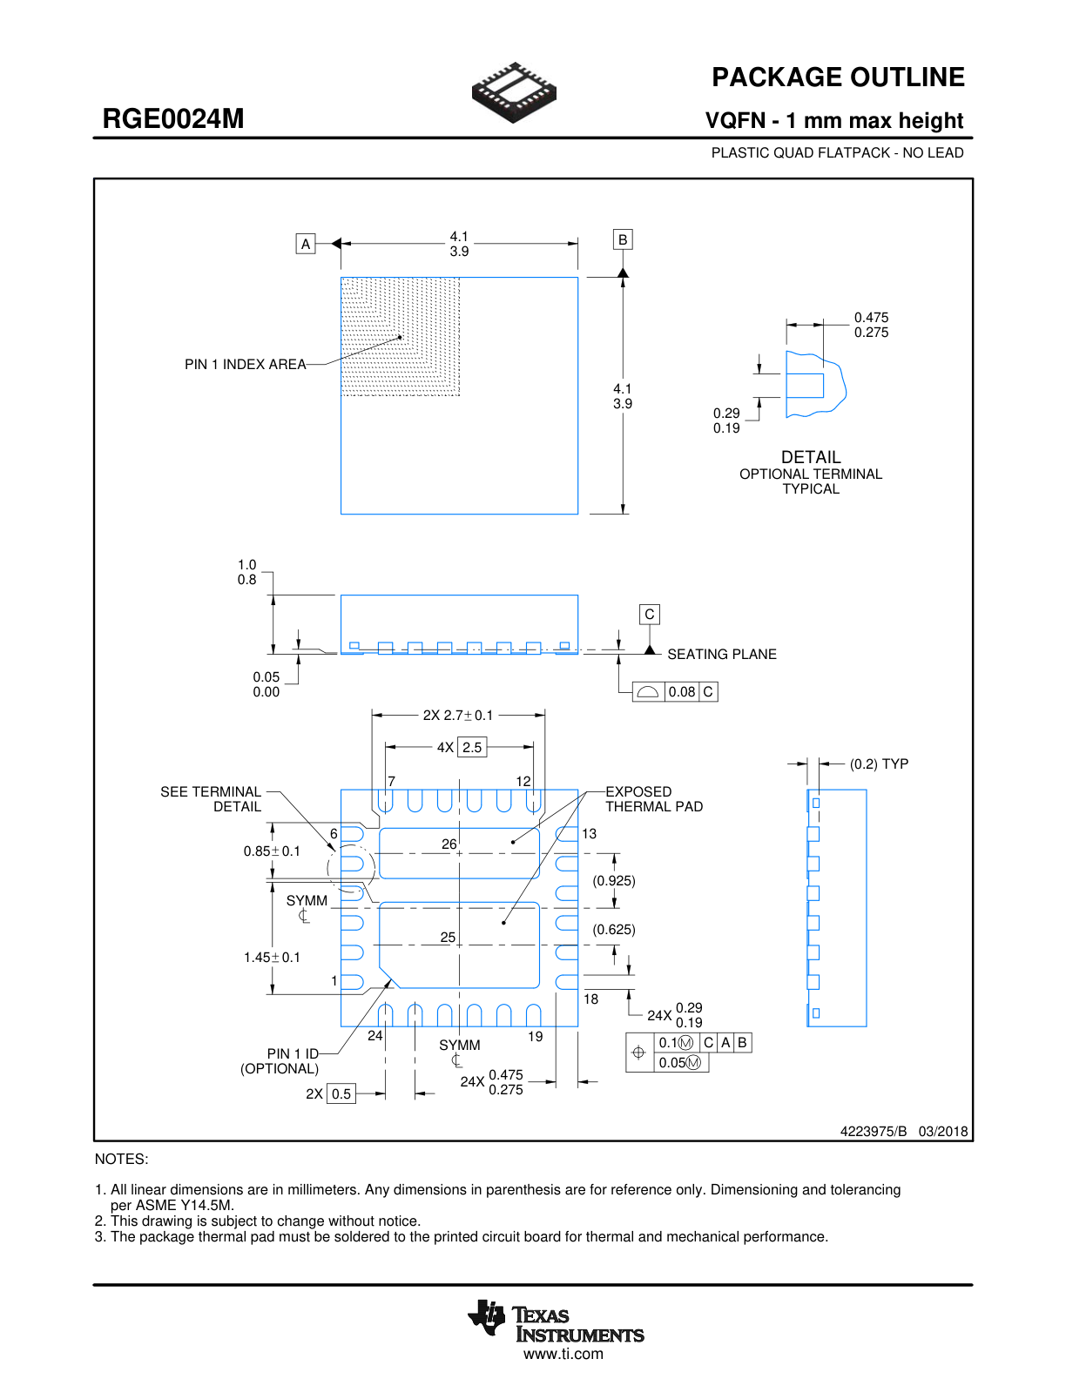
hardware/validation/power-ics/efuse-p55.png
