siimsek/PDU/hardware/validation/power-ics/efuse-p56.png

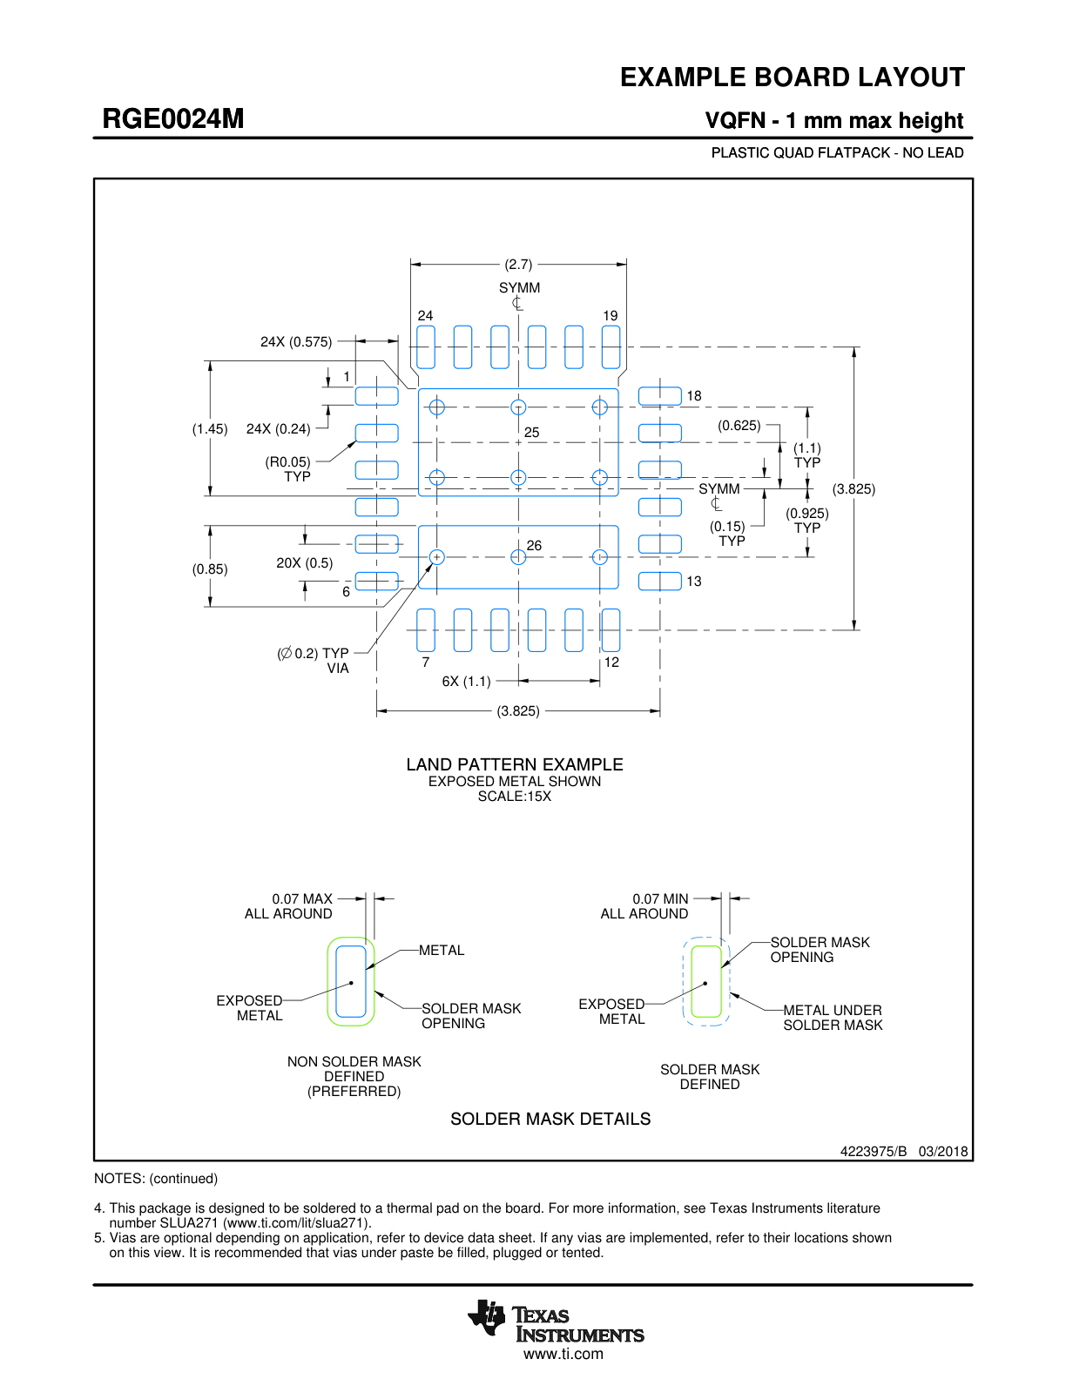
hardware/validation/power-ics/efuse-p56.png
