siimsek/PDU/hardware/validation/power-ics/efuse-p57.png

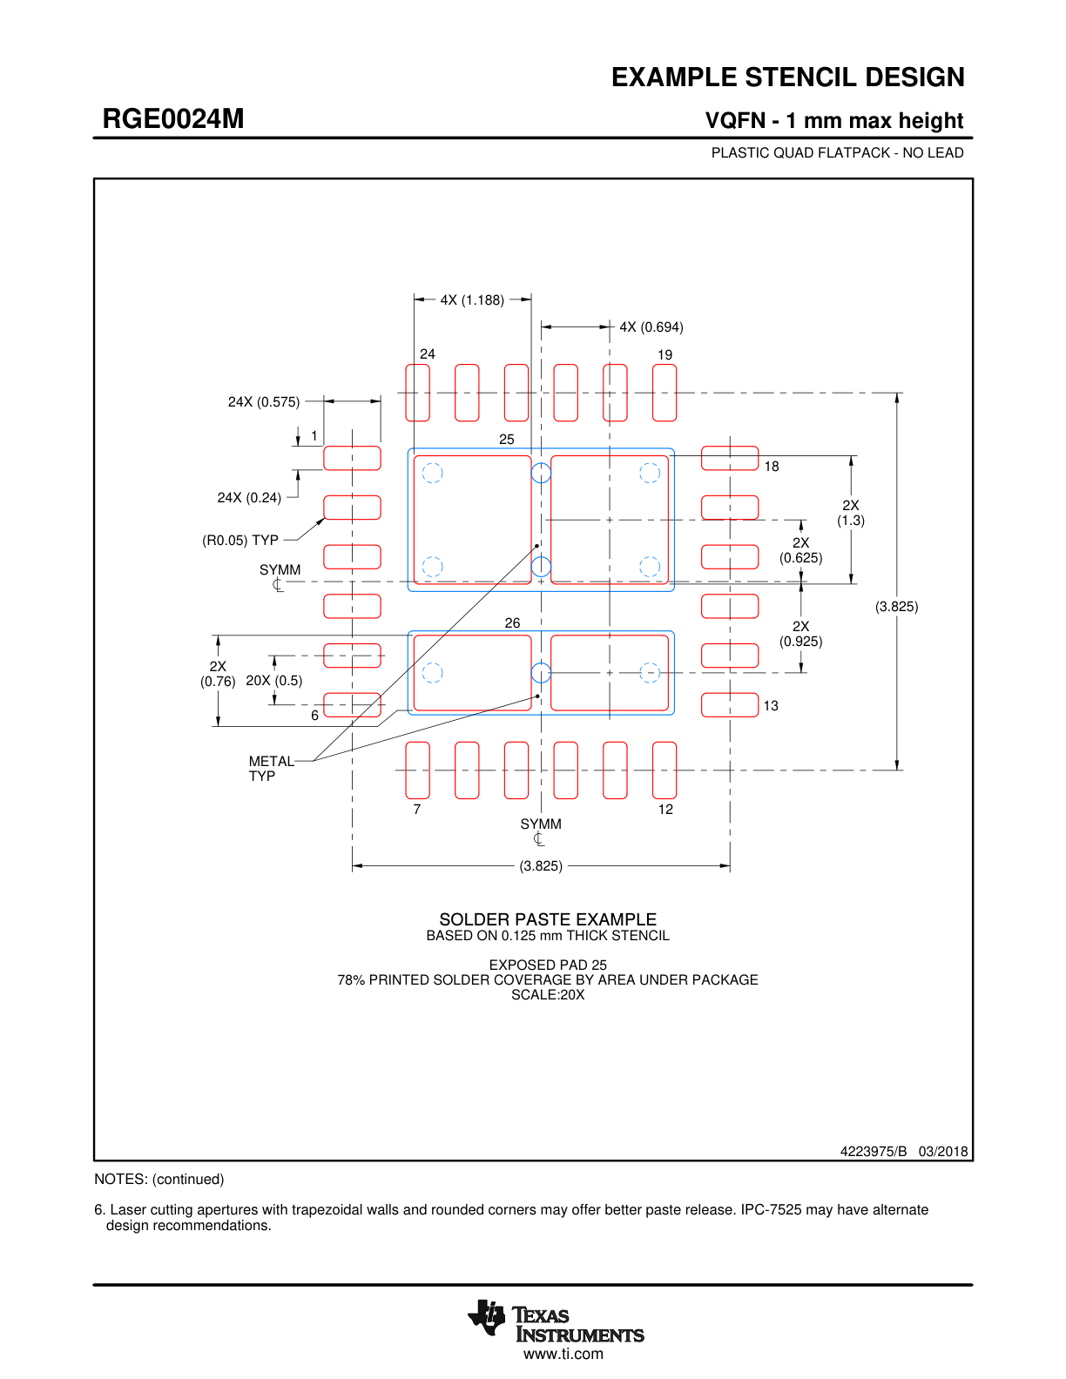
hardware/validation/power-ics/efuse-p57.png
