siimsek/PDU/hardware/validation/power-ics/symbols-acceptance.png

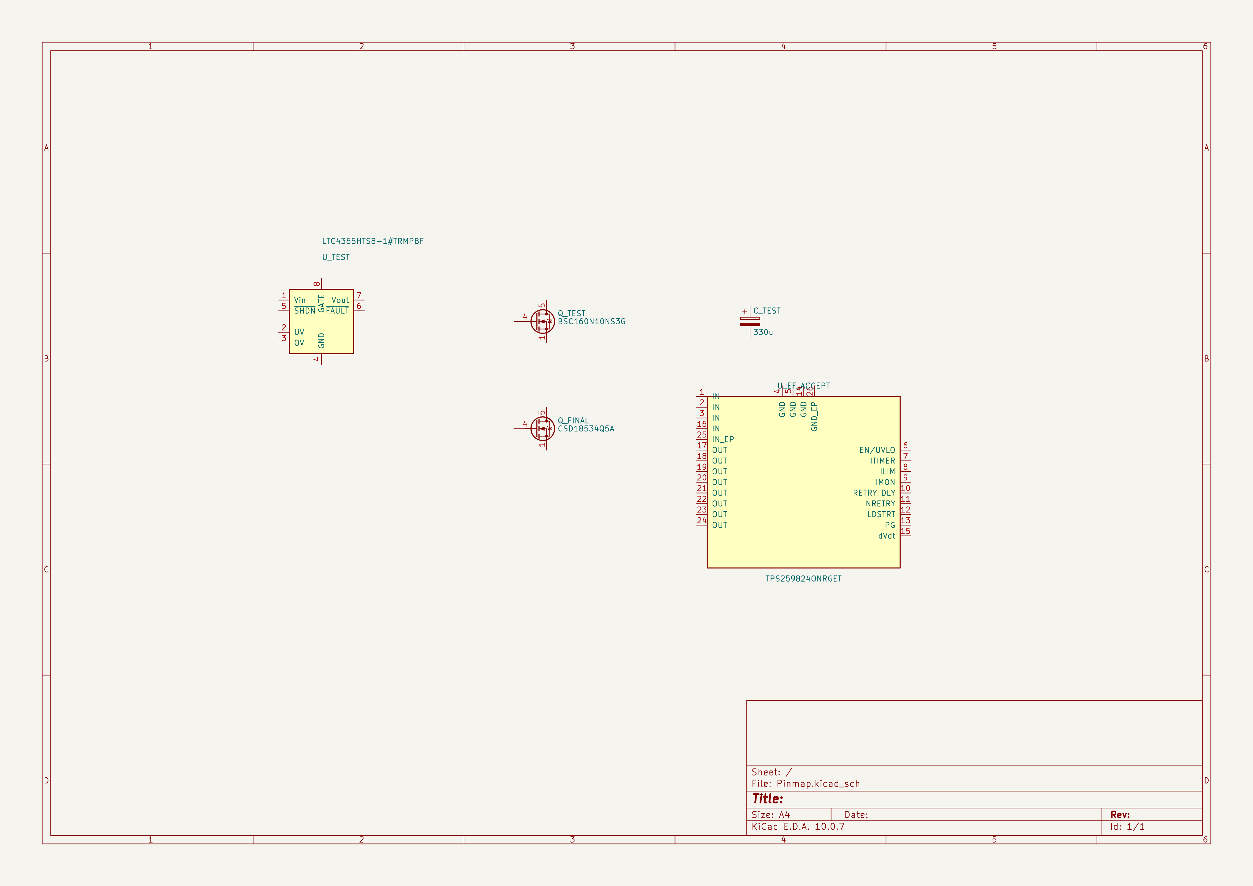
hardware/validation/power-ics/symbols-acceptance.png
