siimsek/PDU/PDU_schematic_finished.pdf

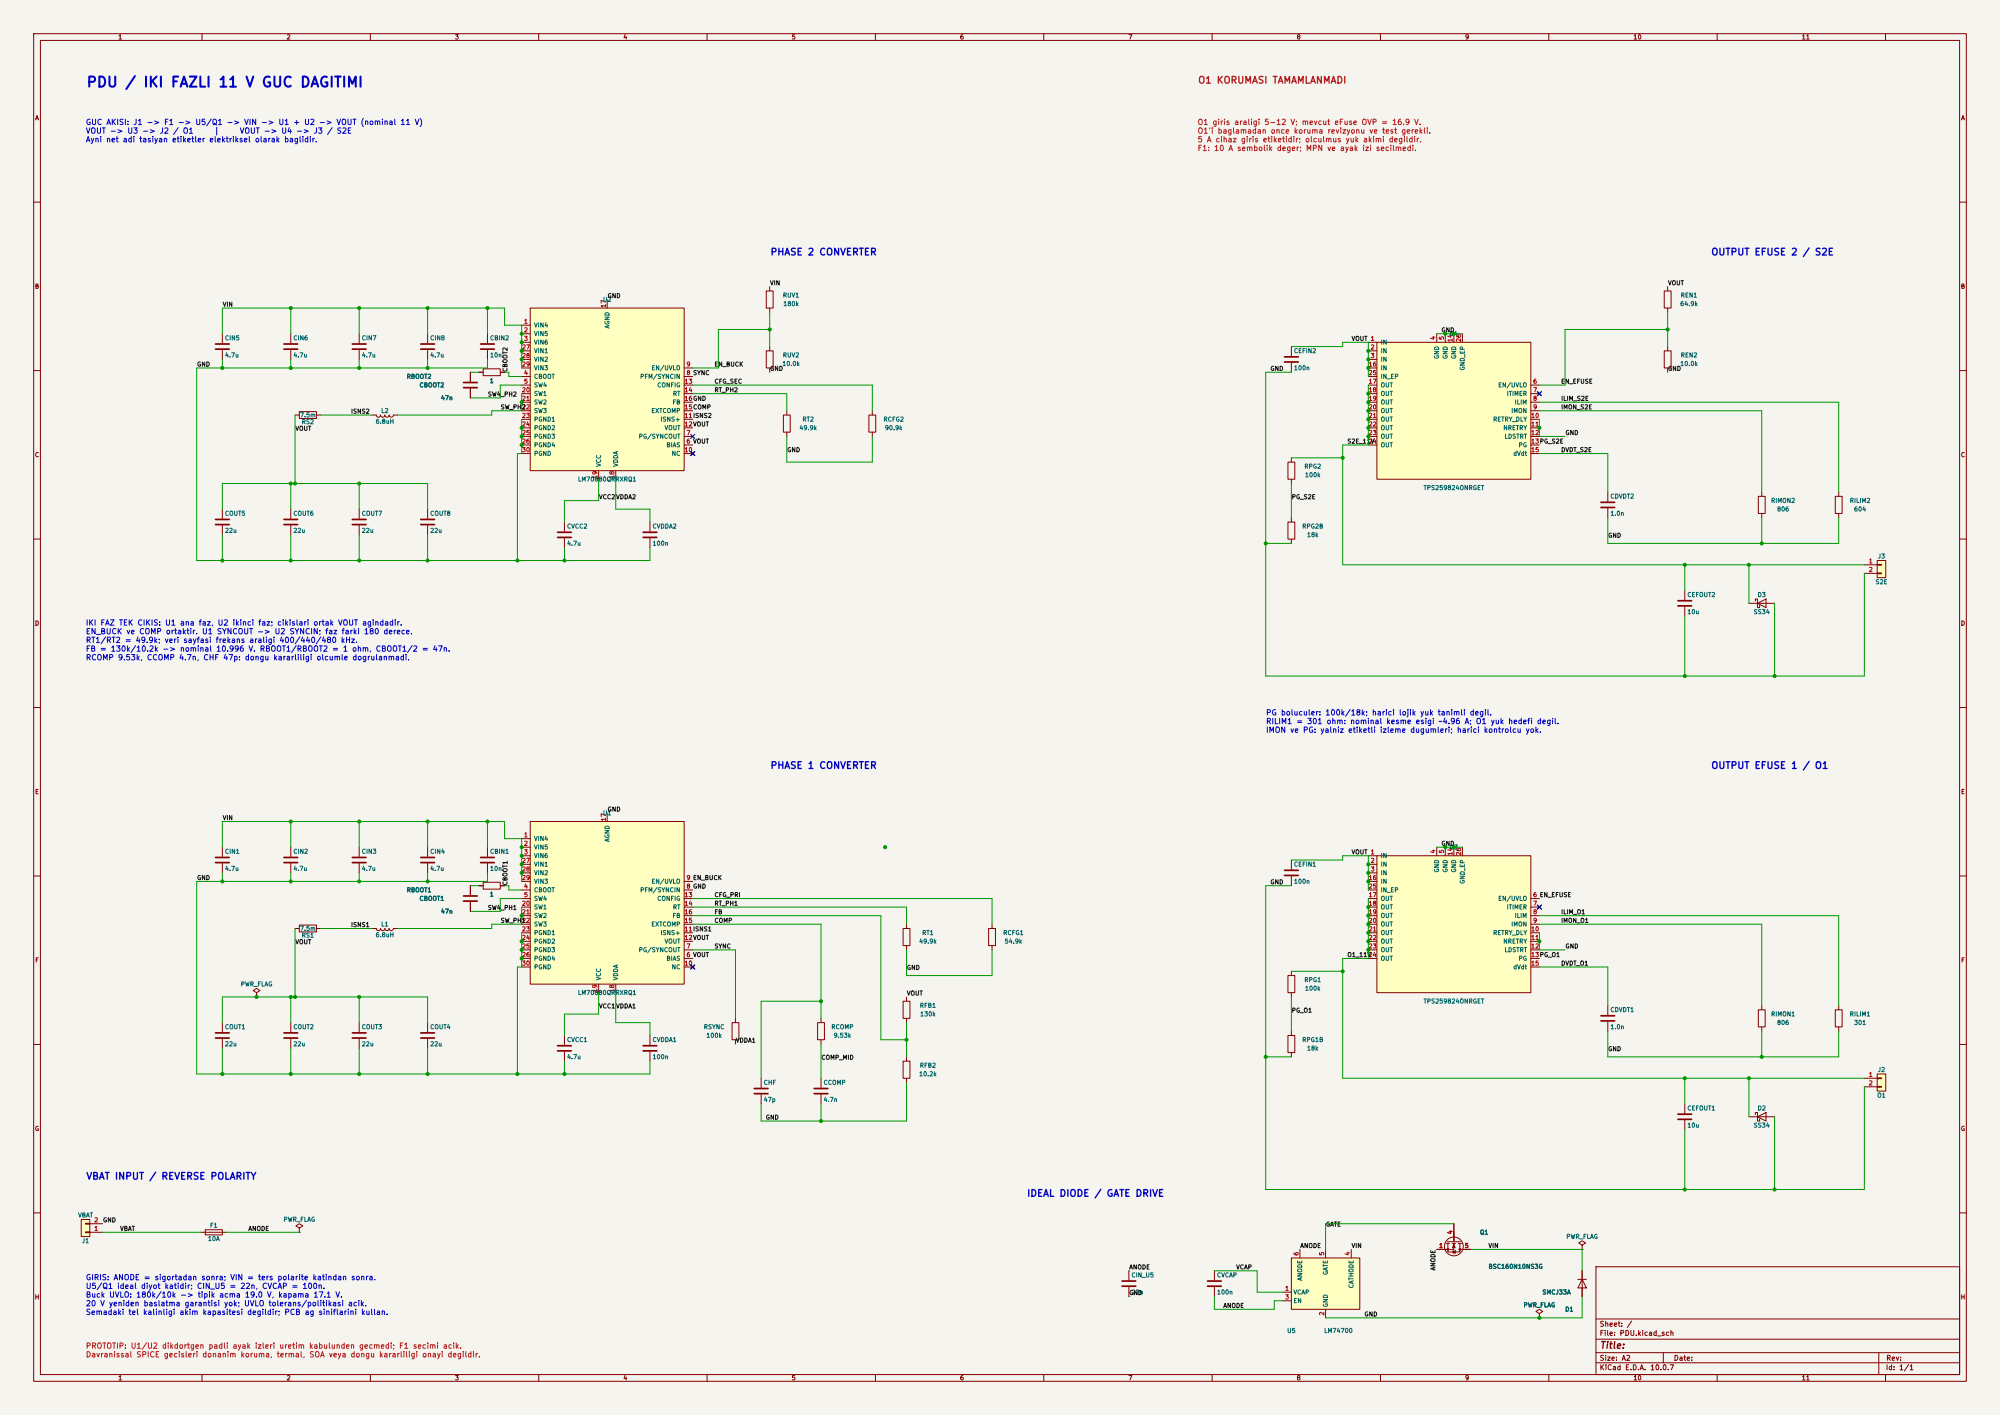
[picture p44: page 1]

PDU / IKI FAZLI 11 V GUC DAGITIMI

GUC AKISI: J1 -> F1 -> U5/Q1 -> VIN -> U1 + U2 -> VOUT (nominal 11 V)
Ayni net adi tasiyan etiketler elektriksel olarak baglidir.

O1'i baglamadan once koruma revizyonu ve test gerekli.
5 A cihaz giris etiketidir; olculmus yuk akimi degildir.
F1: 10 A sembolik deger; MPN ve ayak izi secilmedi.

IKI FAZ TEK CIKIS: U1 ana faz, U2 ikinci faz; cikislari ortak VOUT agindadir.
EN_BUCK ve COMP ortaktir. U1 SYNCOUT -> U2 SYNCIN; faz farki 180 derece.
RT1/RT2 = 49.9k; veri sayfasi frekans araligi 400/440/480 kHz.
FB = 130k/10.2k -> nominal 10.996 V. RBOOT1/RBOOT2 = 1 ohm, CBOOT1/2 = 47n.
RCOMP 9.53k, CCOMP 4.7n, CHF 47p: dongu kararliligi olcumle dogrulanmadi.

PG boluculer: 100k/18k; harici lojik yuk tanimli degil.
RILIM1 = 301 ohm: nominal kesme esigi ~4.96 A; O1 yuk hedefi degil.
IMON ve PG: yalniz etiketli izleme dugumleri; harici kontrolcu yok.

VBAT INPUT / REVERSE POLARITY

IDEAL DIODE / GATE DRIVE

GIRIS: ANODE = sigortadan sonra; VIN = ters polarite katindan sonra. U5/Q1 ideal diyot katidir; CIN_U5 = 22n, CVCAP = 100n.

Buck UVLO: 180k/10k -> tipik acma 19.0 V, kapama 17.1 V.
20 V yeniden baslatma garantisi yok; UVLO tolerans/politikasi acik.
Semadaki tel kalinligi akim kapasitesi degildir; PCB ag siniflarini kullan.

PROTOTIP: U1/U2 dikdortgen padli ayak izleri uretim kabulunden gecmedi; F1 secimi acik.
Davranissal SPICE gecisleri donanim koruma, termal, SOA veya dongu kararliligi onayi degildir.

Size: A2 | Rev:
KiCad E.D.A. 10.0.7 | Id: 1/1
