siimsek/PDU/(list of files, drawings)

Other design files:
.konnect/diagnostics/pcb-refresh-probe-drc.json
.konnect/diagnostics/pcb-transfer-drc.json
.konnect/diagnostics/pcb-transfer-erc.json
.konnect/diagnostics/pcb-transfer-evidence.json
.konnect/diagnostics/pcb-transfer-final-drc.json
.konnect/diagnostics/pcb-transfer-pad-audit.json
.konnect/diagnostics/schematic-finish-checks.json
.konnect/diagnostics/schematic-finish-geometry.json
.konnect/diagnostics/schematic-finish-parity.json
.konnect/diagnostics/schematic-titleblock-clearance.json
reports/R-014/pcb-drc-parity.json
reports/R-015/pcb-drc-parity.json
reports/R-016/pcb-drc-parity-refill.json
reports/R-016/tur2/pcb-drc-parity-refill.json
simulation/schematic-final-checks.json
