siimsek/PDU/PDU.kicad_pcb

## KiCad design PDU.kicad_pcb (2026-11-08)

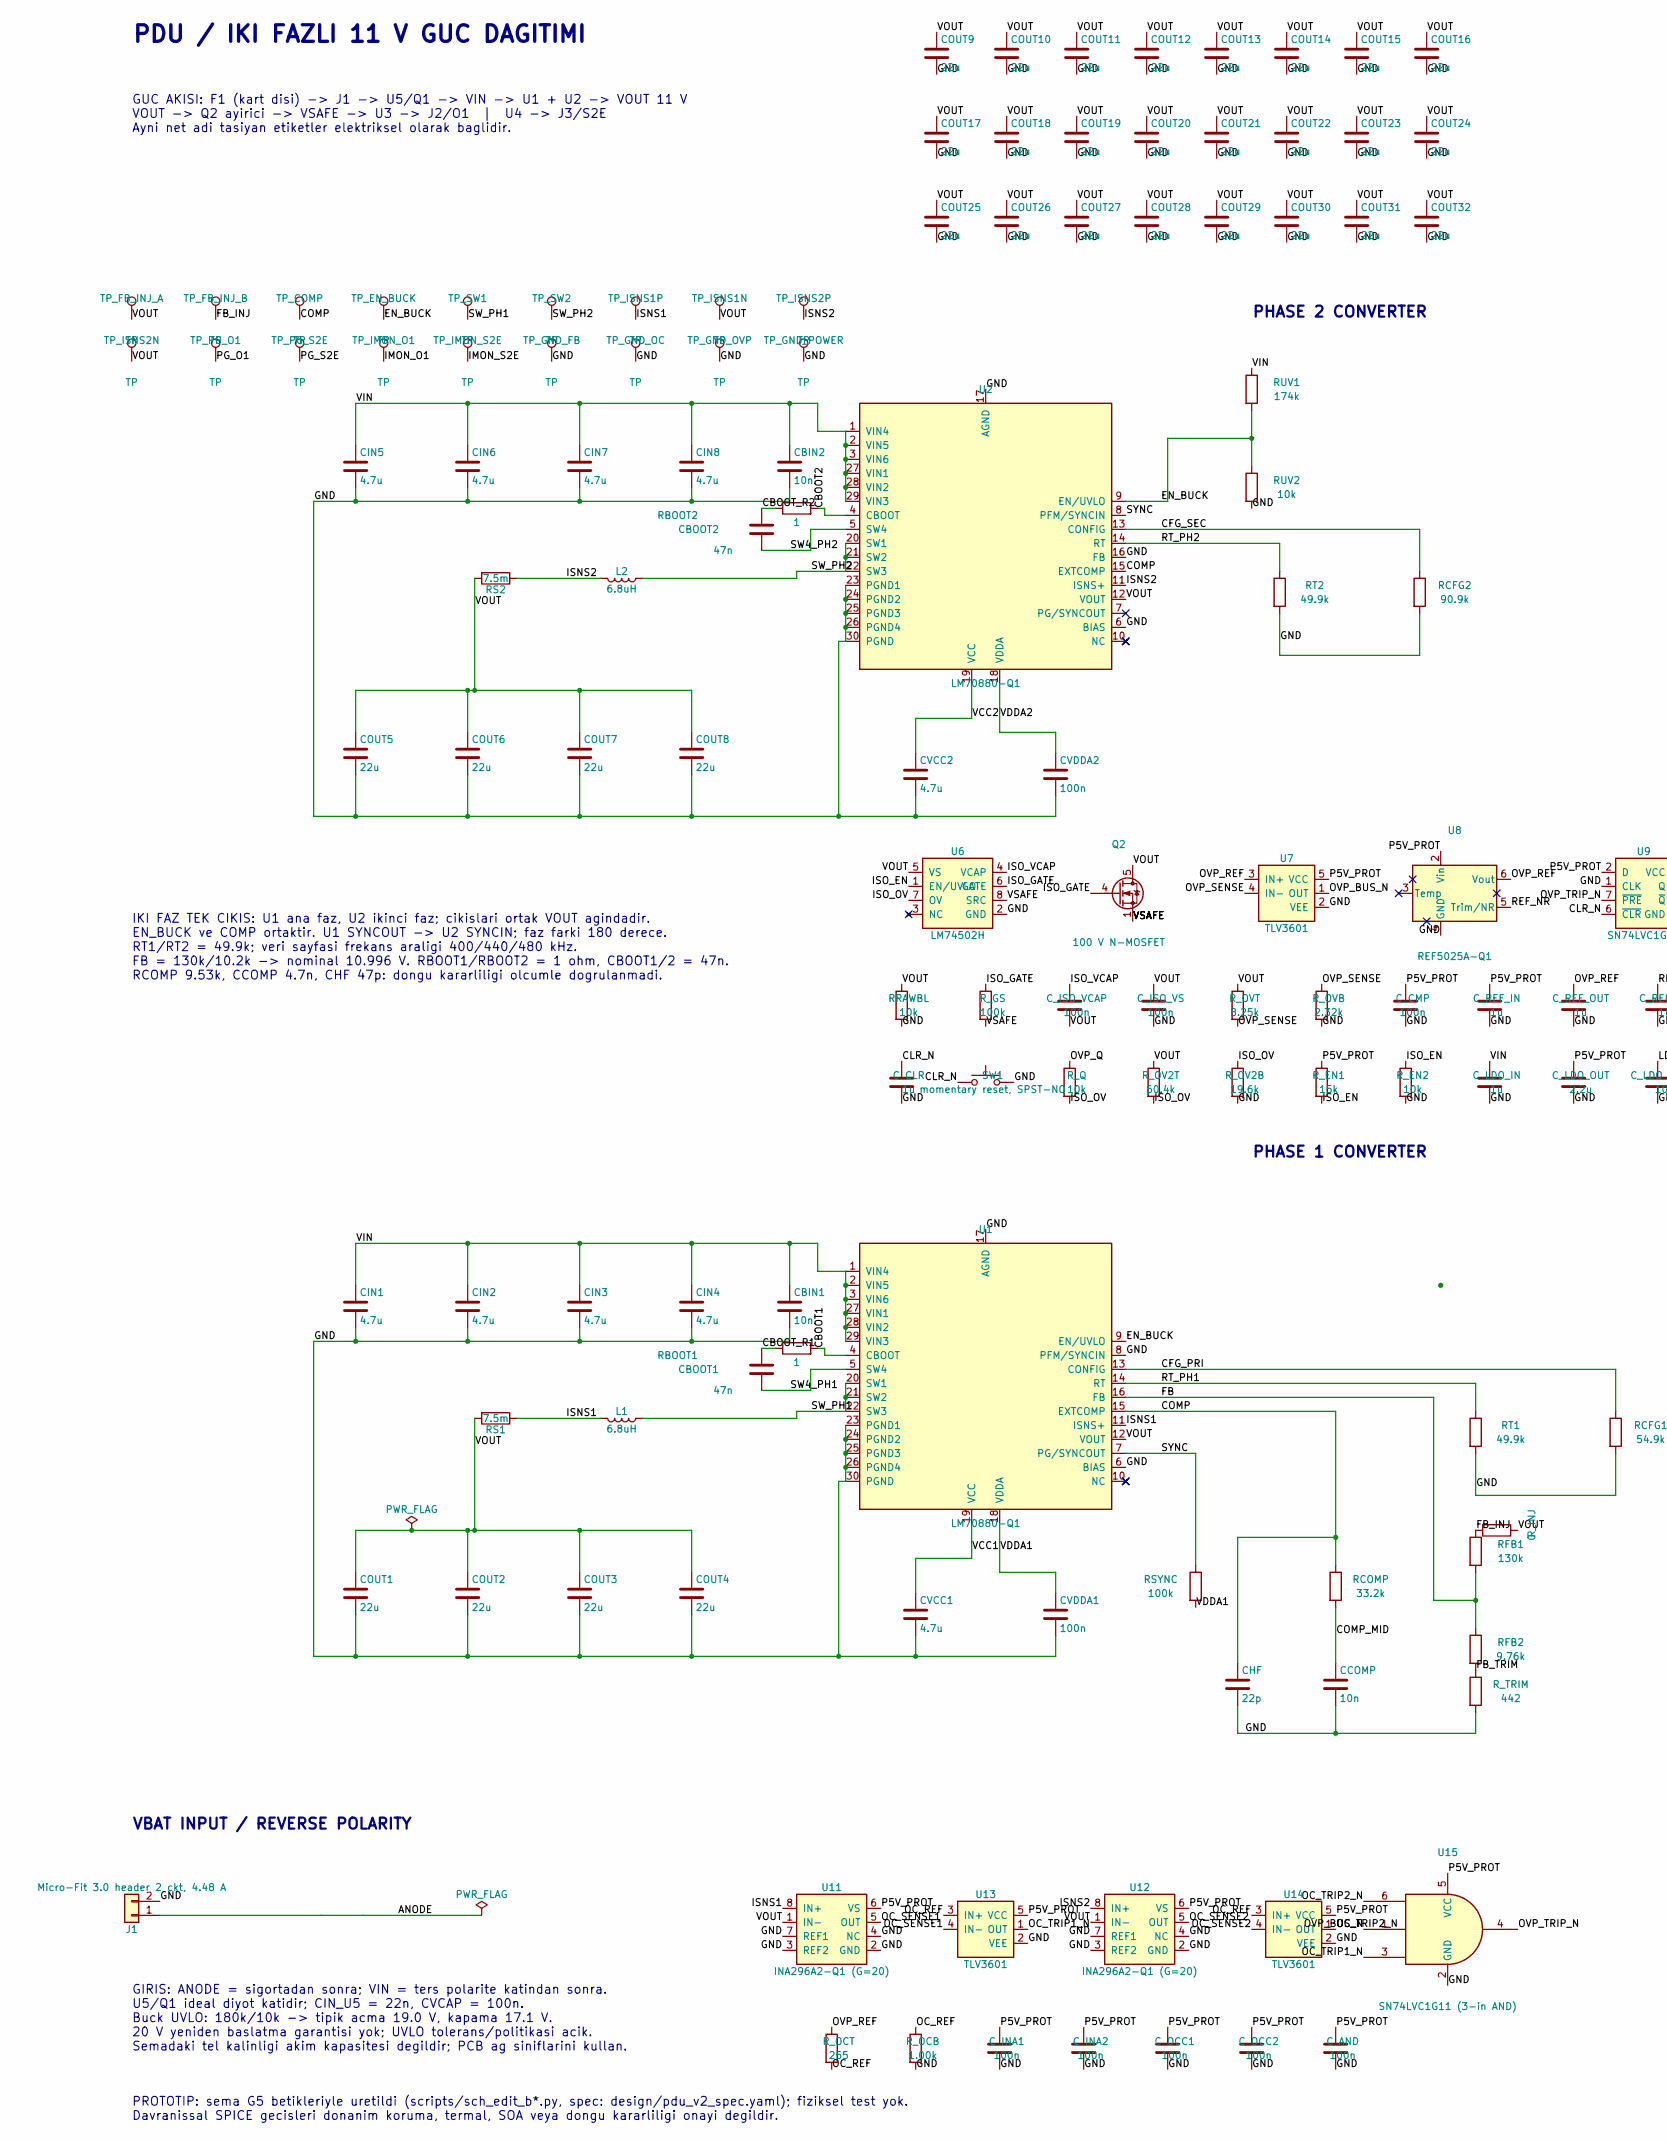
[picture p45: schematic PDU.kicad_sch, IDA PDU - 6S LiPo -> 11 V, 2 faz buck + ortak bara ayirici, part in row 1, column 1]

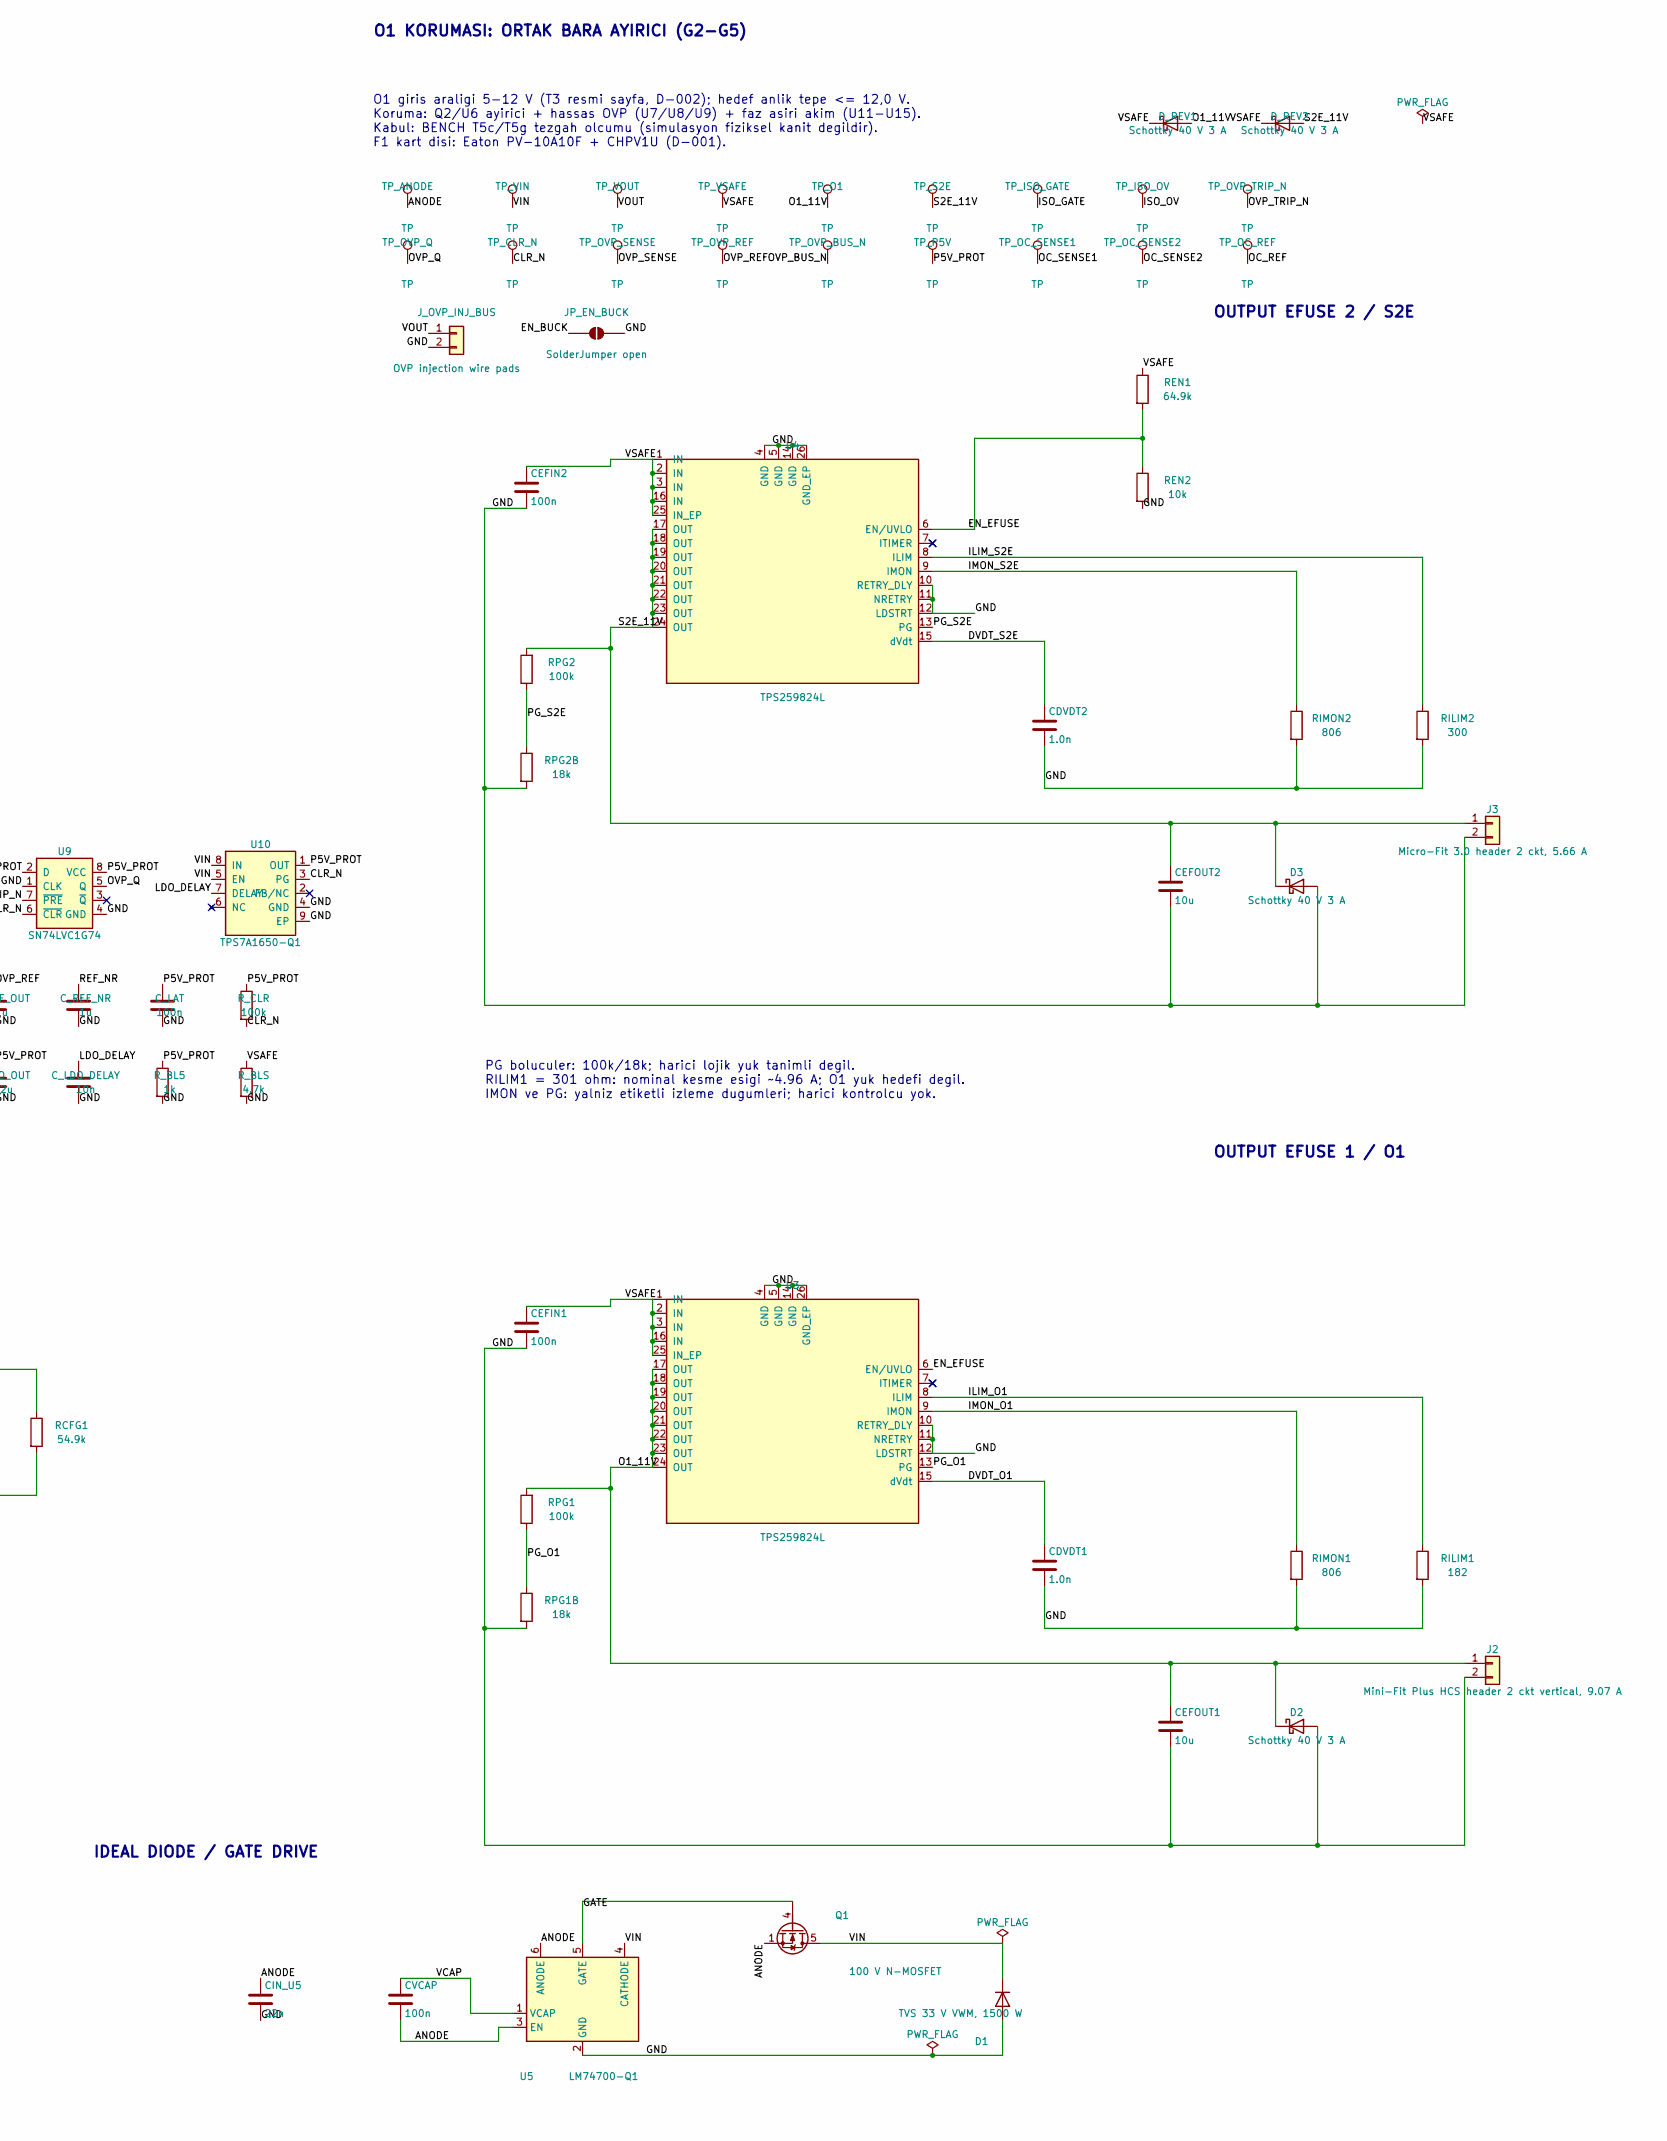
[picture p46: schematic PDU.kicad_sch, IDA PDU - 6S LiPo -> 11 V, 2 faz buck + ortak bara ayirici, part in row 1, column 2]

Parts:
CBIN1, CBIN2: 10n; C_0603_1608Metric; MPN C1608X7R2A103K080AA
CBOOT1, CBOOT2: 47n; C_0603_1608Metric; MPN C1608X7R1H473K080AA
CCOMP: 10n; C_0603_1608Metric; MPN C1608C0G1H103J080AA
CDVDT1, CDVDT2: 1.0n; C_0603_1608Metric; MPN C1608C0G1H102J080AA
CEFIN1, CEFIN2: 100n; C_0603_1608Metric; MPN C1608X7R1H104K080AA
CEFOUT1, CEFOUT2: 10u; C_1206_3216Metric; MPN C3216X7R1E106K160AB
CHF: 22p; C_0603_1608Metric; MPN C1608C0G1H220J080AA
CIN1, CIN2, CIN3, CIN4, CIN5, CIN6, CIN7, CIN8: 4.7u; C_1210_3225Metric; MPN C3225X7S2A475K200AB
CIN_U5: 22n; C_0603_1608Metric; MPN C1608X7R2A223K080AA
COUT1, COUT2, COUT3, COUT4, COUT5, COUT6, COUT7, COUT8: 22u; TDK_C5750_2220_Recommended; Tolerance 20%; Voltage 100V; MPN C5750X7S2A226M280KB
COUT9, COUT10, COUT11, COUT12, COUT13, COUT14, COUT15, COUT16, COUT17, COUT18, COUT19, COUT20, COUT21, COUT22, COUT23, COUT24, COUT25, COUT26, COUT27, COUT28, COUT29, COUT30, COUT31, COUT32: 22u; TDK_C5750_2220_Recommended; Voltage 100V; MPN C5750X7S2A226M280KB
CVCAP: 100n; C_0603_1608Metric; MPN C1608X7R1H104K080AA
CVCC1, CVCC2: 4.7u; C_0805_2012Metric; MPN C2012X7R1E475K125AB
CVDDA1, CVDDA2: 100n; C_0603_1608Metric; MPN C1608X7R1H104K080AA
C_AND: 100n; C_0603_1608Metric; MPN C1608X7R1H104K080AA
C_CLR: 1u; C_0603_1608Metric; MPN C1608X7R1E105K080AB
C_CMP: 100n; C_0603_1608Metric; MPN C1608X7R1H104K080AA
C_INA1, C_INA2: 100n; C_0603_1608Metric; MPN C1608X7R1H104K080AA
C_ISO_VCAP: 100n; C_0603_1608Metric; MPN C1608X7R1H104K080AA
C_ISO_VS: 100n; C_0603_1608Metric; MPN C1608X7S2A104K080AB
C_LAT: 100n; C_0603_1608Metric; MPN C1608X7R1H104K080AA
C_LDO_DELAY: 10n; C_0603_1608Metric; MPN C1608C0G1H103J080AA
C_LDO_IN: 1u; C_1206_3216Metric; MPN C3216X7R2A105K160AA
C_LDO_OUT: 2.2u; C_0805_2012Metric; MPN C2012X7R1E225K125AB
C_OCC1, C_OCC2: 100n; C_0603_1608Metric; MPN C1608X7R1H104K080AA
C_REF_IN: 1u; C_0603_1608Metric; MPN C1608X7R1E105K080AB
C_REF_NR: 1u; C_0603_1608Metric; MPN C1608X7R1E105K080AB
C_REF_OUT: 1u; C_0603_1608Metric; MPN C1608X7R1E105K080AB
D1: TVS 33 V VWM, 1500 W; D_SMC; MPN SMCJ33A-E3/57T
D2, D3: Schottky 40 V 3 A; D_SMC; MPN SS34-E3/57T
D_REV1, D_REV2: Schottky 40 V 3 A; D_SMC; MPN SS34-E3/57T
J1: Micro-Fit 3.0 header 2 ckt, 4.48 A; Molex_Micro-Fit_3.0_43045-0200_2x01_P3.00mm_Horizontal; MPN 430450200
J2: Mini-Fit Plus HCS header 2 ckt vertical, 9.07 A; Molex_Mini-Fit_Jr_5566-02A_2x01_P4.20mm_Vertical; MPN 460150206
J3: Micro-Fit 3.0 header 2 ckt, 5.66 A; Molex_Micro-Fit_3.0_43045-0200_2x01_P3.00mm_Horizontal; MPN 430450200
JP_EN_BUCK: SolderJumper open; SolderJumper-2_P1.3mm_Open_RoundedPad1.0x1.5mm
J_OVP_INJ_BUS: OVP injection wire pads; SolderWire-6sqmm_1x02_P14mm_D3.5mm_OD7mm
L1, L2: 6.8uH; L_Vishay_IHLP-4040; MPN IHLP4040DZER6R8M01
Q1: 100 V N-MOSFET; TDSON-8-1_Konnect; MPN BSC160N10NS3G
Q2: 100 V N-MOSFET; TI_CSD19531Q5A_Q5A; MPN CSD19531Q5A
RBOOT1, RBOOT2: 1; R_0603_1608Metric; MPN CRCW06031R00FKEA
RCFG1: 54.9k; R_0603_1608Metric; MPN CRCW060354K9FKEA
RCFG2: 90.9k; R_0603_1608Metric; MPN CRCW060390K9FKEA
RCOMP: 33.2k; R_0603_1608Metric; MPN CRCW060333K2FKEA
REN1: 64.9k; R_0603_1608Metric; MPN CRCW060364K9FKEA
REN2: 10k; R_0603_1608Metric; MPN CRCW060310K0FKEA
RFB1: 130k; R_0603_1608Metric; Tolerance 0.1%; MPN ERA3AEB134V
RFB2: 9.76k; R_0603_1608Metric; MPN TNPW06039K76BXEA
RILIM1: 182; R_0603_1608Metric; MPN TNPW0603182RBXEA
RILIM2: 300; R_0603_1608Metric; MPN TNPW0603300RBXEA
RIMON1, RIMON2: 806; R_0603_1608Metric; Tolerance 0.1%; MPN ERA3AEB8060V
RPG1, RPG2: 100k; R_0603_1608Metric; MPN CRCW0603100KFKEA
RPG1B, RPG2B: 18k; R_0603_1608Metric; MPN CRCW060318K0FKEA
RRAWBL: 10k; R_1206_3216Metric; MPN CRCW120610K0FKEA
RS1, RS2: 7.5m; R_2512_6332Metric; MPN WSL25127L500FEA
RSYNC: 100k; R_0603_1608Metric; MPN CRCW0603100KFKEA
RT1, RT2: 49.9k; R_0603_1608Metric; MPN CRCW060349K9FKEA
RUV1: 174k; R_0603_1608Metric; MPN TNPW0603174KBEEA
RUV2: 10k; R_0603_1608Metric; MPN TNPW060310K0BEEA
R_BL5: 1k; R_1206_3216Metric; MPN CRCW12061K00FKEA
R_BLS: 4.7k; R_1206_3216Metric; MPN CRCW12064K70FKEA
R_CLR: 100k; R_0603_1608Metric; MPN CRCW0603100KFKEA
R_EN1: 15k; R_0603_1608Metric; MPN CRCW060315K0FKEA
R_EN2: 10k; R_0603_1608Metric; MPN CRCW060310K0FKEA
R_GS: 100k; R_0603_1608Metric; MPN CRCW0603100KFKEA
R_INJ: 0; R_0603_1608Metric; MPN CRCW06030000Z0EA
R_OCB: 1.00k; R_0603_1608Metric; MPN TNPW06031K00BXEA
R_OCT: 255; R_0603_1608Metric; MPN TNPW0603255RBXEA
R_OV2B: 19.6k; R_0603_1608Metric; MPN CRCW060319K6FKEA
R_OV2T: 60.4k; R_0603_1608Metric; MPN CRCW060360K4FKEA
R_OVB: 2.32k; R_1206_3216Metric; MPN TNPW12062K32BXEA
R_OVT: 8.25k; R_1206_3216Metric; MPN TNPW12068K25BXEA
R_Q: 10k; R_0603_1608Metric; MPN CRCW060310K0FKEA
R_TRIM: 442; R_0603_1608Metric; MPN TNPW0603442RBXEA
SW1: momentary reset, SPST-NO; SW_SPST_B3U-1000P; MPN B3U-1000P
TP_ANODE: TP; TestPoint_Pad_D2.0mm
TP_CLR_N: TP; TestPoint_Pad_D1.0mm
TP_COMP: TP; TestPoint_Pad_D1.0mm
TP_EN_BUCK: TP; TestPoint_Pad_D1.0mm
TP_FB_INJ_A: TP; TestPoint_Pad_D1.0mm
TP_FB_INJ_B: TP; TestPoint_Pad_D1.0mm
TP_GND_FB: TP; TestPoint_Pad_D2.0mm
TP_GND_OC: TP; TestPoint_Pad_D2.0mm
TP_GND_OVP: TP; TestPoint_Pad_D2.0mm
TP_GND_POWER: TP; TestPoint_Pad_D2.0mm
TP_IMON_O1: TP; TestPoint_Pad_D1.0mm
TP_IMON_S2E: TP; TestPoint_Pad_D1.0mm
TP_ISNS1N, TP_ISNS1P, TP_ISNS2N, TP_ISNS2P: TP; TestPoint_Pad_D1.0mm
TP_ISO_GATE: TP; TestPoint_Pad_D1.0mm
TP_ISO_OV: TP; TestPoint_Pad_D1.0mm
TP_O1: TP; TestPoint_Pad_D2.0mm
TP_OC_REF: TP; TestPoint_Pad_D1.0mm
TP_OC_SENSE1, TP_OC_SENSE2: TP; TestPoint_Pad_D1.0mm
TP_OVP_BUS_N: TP; TestPoint_Pad_D1.0mm
TP_OVP_Q: TP; TestPoint_Pad_D1.0mm
TP_OVP_REF: TP; TestPoint_Pad_D1.0mm
TP_OVP_SENSE: TP; TestPoint_Pad_D1.0mm
TP_OVP_TRIP_N: TP; TestPoint_Pad_D1.0mm
TP_P5V: TP; TestPoint_Pad_D1.0mm
TP_PG_O1: TP; TestPoint_Pad_D1.0mm
TP_PG_S2E: TP; TestPoint_Pad_D1.0mm
TP_S2E: TP; TestPoint_Pad_D2.0mm
TP_SW1, TP_SW2: TP; TestPoint_Pad_D1.0mm
TP_VIN: TP; TestPoint_Pad_D2.0mm
TP_VOUT: TP; TestPoint_Pad_D2.0mm
TP_VSAFE: TP; TestPoint_Pad_D2.0mm
U1, U2: LM70880-Q1; LM70880_RRX0029B_RectLands; MPN LM70880QRRXRQ1
U3, U4: TPS259824L; TPS25982_RGE0024M; MPN TPS259824LNRGER
U5: LM74700-Q1; SOT-23-6; MPN LM74700QDBVRQ1
U6: LM74502H; TSOT-23-8; MPN LM74502HDDFR
U7, U13, U14: TLV3601; SOT-353_SC-70-5; MPN TLV3601DCKR
U8: REF5025A-Q1; SOIC-8_3.9x4.9mm_P1.27mm; MPN REF5025AQDRQ1
U9: SN74LVC1G74; VSSOP-8_2.3x2mm_P0.5mm; MPN SN74LVC1G74DCUR
U10: TPS7A1650-Q1; HVSSOP-8-1EP_3x3mm_P0.65mm_EP1.57x1.89mm; MPN TPS7A1650QDGNRQ1
U11, U12: INA296A2-Q1 (G=20); VSSOP-8_3x3mm_P0.65mm; MPN INA296A2QDGKRQ1
U15: SN74LVC1G11 (3-in AND); SOT-23-6; MPN SN74LVC1G11DBVR

Connections:
/ANODE: CIN_U5.1, CVCAP.2, J1.1, Q1.1 (S), Q1.2 (S), Q1.3 (S), TP_ANODE.1, U5.3 (EN), U5.6 (ANODE)
/CBOOT1: RBOOT1.2, U1.4 (CBOOT)
/CBOOT2: RBOOT2.2, U2.4 (CBOOT)
/CBOOT_R1: CBOOT1.1, RBOOT1.1
/CBOOT_R2: CBOOT2.1, RBOOT2.1
/CFG_PRI: RCFG1.1, U1.13 (CONFIG)
/CFG_SEC: RCFG2.1, U2.13 (CONFIG)
/CLR_N: C_CLR.1, R_CLR.2, SW1.1, TP_CLR_N.1, U9.6 (~CLR), U10.3 (PG)
/COMP: CHF.1, RCOMP.1, TP_COMP.1, U1.15 (EXTCOMP), U2.15 (EXTCOMP)
/COMP_MID: CCOMP.1, RCOMP.2
/DVDT_O1: CDVDT1.1, U3.15 (dVdt)
/DVDT_S2E: CDVDT2.1, U4.15 (dVdt)
/EN_BUCK: JP_EN_BUCK.1 (A), RUV1.2, RUV2.1, TP_EN_BUCK.1, U1.9 (EN/UVLO), U2.9 (EN/UVLO)
/EN_EFUSE: REN1.2, REN2.1, U3.6 (EN/UVLO), U4.6 (EN/UVLO)
/FB: RFB1.2, RFB2.1, U1.16 (FB)
/FB_INJ: RFB1.1, R_INJ.2, TP_FB_INJ_B.1
/FB_TRIM: RFB2.2, R_TRIM.1
/GATE: Q1.4 (G), U5.5 (GATE)
/GND: CBIN1.2, CBIN2.2, CCOMP.2, CDVDT1.2, CDVDT2.2, CEFIN1.2, CEFIN2.2, CEFOUT1.2, CEFOUT2.2, CHF.2, CIN1.2, CIN2.2, CIN3.2, CIN4.2, CIN5.2, CIN6.2, CIN7.2, CIN8.2, CIN_U5.2, COUT1.2, COUT2.2, COUT3.2, COUT4.2, COUT5.2, COUT6.2, COUT7.2, COUT8.2, COUT9.2, COUT10.2, COUT11.2, COUT12.2, COUT13.2, COUT14.2, COUT15.2, COUT16.2, COUT17.2, COUT18.2, COUT19.2, COUT20.2, COUT21.2, COUT22.2, COUT23.2, COUT24.2, COUT25.2, COUT26.2, COUT27.2, COUT28.2, COUT29.2, COUT30.2, COUT31.2, COUT32.2, CVCC1.2, CVCC2.2, CVDDA1.2, CVDDA2.2, C_AND.2, C_CLR.2, C_CMP.2, C_INA1.2, C_INA2.2, C_ISO_VS.2, C_LAT.2, C_LDO_DELAY.2, C_LDO_IN.2, C_LDO_OUT.2, C_OCC1.2, C_OCC2.2, C_REF_IN.2, C_REF_NR.2, C_REF_OUT.2, D1.2 (A), D2.2 (A), D3.2 (A), J1.2, J2.2, J3.2, JP_EN_BUCK.2 (B), J_OVP_INJ_BUS.2, RCFG1.2, RCFG2.2, REN2.2, RILIM1.2, RILIM2.2, RIMON1.2, RIMON2.2, RPG1B.2, RPG2B.2, RRAWBL.2, RT1.2, RT2.2, RUV2.2, R_BL5.2, R_BLS.2, R_EN2.2, R_OCB.2, R_OV2B.2, R_OVB.2, R_TRIM.2, SW1.2, TP_GND_FB.1, TP_GND_OC.1, TP_GND_OVP.1, TP_GND_POWER.1, U1.6 (BIAS), U1.8 (PFM/SYNCIN), U1.17 (AGND), U1.23 (PGND1), U1.24 (PGND2), U1.25 (PGND3), U1.26 (PGND4), U1.30 (PGND), U2.6 (BIAS), U2.16 (FB), U2.17 (AGND), U2.23 (PGND1), U2.24 (PGND2), U2.25 (PGND3), U2.26 (PGND4), U2.30 (PGND), U3.4 (GND), U3.5 (GND), U3.10 (RETRY_DLY), U3.11 (NRETRY), U3.12 (LDSTRT), U3.14 (GND), U3.26 (GND_EP), U4.4 (GND), U4.5 (GND), U4.10 (RETRY_DLY), U4.11 (NRETRY), U4.12 (LDSTRT), U4.14 (GND), U4.26 (GND_EP), U5.2 (GND), U6.2 (GND), U7.2 (VEE), U8.4 (GND), U9.1 (CLK), U9.4 (GND), U10.4 (GND), U10.9 (EP), U11.2 (GND), U11.3 (REF2), U11.4 (NC), U11.7 (REF1), U12.2 (GND), U12.3 (REF2), U12.4 (NC), U12.7 (REF1), U13.2 (VEE), U14.2 (VEE), U15.2 (GND)
/ILIM_O1: RILIM1.1, U3.8 (ILIM)
/ILIM_S2E: RILIM2.1, U4.8 (ILIM)
/IMON_O1: RIMON1.1, TP_IMON_O1.1, U3.9 (IMON)
/IMON_S2E: RIMON2.1, TP_IMON_S2E.1, U4.9 (IMON)
/ISNS1: L1.2, RS1.1, TP_ISNS1P.1, U1.11 (ISNS+), U11.8 (IN+)
/ISNS2: L2.2, RS2.1, TP_ISNS2P.1, U2.11 (ISNS+), U12.8 (IN+)
/ISO_EN: R_EN1.2, R_EN2.1, U6.1 (EN/UVLO)
/ISO_GATE: Q2.4 (G), R_GS.1, TP_ISO_GATE.1, U6.6 (GATE)
/ISO_OV: R_OV2B.1, R_OV2T.2, R_Q.2, TP_ISO_OV.1, U6.7 (OV)
/ISO_VCAP: C_ISO_VCAP.1, U6.4 (VCAP)
/LDO_DELAY: C_LDO_DELAY.1, U10.7 (DELAY)
/O1_11V: CEFOUT1.1, D2.1 (K), D_REV1.2 (A), J2.1, RPG1.2, TP_O1.1, U3.17 (OUT), U3.18 (OUT), U3.19 (OUT), U3.20 (OUT), U3.21 (OUT), U3.22 (OUT), U3.23 (OUT), U3.24 (OUT)
/OC_REF: R_OCB.1, R_OCT.2, TP_OC_REF.1, U13.3 (IN+), U14.3 (IN+)
/OC_SENSE1: TP_OC_SENSE1.1, U11.5 (OUT), U13.4 (IN-)
/OC_SENSE2: TP_OC_SENSE2.1, U12.5 (OUT), U14.4 (IN-)
/OC_TRIP1_N: U13.1 (OUT), U15.3
/OC_TRIP2_N: U14.1 (OUT), U15.6
/OVP_BUS_N: TP_OVP_BUS_N.1, U7.1 (OUT), U15.1
/OVP_Q: R_Q.1, TP_OVP_Q.1, U9.5 (Q)
/OVP_REF: C_REF_OUT.1, R_OCT.1, TP_OVP_REF.1, U7.3 (IN+), U8.6 (Vout)
/OVP_SENSE: R_OVB.1, R_OVT.2, TP_OVP_SENSE.1, U7.4 (IN-)
/OVP_TRIP_N: TP_OVP_TRIP_N.1, U9.7 (~PRE), U15.4
/P5V_PROT: C_AND.1, C_CMP.1, C_INA1.1, C_INA2.1, C_LAT.1, C_LDO_OUT.1, C_OCC1.1, C_OCC2.1, C_REF_IN.1, R_BL5.1, R_CLR.1, R_EN1.1, TP_P5V.1, U7.5 (VCC), U8.2 (Vin), U9.2 (D), U9.8 (VCC), U10.1 (OUT), U11.6 (VS), U12.6 (VS), U13.5 (VCC), U14.5 (VCC), U15.5 (VCC)
/PG_O1: RPG1.1, RPG1B.1, TP_PG_O1.1, U3.13 (PG)
/PG_S2E: RPG2.1, RPG2B.1, TP_PG_S2E.1, U4.13 (PG)
/REF_NR: C_REF_NR.1, U8.5 (Trim/NR)
/RT_PH1: RT1.1, U1.14 (RT)
/RT_PH2: RT2.1, U2.14 (RT)
/S2E_11V: CEFOUT2.1, D3.1 (K), D_REV2.2 (A), J3.1, RPG2.2, TP_S2E.1, U4.17 (OUT), U4.18 (OUT), U4.19 (OUT), U4.20 (OUT), U4.21 (OUT), U4.22 (OUT), U4.23 (OUT), U4.24 (OUT)
/SW4_PH1: CBOOT1.2, U1.5 (SW4)
/SW4_PH2: CBOOT2.2, U2.5 (SW4)
/SW_PH1: L1.1, TP_SW1.1, U1.20 (SW1), U1.21 (SW2), U1.22 (SW3)
/SW_PH2: L2.1, TP_SW2.1, U2.20 (SW1), U2.21 (SW2), U2.22 (SW3)
/SYNC: RSYNC.1, U1.7 (PG/SYNCOUT), U2.8 (PFM/SYNCIN)
/VCAP: CVCAP.1, U5.1 (VCAP)
/VCC1: CVCC1.1, U1.19 (VCC)
/VCC2: CVCC2.1, U2.19 (VCC)
/VDDA1: CVDDA1.1, RSYNC.2, U1.18 (VDDA)
/VDDA2: CVDDA2.1, U2.18 (VDDA)
/VIN: CBIN1.1, CBIN2.1, CIN1.1, CIN2.1, CIN3.1, CIN4.1, CIN5.1, CIN6.1, CIN7.1, CIN8.1, C_LDO_IN.1, D1.1 (K), Q1.5 (D), RUV1.1, TP_VIN.1, U1.1 (VIN4), U1.2 (VIN5), U1.3 (VIN6), U1.27 (VIN1), U1.28 (VIN2), U1.29 (VIN3), U2.1 (VIN4), U2.2 (VIN5), U2.3 (VIN6), U2.27 (VIN1), U2.28 (VIN2), U2.29 (VIN3), U5.4 (CATHODE), U10.5 (EN), U10.8 (IN)
/VOUT: COUT1.1, COUT2.1, COUT3.1, COUT4.1, COUT5.1, COUT6.1, COUT7.1, COUT8.1, COUT9.1, COUT10.1, COUT11.1, COUT12.1, COUT13.1, COUT14.1, COUT15.1, COUT16.1, COUT17.1, COUT18.1, COUT19.1, COUT20.1, COUT21.1, COUT22.1, COUT23.1, COUT24.1, COUT25.1, COUT26.1, COUT27.1, COUT28.1, COUT29.1, COUT30.1, COUT31.1, COUT32.1, C_ISO_VCAP.2, C_ISO_VS.1, J_OVP_INJ_BUS.1, Q2.5 (D), RRAWBL.1, RS1.2, RS2.2, R_INJ.1, R_OV2T.1, R_OVT.1, TP_FB_INJ_A.1, TP_ISNS1N.1, TP_ISNS2N.1, TP_VOUT.1, U1.12 (VOUT), U2.12 (VOUT), U6.5 (VS), U11.1 (IN-), U12.1 (IN-)
/VSAFE: CEFIN1.1, CEFIN2.1, D_REV1.1 (K), D_REV2.1 (K), Q2.1 (S), Q2.2 (S), Q2.3 (S), REN1.1, R_BLS.1, R_GS.2, TP_VSAFE.1, U3.1 (IN), U3.2 (IN), U3.3 (IN), U3.16 (IN), U3.25 (IN_EP), U4.1 (IN), U4.2 (IN), U4.3 (IN), U4.16 (IN), U4.25 (IN_EP), U6.8 (SRC)

Notes on the sheet:
VBAT INPUT / REVERSE POLARITY
IDEAL DIODE / GATE DRIVE
PHASE 2 CONVERTER
PHASE 1 CONVERTER
OUTPUT EFUSE 2 / S2E
OUTPUT EFUSE 1 / O1
PDU / IKI FAZLI 11 V GUC DAGITIMI
GUC AKISI: F1 (kart disi) -> J1 -> U5/Q1 -> VIN -> U1 + U2 -> VOUT 11 V VOUT -> Q2 ayirici -> VSAFE -> U3 -> J2/O1 | U4 -> J3/S2E Ayni net adi tasiyan etiketler elektriksel olarak baglidir.
O1 KORUMASI: ORTAK BARA AYIRICI (G2-G5)
O1 giris araligi 5-12 V (T3 resmi sayfa, D-002); hedef anlik tepe <= 12,0 V. Koruma: Q2/U6 ayirici + hassas OVP (U7/U8/U9) + faz asiri akim (U11-U15). Kabul: BENCH T5c/T5g tezgah olcumu (simulasyon fiziksel kanit degildir). F1 kart disi: Eaton PV-10A10F + CHPV1U (D-001).
IKI FAZ TEK CIKIS: U1 ana faz, U2 ikinci faz; cikislari ortak VOUT agindadir. EN_BUCK ve COMP ortaktir. U1 SYNCOUT -> U2 SYNCIN; faz farki 180 derece. RT1/RT2 = 49.9k; veri sayfasi frekans araligi 400/440/480 kHz. FB = 130k/10.2k -> nominal 10.996 V. RBOOT1/RBOOT2 = 1 ohm, CBOOT1/2 = 47n. RCOMP 9.5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
PG boluculer: 100k/18k; harici lojik yuk tanimli degil. RILIM1 = 301 ohm: nominal kesme esigi ~4.96 A; O1 yuk hedefi degil. IMON ve PG: yalniz etiketli izleme dugumleri; harici kontrolcu yok.
PROTOTIP: sema G5 betikleriyle uretildi (scripts/sch_edit_b*.py, spec: design/pdu_v2_spec.yaml); fiziksel test yok. Davranissal SPICE gecisleri donanim koruma, termal, SOA veya dongu kararliligi onayi degildir.
GIRIS: ANODE = sigortadan sonra; VIN = ters polarite katindan sonra. U5/Q1 ideal diyot katidir; CIN_U5 = 22n, CVCAP = 100n. Buck UVLO: 180k/10k -> tipik acma 19.0 V, kapama 17.1 V. 20 V yeniden baslatma garantisi yok; UVLO tolerans/politikasi acik. Semadaki tel kalinligi akim kapasitesi degildir; P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

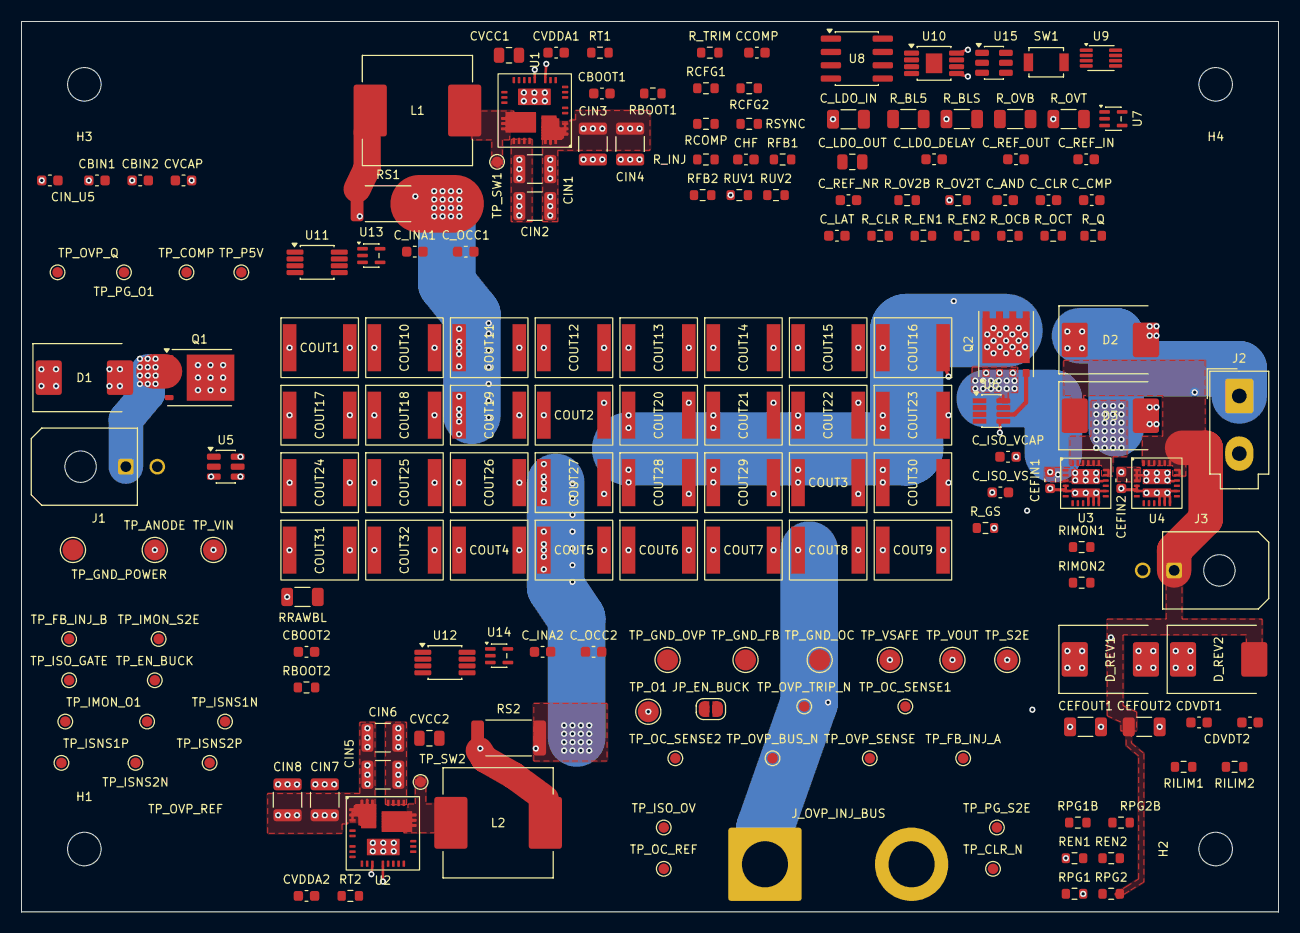
[picture p47: board PDU.kicad_pcb from above]

Board: 4 copper layers, 120.0 x 85.0 mm, 184 parts (0 on the bottom side), 61 nets.

Other parts of the board:
H1, H2, H3, H4: MountingHole_3.2mm_M3
