siimsek/PDU/(commit log)

2026-10-14 Initial clean IDA_PDU reference project
    [bom.csv, functional-blocks.kicad_sch]
2026-10-19 Save PDU prototype checkpoint and organize design review evidence
    [PDU.kicad_pcb, PDU.kicad_sch, Pinmap.kicad_pcb, Pinmap.kicad_sch, bom-before-alignment.csv, bom.csv, netclasses.csv, pcb-refresh-probe-drc.json]
2026-10-19 Fix calculation inputs and prevent stale validation reports
    [pdu-current-bom.csv]
2026-11-06 G1: AI ile hesap, simülasyon, parça ve karar doğrulaması
    [bom-verification.csv]
2026-11-06 G1: bound OVP sense back-power and charge paths
2026-11-06 Add pin-level OVP fail-safe audit and tests
2026-11-06 Document PR2 fail-safe and power-loss audit
2026-11-06 G1 R6: verify common disconnect rail loss
2026-11-06 G1 R7: bound OVP timing and control chain
2026-11-07 G2 Aşama 6: BOM v2, şema özeti, KiCad değişiklik listesi, PCB devri, tezgâh planı, run_all
    [bom-v2.csv]
2026-11-07 G3 A5: bağımsız yeniden türetme ve datasheet sayfa düzeltmeleri
    [bom-v2.csv]
2026-11-07 G3 C (kısmi): G2 deneme/debug, eski simülasyon, konnect, render ve G1 inceleme dosyaları archive/'e taşındı; REVIEW-LOG, SUPERSEDED başlıkları
    [bom-before-alignment.csv, pcb-refresh-probe-drc.json, pcb-transfer-drc.json, pcb-transfer-erc.json, pcb-transfer-evidence.json, pcb-transfer-final-drc.json, pcb-transfer-pad-audit.json, public-dc-bias-digitized.csv]
2026-11-07 G3 A/B: denetim bulguları düzeltildi (eFuse L varyantı, BIAS→VSAFE, eğim oranı, kriterler, kaba OV aralığı, FRA noktası); AUDIT.md
    [bom-v2.csv]
2026-11-07 G3 C/D: CLEANUP ve PCB-READY kapısı (koşullu PCB-HAZIR)
2026-11-07 G4 C: BOM 146/147 MPN (TDK/Molex/Vishay/TI/ARATAS resmi sayfalar), footprint-map, check_consistency, testler
    [bom-v2.csv, footprint-map.csv]
2026-11-07 G4 B2-B6: AUDIT2, N1-DECISION, B5 hesabı, termal 40/50 °C, KICAD-CHANGE-LIST G4 bölümü
2026-11-07 G4 D/E: belge zinciri, run_all 11 adım, manifest 1044, USER-DECISIONS, PCB-READY-v2 (koşullu PCB-HAZIR)
2026-11-07 W0: röle modu — kullanıcı yalnız prompt taşır; SONRAKİ PROMPT kuralı, GitHub üzerinden dosya akışı, D-002, kullanıcı maddeleri ajanlara devredildi
2026-11-07 T-001: G5 baseline (pytest 110, run_all 12/12, ERC 0, DRC 228/197/73); bom.py CSV LF + test
2026-11-07 R-001 tur 1 yanıtı: bulgu 1 girdi hatası (kart düzeltildi), 2 → D-003, 3 → D-004
2026-11-07 T-015: D-003 (J2 = Molex Mini-Fit Plus HCS 46015-0206, tek kontak/kutup, 10,5 A) ve D-004 (T5g gecikme ≤3,0 µs + O1 ≤12,0 V kabulü) tasarıma işlendi
    [bom-v2.csv, footprint-map.csv]
2026-11-07 Document exact KiCad footprint status in D-001
2026-11-07 T-005a: check_footprints.py — RGE0024M/RRX0029B TI land pattern ±0,02 mm, sembol pin tabloları; SVG render
2026-11-07 Röle kuralı: kullanıcıya karar sorusu yok (kararlar THINKER D-kartıyla); R-001 KOŞULLU kapandı (T5g → U-007), D-005 kaydı, U-006 kart dışı F1
2026-11-07 T-004: F1 kart dışı (Eaton PV-10A10F + CHPV1U, D-001); J1.1 → /ANODE; BOM 149/149; I²t/Q1/iz koordinasyonu; D-006 kart ölçüsü kartı
    [bom-v2.csv, footprint-map.csv]
2026-11-07 T-005b ön bulgu: Q1 TDSON footprint KiCad stoktan farklı; R-003 (Q1/C5750/J2 üretici land verisi) THINKER kartı, T-005b Blocked
2026-11-07 HANDOFF: T-005b Blocked ← R-003
2026-11-07 R-003: üretici land verisi ve footprint eşleşmesi
2026-11-07 R-003: bağımsız footprint denetimi
2026-11-07 D-006: board size and assembly face decision
2026-11-07 T-006 (taslak): check_consistency --schematic; B1 şema düzenlemesi (F1/VBAT silindi, J1.1 → /ANODE, MPN alanları), ERC 0; U5 spec pin haritası düzeltmesi; D-007/R-004 kartları
    [PDU.kicad_sch, bom-v2.csv]
2026-11-07 Review T-006 B1 schematic
2026-11-07 T-006 + D-007 + T-016: D1 TVS /VIN (spec, SPICE; 5 aile yeniden, 2 F5 köşesi kanıt yok), B1 netlist fark 0 + KiCad 10.0.7 ERC/netlist kanıtı (R-004 kapandı), J2 stok footprint check_footprints PASS
    [bom-v2.csv, footprint-map.csv]
2026-11-07 R-005: sim_runner timeout 900 s; F5 yeniden koşu — iki köşe 3. kez tamamlanmadı (kanıt yok), tur 2 sayısal kök neden
2026-11-07 T-007 (taslak): şema B2 buck çekirdeği — BIAS → GND, R_INJ/R_TRIM, COMP değerleri, MPN; spec düzeltmeleri (U2 FB GND, RBOOT seri, SW4); ERC 0, B1+B2 fark 0; R-006 kartı
    [PDU.kicad_sch, bom-v2.csv]
2026-11-07 Review T-007 B2 schematic block
2026-11-07 T-007: R-006 kapandı — RFB2/R_INJ/R_TRIM eski meta alanları silindi, Manufacturer tutarlılık kontrolü; ERC 0, B1+B2 fark 0
    [PDU.kicad_sch]
2026-11-07 R-005: iki F5 köşesi — 4 denemede tam pencere bitmedi (çözücü ~215 µs tıkanıyor); kısaltılmış pencere SİM O1 10,92 V; BIL düzgünleştirmesi etkisiz → geri alındı; scripts/pre_merge.py kapısı
2026-11-07 T-008 (taslak): COUT 8 → 32 şemada (sch_edit_b3.py), ERC 0, B1–B3 fark 0; R-007 kartı
    [PDU.kicad_sch]
2026-11-07 T-017 (taslak): 5 özel sembol (INA296A2, TLV3601, LVC1G74, LM74502H, TPS7A1650) datasheet pin tablolarından; U10 EP → GND; R-008 kartı; sıra T-017 → T-010 → T-009
2026-11-07 R-008: T-017 özel sembol pin tabloları incelemesi (ONAY)
2026-11-07 R-008: spec pin/net etiketlerini tam yansıt
2026-11-07 T-010 + T-009 (taslak): şema B5 koruma ayırıcı (30) + B4 faz OC zinciri (12), sch_place.py; ERC 0, B1–B5 fark 0; Q2 footprint TDSON-8-1; R-009 kartı
    [PDU.kicad_sch, bom-v2.csv, footprint-map.csv]
2026-11-07 Clarify INA296 reserved NC pins are grounded
2026-11-07 Record R-009 input hashes and Q2 pin mapping
2026-11-07 T-010 + T-009: R-009 kapandı — Q2 footprint TI CSD19531Q5A land'den (make_q2_footprint.py, check_footprints TI bantları PASS); şema yeniden üretildi, ERC 0, B1–B5 fark 0
    [PDU.kicad_sch, bom-v2.csv, footprint-map.csv]
2026-11-07 T-011 (taslak): şema B6 eFuse + çıkışlar (VSAFE, D_REV, RILIM, CEFOUT, J2); ERC 0; tüm şema spec ile birebir; R-010 kartı
    [PDU.kicad_sch]
2026-11-07 Review R-010 T-011 B6 and full schematic
2026-11-07 T-011: R-010 kapandı — kanonik Value kuralı (şema = spec), sch_values.py, tüm Value karşılaştırması; ERC 0, B1–B6 fark 0
    [PDU.kicad_sch]
2026-11-07 T-012 (taslak): şema B7 — D-008 test padleri, J_OVP_INJ_BUS, JP_EN_BUCK (BOM dışı), notlar ve antet; ERC 0, B1–B7 fark 0 (180 ref); R-011 kartı
    [PDU.kicad_sch, bom-v2.csv, footprint-map.csv]
2026-11-07 T-013: PCB kurulumu (120x85, 4 katman, netclass/DRU, netlist aktarimi, kaba yerlesim)
    [PDU.kicad_pcb]
2026-11-07 R-012: T-013 PCB kurulumunun bağımsız incelemesi
2026-11-07 T-013: R-012 tur 1 duzeltmeleri (CIN sicak dongu, darbogaz kapsami + uzunluk denetimi)
    [PDU.kicad_pcb]
2026-11-07 T-014: KICAD-READY kapisi — PCB-YONLENDIRMEYE-HAZIR (kosullu)
2026-11-07 R-002: review T-014 KiCad-ready gate
2026-11-07 R-002: record KiCad CLI limitation
2026-11-08 T-014: R-002 tur 1 icin KiCad 10.0.7 ile taze ERC/netlist kaniti
2026-11-08 Record R-002 Tur 2 local KiCad attempt
2026-11-08 Track forward cleanup of local paths
2026-11-08 Record recommended KiCad routing tool
2026-11-08 Draft T-022 high-current routing card
2026-11-08 Draft T-024 routed board DRC and parity gate
2026-11-08 R-014 verify KiCad 10 and decide routing tool
    [pcb-drc-parity.json]
2026-11-08 T-020: ayrintili yerlesim (DRC 0, parite 0, iz yok)
    [PDU.kicad_pcb]
2026-11-08 R-015: review T-020 placement
    [pcb-drc-parity.json]
2026-11-08 T-020: R-015 tur 1 — CIN alternatifleri olculdu, C secildi; L1 180 derece
    [PDU.kicad_pcb]
2026-11-08 R-015: final T-020 review and evidence
    [pcb-drc-parity.json]
2026-11-08 T-021: L2/L3 dokumleri ve termal via'lar (DRC 0, parite 0, iz yok)
    [PDU.kicad_pcb]
2026-11-08 Review T-021 independently as R-016
    [pcb-drc-parity-refill.json]
2026-11-08 T-021: R-016 Tur 1 — CEFIN IN-GND ciftlerinde, L3 VSAFE genisletildi, Q2-COUT yol analizi
    [PDU.kicad_pcb]
2026-11-08 Complete R-016 second review for T-021
    [pcb-drc-parity-refill.json]
2026-11-08 T-025: UTF-8 kalici duzeltmesi (kok neden, kural, check_workflow denetimi)
    [bom-verification.csv, netclasses.csv]
2026-11-08 docs: add D-010 power routing decision
2026-11-08 T-022 Blocked: D-010 durdurma koşulu, Q2 sığma kanıtı
    Q2 180 derecede DRC temiz gate izi 10 mm sınırını aşıyor; 7,0 mm güney şeridi
    TP_VSAFE ile kısa devre. PDU.kicad_pcb değişmedi; kanıt geçici kopyalarda üretildi.
2026-11-08 T-022: Q2 90 derece ve ana güç yolları (D-011)
    B.Cu /VOUT 7,0 mm ve /VSAFE 5,5 mm, L3_VSAFE yeniden, O1/S2E/ANODE/VIN yolları.
    KiCad 10.0.7: DRC 0 hata, parite 0, boş kart 0. Kart tamamlanmadı: Kelvin/FB uçları
    T-023'te, TP_SW1/2 karar bekliyor.
    [PDU.kicad_pcb]
2026-11-08 review: assess T-022 power routing
2026-11-08 T-022: R-018 Tur 1 düzeltmeleri
    TP_SW1/2 SW düğümüne taşındı ve kısa bağlandı; U1/U2 ISNS+VOUT çiftleri bağlandı;
    U4 +1,15 mm, CEFIN2 U4 IN/GND yanında (CEFIN1 düzeni); D_REV/CEFOUT kolları 1,5 mm.
    KiCad 10.0.7: DRC 0 hata, parite 0, boş kart 0.
    [PDU.kicad_pcb]
2026-11-08 review: assess T-023 ground inventory
2026-11-08 T-026: kalıcı güç PCB mühendislik standardı ve ajan bağlantıları
    Kaynak metin (SHA-256 5c03f55e) docs altında eksiksiz; AGENTS, CLAUDE, WORKFLOW bağlantıları
    ve check_workflow denetimi eklendi. T-027..T-031 taslakları kuyrukta, kapsam değişmedi.
2026-11-08 T-027: şematik referans ve pin kapsam envanteri
    180 referans, 488 pin; kayıtsız 0, kart padiyle eşleşen 488. İki DNP uyuşmazlığı ve SPICE
    eşlemesi doğrulanamadı olarak kayıtlı. Tasarım dosyası değişmedi.
    [ledger-pins.csv, ledger-references.csv]
2026-11-08 T-027: test padlerinin BOM durumu raporda düzeltildi
    180 şema referansının tümü BOM'da; 38'i MPN'siz, satın alınmayan pad.
    [ledger-references.csv]
2026-11-10 Eski LM70880 tasarımını arşive taşı
    Hoca yönlendirmesiyle düz ayrık buck projesine geçiş. Şema, PCB, hesaplar,
    raporlar, kararlar ve kartlar archive/pdu-v2-lm70880/ altına taşındı.
    İçerik değişmedi (635 dosya, blob karşılaştırması aynı).
    [PDU.kicad_pcb, PDU.kicad_sch, Pinmap.kicad_pcb, Pinmap.kicad_sch, bom-v2.csv, bom-verification.csv, bom.csv, footprint-map.csv]
2026-11-10 Ayrık buck proje tanımı ve topoloji/değer hesabı
    Tek faz asenkron, çift faz 180° ve senkron seçenekleri aynı varsayımlarla
    karşılaştırıldı, tek faz asenkron seçildi. Güç katı değerleri hesap.py ile
    üretildi, ltspice_sina.py ile LTspice'te sınandı. Fiziksel ölçüm yok.
2026-11-10 Tüm devre kararları ve hesapları, thinker/coder düzenini kaldır
    P-MOS, transistörlü sürücü, op-amp/karşılaştırıcı PWM, Tip III geri besleme
    ve yumuşak başlatma değerleri eklendi. Devre kapalı çevrimde LTspice'te
    sınandı. Kart ve röle düzeni yerine sade CLAUDE.md/AGENTS.md yazıldı.
2026-11-10 Aşama 1'i açık çevrim buck güç katına indir; LTspice görsel ASC şematikleri ekle
2026-11-10 Buck analizini sadeleştir ve parametre taraması ekle
    [PDU.kicad_pcb, PDU.kicad_sch, Pinmap.kicad_pcb, Pinmap.kicad_sch, bom-before-alignment.csv, bom-v2.csv, bom-verification.csv, bom.csv]
2026-11-11 LTspice ana güç katı, simülasyon sonuçları ve yol haritası
    - buck/ltspice: 100 kHz / 33 µH açık çevrim asenkron buck şematiği (.asc),
    parazitik doğrulama netlist'i, tarama ve doğrulama betikleri, ham sonuçlar
    ve dalga şekilleri
    - Frekans × bobin, MOSFET × diyot, kondansatör, zil/sönümleyici taramaları;
    hat/yük/tolerans/sıcaklık, sabit duty ve sert kalkış koşuları
    - SONUC.md: analitik hesap, LTspice sonucu ve varsayımlar ayrı; parça verileri
    veri sayfasıyla doğrulanmadı, fiziksel ölçüm yok
    - YOL-HARITASI.md: nihai PCB tasarımına kadar sonraki adımlar
    - README ve PROJE-TANIMI güncel duruma işaret ediyor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
2026-11-11 Şematiği değer tabanlı ideal devreye indir, depoyu sadeleştir
    - buck_guc_kati.asc: ideal anahtar/diyot, hedef ESR/DCR; .param/.meas/.ic ve gerçek parça modelleri kaldırıldı
    - PARCA-HEDEFLERI.md: parça ararken kullanılacak hedef değerler
    - hesap.py: şematikteki değerlerle özet tabloyu ekrana yazar
    - Gerçek parçalı tarama/doğrulama betikleri, sonuçlar ve eski belgeler kaldırıldı
2026-11-11 Güç katını gerçek yüklere göre doğrula: Cout 680 µF / 25 mΩ, ana nokta 24,6 V
    - Yükler belirlendi: T3 Gemstone O1 (5–12 V / 5 A) ve RPLIDAR S2E (9–28 V,
    0,22 A çalışma, 1,5 A kalkış). Testlerde sabit güç yükü olarak modellendi.
    - Eski değerler (33 µH / 330 µF / 15 mΩ) 57,6 W sabit güç yükünde açık
    çevrimde 2,9 V t-t salınıyor; 9 adaylık LTspice taraması sonucu Cout
    680 µF, ESR 25 mΩ (pencere 20–30 mΩ) seçildi. L1, Cin, S1, D1, fsw aynı.
    - Şematik ana çalışma noktası 24,6 V'a alındı (Ton 4,65 µs, .tran 20m).
    - hesap.py: 5 giriş noktası, düşümlü duty, kayıplar, DCM sınırı, LC dinamiği,
    yük uyumu.
    - dogrula.py: LTspice to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
2026-11-11 Ana güç devresi: parçaları seç, veri sayfası değerlerini şematiğe yaz
    - S1 STP75NF75, D1 IXYS DSB60C60HB (iki bacak paralel), L1 Bourns
    2300HT-330, Cout Rubycon 25ZLH680M, Cin 2 x Panasonic EEUFR1V681B.
    - Şematik: Ron 11 mΩ, Vf 0,46 V + 3,1 mΩ, Cout ESR 28 mΩ, Cin 2 x 680 µF,
    Ton 4,63 µs. LTspice: 11,004 V, 51,8 mV t-t, 6,56–8,44 A.
    - dogrula.py / hesap.py: parça değerleri; L köşeleri −%30/+%15 (bobinin
    akım altındaki endüktans düşümü dahil). Tüm testler yeniden koşuldu.
    - PARCA-HEDEFLERI.md: parça listesi, paylar, bulunurluk, yedekler ve
    sonraki aşama notları. OPTIMIZASYON.md §5 yeni sonuçlarla yenilendi.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
2026-11-11 Ana güç devresi: parça numarası yerine doğrulanmış değer ve kriterler
    Belirli parça seçimi geri alındı; şematik yine parça numarasından bağımsız
    hedef değerleri taşıyor ve her değerin kabul aralığı nedeniyle yazıldı.
    - Cout 680 -> 1000 µF: 680 µF en kötü tolerans köşesinde 12,06 V'a çıkıyordu;
    1000 µF aynı köşede 11,81 V ve daha yaygın bir standart değer.
    - Kabul pencereleri LTspice'ta doğrulandı (dogrula.py pencere): L 33-47 µH,
    Cout 1000 µF, ESR 15-35 mΩ. 22 µH (tipik yük DCM'de) ve 680 µF elendi.
    - Cin 2 x 1000 µF (ripple akımı şartı), S1 Ron 12 mΩ, D1 0,5 V + 10 mΩ,
    Ton 4,65 µs. LTspice: 11,001 V, 46,5 mV t-t, 6,55-8,45 A.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
2026-11-11 Yol haritasını geri getir, AGENTS.md'yi tek kural kaynağı yap
    - YOL-HARITASI.md: güncel durum tablosu, şematik değerleri, 11 adım ve
    tamamlanma ölçütleri, karar günlüğü. Aktif adım: gerçek parçaların bulunması.
    - AGENTS.md: tüm araçlar için kurallar (kapsam, değerler, şematik, doğruluk
    etiketleri, git), dosya haritası, araç komutları ve PCB aşaması kuralları.
    - CLAUDE.md artık AGENTS.md ve YOL-HARITASI.md dosyalarına yönlendiriyor;
    kurallar tek yerde tutuluyor.
    - README: yol haritası ve kurallara bağlantı.
2026-11-11 Aday parça listesini ekle; şematiğe 1. sıra adayların değerlerini yaz
    Parçalar kesin seçim değildir; dış araştırmanın adayları LTspice köşe
    testindeki paya göre sıralanmış bir "olabilir" listesidir.
    - 1. sıra: Würth 74435583300 (33 µH), Nichicon UHE1E102MHD6TO (1000 µF,
    35 mΩ), 2 x TDK B41859D7108M000, STP100N6F7, STPS40M60CT.
    - Şematik: L1 14,5 mΩ, Cout 35 mΩ, Cin 15 mΩ, Ron 5,6 mΩ, Vf 0,38 V + 8 mΩ,
    Ton 4,61 µs. LTspice: 11,000 V, 64,4 mV t-t, 6,56-8,44 A; iletim kaybı
    2,75 W. dogrula.py secilen yeniden koşuldu, sınırların içinde.
    - Köşe testi: araştırmanın önerdiği 47 µH + 18 mΩ kombinasyonu kaldı
    (12,83 V); 33 µH + 35 mΩ geçti.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
2026-11-11 Dal ve milestone kuralını netleştir: yalnız ana aşamalarda
    - AGENTS.md §4.7: bütün iş main'de; adımlar, parça güncellemeleri ve belge
    düzeltmeleri için yeni dal, etiket veya milestone açılmaz. Dal ve milestone
    yalnız ana aşama düzeyinde, kullanıcı isteyince açılır/kapatılır.
    - YOL-HARITASI.md: adımlar dört ana aşamada toplandı (A ana güç devresi,
    B kontrol, C prototip ve ölçüm, D PCB ve gerçek yük); her aşamanın dalı ve
    milestone'u tabloda. Karar günlüğüne işlendi.
2026-11-11 Pencere tablosunu güncel şematik değerleriyle yenile; L1 kabul aralığını karara bırak
    5032913'te Ron, Vf/Rd ve DCR düşürülmüş ama `dogrula.py pencere` yeniden
    koşulmamıştı; §4.4 tablosu eski hedef değerlere aitti. Güncel değerlerle
    koşu: 33 µH geçti, 39 µH kaldı (köşede 12,06 V), 47 µH 0,04 V payla ve
    yalnız 20 ms'lik S2E kalkış darbesi varsayımıyla geçti. Neden: düşük
    dirençli parçalar LC'nin seri sönümünü azaltıyor (≈ 25,9 → 21,4 mΩ).
    - OPTIMIZASYON.md §4.4: tablo ve yorumlar yenilendi; salınım sütununun
    karara girmediği yazıldı
    - PARCA-HEDEFLERI.md, YOL-HARITASI.md, README.md: "33–47 µH doğrulandı"
    ifadeleri 33 µH ile s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
2026-11-12 Doğrulama altyapısını düzelt, sabit güç yükü kararlılığını ve Adım 3 hesaplarını ekle; dondurma BLOCKED
    Şematik değerleri ve aday sırası değişmedi.
    Doğrulama (dogrula.py):
    - Test netlistleri idealler.lib ile aynı değerli ama yumuşak geçişli (Vh=-0.5)
    anahtar modeli kullanır. Vh=0 LTspice'ta ±1 ns iletim süresi titremesi ve
    sahte ripple üretiyordu (24,6 V'ta 70,3 yerine 64,3 mV).
    - ton_ayarla yeniden yazıldı: sarılı kök arama, gerilim cinsinden ölçüt,
    yakınsamazsa koşu durur. kararli() içindeki koşullu ince ayar kaldırıldı.
    - Yük adımı darbesi parametreli; 200 ms'lik darbe ve yavaş salınımın
    sönme/büyüme oranı kabul kararına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
2026-11-12 Dondurma kapısını iş akışına göre iki basamağa ayır; sıradaki işi yol haritasına yaz
    Kullanıcı kararı: önce simülasyonda dondurma, sonra parça seçimi ve bobin
    sarımı, sonra gerçek değerlerle test, sonra PCB. Fiziksel ölçüm dondurmanın
    ön koşulu değildir.
    - OPTIMIZASYON.md §12: simülasyon dondurması (12.1) ve parça sonrası
    doğrulama (12.2) ayrıldı; durum BLOCKED yerine CONDITIONAL.
    - YOL-HARITASI.md: "İş akışı" ve "Sıradaki iş" bölümleri, karar günlüğü.
    - README ve PARCA-HEDEFLERI durum satırları güncellendi.
    Şematik ve kod değişmedi; yeni test koşulmadı.
2026-11-12 Çıkış sönüm dalını (470 µF + 0,22 Ω) ekle, tüm testleri doğrula ve güç katını simülasyon düzeyinde dondur (FROZEN)
    Neden:
    - Dalsız devrede tolerans köşesinde (L +%20, Cout -%20, ESR 15 mΩ) 73-82,5 W sabit güç yükü 200 ms darbede salınıyordu.
    - S1 kısa devresinde çıkış 27,3-31,1 V'a, sıcak takmada Cin 45-46,5 V'a çıkabildiği için kondansatör gerilim sınıflarının yükseltilmesi gerekiyordu.
    Ne değişti:
    - Şematik ve kod (sematik_uret.py, hesap.py, dogrula.py, AGENTS.md §4.1): çıkışa paralel Cd = 470 µF + seri Rd = 0,22 Ω sönüm dalı birlikte eklendi; buck_guc_kati.asc ve .svg yerleşim/etiket açıklıklarıyla yeniden üretildi (D1 etiket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
2026-11-12 Yeni gerilim sınıfları ve yardımcı elemanlar için doğrulanmış adayları PARCA-HEDEFLERI.md listesine ekle
    Cout (≥35 V), Cd (470 µF, ≥35 V), Rd (0,22 Ω), Cin (≥50 V), giriş MLCC,
    ortak soğutucu + TO-220 yalıtım ve D1 RC sönümleyici için üretici veri
    sayfalarından ve güncel stoklardan doğrulanan adayları, elenen yakın
    parçaları ve geçici LTspice köşe testi sonuçlarını aday listesine ekler.
    Şematikteki 1. sıra referans değerler kullanıcı kesin seçim yapana kadar
    değiştirilmemiştir.
